djmcmath/dpv-nav/hardware/README.md

Expect this to be:

Schematics: electrical drawings of the board and components, which pins connect to which things

Housing: BOM details, drawings of how the housing and components fit together, STLs for 3D printed parts, etc.
