djmcmath/dpv-nav/tools/README.md

# DPV-Nav Tools

This directory contains offline processing tools for calibration and data analysis.

## mag_calibration.py

Python script for computing magnetometer calibration from raw sensor samples. Supports
the two-stage baseline + mounted workflow.

### Installation

```bash
pip install numpy scipy
```

### Usage

**Baseline mode** (off-scooter, full sphere):
```bash
python mag_calibration.py --mode baseline mag_baseline_samples.csv
python mag_calibration.py --mode baseline mag_baseline_samples.csv --flat mag_flat.csv
```
Output: `mag_base.json`

**Mounted mode** (on-scooter correction, requires baseline result):
```bash
python mag_calibration.py --mode mounted --base mag_base.json mag_mounted_samples.csv
```
Output: `mag_mount.json`

Mounted mode does not fit here. It calls `dive-map/calibration-processor`'s
`callib.fit.fit_mounted()` — the one copy of the fit math — so this script and the
server cannot answer differently for the same CSV, which is the whole point of that
module's "one copy" rule. It therefore needs **dive-map/ checked out alongside
dpv-nav/**, the same sibling-checkout assumption `orient_equivalence.py` makes. If it
isn't there the script says so and stops rather than quietly fitting a different way.

That fit uses only the samples that are within 15° of level **and still** (under 8°/s,
accel within 0.03 g of 1 g), tilt-compensated. The collection procedure deliberately
gathers nose-up and nose-down rings (the device's mounted coverage grid requires them),
and fitting those as if they were level pours vertical field into the XY plane — worth
~0.9 µT per degree of tilt, which is what produced the lopsided scales seen on real
units. Samples taken in motion do the same thing on a smaller scale: a push reads as
tilt.

There is no fallback. A collection without at least 30 still, level samples covering the
circle (no gap over 90°), or a CSV with no accel/gyro columns (pre-9-axis firmware), is
refused with the reason — the same message the server gives. Until 2026-10-11 such a
collection was fitted the old all-samples way instead, which is the known-bad fit.

### Quality Indicators

**Baseline:**
- RMS error < 2%: GOOD
- RMS error 2–5%: ACCEPTABLE
- RMS error > 5%: POOR — recollect with better spherical coverage

**Heading accuracy** (reported when `--flat` data is provided):
- Total error < 2°: EXCELLENT
- Total error 2–5°: GOOD
- Total error > 5°: POOR — recollect flat rotation data

### Complete Workflow

See [../docs/calibration-guide.md](../docs/calibration-guide.md) for the full step-by-step
procedure including what to expect at each stage and how to verify the result.

## Track assembly and correction — moved to Divemap

`correct_track.py`, `assemble_track.py` and their tests now live in the Divemap
repo, at **`dive-map/track-processor/`**.

They moved because they stopped being bench scripts and became the engine of a
Divemap service: the `track-processor` container runs exactly this code to
assemble uploaded logs into dives and correct them. A second copy here would
guarantee the two drift — and a divergence between what the website computes and
what you compute at the bench is a very hard bug to see.

Same tools, same flags. To run them against logs in this directory:

```bash
cd ../dive-map/track-processor

# Group a pile of uploaded logs into dives (handles power cycles, junk files,
# and logs that start after the unit has already left its last GPS fix)
python3 assemble_track.py ../../dpv-nav/tools/*.csv -o /tmp/dives

# Correct one. The default --mode auto works out which correction the anchor
# geometry can actually support, and tells you what it cannot know.
python3 correct_track.py /tmp/dives/dive_20260705_090952.csv

# Tests
python3 tests/test_correct.py && python3 tests/test_assemble.py
```

### Getting a dive that can actually be calibrated

An anchor in the **middle** of a dive is worth far more than fixes at both ends
of a round trip. On an out-and-back your net displacement is near zero no matter
how far you swam, so the endpoints cannot tell speed error apart from a current —
both explain the drift equally well, and the solver will happily report a
physically absurd speed factor.

Snapping a waypoint at the wreck (a `W` row) splits that useless loop into two
informative legs, which is enough to solve for speed factor, heading offset
**and** the current, exactly. `--mode auto` will say so when it happens.

## circle_audit.py — bench heading check against a reference compass

Scores a level "circle test" log (log level HIGH; stop every 10° by a reference
compass -- or any multiple of `--step`, inferred per stop, so uneven spacing and
an accidental extra stop are both fine -- through one or more circles each way,
e.g. CW, CW, CCW, CCW, optionally after a static lead-in at the first heading). Reports displayed error per bin
(samples / stops / mean / max), worst case and RMS, per-circle error and
horizontal field centre, circle-vs-circle differences (separates time effects from
direction effects), the constant / 1 / 2 / 3-cycle decomposition (displayed and
pre-Fourier), the loaded Fourier vs a refit on this data (a stale heading cal shows
up here), the |B| and level-|Bh| gates with a horizontal circle fit, held-out
scoring, field drift over a static lead-in, and -- with `--mount` -- what a
level-only mounted fit would give vs the installed mount stage. Drift is
correlated against `mag_temp_c` (the LIS3MDL's own die temperature) when the log
has it, falling back to `water_temp_c`, which lags the sensor by ~23 s; the
header line says which column it used. A static-only log
gets just the drift report. `--fourier` must be the heading cal that was installed
while the log was recorded.

```bash
python circle_audit.py "logs/high log circles.csv" \
    --fourier "../baseline cal jsons/20260911 cal files/hdg_fourier (1).json" \
    --mount   "../baseline cal jsons/20260911 cal files/mag_mount (1).json"
```

Check the stop-matching line first: it assumes the first stop is `--first-actual`
(default 000) and auto-picks where the return sweep started; override with
`--second-start` if it guessed wrong. With one circle each way, a change over
time and a direction-dependent effect look identical -- run two circles each way
to separate them.

## mag_temp_fit.py — magnetometer thermal-drift coefficients

Fits µT/°C per axis against `mag_temp_c` from stationary heat/cool logs (heat the
nav board, let it cool untouched; one log per cardinal is the consistency check,
since a body-fixed drift must give the same answer at every heading) and writes
the `/mag_temp.json` the firmware loads. Cooling leg only by default; skips any
log whose die temperature moved under 3 °C; prints per-log slopes and the range
the result is valid over.

MID logs are in the calibrated frame, so `--base`/`--mount` must be the cal that
was installed while logging -- the answer depends on it. HIGH logs carry
`mag_*_raw` and need neither, so prefer HIGH for thermal tests. `--applied` adds
back the coefficients that were active if the log was recorded with compensation
on. Needs numpy.

```bash
python mag_temp_fit.py "../baseline cal jsons/thermal testing/"{north,east,south,west1,west2}.csv \
    --base  "../baseline cal jsons/20260911 cal files/mag_base (2).json" \
    --mount "../baseline cal jsons/20260911 level-fit mount v2/mag_mount.json" \
    --out mag_temp.json
```

See [../docs/mag-temperature-compensation.md](../docs/mag-temperature-compensation.md).

## Future Tools

- **log_analyzer.py**: Parse and visualize LittleFS data logs
- **heading_plotter.py**: Real-time heading visualization from serial output
- **imu_diagnostic.py**: Sensor health check and noise analysis

## Calibration gap-fill host tests

None of these need hardware or PlatformIO -- they host-compile the
dependency-free parts of the firmware and drive them against the server's own
Python. Run them after touching `src/util/mag_cal_orient.cpp`,
`lib/dpvlink/dpvlink.cpp`, or `divemap/calibration-processor/callib/coverage.py`.
The first and third need an interpreter with the calibration-processor's
requirements installed (they import `callib.coverage`, which uses numpy).

| Script | Proves |
|---|---|
| `orient_equivalence.py` | the firmware orientation port and `coverage.py` agree sample for sample, including every degenerate branch and the poles. Also prints the axis-convention sentinel (passing `magNED` costs up to 180 deg of heading). |
| `dpvlink_test/run.sh` | `CalProgressPacket`'s 2-bits-per-cell target map round-trips index-for-index, rejects corrupt input wholesale, and fits the 512-byte link buffer. Also that `NavPacket`'s log-sync progress fields ride the wire only while `FLAG2_UPLOADING` is set, and decode to zero rather than stale values when absent. |
| `mounted_dwell_test/run.sh` | Mounted dwell capture (`src/util/mounted_dwell.h`): a cell fills only from a still unit inside its row's attitude window, with exactly 18 samples; sweeping through, moving mid-dwell, leaving the window or a repeated mag reading record nothing; both bank directions read as level; tilted rows complete at six spread cells and not at six bunched ones. |
| `logidle_test/run.sh` | the idle gate that thins LOW/MID logs: each condition alone prevents idle, any one ends it on the same sample, GPS scatter does not, and the first minute after surfacing is still logged at full rate. |
| `logrecord_test/run.sh` | packs binary MID/HIGH records with the real `log_record.h`, then checks `decode_binlog.py` reads back exactly what went in -- run it after touching either. |
| `lognames_test/run.sh` | dive-log filenames parse as `YYYYMMDD-NNN.csv` or `.bin` (one shared sequence, so a second `.bin` cannot take the first one's name), name order equals age order (including the `"001.csv" > "00000000-001.csv"` case a plain string compare gets backwards), and no wipe or mid-day delete lets a new log inherit a deleted log's name -- the property `net/log_sync.cpp` keys uploads on. |
| `gapfill_chain_check.py` | a cell the *server* flags is the cell the *device* targets -- driven end to end through bin assignment, wire packing, and decode. |
| `baseline_boot_test/run.sh` | The baseline live grid's bootstrap (`src/util/baseline_boot.h`), replayed over five real baseline uploads in `fixtures/`: lock point, re-bins, stored count, binning bias (to 0.1 uT) and every per-sample cell match dive-map's Python model (`calibration-processor/tools/baseline_bootstrap_replay.py --emit`); the cells shown agree with the server's own binning (85-90% exact, <=0.6% further than adjacent on good runs); a single-axis spin about a vertical or a horizontal axis never locks; a tumble does. Regenerate `fixtures/*.expected.csv` with `--emit` after changing the gate, the ceiling or the binning on either side. |

What they do **not** prove: that the firmware compiles, or that the axis
conventions match the physical hardware. **They structurally cannot** -- they
are synthetic, and they build their samples from the same convention the code
under test assumes, so any error both sides share is invisible to them. That is
not hypothetical: on 2026-08-26 `orient_equivalence.py` passed on all 12,247
samples while the mag vector was being consumed in a Y-mirrored frame alongside
right-handed accel, an error worth up to 180 deg of heading at any attitude off
level. Use `frame_fixture_check.py` for that half.

## Frame fixture — the only test with external ground truth

`frame_fixture_check.py` replays a capture taken from **real hardware at known
physical attitudes** and checks that the orientation math returns the attitude
that was actually held. Its ground truth is an operator and a compass, not the
code, which is the entire point.

```bash
python3 frame_fixture_check.py                 # uses fixtures/frame_fixture.csv
python3 frame_fixture_check.py other.csv other_cal.json
```

To capture (or re-capture) a fixture, run the **`axis_test`** serial command on
the nav device. It walks you through 13 attitudes, verifies each gravity-snapped
one against `classifyAccelOrientation()` rather than trusting you held it, and
prints two blocks at the end — save them as `fixtures/frame_fixture.csv` and
`fixtures/frame_fixture_cal.json`. Re-capture only when the sensors physically
move on the board or the axis maps change; a re-capture invalidates the old
fixture as ground truth for the new geometry.

Its headline number is **dip consistency**: the angle between the magnetic field
and gravity-down is a property of your location, so it must read the same at
every attitude regardless of heading, declination, or hemisphere. If mag and
accel are in frames of opposite handedness it instead swings — by 138 deg in the
2026-08-26 case — with no ground-truth heading needed to see it.

Run it after any change to `src/util/mag_cal_orient.cpp`, `callib/coverage.py`,
the `AxisMap`s in `nav_main.cpp`, or the `magNED` negation. The synthetic tests
above cannot catch what it catches, and it cannot catch what they catch.
