djmcmath/dpv-nav/hardware/schematic/gps_board/qt-py-dimensions.txt

21.8mm x 17.9mm x 5.7mm / 0.9" x 0.7" x 0.2"
