djmcmath/dpv-nav/SAFETY.md

# Safety Notice

The materials in this repository describe equipment intended for use in underwater environments. Improper construction, calibration, or use of such equipment may result in serious injury or death.

**You are solely responsible for the safety and suitability of any equipment you build or operate based on these materials.** Nothing in this repository constitutes safety certification, engineering approval, or any representation that the design is appropriate for your specific application, depth rating, or conditions.

Do not assume that designs in this repository have been tested or validated for your conditions, depth, water temperature, or build. DPV-Nav is a navigation aid. It does not replace training, dive planning, or conventional navigation skills.

These materials are provided as-is, without warranty. See the warranty and liability terms of the applicable license in [LICENSE.md](LICENSE.md).

If you find a safety-relevant issue, please report it as described in [CONTRIBUTING.md](CONTRIBUTING.md#safety).
