djmcmath/dpv-nav/hardware/schematic/gps_board/correct_serial_gpsprint.png

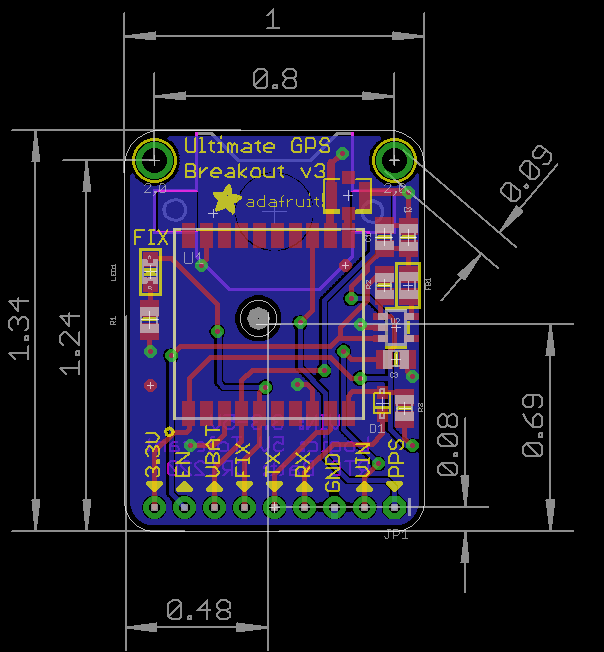
hardware/schematic/gps_board/correct_serial_gpsprint.png
