djmcmath/dpv-nav/hardware/schematic/gps_board/preview/placement.png

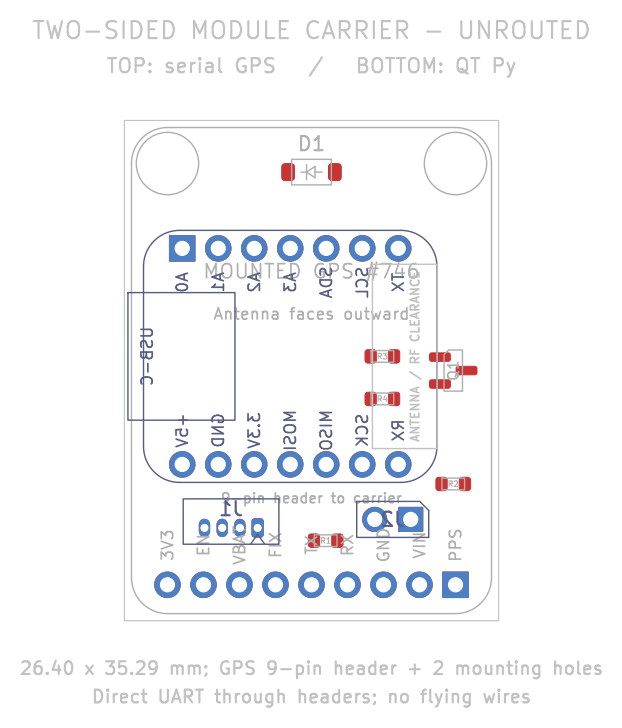
hardware/schematic/gps_board/preview/placement.png
