djmcmath/dpv-nav/hardware/schematic/gps_board/preview/schematic.png

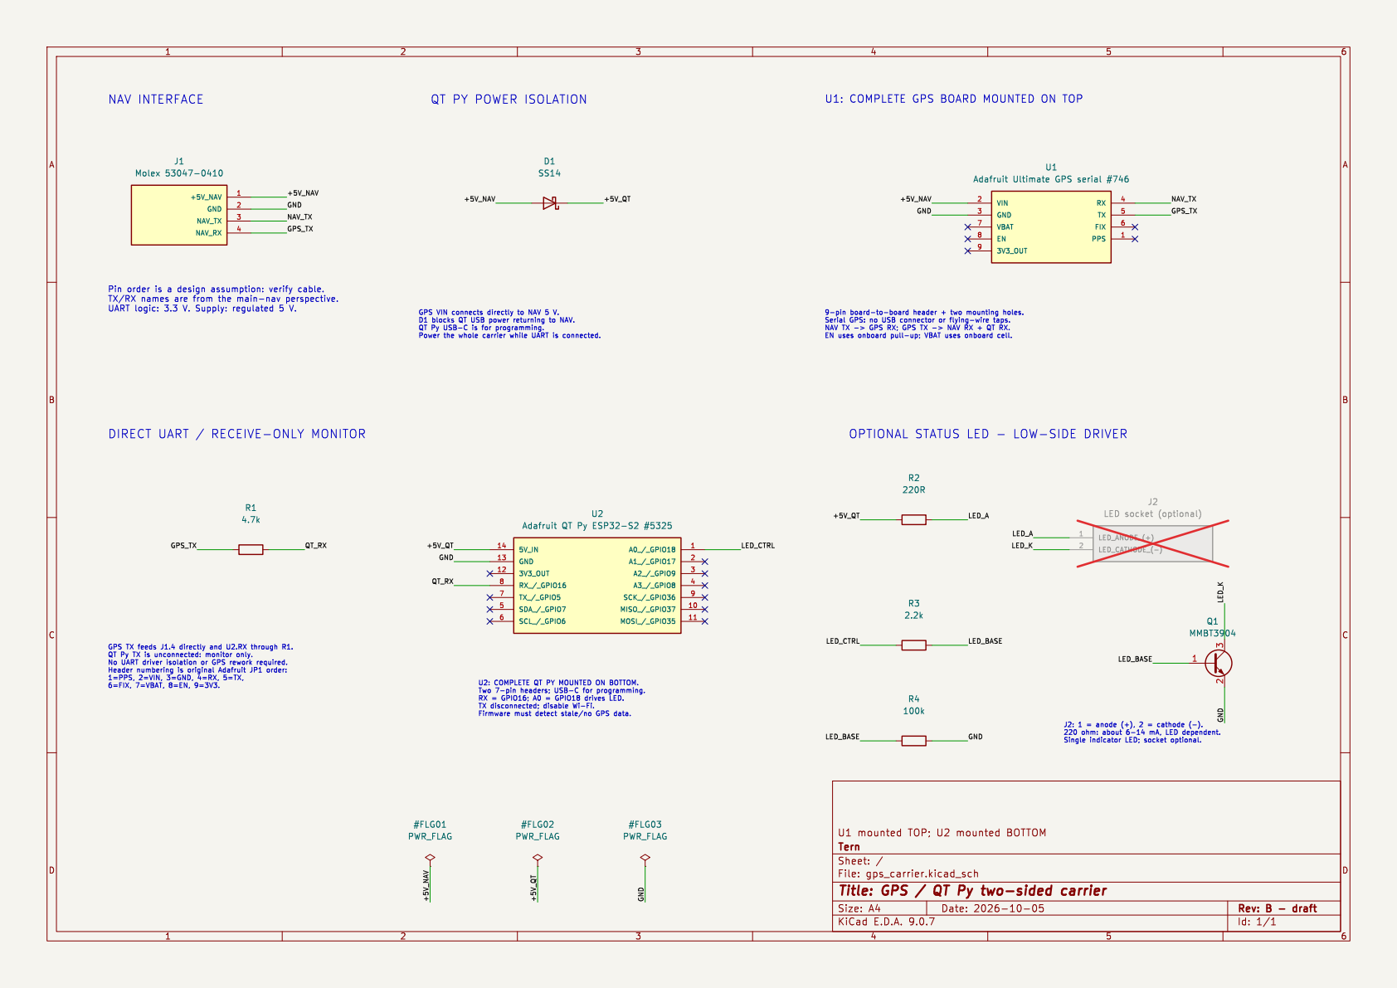
hardware/schematic/gps_board/preview/schematic.png
