djmcmath/dpv-nav/tools/cal_screen_mock/png/after-quit.png

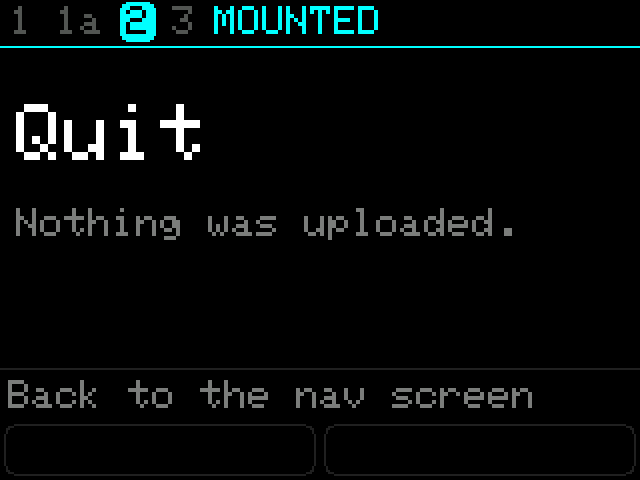
tools/cal_screen_mock/png/after-quit.png
