djmcmath/dpv-nav/tools/cal_screen_mock/png/after-reject.png

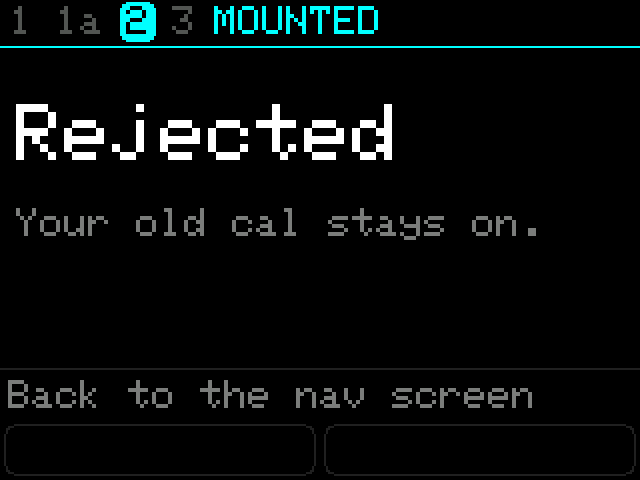
tools/cal_screen_mock/png/after-reject.png
