djmcmath/dpv-nav/tools/cal_screen_mock/png/bars.png

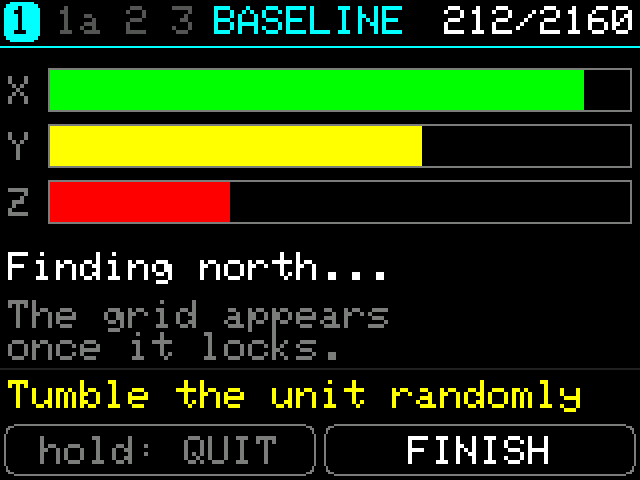
tools/cal_screen_mock/png/bars.png
