djmcmath/dpv-nav/tools/cal_screen_mock/png/baseGrid.png

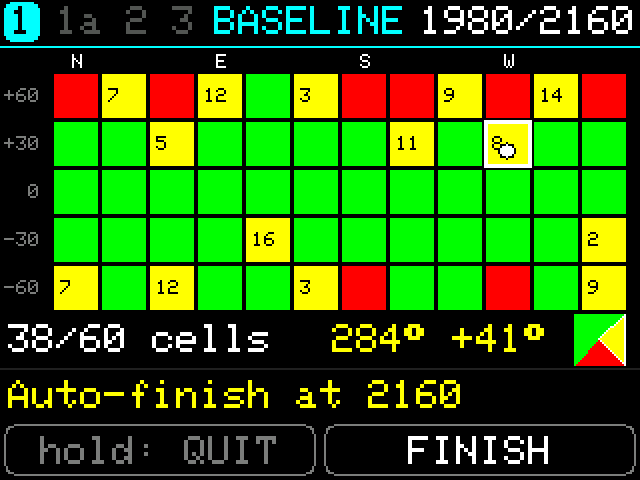
tools/cal_screen_mock/png/baseGrid.png
