djmcmath/dpv-nav/tools/cal_screen_mock/png/cantStart.png

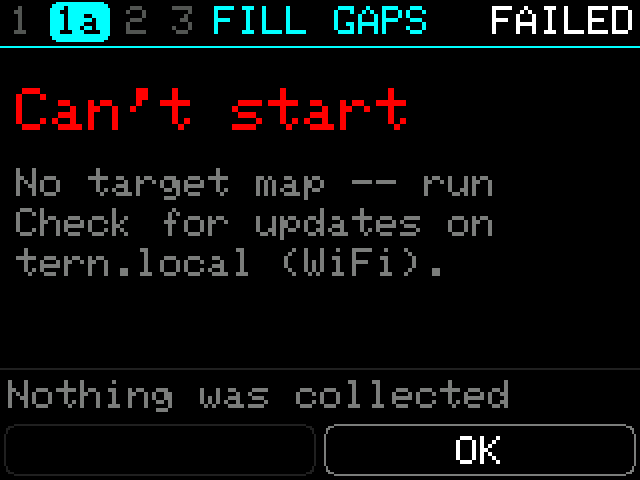
tools/cal_screen_mock/png/cantStart.png
