djmcmath/dpv-nav/tools/cal_screen_mock/png/failed.png

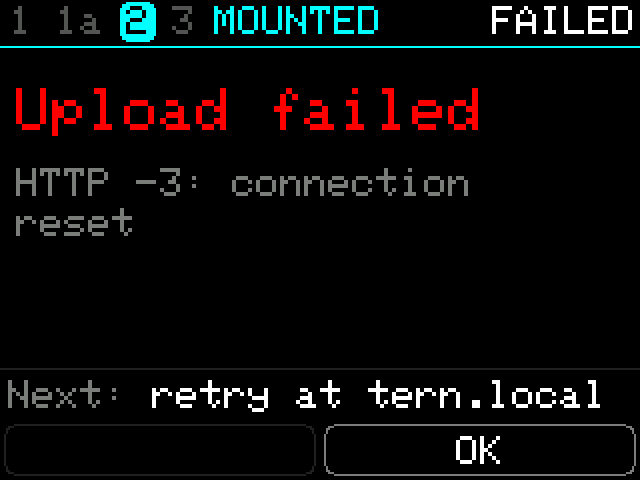
tools/cal_screen_mock/png/failed.png
