djmcmath/dpv-nav/tools/cal_screen_mock/png/gapGrid.png

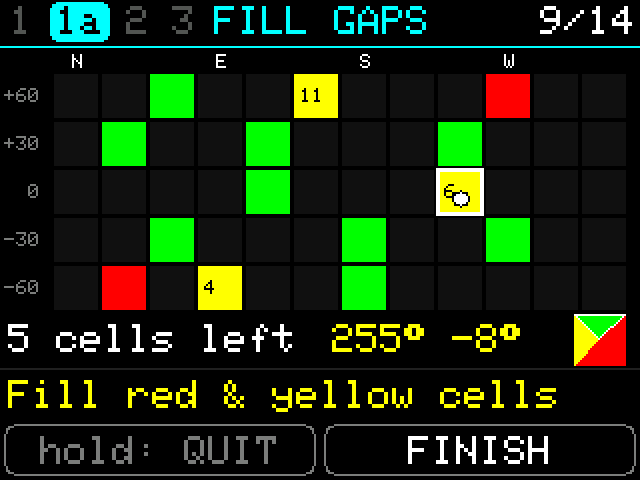
tools/cal_screen_mock/png/gapGrid.png
