djmcmath/dpv-nav/tools/cal_screen_mock/png/gapSent.png

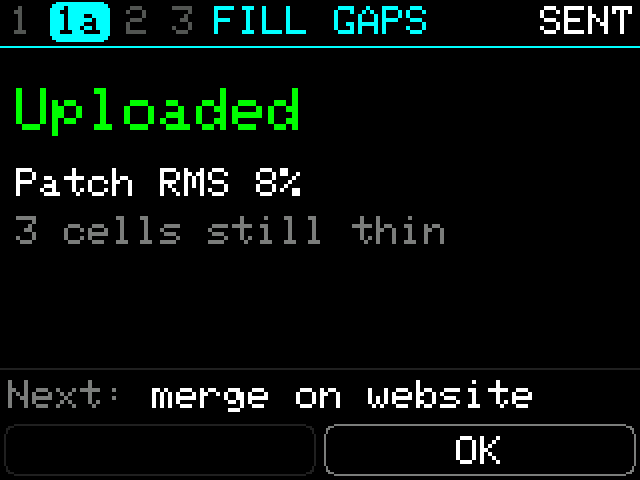
tools/cal_screen_mock/png/gapSent.png
