djmcmath/dpv-nav/tools/cal_screen_mock/png/hdgNotLevel.png

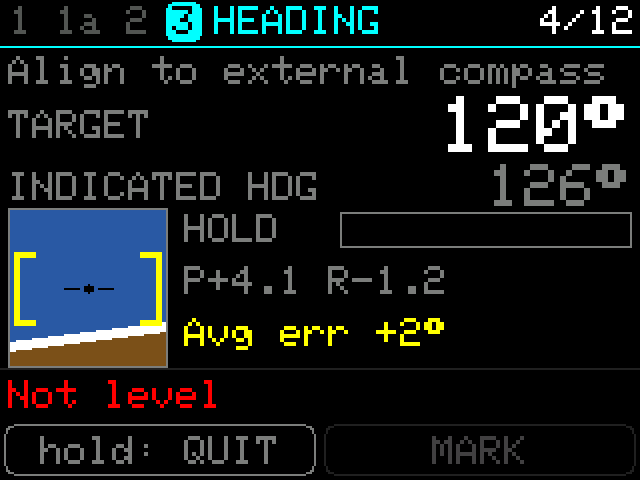
tools/cal_screen_mock/png/hdgNotLevel.png
