djmcmath/dpv-nav/tools/cal_screen_mock/png/hdgReady.png

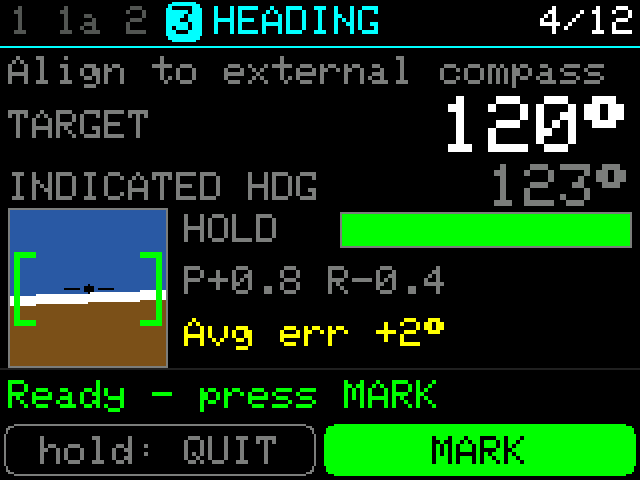
tools/cal_screen_mock/png/hdgReady.png
