djmcmath/dpv-nav/tools/cal_screen_mock/png/marked.png

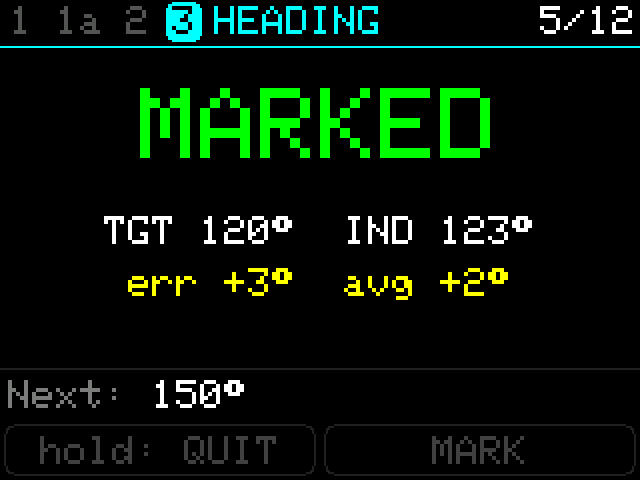
tools/cal_screen_mock/png/marked.png
