djmcmath/dpv-nav/tools/cal_screen_mock/png/mounted.png

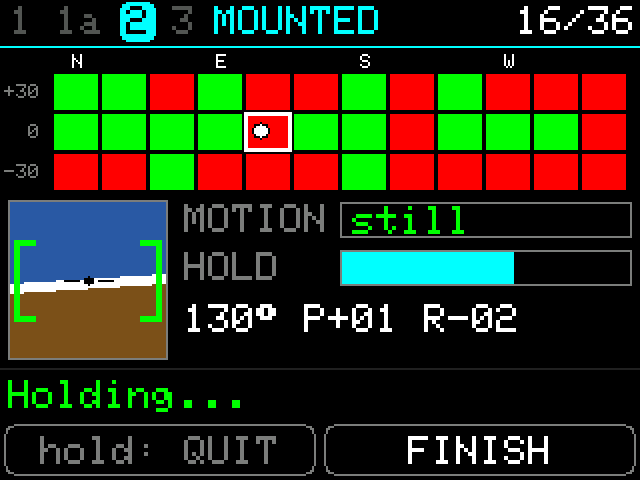
tools/cal_screen_mock/png/mounted.png
