djmcmath/dpv-nav/tools/cal_screen_mock/png/mountedOut.png

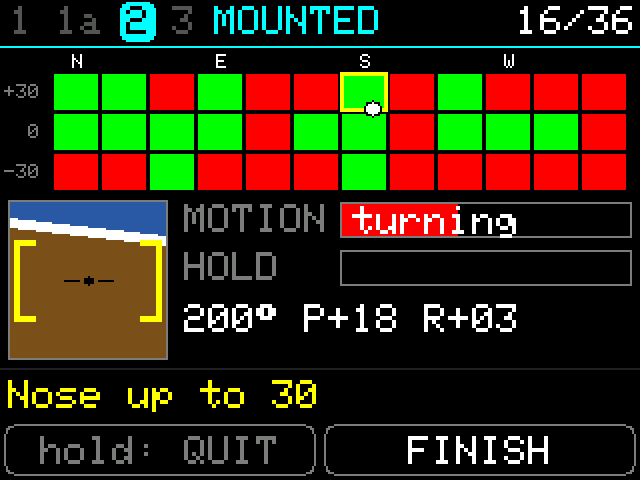
tools/cal_screen_mock/png/mountedOut.png
