djmcmath/dpv-nav/tools/cal_screen_mock/png/offline.png

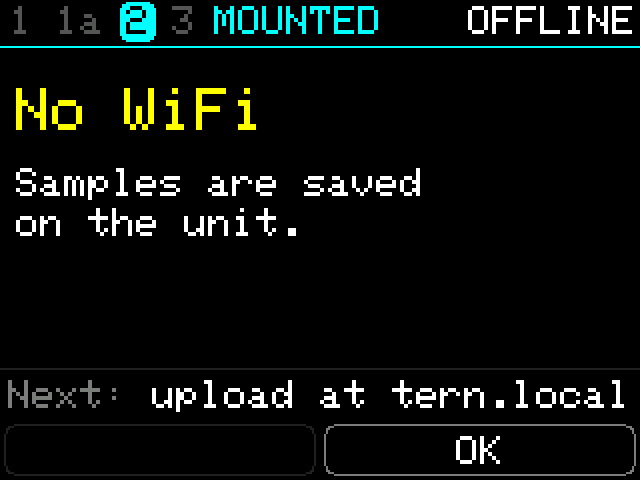
tools/cal_screen_mock/png/offline.png
