djmcmath/dpv-nav/tools/cal_screen_mock/png/resBase.png

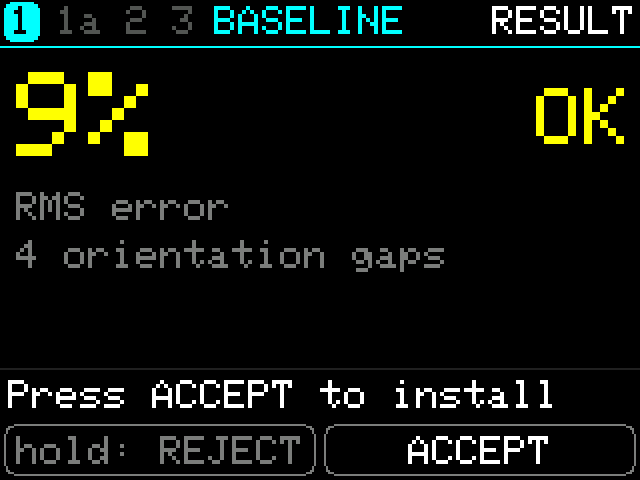
tools/cal_screen_mock/png/resBase.png
