djmcmath/dpv-nav/tools/cal_screen_mock/png/resHdg.png

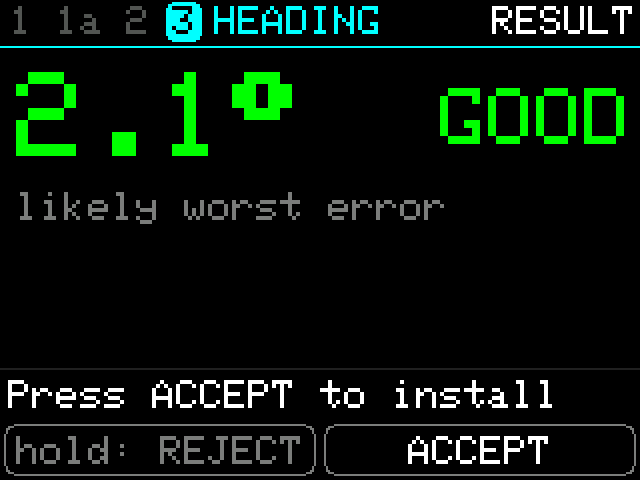
tools/cal_screen_mock/png/resHdg.png
