djmcmath/dpv-nav/tools/cal_screen_mock/png/resMount.png

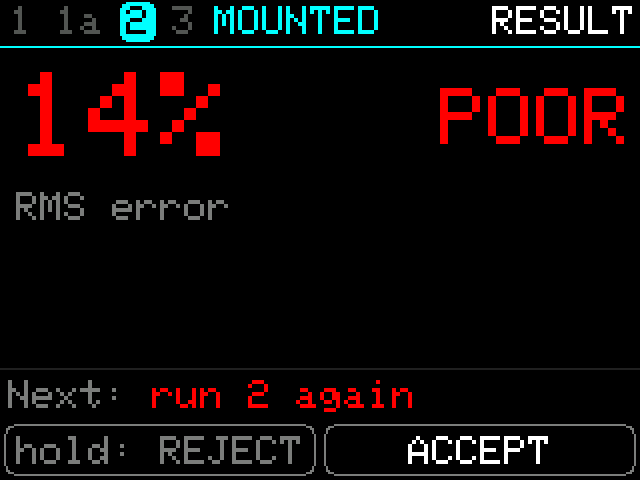
tools/cal_screen_mock/png/resMount.png
