djmcmath/dpv-nav/tools/cal_screen_mock/png/saving.png

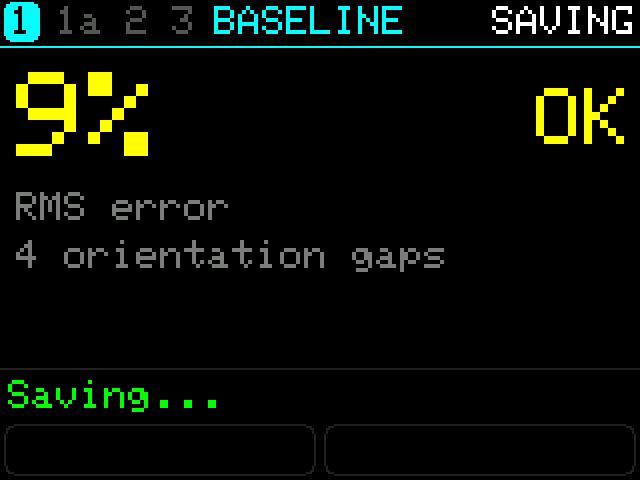
tools/cal_screen_mock/png/saving.png
