djmcmath/dpv-nav/tools/cal_screen_mock/png/upload.png

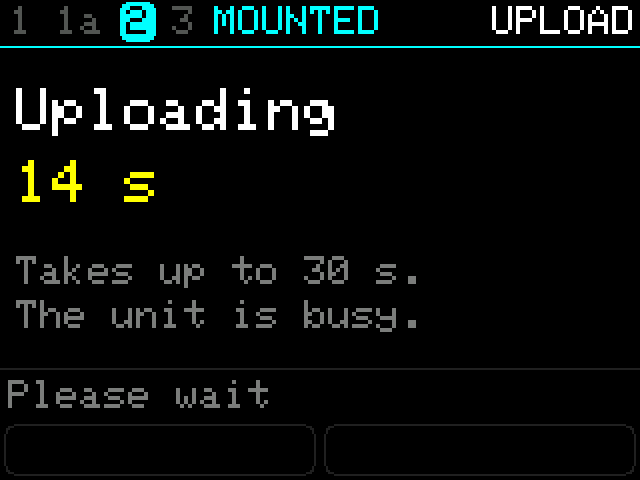
tools/cal_screen_mock/png/upload.png
