djmcmath/dpv-nav/tools/hdg_fourier_fit.png

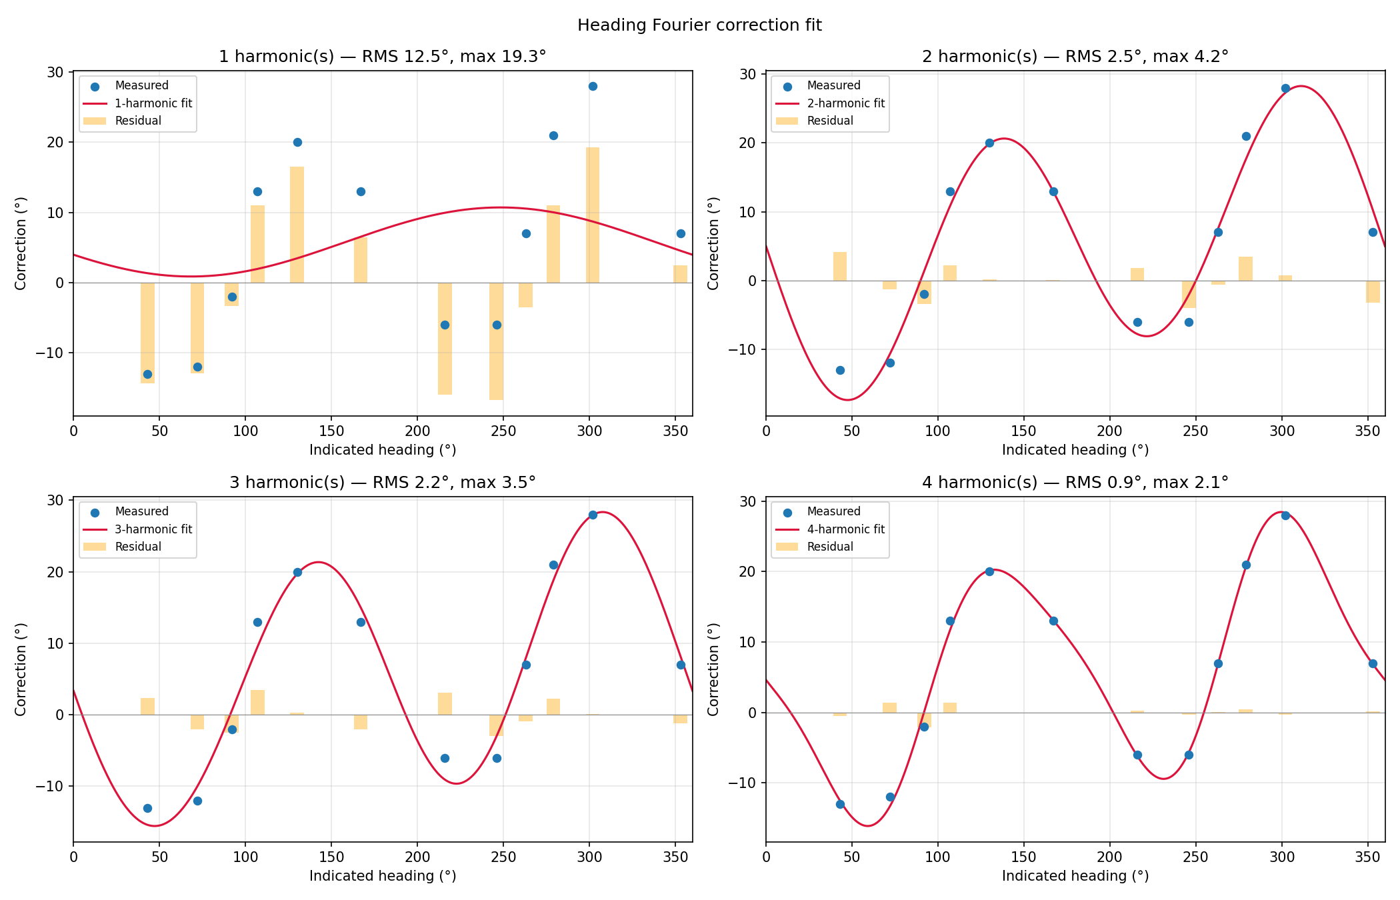
tools/hdg_fourier_fit.png
