djmcmath/dpv-nav/hardware/Tern DPV-Nav BOM.ods

Parts I think I’ll need to order for the next build
 | Module | Parts | Link | Quantity | Cost | Total Cost
 | Navigation
x |  | ESP32 | https://www.adafruit.com/product/5900 | 1 | 20.95 | 20.95 | Current version of board calls for Huzzah32 v1 (https://www.adafruit.com/product/3591). Next version re-arranges for v2 (more memory, some re-arrangement of pins, USB-C port)
x |  | Polulu AltIMU 10 v6 | https://www.pololu.com/product/2863 | 1 | 36.95 | 36.95
 |  | 3-pin picoblade header (flow) | https://www.digikey.com/en/products/detail/molex/0530470310/242854 | 1 | 0.26 | 0.26
 |  | 4-pin picoblade header (display) | https://www.digikey.com/en/products/detail/molex/0530470410/242855 | 1 | 0.26 | 0.26
 |  | 4-pin JST GH 1.25 header (depth) | https://www.digikey.com/en/products/detail/jst-sales-america-inc/BM04B-GHS-TBT/807802 | 1 | 0.38 | 0.38 | Manf Part No: BM04B-GHS-TBT
 |  | 4-pin picoblade header (GPS) | https://www.digikey.com/en/products/detail/molex/0530470410/242855 | 1 | 0.26 | 0.26
 |  | 2in BlueRobotics housing (acrylic, 2x end caps, etc) | https://bluerobotics.com/store/watertight-enclosures/wte-vp/ | 1 | 161 | 161 | 2in acrylic housing (6in length), acrylic end caps. (The 4in tube is $4 cheaper, and would probably fit.)
 |  | 3D printed mounts (internal board support, tube mounts)
 |  | Hose clamps (mounts to tube: 9in diam, nav tube to mounts: 3in diam)
 |  | 3.7V Battery with JST-PH 2.0 connector | https://www.amazon.com/dp/B0DYHDVGS4 | 1 | 12.29 | 12.29 | Nav board now takes an XT30 battery input: replace the JST-PH plug with the XT30 male pigtail below. Battery polarity is probably reversed from the JST convention; verify with a meter before soldering.
 |  | XT30 male / female pair | https://www.mouser.com/en/ProductDetail/DFRobot/FIT0586?qs=w%2Fv1CP2dgqouWR8IxqIK1w%3D%3D | 1 | 1.9 | 1.9 | Mouser # 426-FIT0586
 |  | Power switch (TBD) |  | 1 |  | 0 | Placeholder. Wires to the 3-pin J7 header on the nav board; mounts through the aft end cap.
x |  | BlueRobotics pressure relief valve | https://bluerobotics.com/store/watertight-enclosures/wte-vp/ | 0 | 32 | 0 | Included on the same order page with the housing
 |  | PCB
x |  | Depth sensor | https://bluerobotics.com/store/sensors-cameras/sensors/bar-depth-pressure-sensor/ | 1 | 90 | 90 | Technically optional; adds depth data to track, enables auto "dive mode."
 | Display
 |  | Display | https://www.adafruit.com/product/4311 | 1 | 19.95 | 19.95
 |  | EyeSPI cable | https://www.adafruit.com/product/5239 | 1 | 0.75 | 0.75 | 50mm is sufficient length
 |  | PCB
x |  | ESP32 | https://www.adafruit.com/product/5900 | 1 | 20.95 | 20.95 | Current version of board calls for Huzzah32 v1 (https://www.adafruit.com/product/3591)
 |  | 2x resistors (10 kOhm) | https://www.amazon.com/dp/B0B4JFPHTW | 2 | 4.95 | 9.9 | (The Amazon pack will be 20 resistors for $5.)
 |  | 2x 2-pin picoblade connectors | https://www.digikey.com/en/products/detail/molex/0530470210/242853 | 2 | 0.18 | 0.36
 |  | 2x 2-pin picoblade wires | https://www.adafruit.com/product/3922 | 2 | 0.95 | 1.9
 |  | 2x buttons | https://www.digikey.com/en/products/detail/adafruit-industries-llc/367/10669771 | 2 | 2.5 | 5 | (20 pack; similar to what you'd get on Amazon)
 |  | 3D printed housing frame
 |  | GoPro mounting sticky plate
 |  | EyeSPI display breakout board | https://www.adafruit.com/product/5613 | 1 | 1.95 | 1.95
 |  | 4-pin picoblade header with wires | https://www.adafruit.com/product/4722 | 1 | 0.95 | 0.95
 |  | 4-pin picoblade PCB connector (female) | https://www.digikey.com/en/products/detail/molex/0530470410/242855 | 1 | 0.26 | 0.26
x |  | 2x BlueRobotics Gland M6 - 4.5 | https://bluerobotics.com/store/cables-connectors/penetrators/wlp-vp/?attribute_package-quantity=1-Pack | 2 | 13 | 26
 |  | GoPro housing | https://www.bluewaterphotostore.com/gopro-dive-housing-for-hero9-hero10-hero11-hero12-hero13-black/ | 1 | 54.99 | 54.99 | The off-brand $20 version is **probably** close enough.
 |  | 9in BlueRobotics Cable | https://bluerobotics.com/store/cables-connectors/pur-subsea-cable/ | 1 | 6 | 6 | Only really need ~1m of 4-conductor cable
 | GPS |  |  |  |  |  | Note: Current GPS build is "good enough" with only 4 wires. 6 wires allows "disable" when submerged for power savings, which enables a smaller battery.
 |  | GoPro housing | https://www.bluewaterphotostore.com/gopro-dive-housing-for-hero9-hero10-hero11-hero12-hero13-black/ | 1 | 54.99 | 54.99 | The off-brand $20 version is **probably** close enough.
x |  | GPS module | https://www.adafruit.com/product/5440 | 1 | 29.95 | 29.95
x |  | 2x BlueRobotics glands M10 - 7.5 | https://bluerobotics.com/store/cables-connectors/penetrators/wlp-vp/?attribute_package-quantity=1-Pack | 2 | 13 | 26
 |  | BlueRobotics cable (6 wire) | https://bluerobotics.com/store/cables-connectors/pur-subsea-cable/ | 2 | 13 | 26 | You'll need enough to reach from the navigation module to the nose of the DPV; 1m may be enough for you.
 |  | Battery (CR1220 for RTC) | https://www.adafruit.com/product/380 | 1 | 0.95 | 0.95 | (Or from Amazon: ...)
 |  | 6-pin picoblade (male, wire) | https://www.adafruit.com/product/4986 | 1 | 0.95 | 0.95
 | Flow
x |  | Flow meter 3/4in threaded, hall effect, 60L/min | https://www.amazon.com/dp/B07MY6LFPH | 1 | 11.3 | 11.3
 |  | 3D printed potting box
 |  | PVC pipe segments | Home Depot |  |  | 20 | 2x threaded to insert adapters, 12in of 3/4in PVC
 |  | BlueRobotics wire (3 conductors) | https://bluerobotics.com/store/cables-connectors/pur-subsea-cable/ | 1 | 6 | 6 | Simplest to order 1m total of 4-conductor, use for both flow and display
x |  | 2x BlueRobotics Gland M6 - 4.5 | https://bluerobotics.com/store/cables-connectors/penetrators/wlp-vp/?attribute_package-quantity=1-Pack | 2 | 13 | 26
 |  | 3-pin Picoblade | https://www.adafruit.com/product/4721 | 1 | 0.95 | 0.95
 |  | 3D printed mounts
 | Standards:
 | -- Board has female connector; cable has male connector
 | -- Wire lengths such that end cap can be removed and cable disconnected to allow full removal of end cap
 |  | Shipping: | Adafruit |  |  | 15
 |  |  | BlueRobotics |  |  | 20
 |  |  | Digikey |  |  | 15
 |  |  | Pololu |  |  | 15
 |  |  |  | Total Pre-Tax Cost |  | 741.3
 |  |  |  | Tax (9.5%, WA / Kitsap) |  | 70.4235
 |  |  |  | Total |  | 811.7235
 |  | Depth sensor options | https://www.dfrobot.com/product-1675.html | $16 | 3 wire analog, would need to read 0-5VDC signal
 |  |  | https://www.mouser.com/en/ProductDetail/TE-Connectivity-Measurement-Specialties/MS583730BA01-50 | $16 | solder to board, pot the whole thing, mount it outside, or in side of housing.
 |  |  | https://www.amazon.com/Teyleten-Robot-GY-MS5837-02BA-Precision-Waterproof/dp/B0FMY6JN8C/ref=sr_1_1 | $13 | with breakout board -- just need to pot it into a housing
