djmcmath/dpv-nav/hardware/3D Printed Parts/Flow Meter/Other Flow Meter Potting Housing.STL

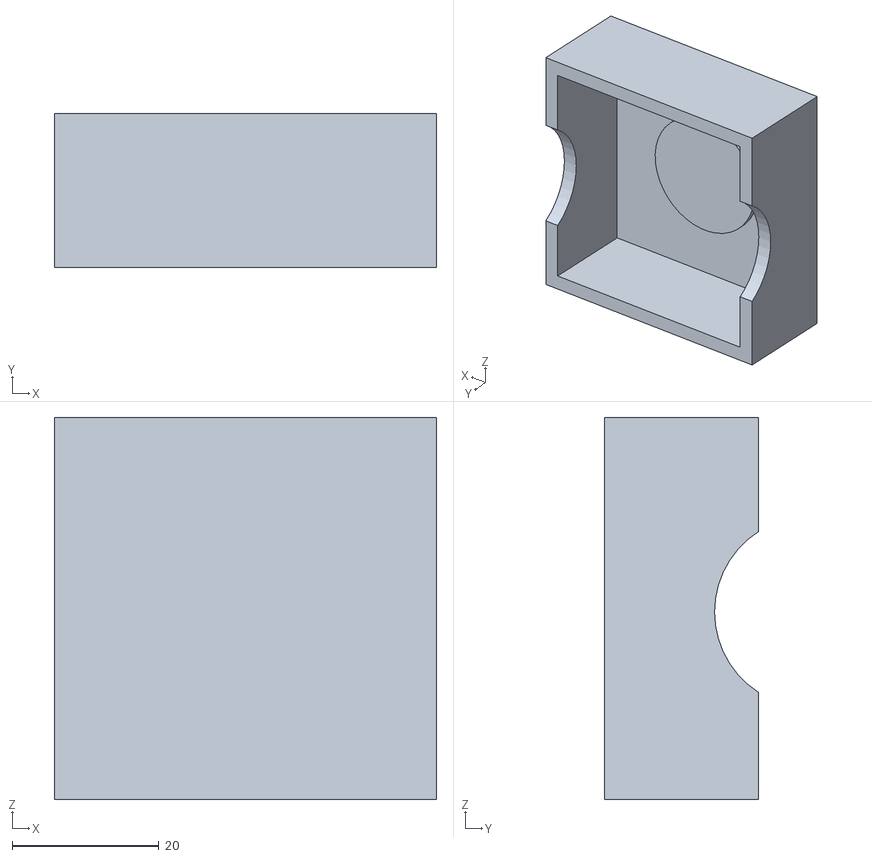
[picture p25: CAD file, 2026-09-09]
hardware/3D Printed Parts/Flow Meter/Other Flow Meter Potting Housing.STL
52.0 x 21.0 x 52.0
