djmcmath/dpv-nav/hardware/3D Printed Parts/GoPro Display Housing/GoPro Insert Display Mount.STL

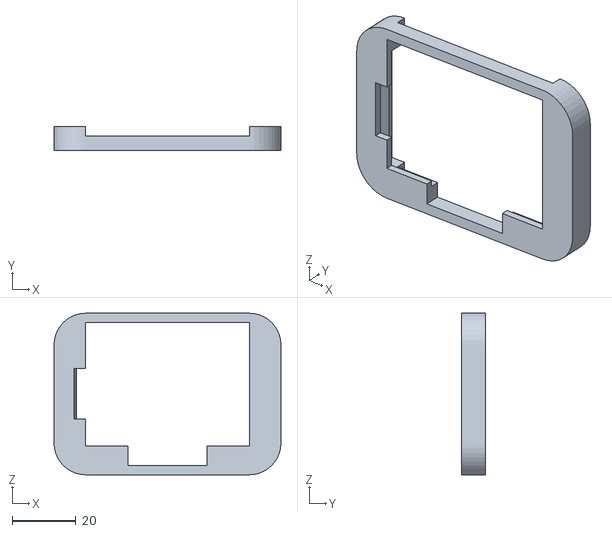
[picture p26: CAD file, 2026-09-09]
hardware/3D Printed Parts/GoPro Display Housing/GoPro Insert Display Mount.STL
71.5 x 7.50 x 50.9
