djmcmath/dpv-nav/hardware/3D Printed Parts/Milled Display Housing/Display Housing.STL

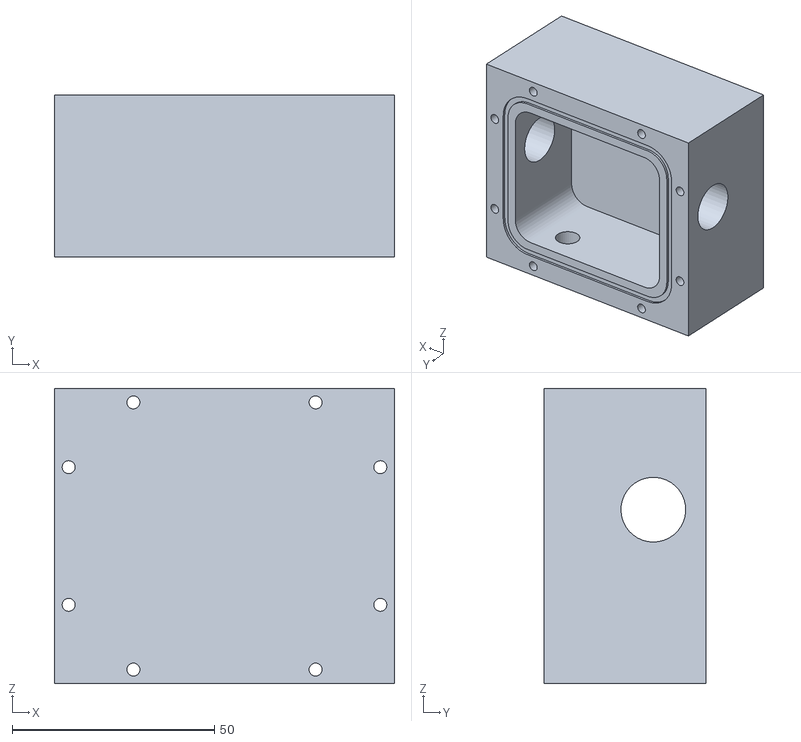
[picture p27: CAD file, 2026-09-09]
hardware/3D Printed Parts/Milled Display Housing/Display Housing.STL
84.0 x 40.0 x 73.0
