djmcmath/dpv-nav/hardware/3D Printed Parts/Nav Module/Tube Mount Aligning Frame Part A.STL

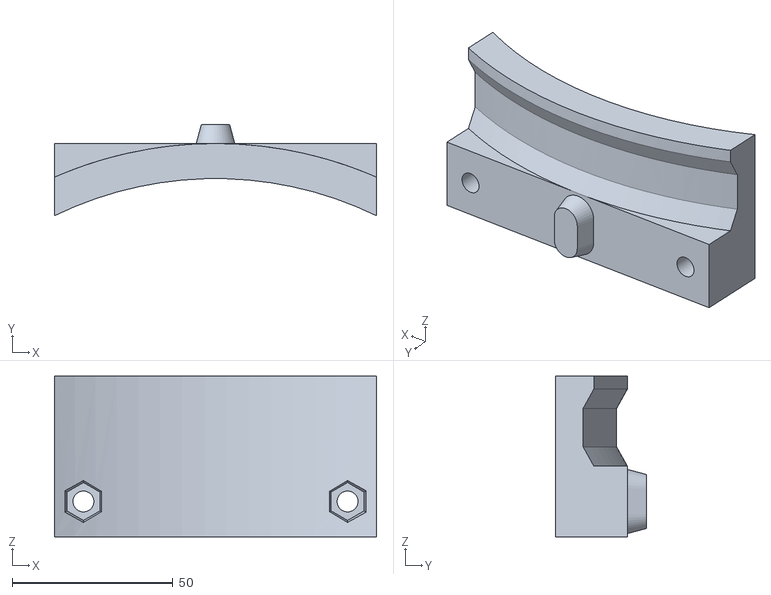
[picture p28: CAD file, 2026-09-09]
hardware/3D Printed Parts/Nav Module/Tube Mount Aligning Frame Part A.STL
100.2 x 28.5 x 50.0
