djmcmath/dpv-nav/hardware/3D Printed Parts/Flow Meter/Flow Meter Tube Mount.STL

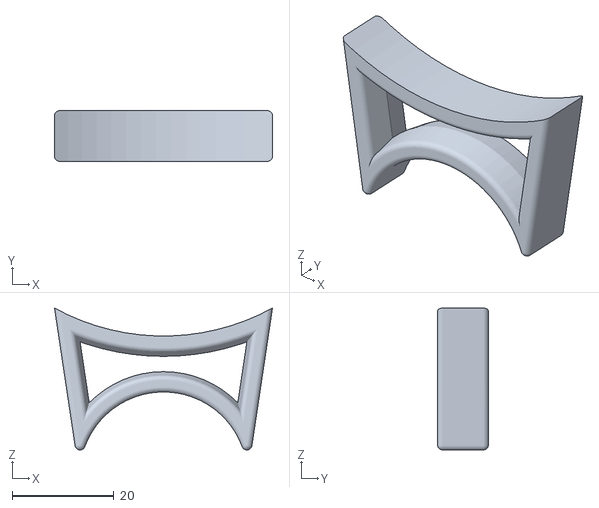
[picture p29: CAD file, 2026-09-09]
hardware/3D Printed Parts/Flow Meter/Flow Meter Tube Mount.STL
42.9 x 10.00 x 27.9
