djmcmath/dpv-nav/hardware/3D Printed Parts/GoPro Display Housing/GoPro Insert.STL

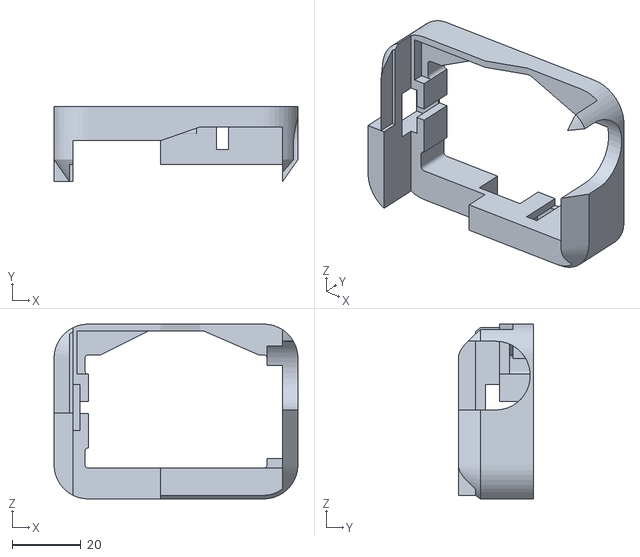
[picture p30: CAD file, 2026-09-09]
hardware/3D Printed Parts/GoPro Display Housing/GoPro Insert.STL
71.0 x 21.9 x 50.9
