djmcmath/dpv-nav/hardware/3D Printed Parts/Nav Module/2in tube board holder Rev A.STL

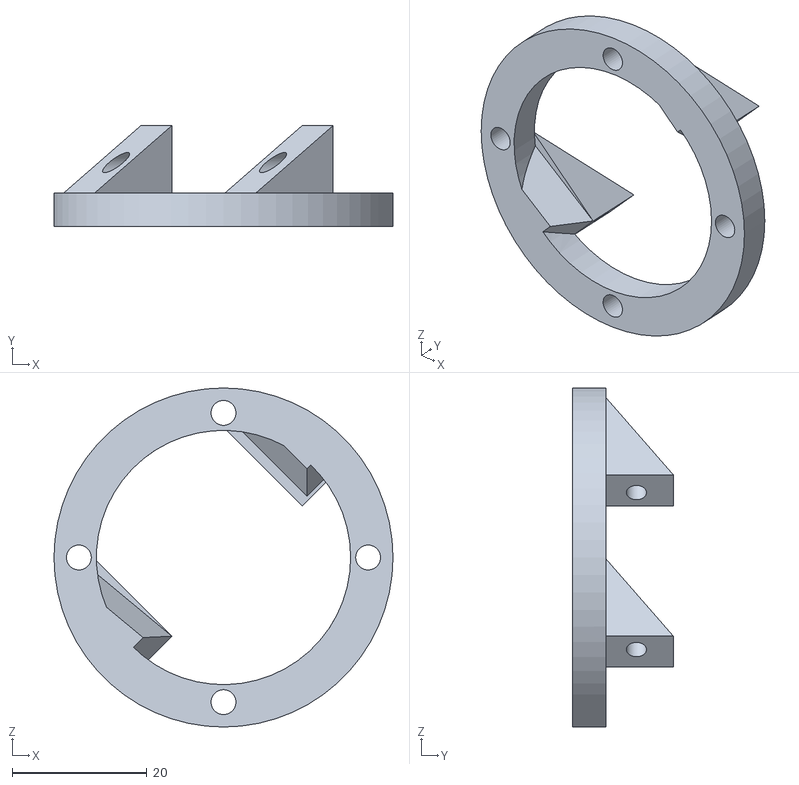
[picture p31: CAD file, 2026-09-09]
hardware/3D Printed Parts/Nav Module/2in tube board holder Rev A.STL
50.4 x 15.0 x 50.4
