djmcmath/dpv-nav/hardware/3D Printed Parts/GoPro Display Housing/ButtonCap.STL

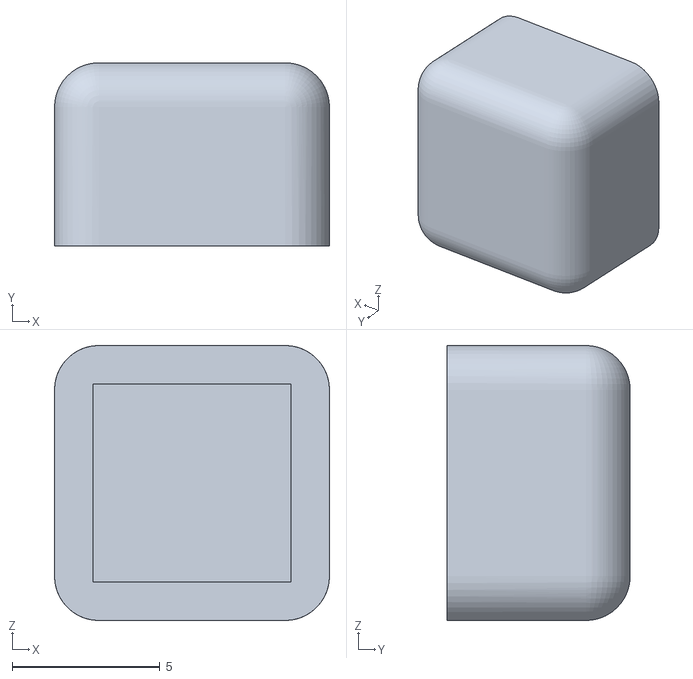
[picture p32: CAD file, 2026-09-09]
hardware/3D Printed Parts/GoPro Display Housing/ButtonCap.STL
9.30 x 6.20 x 9.30
