djmcmath/dpv-nav/hardware/3D Printed Parts/Nav Module/Tube Mount Aligning Frame Part B - 2in Nav Tube.STL

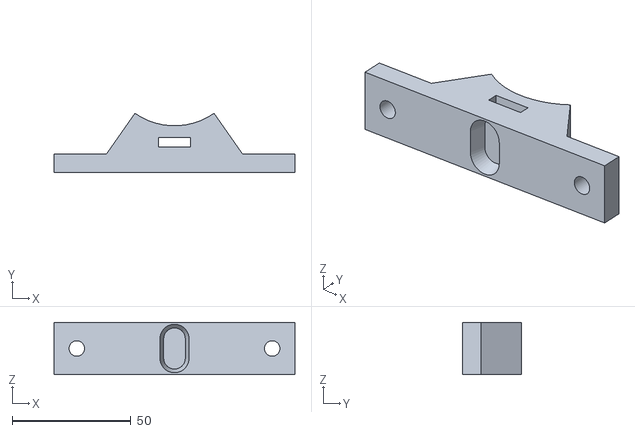
[picture p33: CAD file, 2026-09-09]
hardware/3D Printed Parts/Nav Module/Tube Mount Aligning Frame Part B - 2in Nav Tube.STL
101.4 x 25.0 x 22.0
