djmcmath/dpv-nav/hardware/3D Printed Parts/GoPro Display Housing/GoPro Lens Pocket Filler.STL

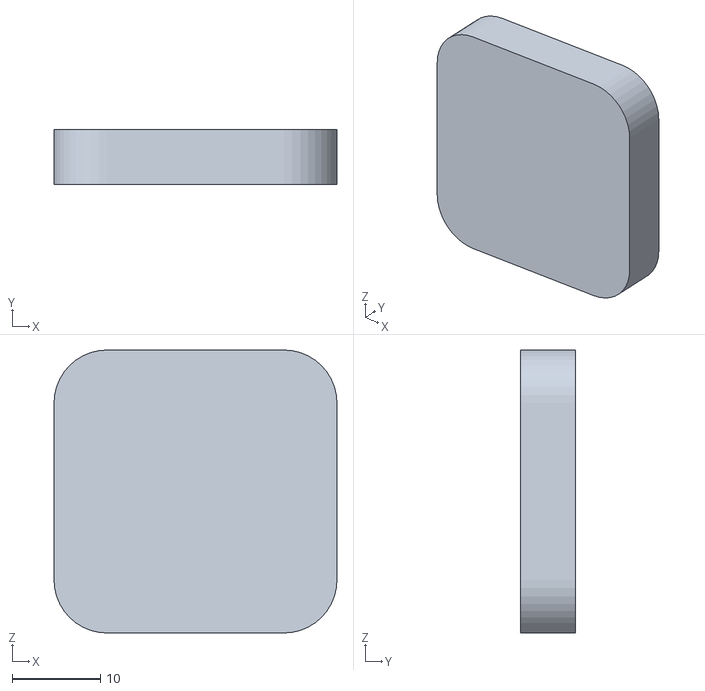
[picture p34: CAD file, 2026-09-09]
hardware/3D Printed Parts/GoPro Display Housing/GoPro Lens Pocket Filler.STL
32.0 x 6.20 x 32.0
