djmcmath/dpv-nav/hardware/3D Printed Parts/GoPro Display Housing/GoPro Button Sleeve.STL

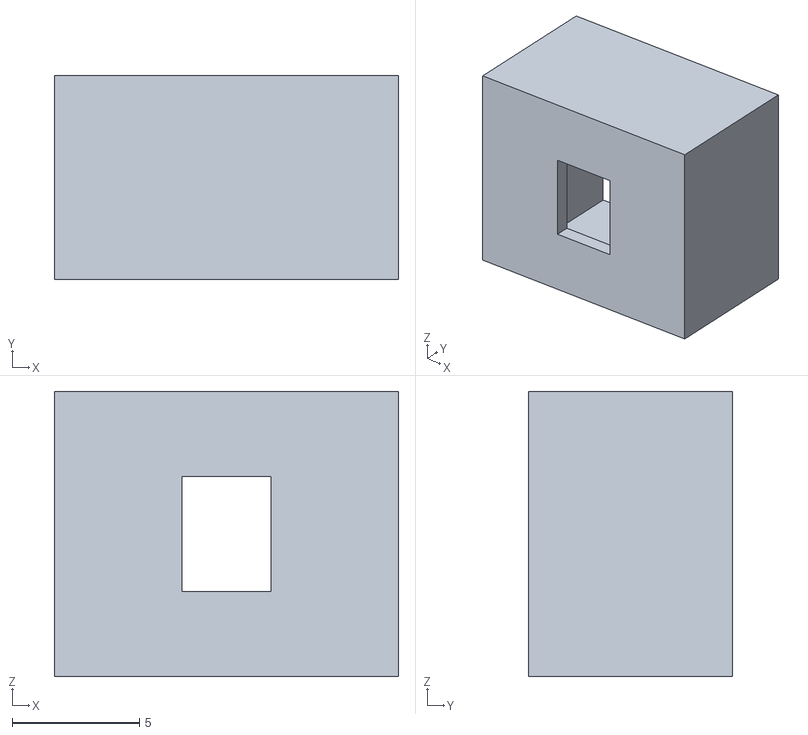
[picture p35: CAD file, 2026-09-09]
hardware/3D Printed Parts/GoPro Display Housing/GoPro Button Sleeve.STL
13.5 x 8.00 x 11.2
