djmcmath/dpv-nav/hardware/schematic/gps_board/adafruit_products_QTESP_pinouts_guide.jpg

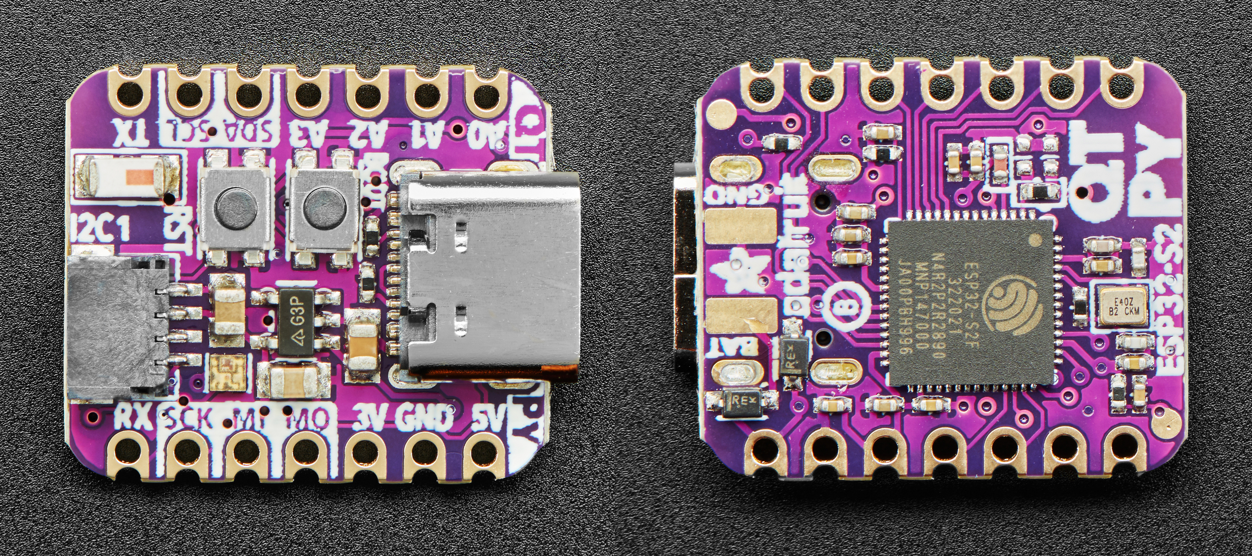
hardware/schematic/gps_board/adafruit_products_QTESP_pinouts_guide.jpg
