djmcmath/dpv-nav/hardware/schematic/gps_board/adafruit_products_UltimateGPS_USBC_fab_print.png

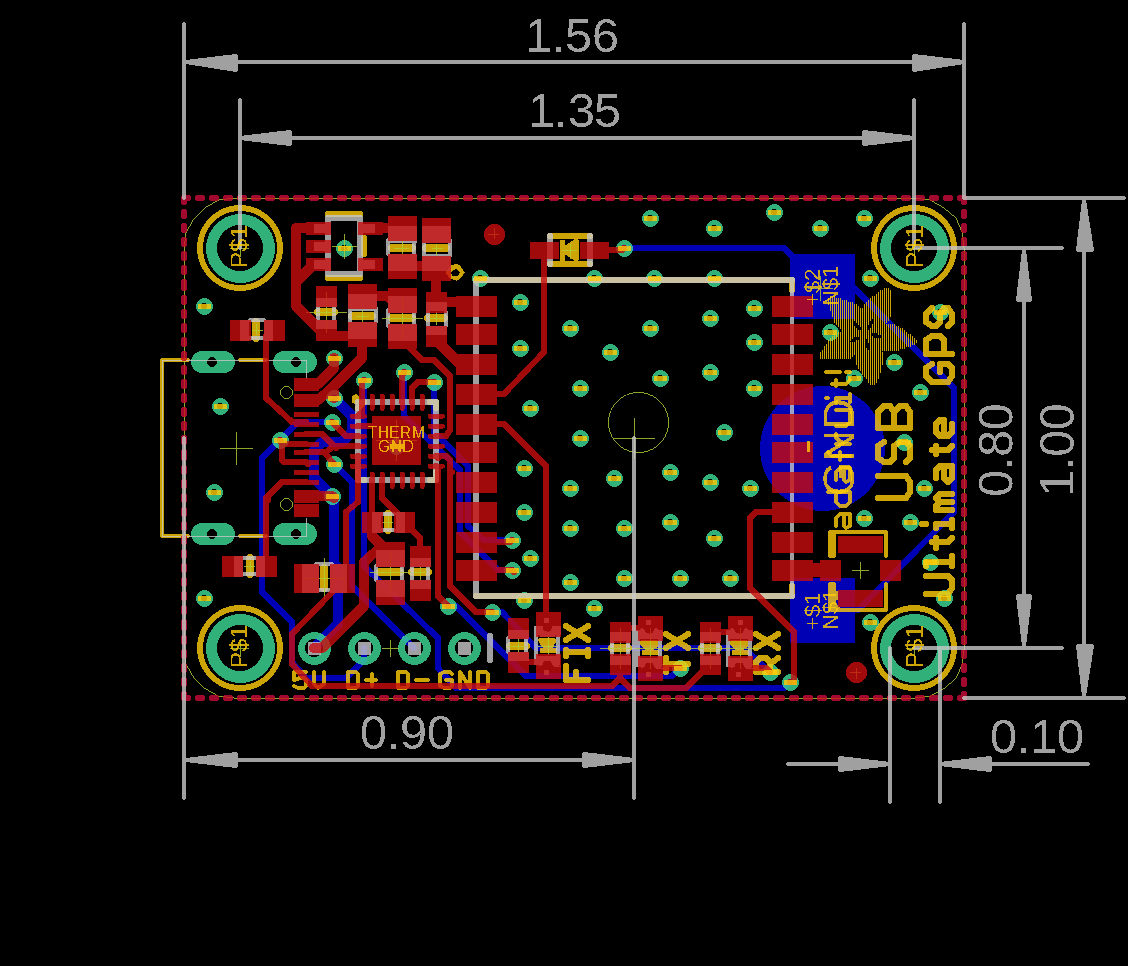
hardware/schematic/gps_board/adafruit_products_UltimateGPS_USBC_fab_print.png
