djmcmath/dpv-nav/hardware/schematic/gps_board/preview/assembly.png

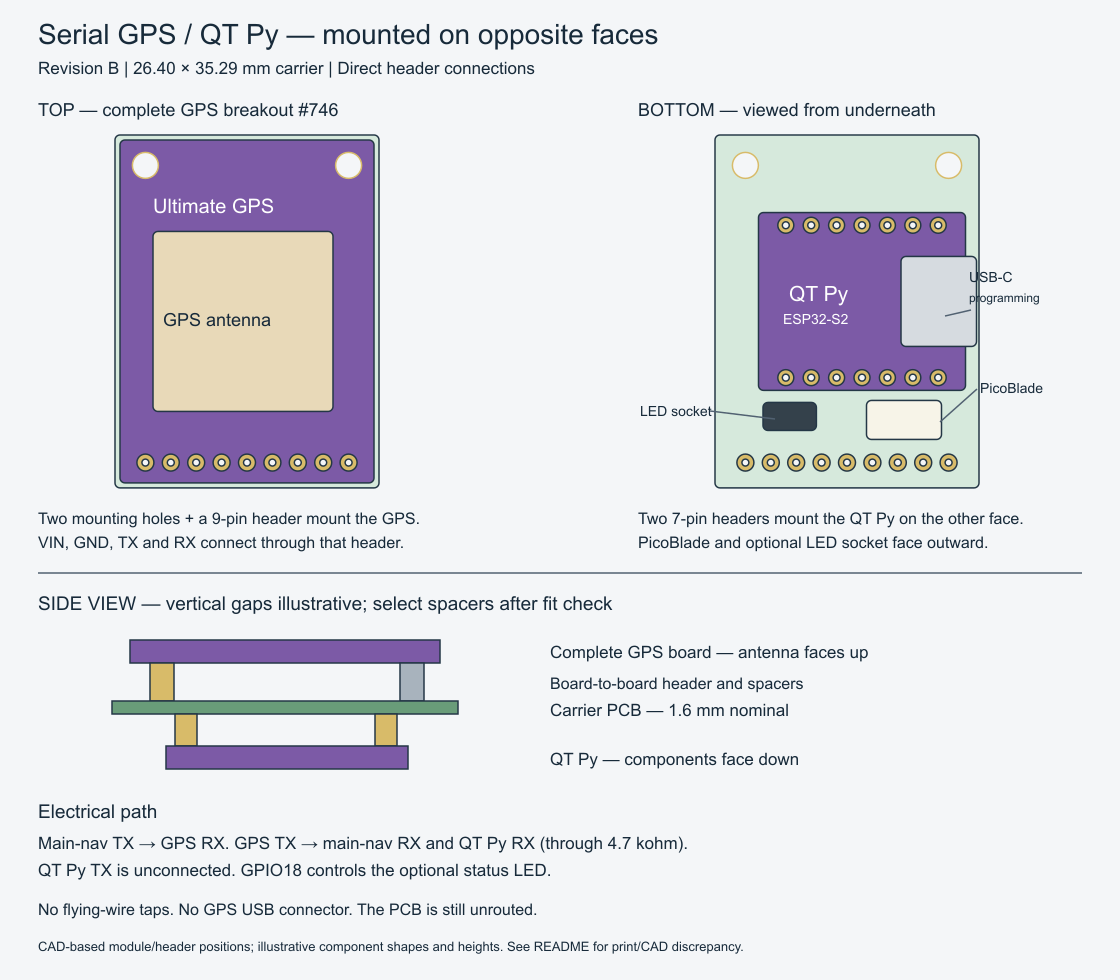
hardware/schematic/gps_board/preview/assembly.png
