djmcmath/dpv-nav/tools/cal_screen_mock/png/installedBase.png

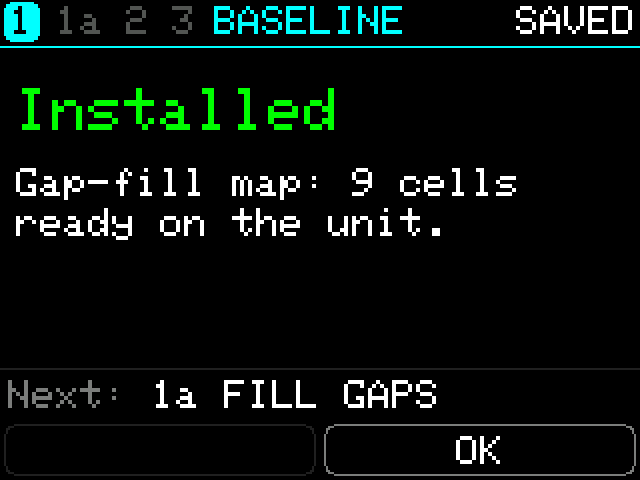
tools/cal_screen_mock/png/installedBase.png
