djmcmath/dpv-nav/tools/cal_screen_mock/png/installedHdg.png

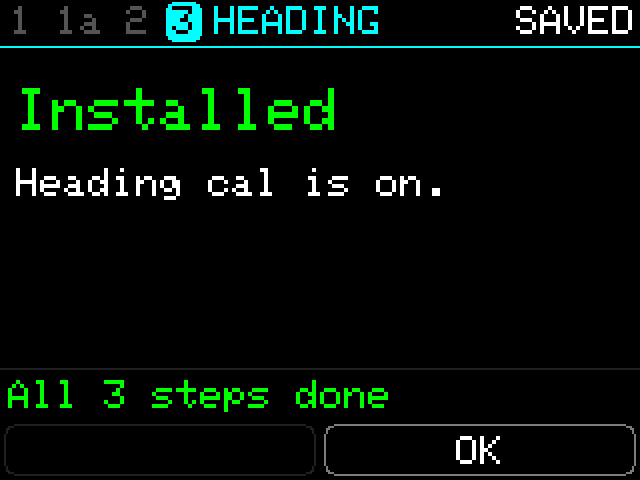
tools/cal_screen_mock/png/installedHdg.png
