djmcmath/dpv-nav/tools/cal_screen_mock/png/installedMount.png

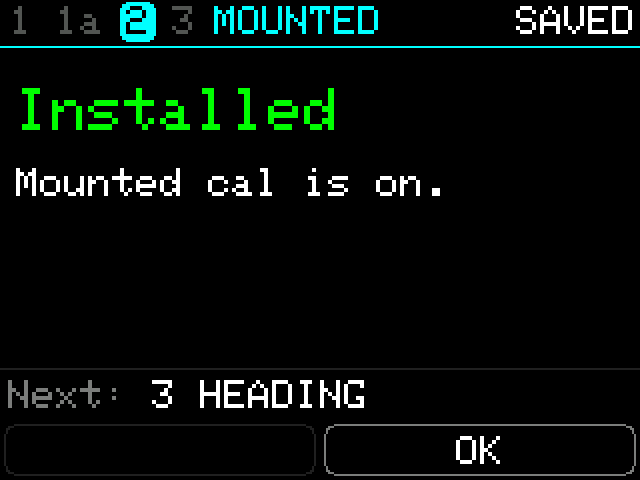
tools/cal_screen_mock/png/installedMount.png
