djmcmath/dpv-nav/tools/cal_screen_mock/png/installedNoMap.png

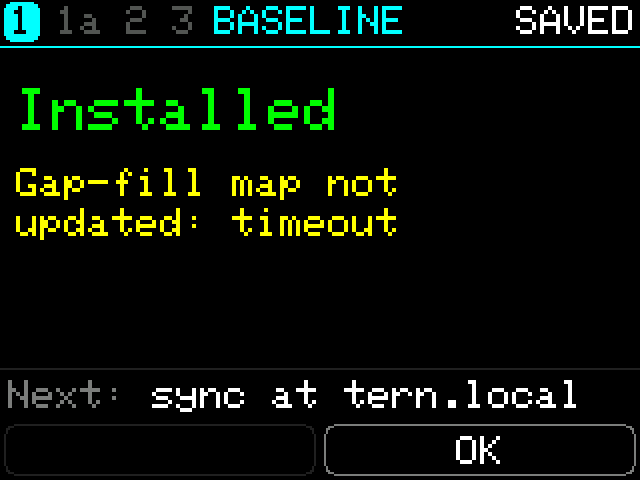
tools/cal_screen_mock/png/installedNoMap.png
