djmcmath/dpv-nav/docs/dev-calibration-guide.md

# Sensor Calibration — Engineering Reference

> **Audience.** This is the engineering half of the calibration docs: file
> formats, fitting tools, gate constants, the frame conventions, the serial
> diagnostics, and the decision records behind why several things behave the way
> they do. The diver-facing walkthrough — what to press, in what order, why each
> step exists, and what a good result looks like — lives in
> [user-calibration-guide.md](user-calibration-guide.md). Where a procedure is
> the same for both audiences it is written out once, there, and pointed at from
> here. Anything here that a diver also needs to know is in that guide too, in
> their language.

> **Shipped:** Baseline, Mounted, and Heading (12-pt) calibration all fit in the cloud
> now. Collect on the unit with WiFi connected, and the nav device uploads the raw
> samples, gets a fitted result + quality verdict back within seconds, and shows the
> result right there on the display (ACCEPT on BTN2, hold BTN1 for 2 s to REJECT) —
> no laptop step required. Every cal screen shares one layout: the step strip
> `1 1a 2 3` and a counter across the top, one status line, and two softkeys
> (BTN1 left, BTN2 right); see the user guide's Calibration section. See
> [cloud-calibration-plan.md](./cloud-calibration-plan.md) and divemap's
> [heading-cal-cloud-plan.md](../../dive-map/docs/architecture/heading-cal-cloud-plan.md)
> for the implementation history. The manual laptop workflow (export CSV, run the
> Python fitting tool locally, upload the result under the exact expected filename)
> described in places below is now the **offline fallback** — it still works, and is
> what happens if the unit has no WiFi at the moment calibration finishes, since the
> raw CSV is always saved to LittleFS either way.

## Overview

DPV-Nav calibrates four sensors/subsystems: magnetometer, gyroscope, accelerometer, and heading. Calibration data is persisted to LittleFS as JSON files on the nav device. On boot, saved calibration loads in under a second. If gyro/accel files are missing, blocking calibration runs automatically. Mag is the exception: on a brand-new device (no mag_base.json/mag_mount.json/mag_cal.json at all) there's no sane automatic mag cal to run, so mag stays uncalibrated (identity — no correction) until the diver runs CAL > Baseline (+ Mounted) from the menu. Heading cal is always optional and silently skipped if absent.

## Calibration Files

```
/mag_base.json      — Baseline magnetometer (hard-iron + soft-iron 3×3), off-scooter cal
/mag_mount.json     — Mounted magnetometer correction (hard-iron + soft-iron 3×3), on-scooter
/mag_cal.json       — Legacy single-stage mag cal (loaded as fallback if base/mount absent)
/gyro_cal.json      — Gyroscope bias
/accel_cal.json     — Accelerometer bias + scale
/hdg_samples.csv    — Raw (target, indicated) pairs from heading cal collection run
/hdg_fourier.json   — Fourier heading correction (n harmonics + coefficient array, optional)
/motor_cal.json     — Motor-on heading offset (single float, optional)
/mag_temp.json      — Magnetometer thermal-drift coefficients (µT/°C + reference temp, optional)
/speed_cal.json     — Flow sensor k-factor history (rolling 6-run average)
```

### JSON Formats

**MagCalib** (base and mount files):
```json
{
  "bias": { "x": 45.2, "y": -28.7, "z": 15.4 },
  "softIron": [
    [1.02, 0.01, -0.003],
    [0.01, 0.98, 0.002],
    [-0.003, 0.002, 1.01]
  ]
}
```

**Calib3** (gyro/accel):
```json
{
  "bias": { "x": 0.1, "y": -0.05, "z": 0.03 },
  "scale": { "x": 1.0, "y": 1.0, "z": 1.0 }
}
```

**HdgFourier** (Fourier heading correction):
```json
{ "n": 4, "c": [5.85, -0.39, -5.10, 0.16, -16.54, -0.76, 1.88, -0.27, 2.92] }
```
`n` is the number of harmonics (1–4). `c` is the Fourier coefficient array: `[DC, cos1, sin1, cos2, sin2, ...]` (length `2n+1`). Generated offline by `tools/fourier_fit.py`.

## Boot Sequence

```
For mag: try two-stage chain (mag_base.json + mag_mount.json)
          → fall back to legacy mag_cal.json
          → fall back to identity (no correction); diver runs CAL > Baseline (1) (+ Mounted (2)) later
For gyro: load gyro_cal.json or run 10s stationary bias cal
For accel: load accel_cal.json or run 6-point orientation cal
For hdg: load hdg_fourier.json — silently skip if absent (optional)
For mag temp: load mag_temp.json — compensation off if absent or invalid (optional)
```

## Magnetometer Calibration

### Two-stage calibration chain

The preferred calibration workflow uses two stages, each producing a JSON file that is the result of ellipsoid fitting — done automatically in the cloud when the unit has WiFi, or offline with the same fitting tool as a fallback:

| Stage | Menu item | File | When to do |
|---|---|---|---|
| Baseline | CAL > Baseline (1) | `/mag_base.json` | First time, or after hardware change. Device off the DPV. Covers full sphere. |
| Mounted | CAL > Mounted (2) | `/mag_mount.json` | After baseline, with device installed on DPV. Corrects for DPV magnetic signature. |

Mounted (and Baseline's `Fill gaps` patch pass) collect raw samples using a
**bin-aware** approach: the screen shows a heading × elevation grid, and cells turn
green as they are filled, completing automatically once all required
cells are green, or when the diver presses FINISH (BTN2). Baseline shows the same
kind of grid once it has worked out roughly where north is, a few seconds in, but
completes only on FINISH or a full sample buffer (2160), never on a full grid — see
**Running Baseline Calibration** below. Holding BTN1 for 2 s on any collecting
screen quits with nothing saved or uploaded. Either way, the sample CSV is
saved to LittleFS once collection ends.

### Running Baseline Calibration

> **Baseline has a live grid again (0.7.25).** Six earlier attempts at a live grid
> during a first-ever baseline pass all fought the same chicken-and-egg problem:
> heading needs a calibration that doesn't exist yet. See
> [baseline-cal-two-pass.md](./baseline-cal-two-pass.md). From 2026-07-25 to 0.7.25
> baseline showed bars only. Now the unit fits a hard-iron sphere to the samples as
> they arrive. Once that fit passes a lock gate, usually 50–75 samples in, it bins
> every sample the way gap-fill does: per sample, from mag + accel, no filter. On
> five real baselines that put 85–90% of samples in the exact cell the server's
> real fit does, and nearly all the rest in the next cell over. The server still
> grades the upload; the grid is for steering. See
> [baseline-live-grid-plan.md](./baseline-live-grid-plan.md).

**The diver-facing procedure is in
[user-calibration-guide.md](user-calibration-guide.md#step-1--baseline-cal--baseline-1)** —
collection technique, the sample-count target, and what the result screen means.
What matters on this side:

- **Lock gate.** The bars→grid switch is `baseline_boot.h`'s sphere refit passing
  N ≥ 50, radius within 10% of `MAG_CAL_EXPECTED_FIELD_UT` (50.1 µT), direction
  spread ≥ 0.004, bias stable to 2 µT. A site whose field strength is outside
  that ±10% window never locks; the session still collects, bins and uploads
  exactly as before, on the bars-only screen.
- **End conditions.** FINISH (BTN2, `FINISH_BASELINE_COLLECTION`) or the sample
  buffer filling at `MAG_CAL_BIN_MAX_SAMPLES` (2160). A full grid never ends it.
- **Output.** `/mag_baseline_samples.csv` on LittleFS, written whether or not the
  upload path runs.
- **Cloud path.** Result is staged, not written over the active file. ACCEPT
  copies staged → active, hot-reloads, and calls
  `cal_sync::refreshGapFillTargets()`; a failed download deletes
  `/cal_targets.json` rather than leaving it pointing at the previous baseline.
- **Offline fallback.** Pull the CSV (web interface or LittleFS tools) and run
  `python tools/mag_calibration.py mag_baseline_samples.csv`, then upload the
  generated `mag_base.json` to LittleFS root.

### Running Mounted Calibration

Mounted records **one dwell per cell**: a cell fills only after the scooter has sat still, inside that row's attitude, for about half a second. Swinging through a cell records nothing. The server's fit takes "down" from the accelerometer, so a sample taken while the scooter is being moved carries a false tilt and the fit has to throw it away — which is what happened to most of every collection before this (firmware up to 0.7.19 took the first 18 samples to land in a cell). Background: dive-map's [mounted-cal-dwell-plan.md](../../dive-map/docs/architecture/mounted-cal-dwell-plan.md).

**The diver-facing procedure — the screen, the attitude/MOTION/HOLD widgets, the
status-line table and the per-cell rhythm — is in
[user-calibration-guide.md](user-calibration-guide.md#step-2--mounted-cal--mounted-2).**
What matters on this side:

- **Dwell limits** are `MAG_CAL_DWELL_*` in [config.h](../src/config.h), evaluated
  by [mounted_dwell.h](../src/util/mounted_dwell.h) (host-tested in
  `tools/mounted_dwell_test/`). They are deliberately tighter than the server's in
  `callib/fit.py`; nothing forces the two to agree.
- **Grid is 3 × 12 = 36 cells** (`MAG_CAL_SECTORS_MID` = 12 since 2026-11; it was
  24, with 6 spread cells per tilted row). Whether the tilted rows earn their time
  is an open backlog analysis; until it is answered, they are all targets.
- **End conditions.** All 36 cells, or FINISH (BTN2) any time after the first
  cell. Whether what was collected is enough to fit is the server's call.
- **Output.** `/mag_mounted_samples.csv`.
- **Offline fallback.** `python tools/mag_calibration.py --mode mounted --base
  mag_base.json mag_mounted_samples.csv`, then upload the result to LittleFS
  **under exactly the name `/mag_mount.json`**. Do not pass `--output` with a
  different name unless you rename it on upload: the firmware reads only
  `/mag_mount.json` and silently ignores anything else, leaving the previous
  mounted cal in effect. This applies to the manual path only — the cloud path
  always writes the correct filename. See [troubleshooting
  note 2](#troubleshooting-heading-still-off-after-a-full-calibration) for why
  this bites.

### What each stage corrects

A diver-facing version of this table, including the heading stage, is in the
[user guide](user-calibration-guide.md#the-chain-at-a-glance).

| Distortion | Baseline | Mounted |
|---|---|---|
| Hard-iron bias (sensor, PCB) | ✓ | Refined |
| Soft-iron coupling (PCB, enclosure) | ✓ | Refined |
| DPV motor/battery magnetic signature | — | ✓ |
| Offset drift with sensor temperature | — | — (see below) |

### Temperature: calibrate near 21 °C

Neither stage can correct temperature drift. The LIS3MDL's offset moves ~0.68 µT/°C with
its die temperature, which is up to ~2°/°C of heading. That is handled separately by
`/mag_temp.json`: every raw reading is normalized to the file's `ref_temp_c` (21 °C) before
calibration is applied, and sample collection reads through the same correction, so a cal
collected warm and a dive done cold still line up. Without that file, a calibration is only
accurate near the temperature it was collected at. See
[mag-temperature-compensation.md](./mag-temperature-compensation.md) for the measurement,
the file format, and the per-heading error guideline.

### Forcing re-calibration

Delete the corresponding JSON file(s) from LittleFS and reboot, or run the menu cal workflow to generate new sample CSVs.

## Filling Coverage Gaps

Redoing an entire baseline tumble or 12-point heading collection to patch one thin
region is wasteful. Both mag baseline and heading (hdg) calibration support adding a
short supplemental collection that the server merges into the existing fit, rather
than starting over. The two work differently — mag's gap-fill is on-device, hdg's is
a web form — because their gaps are detected differently (a 2-D orientation grid vs.
a 1-D ring of headings).

### Baseline: CAL > Fill gaps (1a)

A *second* baseline pass that patches only the orientation cells the Dive Map website
flagged as thin or empty on your installed baseline calibration — not a full redo.

**The diver-facing procedure, the grid legend and the merge workflow are in
[user-calibration-guide.md](user-calibration-guide.md#step-1a--gap-fill-cal--fill-gaps-1a).**
What matters on this side:

- **Two hard preconditions**, both refused on-screen with **Can't start** rather
  than run degraded: a baseline calibration installed, and a target map for *that
  baseline* cached on the device as `/cal_targets.json`. A refusal arrives as a
  FAILED `CalCloudResultPacket`; the display tells it apart from an upload failure
  by `gGapFillStarting`.
- **Where the map comes from.** Accepting a baseline on the unit downloads it
  immediately; a failed download deletes the stale map rather than leaving it
  pointing at the previous baseline's cells. Otherwise it arrives via
  `tern.local` → **Calibration Cloud Sync** → **Check for updates**
  (`cal_sync.cpp`'s `refreshTargets()`, unconditional on both branches of
  `checkForUpdates()`), so **every** click re-syncs it, not just the first. This
  is a web-page button, not a device menu item — the on-device refusal text used
  to wrongly say `CAL > Check for updates`.
- **Sync failures are surfaced on the page.** The reason now appears in the
  "Check for updates" result text (a common one: the accepted baseline predates
  coverage grading). It used to go only to a Serial log, which is useless on a
  sealed unit, and was the actual cause of "Fill gaps refuses with no
  explanation".
- **Binning.** Against the **baseline-only** cal, orientation computed
  algebraically per sample by
  [mag_cal_orient.h](../src/util/mag_cal_orient.h)'s `orientSample`, no Mahony
  filter in the path. Never the base∘mount chain: gap-fill is an off-DPV pass and
  the server's target grid lives in the baseline frame.
- **Target selection is server-side and never recomputed on the device**, so
  retuning the thin/empty thresholds costs a sync rather than a reflash.
  Per-cell acceptance caps are `MAG_CAL_GAPFILL_TARGET_CAP` / `_UNTARGETED_CAP` /
  `_TARGET_CAP_OTHER_ROLL` in [config.h](../src/config.h).
- **The patch uploads as a baseline-mode collection** and is fit from just the
  patched cells. It is never directly installable — the **Uploaded** screen is
  informational, OK only — and becomes useful only once merged with the existing
  baseline from the website's merge picker.

**Why you sometimes have to hold the unit upside-down or on its side:**

The 60-cell grid tracks *where* the sensor's tracked axis points — elevation and
heading — but not how the unit is *rolled* about that axis while pointing there.
That's on purpose: it's what makes tilt-compensated heading work at all. But it
means a cell can show fully green ("enough samples at this elevation/heading")
while every one of those samples came from roughly the same roll — a real gap in
what the fit actually saw, invisible on the grid alone.

To close it, each cell also grades **roll diversity** across four orientations —
**upright**, **on its right side**, **upside-down**, **on its left side** — the
same plain-language poses the accelerometer calibration section above uses.
Upright needs about 3× the samples of the other three (most natural handling is
upright-biased anyway, and closing this gap only needs enough angular diversity
to break the "one roll" degeneracy, not dense sampling at every angle). A cell
you're standing in can look done on the main grid and still want a quick
roll — inverting the unit, or laying it on a side — before it clears.

The screen shows a small square, split into four triangles (top/right/bottom/left
= upright/right-side/upside-down/left-side), next to the orientation readout. It
always reflects **whichever cell you're currently pointing at** — no separate
screen to flip to — colored the same red/yellow/green as the main grid, with a
white outline on whichever triangle matches your current roll. If a cell's
triangles are still red or yellow once the main grid says you're on it, roll the
unit through the outlined shape's neighbors until they clear.

*(Readings can lag or jump while the unit is actively moving — the accelerometer
briefly sees your hand's motion as "down," not just gravity. Pause near the
target orientation rather than reading the grid or the roll widget mid-motion.)*

**Top and bottom rows: aim for the edge of the band, not straight up.**

The outer rows cover everything past ±60° of elevation, so the natural instinct
is to point the unit straight up (or straight down) and spin it to pick up the
roll poses. Don't — the row starts at 60°, and holding nearer 65° than 90° makes
the same cell dramatically easier to work:

| holding | roll signal | roll reading noise | heading smear from a 3° hand wobble |
|---|---|---|---|
| 65° | 0.42 g | ±1.4° | 6° (a fifth of a column) |
| 80° | 0.17 g | ±3.3° | 17° (half a column) |
| 85° | 0.09 g | ±6.5° | 34° (a full column) |
| 88° | 0.04 g | ±16° | 86° (three columns) |

Two separate things degrade toward vertical. **Roll** is read off the part of
gravity across the tracked axis, which shrinks as `cos(elevation)` — at 88° only
0.035 g is left to work with, so which roll pose you are in becomes mostly
sensor noise. **Heading** gains `tan(elevation)`, so at 88° a 3° tremor sweeps
you across three heading columns. Together that is why spinning while pointed
near-vertical scatters samples over the whole top row instead of completing one
cell: the roll credit is noisy and the heading column will not hold still.

At 65° you are still in the top row, with ~12× steadier heading and ~12× cleaner
roll than at 88°. Point up, but not all the way.

**This noise is accepted behaviour, not a defect — please don't re-open it.**
Near vertical there is genuinely almost no gravity left across the tracked axis
to measure roll with, and heading genuinely does gain `tan(elevation)`; both are
properties of the geometry, not of the filter, the calibration, or the wire
format. The device therefore still credits a roll sector near vertical even
though that reading is mostly noise. Gating it (refusing roll credit above ~84°)
was considered and **deliberately not done**: it would throw away samples the
diver worked to collect in the row that is already hardest to fill, to fix a
coverage overclaim that the band-edge technique above avoids anyway. If the top
row is being difficult, the answer is to hold nearer 65° — not to go looking for
a bug in the roll math.

### Heading (12-pt): the website manual-entry form

The 12 fixed points (every 30°) can leave one span under-sampled — e.g. only 4 of the
12 points falling in a 90° swing near North — which the whole-CSV fit can mask with a
deceptively good in-sample error while the correction is actually bad in the gap. The
server checks for this automatically on every heading fit (`sector_adequacy`): it
looks for gaps wider than 45° between the collected **indicated** headings and, if it
finds one, suggests bearings to steer that would land readings inside it.

The two frames matter here. The gap is found in the *indicated* domain, because that
is what the Fourier series is a function of and therefore where it is unconstrained —
a gap is wide precisely because the indicated heading swung fast across it. But a
diver can only steer an *actual* bearing, so each suggestion is projected back by
interpolating between the two collected points that bracket the gap, then rounded to
the nearest 5° (the finest anyone can hold against a small compass). Suggestions
landing within 10° of a bearing you already collected are dropped, since they would
add no constraint the fit doesn't already have.

Unlike Baseline's gap-fill, there is **no on-device collection flow for this** — no
firmware round trip, no menu item. It's a small manual-entry form on the website:

The form posts to `POST /calibrations/{id}/hdg-manual-samples`, which combines
the typed rows with the original 12-point upload and re-fits, producing a new
pending row to Accept/Reject on the website like any other fit.
**The diver-facing procedure is in
[user-calibration-guide.md](user-calibration-guide.md#if-one-section-of-the-circle-comes-out-thin).**
The one thing that is easy to get wrong on either side: the typed `indicated`
values must be in the **same frame as the existing rows** — `heading_raw_deg`,
pre-Fourier and pre-motor magnetic — which is what **DISPLAY > Heading → RAW**
shows. Readings taken in TRUE or MAG make the calibration worse, not better.

**Getting an accepted web result onto the physical unit:** accepting a calibration
*on the website* only updates the database — there is no background mechanism that
pushes it to the device. The device only picks up an accepted web-side result when
you explicitly ask it to: on `tern.local`, under **Calibration Cloud Sync**, press
**Check for updates**. This applies to both the Baseline gap-fill merge and the hdg
manual-entry gap-fill described above — a calibration you accepted on the web is not
"live" on the unit until you also do this step. (A calibration accepted *on the
device itself*, via the result screen right after collection, needs no such step —
it's already local, and a baseline brings its gap-fill map with it.)

## Gyroscope Calibration

**Method:** Stationary bias sampling (runs at boot if no file found)

**Procedure:**
1. Place device on a stable, level surface
2. Keep completely still — no movement or vibration
3. System samples for 10 seconds at ~100 Hz
4. Average of all samples = bias offset; scale remains 1.0

**Typical values:**
- Good: ±10–50 raw counts (±0.001 rad/s)
- Bad (device moved): > 200 raw counts — repeat on a more stable surface

To force recalibration: delete `/gyro_cal.json` from LittleFS and reboot.

---

## Accelerometer Calibration

**Method:** 6-point orientation sequence (runs at boot if no file found)

**Not sure which physical side is "forward," "right," etc.?** Before calibrating,
run the `accel_orient` serial command (see [Serial Diagnostic Commands](#serial-diagnostic-commands)
below). It prints which of the 6 orientation labels currently matches, updating
a line at a time as you rotate the device in your hand, so you can learn the
mapping without guessing.

**Procedure:**
1. System prompts for 6 orientations in turn, each phrased as attitude-first
   plain language plus which edge/side ends up on top:
   - Nose pointing straight up — Front edge UP
   - Nose pointing straight down — Front edge DOWN
   - Resting on its left side — RIGHT side UP
   - Resting on its right side — LEFT side UP
   - Upside down, level — BOTTOM side UP
   - Straight and level, normal — TOP side UP
2. For each one, point the device that way and press Enter to sample.
3. Hold the device steady while it samples (2.5 s by default).
4. System computes: `bias = (max + min) / 2`, `scale = 9.81 / (max - bias)` per axis

**Typical values:**
- Bias: ±50 raw counts (±0.004 m/s²)
- Scale: 0.98 – 1.02 per axis

## Serial Diagnostic Commands

A few serial commands help confirm sensor orientation before or instead of
running a full calibration (connect via `pio device monitor`, type the
command, press Enter):

| Command | Purpose |
|---|---|
| `accel_orient` | Prints a new line each time the detected accelerometer calibration orientation changes as you rotate the device. Use this to learn the physical mapping before running accelerometer calibration. |
| `sensor_orientation` | One-shot: dumps raw native-frame accel/gyro/mag counts for a device held level, with axis-mapping guidance. |
| `axis_test` | Prompts you to point the device North/East/South/West and compares magnetometer readings, to sanity-check heading axis mapping. |
| `debug_axes` | One-shot snapshot tracing a sample through axis mapping, unit conversion, calibration, and the AHRS filter — useful when diagnosing heading errors. |

## Fourier Heading Calibration

**Purpose:** After magnetometer calibration, complex systematic heading errors typically remain (5–20°) due to the DPV's magnetic geometry (motor, batteries, structural asymmetries). The 4-harmonic Fourier correction captures these non-sinusoidal errors and reduces residual error to ~2° max.

**When to do it:** After completing baseline + mounted mag cal. Run in a magnetically clean environment (living room on a wooden floor — not in a garage with rebar in concrete). The device must already have a working magnetometer calibration.

**Trigger:** Menu → **CAL > Heading (3)**

### Procedure

**Part 1 — On-device data collection:**

**The diver-facing procedure — the screen, the 12 targets, aligning to an
external compass, and reading the result — is in
[user-calibration-guide.md](user-calibration-guide.md#step-3--heading-cal--heading-3).**
What matters on this side:

- **Level gate** ([level_gate.h](../src/util/level_gate.h), nav board, sharing
  [stillness.h](../src/util/stillness.h) with mounted dwell capture so "still"
  means one thing). BTN2 marks only within `HDG_CAL_LEVEL_TOL_DEG` (3°, pitch and
  roll, accel-only) and still for `HDG_CAL_LEVEL_SETTLE_MS` (1.5 s, which also
  lets heading settle after the turn). State, hold %, and the gate's own
  pitch/roll ride in NavPacket (`lg`/`lh`/`lgp`/`lgr`, only while
  `gHdgCalActive`). A nav build that sends no gate data (INACTIVE) is never
  gated. Host-tested in `tools/level_gate_test/`.
- *Why the gate exists:* the correction is a function of heading only, so it
  cannot tell an attitude change from a heading error — a point marked tilted is
  fitted as heading error at that heading. Every point records the attitude it
  was marked at (see the CSV format below).
- **`HDG_CAL_LEVEL_GATE = false`** (config.h) is the off-level test build: MARK
  always marks and the status line reads **GATE OFF - test build**.
- **Output** `/hdg_samples.csv`, then `FINALIZE_HDG_CAL` hands off to the same
  cloud round trip Baseline and Mounted use.
- **The result number is `max_err_deg`, not `rms_pct`** — the leave-one-out worst
  case (each point against a curve fitted without it), bands 5°/8°, since
  2026-10-16. The nav board forwarding `rms_pct` instead is how the screen once
  showed two different "max errors". A backend too old to send it shows `--`.
- The server auto-selects 1–4 harmonics and checks `sector_adequacy` (see
  [Filling Coverage Gaps](#filling-coverage-gaps)). Accept stages
  `/hdg_fourier_pending.json` → `/hdg_fourier.json` and hot-reloads.

**Part 2 — Offline fit and upload (fallback only, when the unit has no WiFi at cal time):**

1. Download `/hdg_samples.csv` from the nav device (via web interface or LittleFS tools).
2. Run: `python tools/fourier_fit.py hdg_samples.csv [--plot]`
   - Prints per-point residuals and selects the best number of harmonics (1–4).
   - Saves `hdg_fourier.json` in the current directory.
   - Optionally saves `hdg_fourier_fit.png` (requires `--plot`).
3. Upload `hdg_fourier.json` to the nav device LittleFS root.
4. Reboot — the correction loads automatically.

This offline tool has no sector-gap check of its own — it fits whatever CSV you give
it. If you took this fallback path and want gap detection too, you can still upload
the CSV later once you have WiFi (via the same on-device heading cal flow, or by getting
the raw CSV into a fresh cloud upload), or just watch for an obviously bad sector in
the residual printout and hand-add points there before fitting.

### CSV format

`/hdg_samples.csv` (the server reads `actual` and `indicated` by name and ignores the rest):

```csv
actual,indicated,mag_temp_c,tcomp,pitch,roll,motion,level_state
0.0,4.7,21.40,1,0.41,-1.20,12,4
30.0,24.3,21.42,1,-0.33,0.85,9,4
...
```

`actual` is the target heading the user aligned to; `indicated` is what the AHRS
reported (pre-Fourier, pre-motor magnetic heading). `mag_temp_c`/`tcomp`: die
temperature and whether thermal compensation was on. `pitch`/`roll`: the level
gate's accel-only attitude at the mark, degrees. `motion`: the stillness figure,
50 = on the limit. `level_state`: 4 = READY; anything else means the point was
marked with the gate off.

### How it works at runtime

The nav device loads `hdg_fourier.json` on boot and evaluates the Fourier series at each heading computation:

```
correction(θ) = c[0] + c[1]·cos(θ) + c[2]·sin(θ) + c[3]·cos(2θ) + c[4]·sin(2θ) + ...
headingDeg = headingRawDeg + correction(headingRawDeg)
```

`heading_raw_deg` is always sent in NavPacket alongside the corrected `heading_deg`, so the display can show pre-correction readings during recalibration.

### Recalibrating

Run **CAL > Heading (3)** again — the fresh 12-point collection uploads and fits in the
cloud automatically (WiFi permitting) and replaces `hdg_fourier.json` on accept, same
as the first time.

### Troubleshooting: heading still off after a full calibration

Real failure modes actually hit in the field, hardest-to-spot first. If the heading is wrong *after* baseline + mounted + Fourier, it is almost always one of these, not the mag math:

1. **Checking in TRUE mode against a magnetic reference (or vice-versa)** — a
   near-constant ≈14.7° offset in *every* sector. The nav device always computes
   TRUE; **DISPLAY > Heading** converts on the display side. Still the #1 cause of
   "everything is ~15° off". Written out for divers in
   [user-calibration-guide.md](user-calibration-guide.md#checking-a-finished-calibration).

2. **Mounted correction uploaded under the wrong filename.** The firmware only ever loads `/mag_mount.json` ([storage.h:28](../src/util/storage.h#L28)). This is specifically a risk of the **manual offline fallback path** (cloud uploads always write the correct filename automatically): if you run the tool with `--output mag_mounted.json` (or any other name) and upload *that*, it is silently ignored — the **previous** mounted cal stays in effect and your fresh numbers never take. *Symptom:* the soft-iron ellipticity you meant to remove is still present (large residual 2nd harmonic). `mag_calibration.py` now prints a loud warning when the output name won't be read; heed it. Confirm on boot: `[STORAGE] mag_mount.json loaded`, with a `b_eff` that matches the new values.

3. **Motor offset shifts the check but not the cal.** `/motor_cal.json`'s `heading_offset_deg` is added to the *displayed* heading **after** the Fourier correction ([nav_main.cpp:333](../src/nav_main.cpp#L333)), but the hdg-cal samples record `heading_raw_deg`, which is *before* it. So the motor offset is invisible to the fit and shows up as a constant bias in your check. Expect it, or zero it while collecting.

4. **Fourier over-fit / coverage gaps.** With 12 points, the fit caps at 2 harmonics on purpose — a tiny RMS at higher orders is over-fit, not accuracy. Because the deviation compresses the *indicated* scale, evenly-spaced targets can leave a large hole in the indicated domain (a ~50° gap near North is common); the fit is unconstrained there and worst in that sector. The cloud fit flags this automatically (`sector_adequacy`, gaps > 45°) and the Dive Map website shows a "thin sector(s)" badge with suggested headings to fill it — use the manual-entry form described in [Filling Coverage Gaps](#filling-coverage-gaps) above, it's the supported way to close a gap without redoing all 12 points. `fourier_fit.py`, the offline-fallback tool, warns about the same gap but has no form to act on it — see the hand-collecting note below if you're on that path.

**Reading indicated headings for gap-fill (both paths):** the new rows must be in the same frame as the existing ones — `heading_raw_deg`, i.e. **pre-Fourier, pre-motor magnetic**. Set **DISPLAY > Heading** to **RAW** and read the value straight off the nav screen; the digits turn yellow and the suffix reads `R` so a RAW reading can't be mistaken for a navigable heading. RAW shows `heading_raw_deg` from the NavPacket verbatim — the same value `CAPTURE_HDG_POINT` records — so `hdg_fourier.json` and `motor_cal.json` can stay installed. Set the mode back when you're done; RAW is not sticky and reverts to MAG on the next boot anyway.

> Before 2026-08-27 this required deleting `hdg_fourier.json`, zeroing `motor_cal.json`, reloading cal, and then restoring both by hand — with no backup path for `motor_cal.json`, so a copy had to be saved first. That is no longer necessary and should not be done.

On the **offline-fallback path**, append the `actual,indicated` rows to `hdg_samples.csv` and refit with `fourier_fit.py`. On WiFi, use the web form described in [Filling Coverage Gaps](#filling-coverage-gaps) above.

**What the suggested headings mean:** they are **bearings to steer**, rounded to the nearest 5° (the finest a diver can hold against a small compass). The gap itself is detected in the *indicated* domain — that is where the Fourier series is unconstrained — but each suggestion is projected back into the actual domain by interpolating between the two collected points bracketing the gap, so aiming at one lands the reading inside the hole. The website states both frames: "Between your 337° and 066° points the compass swung 90° — steer 015°, 050°."

## Storage API

```cpp
#include "util/storage.h"

// Magnetometer
storage::saveMagCalibration("/mag_base.json", magCal);
storage::loadMagCalibration("/mag_base.json", magCal);

// Gyro / Accel
storage::saveCalib3("/gyro_cal.json", gyroCal);
storage::loadCalib3("/gyro_cal.json", gyroCal);

// Heading cal (read-only on device — file is written by ACCEPT_CLOUD_CAL after a
// cloud fit, or uploaded manually after the offline fallback)
#include "util/hdg_cal.h"
hdg_cal::load(gHdgCal);                    // returns bool; reads /hdg_fourier.json
hdg_cal::apply(headingDeg, gHdgCal);       // returns corrected heading
```

Files are stored on LittleFS (ESP32 internal flash). Total calibration data is <5 KB.

## Troubleshooting

Symptom-driven troubleshooting a diver can act on — wrong heading mode, tilt
dependence, thin sectors, "Can't start", a web-accepted cal the unit isn't
using — is in
[user-calibration-guide.md](user-calibration-guide.md#when-it-goes-wrong).
What's left here is the bench/bring-up side:

| Problem | Cause | Fix |
|---|---|-----|
| Fourier residuals > 5° after fit | Calibration in bad environment | Move away from concrete floors with rebar; redo collection |
| Fourier residuals > 5° in clean env | Complex DPV magnetic geometry | Check DPV for loose magnetic components; inspect the per-point residuals from `fourier_fit.py` |
| Gyro bias very large (>500) | Device moved during cal | Repeat on stable surface, no vibration |
| Accel scale way off (>1.1) | Wrong orientation or sensor issue | Verify axis labeling with `accel_orient` / `sensor_orientation`, check sensor |
| Mag heading stable but mirrored, or wrong by ~180° at tilt | Mag Y mirror not un-done before an accel-derived rotation | See CLAUDE.md's "Magnetometer Coordinate Frame" rule 6; validate against `tools/fixtures/` |
| "LittleFS mount failed" | Flash partition not configured | Check `board_build.filesystem = littlefs` in platformio.ini |

## Motor-On Heading Correction

**Purpose:** The Fourier heading calibration is collected with the motor off (bench procedure). When the DPV motor runs, its magnetic field adds a roughly constant heading bias — typically a fixed offset that doesn't depend on heading angle or motor speed. `/motor_cal.json` stores this single correction value.

**When to do it:** After completing Fourier heading cal. Run a reciprocal-leg test on a known bearing with the motor running; compare indicated headings against expected and note the offset. Alternatively, use `tools/correct_track.py` with a calibration run CSV (reciprocal legs between two known GPS points) to derive the offset automatically.

**File format** (`/motor_cal.json`):
```json
{ "heading_offset_deg": -3.0 }
```

- Positive value: compass reads low (offset is added to get true heading)
- Negative value: compass reads high (offset is subtracted from indicated heading)

**Loading:** The nav device loads `/motor_cal.json` at boot (and on "Reload Cal Files" from the web page). If the file is absent or invalid, no motor correction is applied.

**Creating the file manually:**
1. Align the running DPV to a known magnetic bearing.
2. Note the difference: `offset = actual − indicated`.
3. Create `motor_cal.json` with that value and upload it to LittleFS root.
4. Reboot or use "Reload Cal Files" on the web page.

## Speed Calibration (Flow Sensor)

Speed cal measures the flow sensor's k-factor (pulses per litre) by timing a swim over a
known distance. Up to 6 runs are averaged and saved to `/speed_cal.json` on LittleFS.

The flow sensor converts pulse frequency to speed:
```
speed_ms = (freq_hz / k_factor) / 60 / 1000 / cross_section_m2
```
Speed cal solves for `k_factor` given true distance and total pulses. Elapsed time cancels —
only pulse count and distance matter.

**Before speed cal:** Set `FLOW_CROSS_SECTION_M2` in `config.h` to the physical inner
cross-section of the DPV inlet. For a 50 mm diameter tube: π × (0.025)² ≈ 0.00196 m².

### Running a speed cal

**The diver-facing procedure, including the run-detection thresholds as they are
experienced in the water and when to use each of the three accept options, is in
[user-calibration-guide.md](user-calibration-guide.md#step-4--speed-cal--speed-cal).**
On this side: the nav device owns the clock and the sampling
(`cal_mode` 2 = WAITING → 3 = RUNNING → 4 = RESULT), the display advances its own
phase forward-only by watching `cal_mode` in incoming NavPackets, and the result
is written through `speed_cal::addMeasurement()` (ACCEPT) or
`speed_cal::reset()` then `addMeasurement()` (RESET+ACCEPT) into
`/speed_cal.json`'s rolling 6-run history.

### Deriving k from a corrected dive

A dive corrected in Dive Map against GPS fixes and waypoint snaps reports a speed
factor (called `k` there too, unrelated to this one) defined as

```
true_speed = s x logged_speed
```

Reported speed is proportional to `1/k_factor`, so scaling speed by `s` means:

```
k_new = k_old / s
```

Sign check, worth doing every time: `s < 1` means the unit read fast, so `k` goes **up**.

Two things to get right:

- **`k_old` must be what the unit was actually running on that dive** — its NVS history
  via `speed_cal::averageK()`, not `baseline cal jsons/speed_cal.json`, which is only the
  seed file. If those differ, the composition is wrong.
- **Use one joint least-squares solve over the legs you trust.** Do not average per-leg
  `s` values (each has absorbed its own leg's heading error), and do not average several
  whole-dive solves that share data — both double-count, and both drag the answer back
  toward whichever legs you were trying to exclude.

Feeding the result back in: this is a derived measurement, not a timed run, so it does not
belong in the rolling average alongside them. Set `/speed_cal.json` to `{"n":1,"k":[k_new]}`
— the equivalent of **RESET+ACCEPT** — and note what it came from.

#### Worked example — 2026-08-29, Dawn

Five legs, anchored by two GPS fixes and three waypoint positions. Legs 1–3 (surface swim
out, then both deep DPV legs) were judged trustworthy; legs 4–5 were shallow with
intermittent scooting and swimming, so one speed factor cannot hold across them.

```
joint solve, legs 1-3   s = 0.9029    k_new = 0.1686 / 0.9029 = 0.1867
joint solve, legs 2-3   s = 0.8728    k_new = 0.1686 / 0.8728 = 0.1932
joint solve, all 5      s = 0.8657    k_new = 0.1686 / 0.8657 = 0.1947
```

**Do not chase the last digit.** Re-solving with the three waypoint positions perturbed by
±10 m (1σ) — realistic, since one is sidescan-derived — gives `s = 0.906 ± 0.034`, so
`k_new` lands anywhere in 0.179–0.193. Which legs you include moves the answer less than
the anchor uncertainty does. Take it to three decimals, record what it was derived from,
and expect to refine it.

The heading offset from the same solve (+11.6°) barely moves under that perturbation. That
one is worth acting on with confidence; this one is a better guess than what it replaces.

### Setting FLOW_CROSS_SECTION_M2

`FLOW_CROSS_SECTION_M2` in `config.h` must be set to the physical intake cross-section of the DPV inlet before speed cal can give sensible k-factor values. Measure the inner diameter of the flow sensor mounting tube:
```
area = π × (diameter/2)²
```
A 50 mm diameter tube → 0.00196 m² ≈ 0.002 m². This constant is not calibrated automatically.
