djmcmath/dpv-nav/hardware/schematic/gps_board/preview/gps_carrier.pdf

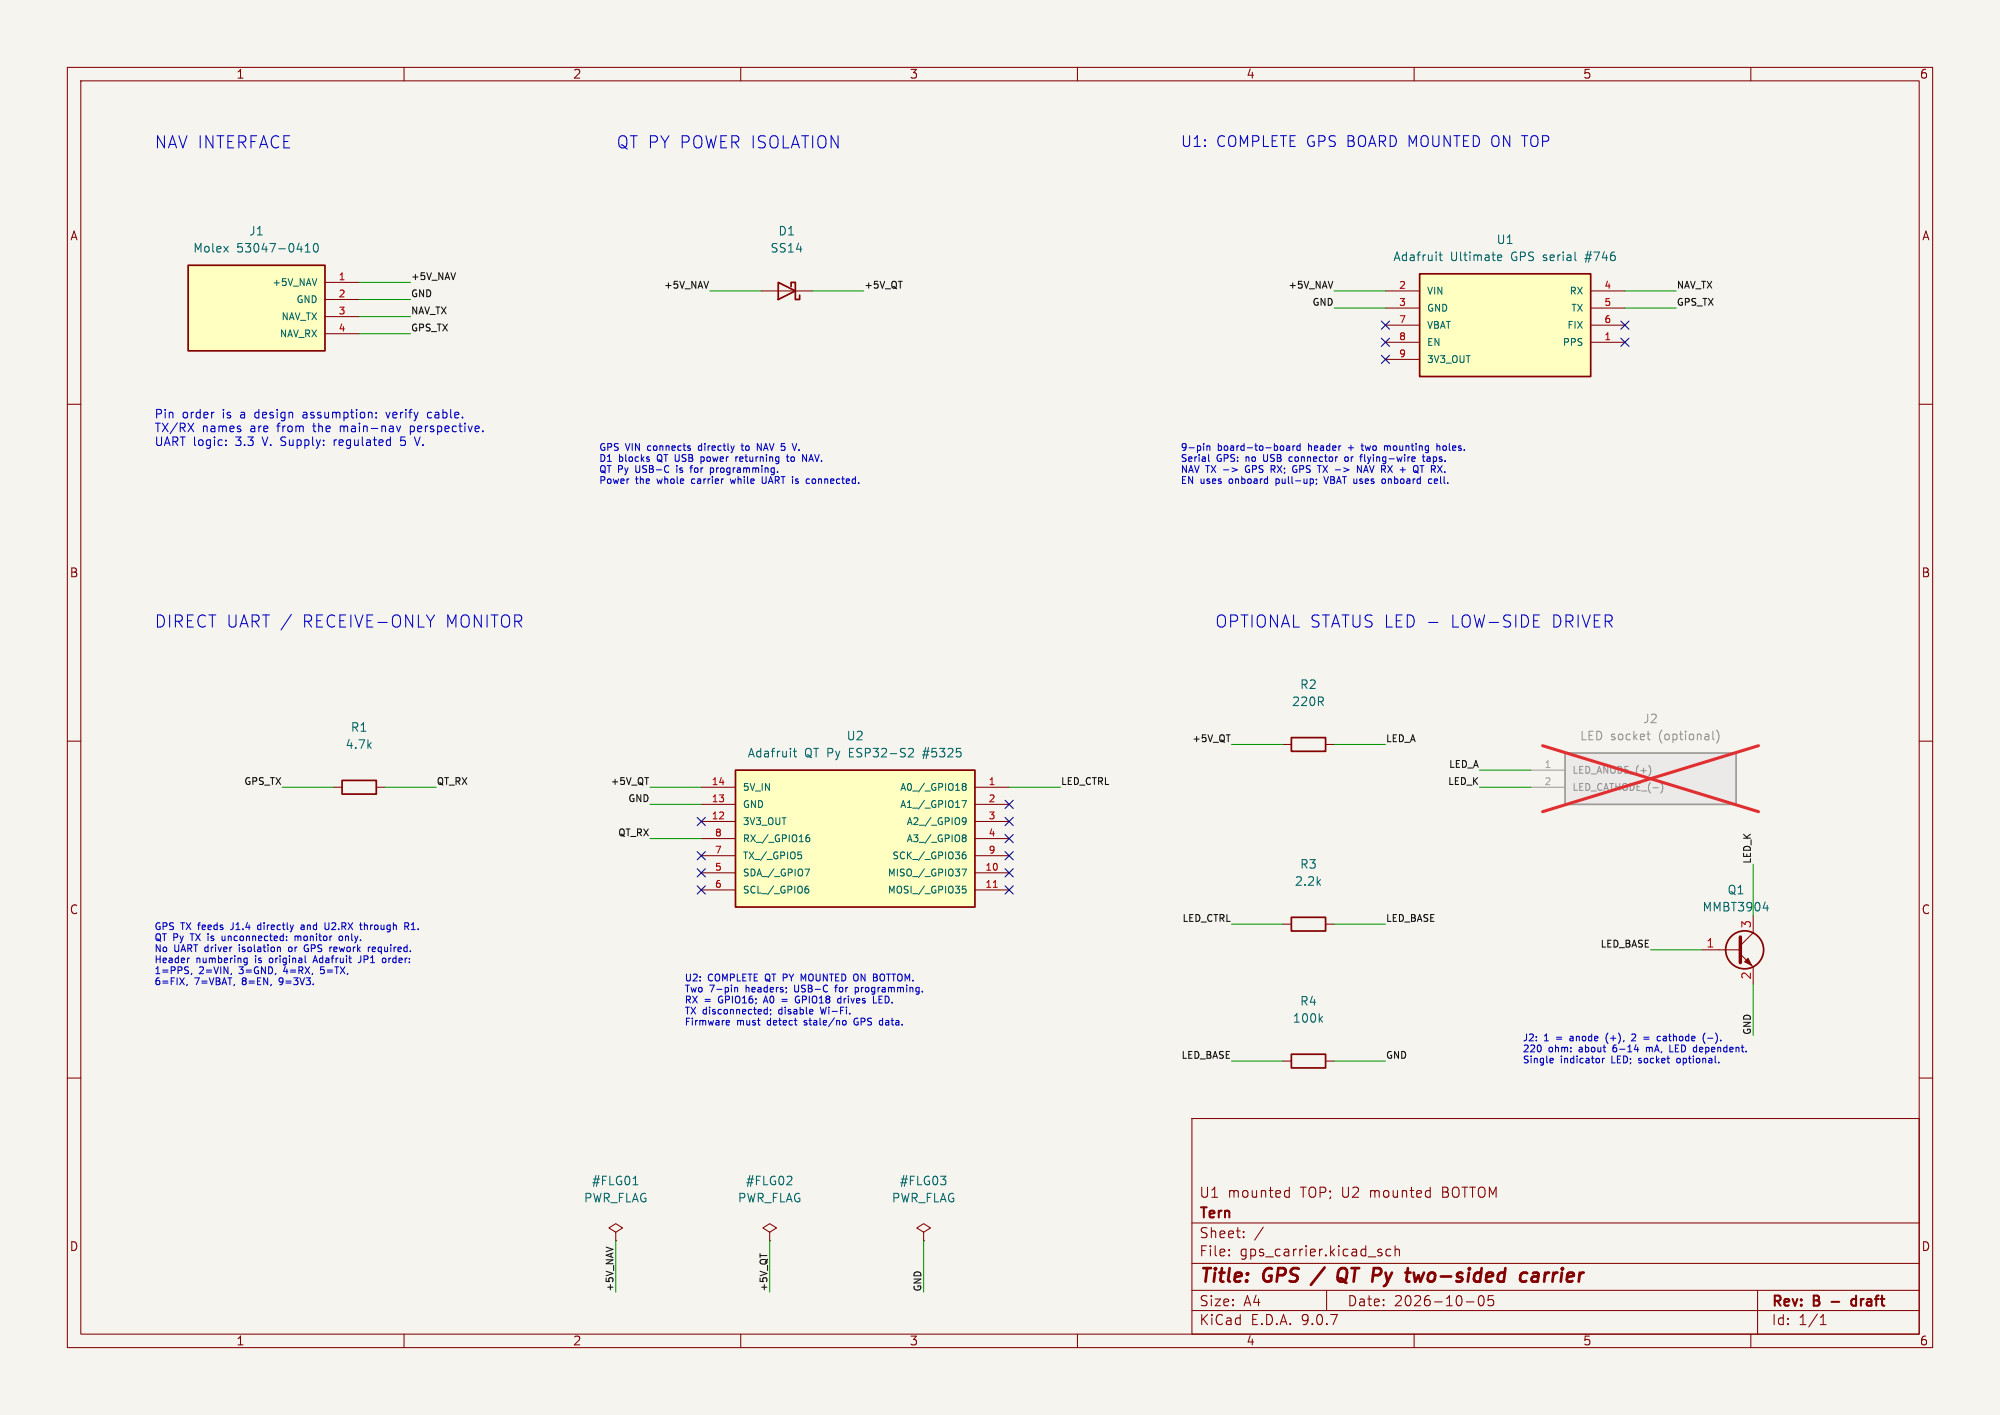
[picture p43: page 1]

U1: COMPLETE GPS BOARD MOUNTED ON TOP
