djmcmath/dpv-nav/hardware/schematic/gps_board/preview/placement.pdf

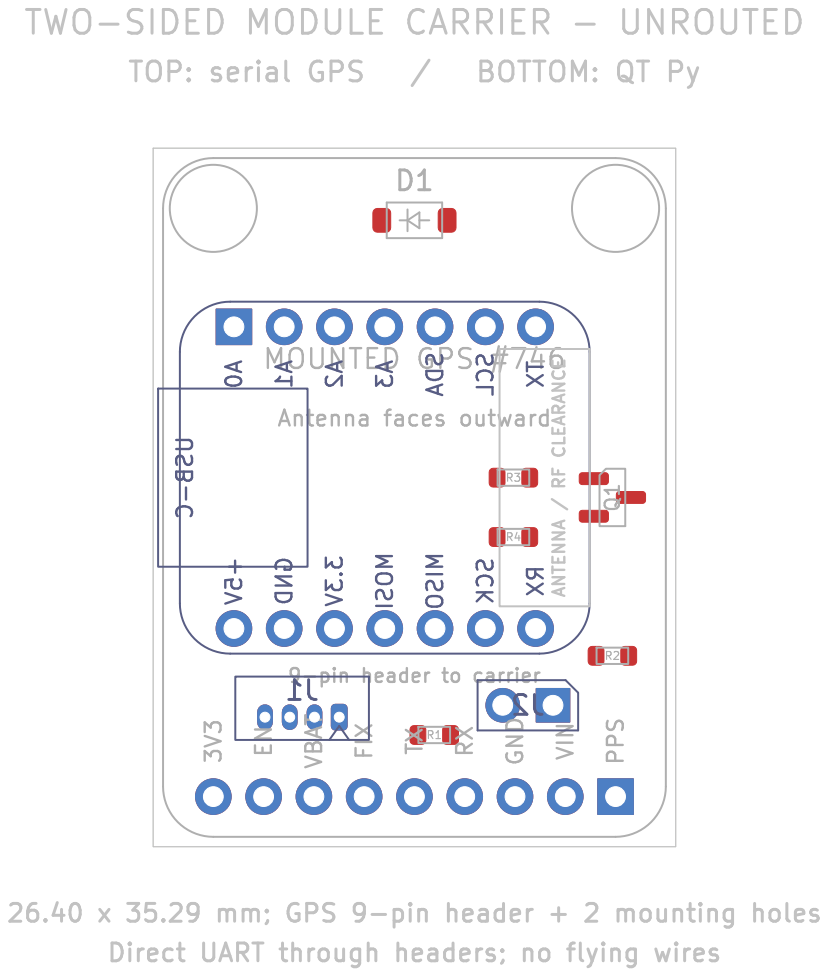
[picture p44: page 1]
