djmcmath/dpv-nav/hardware/schematic/nav_board/nav_board/nav_board.kicad_pcb

## KiCad design hardware/schematic/nav_board/nav_board/nav_board.kicad_pcb (2026-11-09)

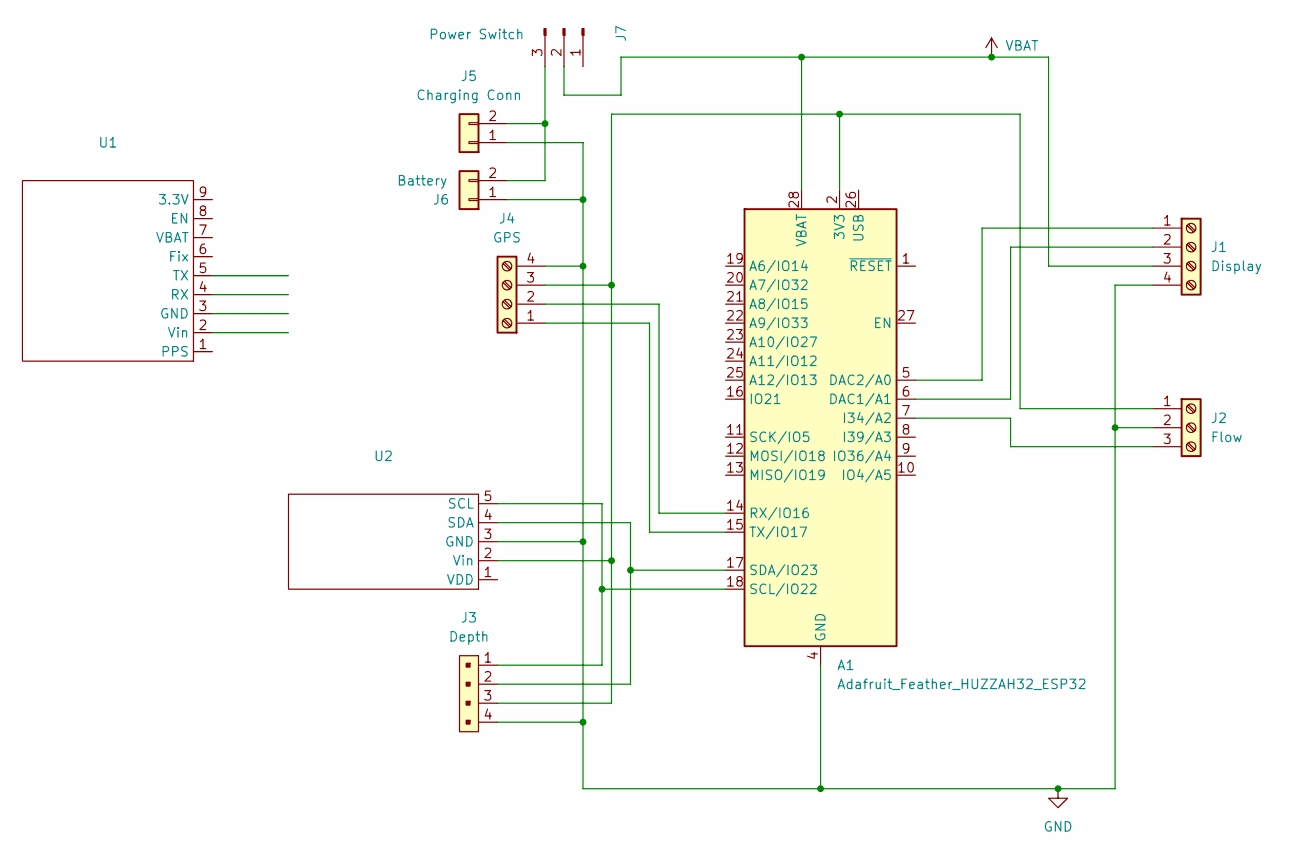
[picture p45: schematic nav_board.kicad_sch]

Parts:
A1: Adafruit_Feather_HUZZAH32_ESP32; Adafruit_Feather
J1: Display; Molex_PicoBlade_53047-0410_1x04_P1.25mm_Vertical
J2: Flow; Molex_PicoBlade_53047-0310_1x03_P1.25mm_Vertical
J3: Depth; Molex_PicoBlade_53047-0410_1x04_P1.25mm_Vertical; MPN B4B-XH-A(LF)(SN); Digi-Key_PN 455-2249-ND
J4: GPS; Molex_PicoBlade_53047-0410_1x04_P1.25mm_Vertical
J5: Charging Conn; PinHeader_1x02_P2.54mm_Vertical
J6: Battery; AMASS_XT30U-F_1x02_P5.0mm_Vertical
J7: Power Switch; PinHeader_1x03_P2.54mm_Vertical
U1: Adafruit Ultimate GPS
U2: Pololu Altimu-10 v5

Connections:
GND: A1.4 (GND), J1.4, J2.2, J3.4, J4.4, J5.1, J6.1, U2.3 (GND)
unnamed: A1.2 (3V3), J2.1, J3.3, J4.3, U2.2 (Vin)
unnamed: A1.6 (DAC1/A1), J1.2
unnamed: A1.5 (DAC2/A0), J1.1
unnamed: A1.7 (I34/A2), J2.3
unnamed: A1.14 (RX/IO16), J4.2
unnamed: A1.18 (SCL/IO22), J3.1, U2.5 (SCL)
unnamed: A1.17 (SDA/IO23), J3.2, U2.4 (SDA)
unnamed: A1.15 (TX/IO17), J4.1
unnamed: J5.2, J6.2, J7.3
VBAT: A1.28 (VBAT), J1.3, J7.2

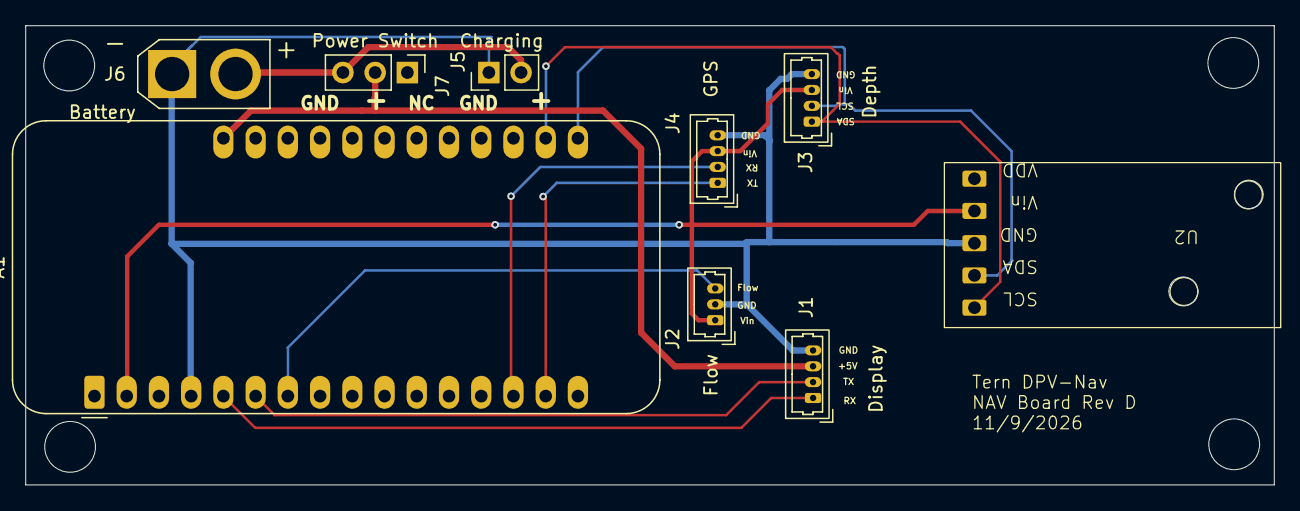
[picture p46: board nav_board.kicad_pcb from above]

Board: 2 copper layers, 98.4 x 36.2 mm, 9 parts (0 on the bottom side), 11 nets.
