djmcmath/dpv-nav/hardware/schematic/gps_board/gps_carrier.kicad_pcb

## KiCad design hardware/schematic/gps_board/gps_carrier.kicad_pcb (2026-10-09)

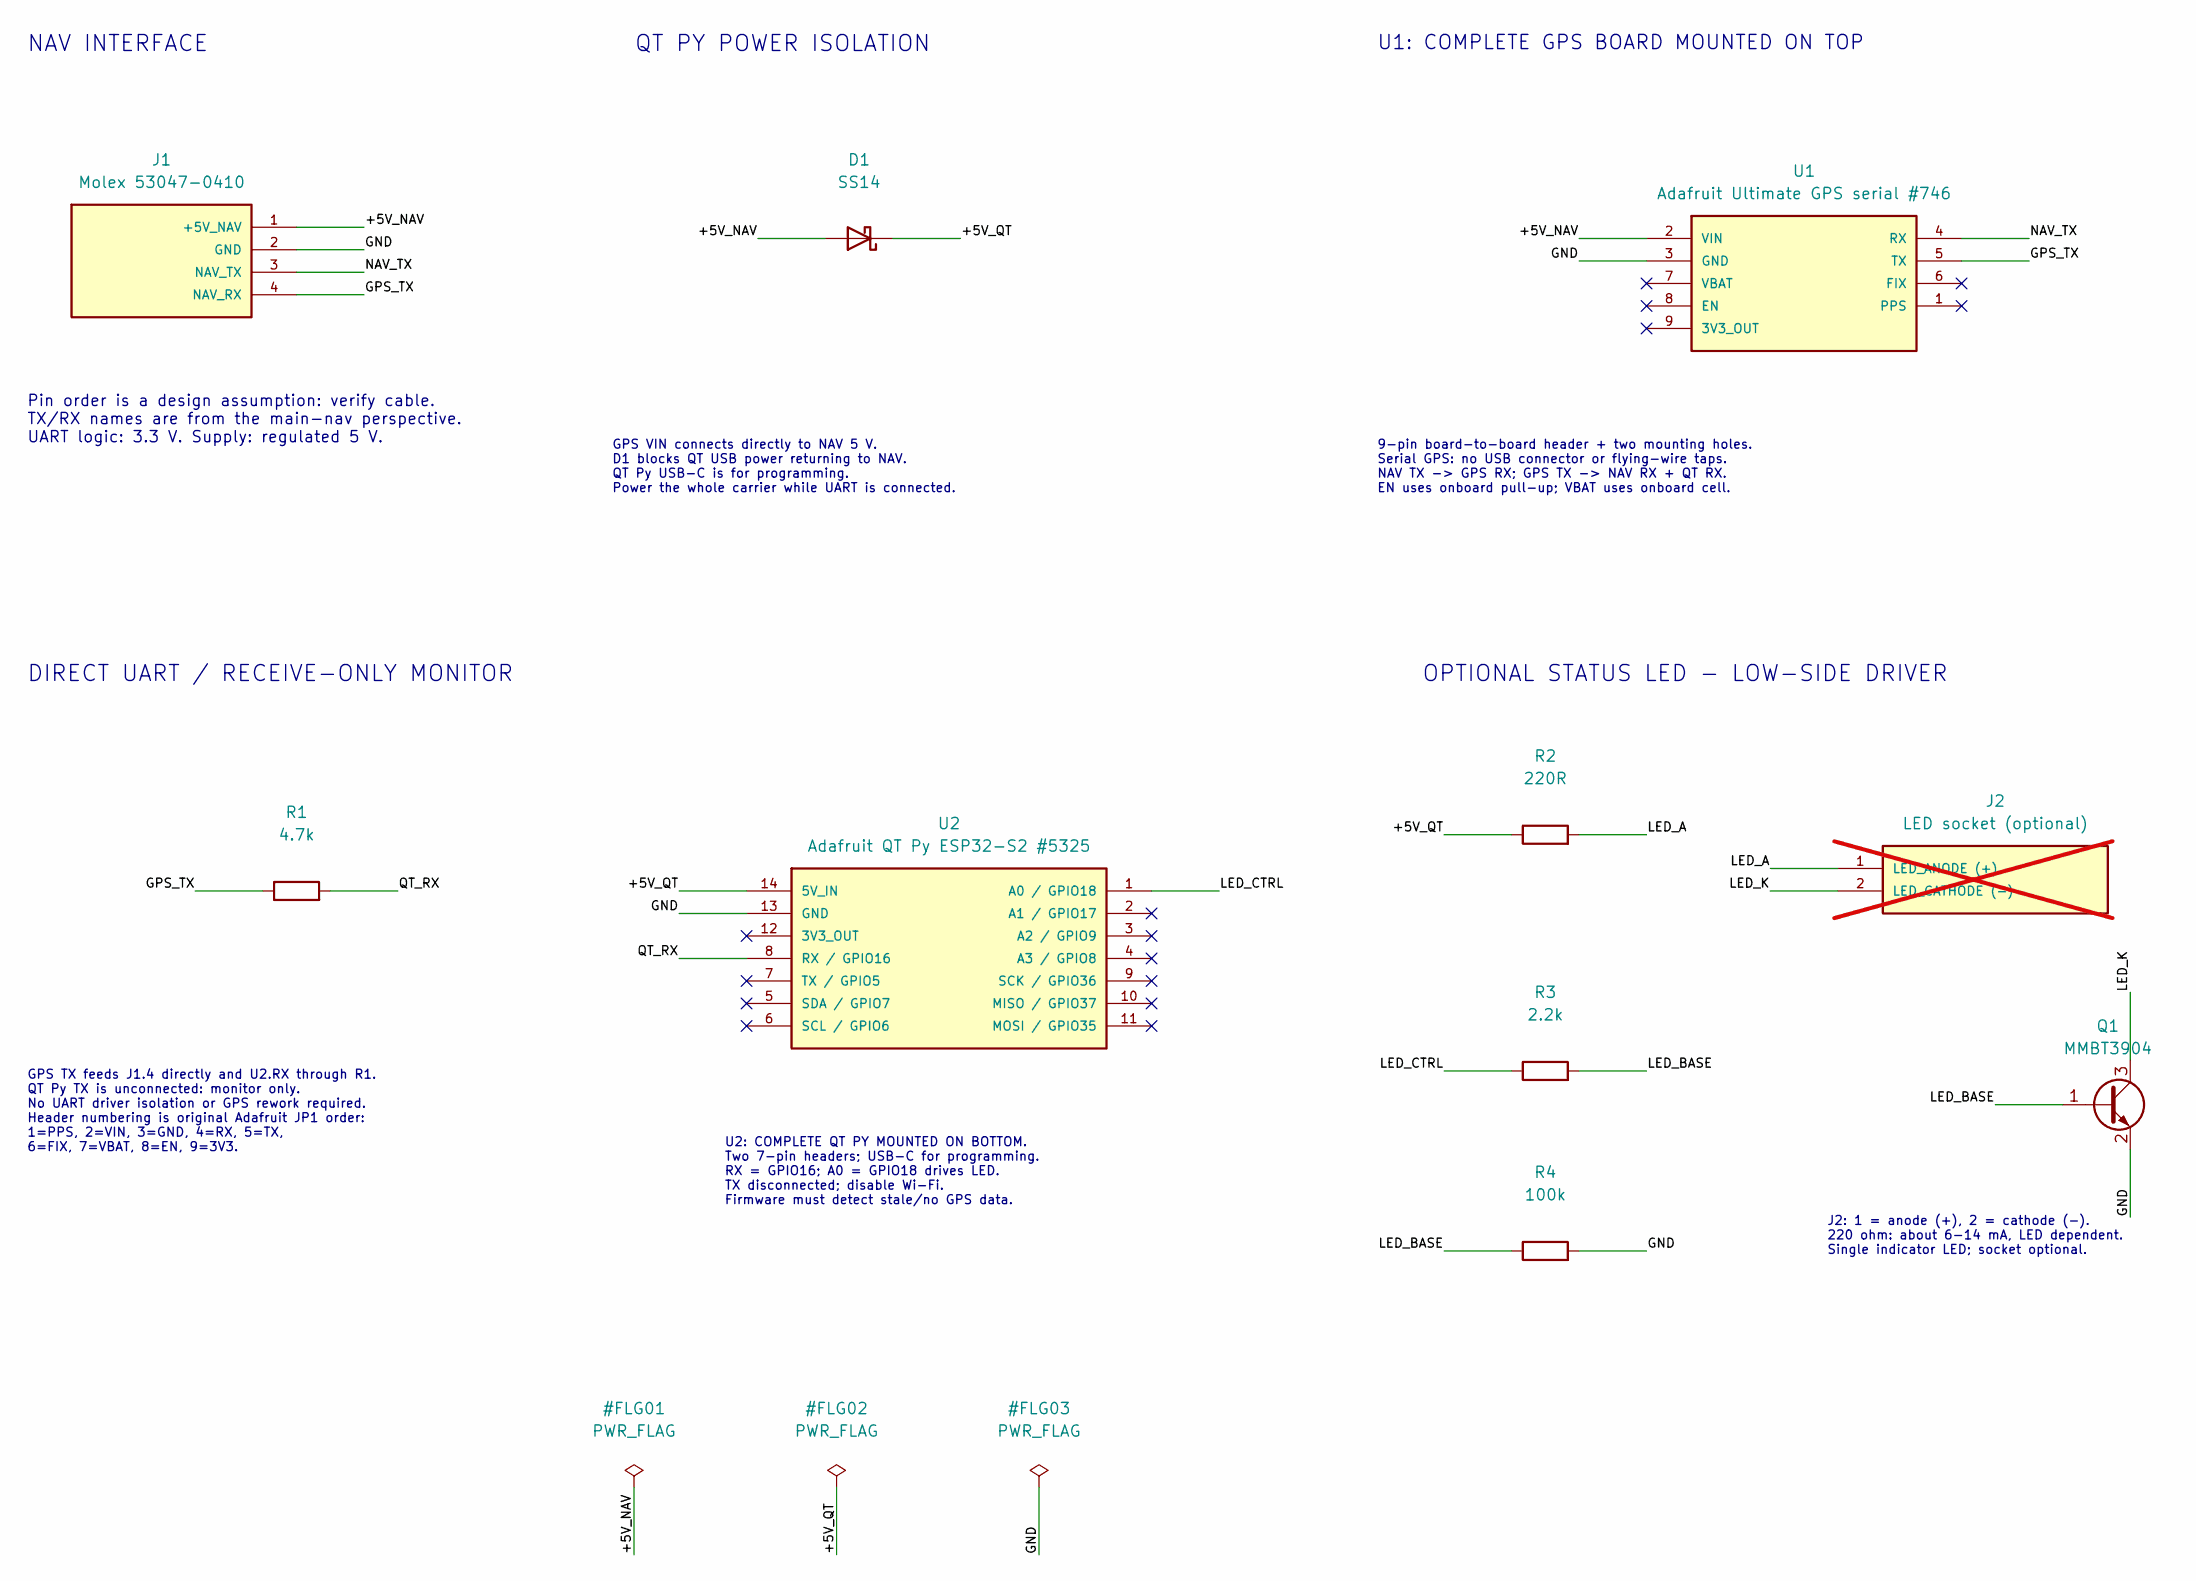
[picture p47: schematic gps_carrier.kicad_sch, GPS / QT Py two-sided carrier]

Parts:
D1: SS14; D_SOD-123
J1: Molex 53047-0410; Molex_PicoBlade_53047-0410_1x04_P1.25mm_Vertical
J2: LED socket (optional); PinSocket_1x02_P2.54mm_Vertical; not fitted
Q1: MMBT3904; SOT-23
R1: 4.7k; R_0603_1608Metric
R2: 220R; R_0603_1608Metric
R3: 2.2k; R_0603_1608Metric
R4: 100k; R_0603_1608Metric
U1: Adafruit Ultimate GPS serial #746; Adafruit_Ultimate_GPS_Serial_746_THT_Raised
U2: Adafruit QT Py ESP32-S2 #5325; Adafruit_QT_Py_ESP32_S2_THT

Connections:
/+5V_NAV: D1.2 (A), J1.1 (+5V_NAV), U1.2 (VIN)
/+5V_QT: D1.1 (K), R2.1, U2.14 (5V_IN)
/GND: J1.2 (GND), Q1.2 (E), R4.2, U1.3 (GND), U2.13 (GND)
/GPS_TX: J1.4 (NAV_RX), R1.1, U1.5 (TX)
/LED_A: J2.1 (LED_ANODE (+)), R2.2
/LED_BASE: Q1.1 (B), R3.2, R4.1
/LED_CTRL: R3.1, U2.1 (A0 / GPIO18)
/LED_K: J2.2 (LED_CATHODE (-)), Q1.3 (C)
/NAV_TX: J1.3 (NAV_TX), U1.4 (RX)
/QT_RX: R1.2, U2.8 (RX / GPIO16)

Notes on the sheet:
NAV INTERFACE
Pin order is a design assumption: verify cable. TX/RX names are from the main-nav perspective. UART logic: 3.3 V. Supply: regulated 5 V.
QT PY POWER ISOLATION
GPS VIN connects directly to NAV 5 V. D1 blocks QT USB power returning to NAV. QT Py USB-C is for programming. Power the whole carrier while UART is connected.
U1: COMPLETE GPS BOARD MOUNTED ON TOP
9-pin board-to-board header + two mounting holes. Serial GPS: no USB connector or flying-wire taps. NAV TX -> GPS RX; GPS TX -> NAV RX + QT RX. EN uses onboard pull-up; VBAT uses onboard cell.
DIRECT UART / RECEIVE-ONLY MONITOR
GPS TX feeds J1.4 directly and U2.RX through R1. QT Py TX is unconnected: monitor only. No UART driver isolation or GPS rework required. Header numbering is original Adafruit JP1 order: 1=PPS, 2=VIN, 3=GND, 4=RX, 5=TX, 6=FIX, 7=VBAT, 8=EN, 9=3V3.
U2: COMPLETE QT PY MOUNTED ON BOTTOM. Two 7-pin headers; USB-C for programming. RX = GPIO16; A0 = GPIO18 drives LED. TX disconnected; disable Wi-Fi. Firmware must detect stale/no GPS data.
OPTIONAL STATUS LED - LOW-SIDE DRIVER
J2: 1 = anode (+), 2 = cathode (-). 220 ohm: about 6-14 mA, LED dependent. Single indicator LED; socket optional.

Board: 2 copper layers, 10 parts (3 on the bottom side), 10 nets, no tracks yet.
