djmcmath/dpv-nav/hardware/schematic/display_board/display_board_gopro_housing.kicad_pcb

## KiCad design hardware/schematic/display_board/display_board_gopro_housing.kicad_pcb (2026-09-09)

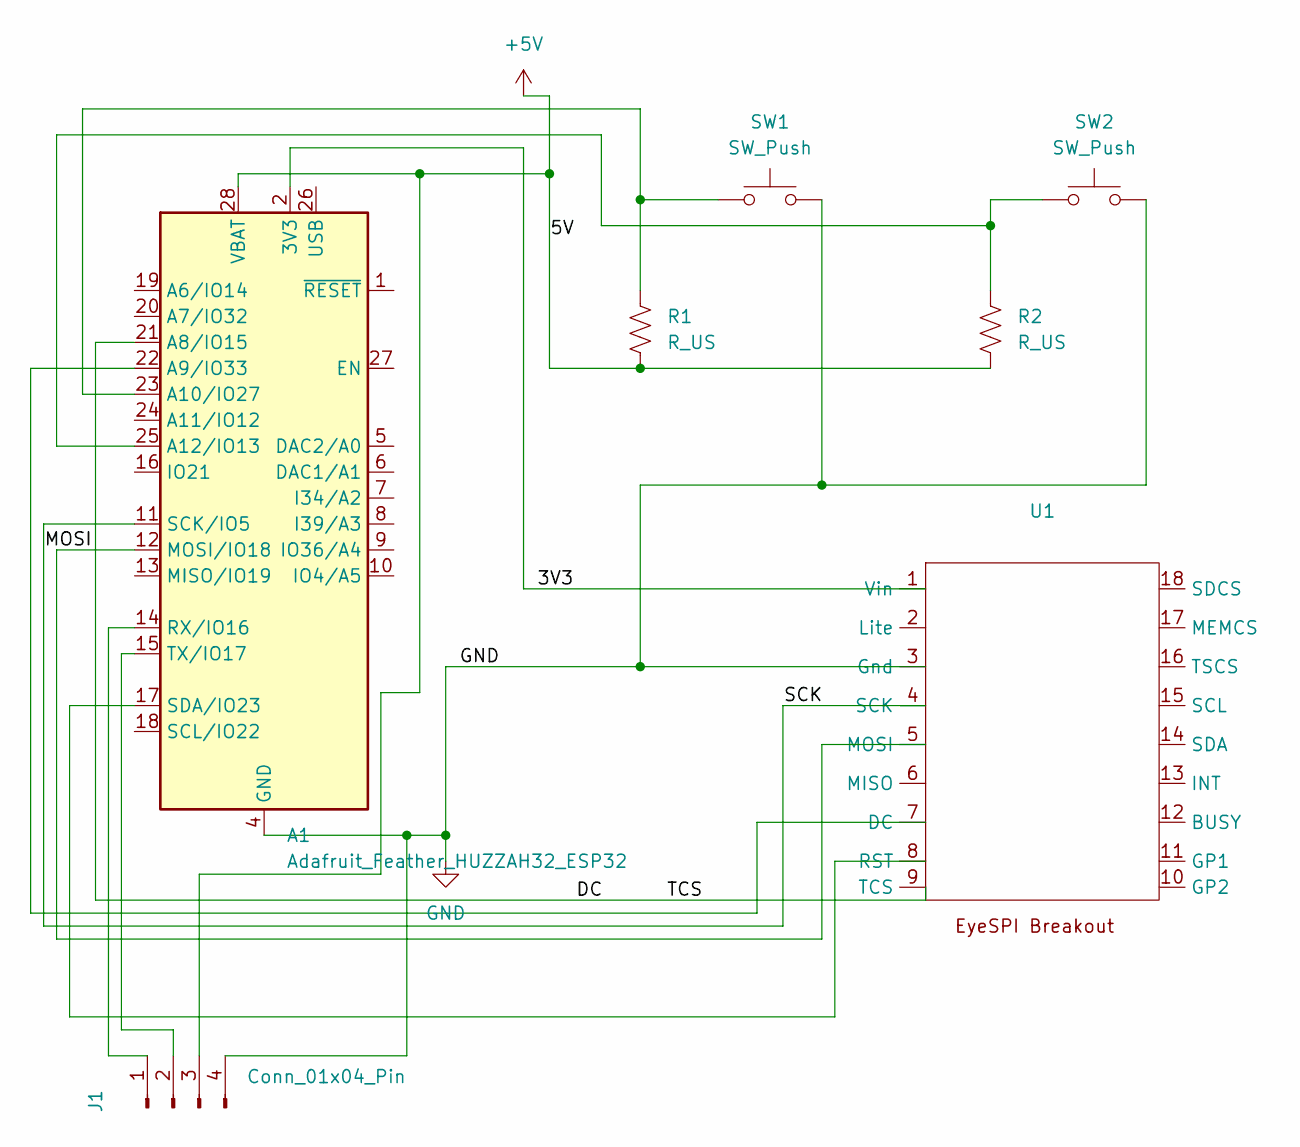
[picture p48: schematic display_board_gopro_housing.kicad_sch]

Parts:
A1: Adafruit_Feather_HUZZAH32_ESP32; Adafruit_Feather
J1: Conn_01x04_Pin; Molex_PicoBlade_53047-0410_1x04_P1.25mm_Vertical
R1, R2: R_US; R_Axial_DIN0207_L6.3mm_D2.5mm_P7.62mm_Horizontal
SW1, SW2: SW_Push; Molex_PicoBlade_53047-0210_1x02_P1.25mm_Vertical
U1: EyeSPI_Breakout

Connections:
+5V: A1.28 (VBAT), J1.3, R1.2, R2.2
/3V3: A1.2 (3V3), U1.1 (Vin)
/DC: A1.21 (A8/IO15), U1.9 (TCS)
/MOSI: A1.11 (SCK/IO5), U1.4 (SCK)
GND: A1.4 (GND), J1.4, SW1.2, SW2.2, U1.3 (Gnd)
unnamed: A1.22 (A9/IO33), U1.7 (DC)
unnamed: A1.23 (A10/IO27), R1.1, SW1.1
unnamed: A1.25 (A12/IO13), R2.1, SW2.1
unnamed: A1.12 (MOSI/IO18), U1.5 (MOSI)
unnamed: A1.14 (RX/IO16), J1.1
unnamed: A1.17 (SDA/IO23), U1.8 (RST)
unnamed: A1.15 (TX/IO17), J1.2

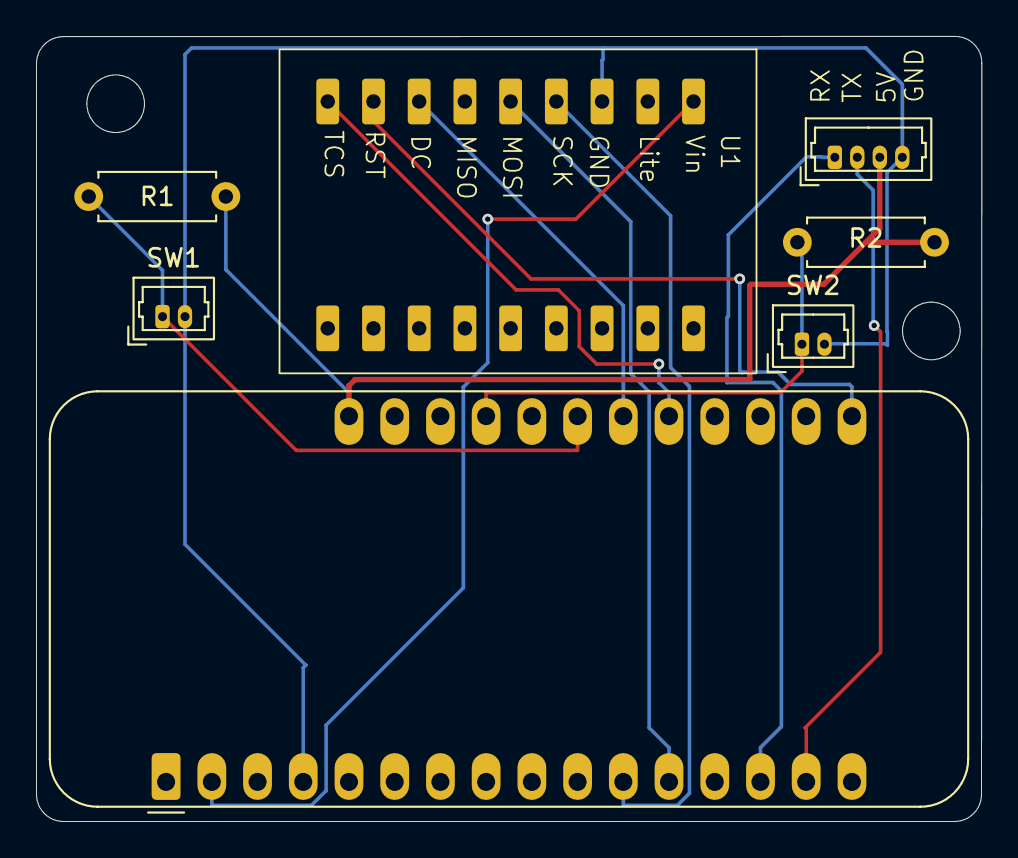
[picture p49: board display_board_gopro_housing.kicad_pcb from above]

Board: 2 copper layers, 52.5 x 43.6 mm, 7 parts (0 on the bottom side), 12 nets.
