djmcmath/dpv-nav/src/nav_main.cpp

// nav_main.cpp — Nav device entry point
// Sensors, AHRS, GPS, flow sensor, dead reckoning.
// Sends NavPacket to display device over Serial1 at ~10 Hz.

#include <Arduino.h>
#include <Wire.h>
#include <LittleFS.h>
#include <time.h>
#include <esp_sleep.h>

#include "board_pins.h"
#include "config.h"
#include "types/types.h"
#include "sensors/imu.h"
#include "sensors/calib.h"
#include "sensors/depth.h"
#include "math/mahony.h"
#include "math/orientation.h"
#include "drivers/flow_sensor.h"
#include "drivers/gps.h"
#include "drivers/i2c_bus.h"
#include "util/storage.h"
#include "util/logging.h"
#include "nav/state.h"
#include "nav/nav_model.h"
#include "net/wifi_manager.h"
#include "net/web_server.h"
#include "net/cloud_client.h"
#include "net/cal_sync.h"
#include "net/ota.h"
#include "net/log_sync.h"
#include "nav_main.h"
#include "util/serial_commands.h"
#include "util/mag_cal_collect.h"
#include "util/nvs_state.h"
#include "util/boot_log.h"
#include "util/speed_cal.h"
#include "util/hdg_cal.h"
#include "util/level_gate.h"
#include "util/waypoints.h"
#include "util/motor_cal.h"
#include "util/mag_temp.h"
#include "util/ota_confirm.h"
#include "util/status_led.h"
#include "version.h"
#include <dpvlink.h>

// Default loopTask stack (~8 KB) isn't enough once cloud::updateAuthorizePoll()
// is in the call chain: WiFiClientSecure's TLS handshake is stack-hungry, and
// unlike beginAuthorize() (called from a shallow command-handler stack frame),
// updateAuthorizePoll() runs from deep inside loop() itself, on top of all its
// other locals -- that combination tripped the stack canary and rebooted the
// board mid-poll (see docs/architecture/device-uploads-plan.md).
SET_LOOP_TASK_STACK_SIZE(16 * 1024);

// ---- AHRS state -----------------------------------------------------------
static MahonyState ahrs;
//kp: 0.5 to 2.0 is a reasonable range.  Higher: mag/accel corrections dominate faster, with less gyro drift.  Lower: gyro dominates longer, with more drift but smoother response.  
//ki: 0.0 to 0.1 -- builds up long term gyro bias estimate, correcting for drift.  Too high -- windup and oscillation.  
static MahonyParams mahonyParams{ .kp = 1.0f, .ki = 0.002f, .useMag = true };

// ---- Calibration data -----------------------------------------------------
static MagCalib         magCal;
static Calib3           gyroCal;
static Calib3           accelCal;

// Print the calibration currently driving the AHRS. Values are printed with
// %f rather than a fixed precision precisely so inf and nan show up as "inf"
// and "nan" -- those two spellings are what a poisoned cal file contains, and
// what saveCalib3()/atof() round-trip through flash.
static void dumpActiveCalibration(const char* tag) {
    Serial.printf("[%s] accel bias=(%f, %f, %f) scale=(%f, %f, %f)\n", tag,
                  (double)accelCal.bias.x,  (double)accelCal.bias.y,  (double)accelCal.bias.z,
                  (double)accelCal.scale.x, (double)accelCal.scale.y, (double)accelCal.scale.z);
    Serial.printf("[%s] gyro  bias=(%f, %f, %f) scale=(%f, %f, %f)\n", tag,
                  (double)gyroCal.bias.x,  (double)gyroCal.bias.y,  (double)gyroCal.bias.z,
                  (double)gyroCal.scale.x, (double)gyroCal.scale.y, (double)gyroCal.scale.z);
    Serial.printf("[%s] mag   bias=(%f, %f, %f)\n", tag,
                  (double)magCal.bias.x, (double)magCal.bias.y, (double)magCal.bias.z);
    for (int i = 0; i < 3; i++) {
        Serial.printf("[%s] mag   softIron[%d] = [%f, %f, %f]\n", tag, i,
                      (double)magCal.softIron[i][0],
                      (double)magCal.softIron[i][1],
                      (double)magCal.softIron[i][2]);
    }
    Serial.printf("[%s] mag   temp comp=%s\n", tag,
                  imu::magTempCompensationActive() ? "on" : "off");
}
static hdg_cal::HdgCal  gHdgCal;
static bool             gHdgCalValid = false;
static motor_cal::MotorCal gMotorCal;

// Load /mag_temp.json and hand it to the IMU, or turn compensation off. Shared
// by boot and reload so an invalid or deleted file can never leave the previous
// coefficients running.
static void loadMagTempCompensation(const char* tag) {
    mag_temp::MagTempCal mt;
    switch (mag_temp::load(mt)) {
        case mag_temp::LoadResult::Ok:
            imu::setMagTempCompensation(mt.coeff_uT_per_c, mt.ref_temp_c);
            Serial.printf("[%s] Mag temp comp loaded: (%.3f, %.3f, %.3f) uT/C, ref %.1f C\n", tag,
                          (double)mt.coeff_uT_per_c.x, (double)mt.coeff_uT_per_c.y,
                          (double)mt.coeff_uT_per_c.z, (double)mt.ref_temp_c);
            break;
        case mag_temp::LoadResult::Absent:
            imu::clearMagTempCompensation();
            Serial.printf("[%s] No mag temp comp file -- uncompensated\n", tag);
            break;
        case mag_temp::LoadResult::Invalid:
            imu::clearMagTempCompensation();
            Serial.printf("[%s] %s INVALID (missing field, non-finite, or out of range) -- "
                          "uncompensated\n", tag, mag_temp::FILE_PATH);
            break;
    }
}

// Fourier heading cal sample collection (filled during CAPTURE_HDG_POINT commands)
static constexpr int HDG_SAMPLE_MAX = 24;
static float gHdgSamplesTarget[HDG_SAMPLE_MAX];
static float gHdgSamplesIndicated[HDG_SAMPLE_MAX];
// Mag die temperature at each capture (NAN if never read) and whether thermal
// compensation was on, so a heading cal's thermal state is on record too.
static float gHdgSamplesMagTempC[HDG_SAMPLE_MAX];
static bool  gHdgSamplesTcomp[HDG_SAMPLE_MAX];
// Attitude at each capture, from the level gate: accel-only pitch/roll, the
// stillness motion figure (CAL_MOTION_AT_LIMIT = on the limit) and the gate
// state. Recorded whether or not HDG_CAL_LEVEL_GATE enforced it, so a run can
// show whether attitude moved the heading error.
static float   gHdgSamplesPitch[HDG_SAMPLE_MAX];
static float   gHdgSamplesRoll[HDG_SAMPLE_MAX];
static uint8_t gHdgSamplesMotion[HDG_SAMPLE_MAX];
static uint8_t gHdgSamplesLevel[HDG_SAMPLE_MAX];
static int   gHdgSampleCount = 0;
// True from START_HDG_FOURIER_CAL to FINALIZE_HDG_CAL: the level gate runs and
// its state goes out in every NavPacket.
static bool  gHdgCalActive = false;
static level_gate::Gate gLevelGate;
static float gCurrentHeadingRawDeg = 0.0f;  // updated each loop; read by CAPTURE handler

// ---- Nav state -------------------------------------------------------------
static SystemState sysState = SystemState::BOOT;
static uint32_t lastLoopUs    = 0;
static uint32_t lastSendMs    = 0;
static uint32_t lastDiagMs    = 0;
static uint32_t lastPosSaveMs = 0;
static uint32_t lastFlowLogMs = 0;
static uint32_t lastWpSendMs  = 0;
static uint32_t lastWpSaveMs  = 0;
static uint16_t gBattMv       = 0;  // EMA-smoothed battery voltage (mV), 0 = not yet read
static constexpr uint32_t SEND_INTERVAL_MS     = 100;   // 10 Hz link rate
static constexpr uint32_t LOOP_INTERVAL_US     = 10000; // 100 Hz loop rate gate
static constexpr uint32_t DIAG_INTERVAL_MS     = 1000;  // 1 Hz sensor diagnostics
static constexpr uint32_t FLOW_LOG_INTERVAL_MS = 250;   // 4 Hz flow debug logging
static constexpr bool FULL_DIAG_ENABLE    = false;  // set to false to disable periodic diagnostic prints
static constexpr bool GPS_DIAG_ENABLE     = false;   // GPS position/speed/COG coherence diagnostics
static constexpr bool GPS_RAW_NMEA_ENABLE = false;  // print every raw NMEA sentence (noisy — use to confirm PGTOP)
static constexpr bool FLOW_LOG_ENABLE     = false;  // set to false to disable flow debug logging

// ---- Calibration mode tracking -----------------------------------------------
// cal_mode in NavPacket:
//   0 = (legacy) quick mag cal hard-iron
//   1 = (legacy) full mag cal soft-iron collection
//   2 = speed cal — waiting for flow
//   3 = speed cal — run in progress
//   4 = speed cal — result ready, awaiting display accept/reject
//   5 = baseline mag cal (bin-aware)
//   6 = mounted mag cal (bin-aware)
//   7 = gap-fill mag cal (bin-aware)
//   8/9 = current hold
static bool    gInCal    = false;
static uint8_t gCalMode  = 0;

// Bin-aware cal: interval tracking for CalProgressPacket (2 Hz)
static constexpr uint32_t CAL_PROGRESS_INTERVAL_MS = 500;
static uint32_t gLastCalProgressMs = 0;

// ...and for CalOrientPacket, the attitude-only subset, at 10 Hz. The grid
// packet cannot go faster: it carries 60 counts plus the packed target map
// (~350 bytes) and the link is 115200 baud. But 2 Hz is far too slow for a
// diver steering toward a highlighted cell by hand -- each frame is one
// unfiltered instantaneous sample, so while the unit is moving the highlight
// lands somewhere effectively random inside the motion envelope, which is
// what makes the grid feel like it jumps. 78 bytes at 10 Hz costs ~0.8 kB/s
// of the ~11.5 kB/s link, on top of NavPacket's ~2.5 kB/s.
static constexpr uint32_t CAL_ORIENT_INTERVAL_MS = 100;
static uint32_t gLastCalOrientMs = 0;

// CSV output file path for active bin cal (set when cal starts)
static const char* gBinCalCsvPath = nullptr;

// Cloud calibration (docs/cloud-calibration-plan.md): the most recent
// upload's result, pending the diver's accept/reject via the display device.
// Cleared once a response is sent. gCloudCalId empty means "nothing pending".
static char gCloudCalId[40]          = "";
static char gCloudCalPendingPath[40] = "";
static char gCloudCalActivePath[24]  = "";
static CalType gCloudCalType         = CalType::BASELINE;

// Result of runCalUploadAndNotify() -- a caller-facing summary of what a
// cloud upload+fit round trip did, independent of the CalCloudResultPacket
// wire format that round trip also emits to the display device.
struct CloudCalOutcome {
    bool    ok = false;           // fit succeeded (CalCloudStage::DONE)
    bool    offline = false;      // true if skipped for lack of WiFi (ok stays false)
    String  qualityBand;
    float   rmsPct = 0.0f;
    String  recommendation;
    String  calibrationId;
    int16_t coverageGaps = -1;
    String  error;                // set when !ok && !offline
};

// Runs a calibration-CSV upload+fit round trip and reports the outcome both
// to the display device (CalCloudResultPacket over Serial1, so its normal
// accept/reject screen can show it -- unless !installable, e.g. gap-fill,
// which is never installed on-device) and back to the caller. Shared by the
// live CAL-menu completion sites below and by retryCalibrationUpload()
// (tern.local's calibration-recovery action), so both trigger the exact same
// staging/notify behavior.
// Copy a message into a display-bound buffer. One that will not fit is cut at
// the end of its last whole sentence, or failing that its last whole word,
// instead of mid-word: the server writes a fit rejection so that its first
// sentence is the instruction and fits (callib/fit.py, DEVICE_ERROR_CHARS).
static void copyForDisplay(char* dst, size_t dstLen, const char* src) {
    if (dstLen == 0) return;
    const size_t room = dstLen - 1;
    size_t n = strlen(src);
    if (n > room) {
        size_t sentenceEnd = 0, wordEnd = 0;
        for (size_t i = 0; i < room; i++) {
            const bool atBreak = (src[i + 1] == ' ');
            if (atBreak) wordEnd = i + 1;
            if (atBreak && (src[i] == '.' || src[i] == '!' || src[i] == '?')) sentenceEnd = i + 1;
        }
        n = sentenceEnd ? sentenceEnd : wordEnd ? wordEnd : room;
    }
    memcpy(dst, src, n);
    dst[n] = '\0';
}

static CloudCalOutcome runCalUploadAndNotify(CalType calType, const char* mode,
                                              const char* csvPath, const char* pendingPath,
                                              const char* activePath, bool installable) {
    CloudCalOutcome outcome;
    CalCloudResultPacket rpkt{};
    rpkt.cal_type    = (uint8_t)calType;
    rpkt.installable = installable;

    if (!wifi::isStaConnected()) {
        rpkt.stage    = (uint8_t)CalCloudStage::OFFLINE;
        outcome.offline = true;
        outcome.error   = "No WiFi connection";
    } else {
        cloud::CalibrationResult cr = cloud::runCalibrationUpload(mode, csvPath, pendingPath);
        if (cr.ok) {
            rpkt.stage         = (uint8_t)CalCloudStage::DONE;
            rpkt.quality       = (cr.qualityBand == "good") ? (uint8_t)CalCloudQuality::GOOD
                               : (cr.qualityBand == "warn") ? (uint8_t)CalCloudQuality::WARN
                                                             : (uint8_t)CalCloudQuality::BAD;
            // One headline number per cal. For hdg that is the leave-one-out
            // worst case the band is graded on; rms_pct holds the RMS for hdg
            // (callib/hdg.py summary()), which this used to forward and the
            // display labelled "max err" -- beside a recommendation text
            // quoting the real max. -1 (older backend) renders as "--".
            const float headline = (calType == CalType::HDG) ? cr.maxErrDeg : cr.rmsPct;
            rpkt.rms_pct       = headline;
            rpkt.coverage_gaps = (int16_t)cr.coverageGaps;
            strncpy(rpkt.recommendation, cr.recommendation.c_str(), sizeof(rpkt.recommendation) - 1);
            strncpy(rpkt.calibration_id, cr.calibrationId.c_str(), sizeof(rpkt.calibration_id) - 1);

            strncpy(gCloudCalId, cr.calibrationId.c_str(), sizeof(gCloudCalId) - 1);
            gCloudCalId[sizeof(gCloudCalId) - 1] = '\0';
            gCloudCalType = calType;
            // Defense in depth, in case a mismatched display build (old
            // firmware, unaware of `installable`) ever sends
            // ACCEPT_CLOUD_CAL for a non-installable result anyway: leaving
            // these two paths empty makes ACCEPT_CLOUD_CAL's own guard
            // (`strlen(gCloudCalPendingPath) > 0`) reject it as a no-op,
            // logged, rather than act on it.
            if (installable) {
                strncpy(gCloudCalPendingPath, pendingPath, sizeof(gCloudCalPendingPath) - 1);
                gCloudCalPendingPath[sizeof(gCloudCalPendingPath) - 1] = '\0';
                strncpy(gCloudCalActivePath, activePath, sizeof(gCloudCalActivePath) - 1);
                gCloudCalActivePath[sizeof(gCloudCalActivePath) - 1] = '\0';
            } else {
                gCloudCalPendingPath[0] = '\0';
                gCloudCalActivePath[0]  = '\0';
            }

            outcome.ok             = true;
            outcome.qualityBand    = cr.qualityBand;
            outcome.rmsPct         = headline;
            outcome.recommendation = cr.recommendation;
            outcome.calibrationId  = cr.calibrationId;
            outcome.coverageGaps   = cr.coverageGaps;
        } else {
            rpkt.stage    = (uint8_t)CalCloudStage::FAILED;
            rpkt.rejected = cr.fitRejected;
            copyForDisplay(rpkt.error, sizeof(rpkt.error), cr.errorMessage.c_str());
            outcome.error = cr.errorMessage;
        }
    }

    char cloudBuf[512];
    size_t cbn = calCloudResultPacketToBytes(rpkt, cloudBuf, sizeof(cloudBuf));
    if (cbn > 0) Serial1.write(cloudBuf, cbn);

    return outcome;
}

// Calibration retry-upload (tern.local's file manager "Upload to cloud"
// action for a raw sample CSV already sitting on LittleFS -- typically one
// whose automatic upload failed at collection time). Runs the identical
// upload+fit+notify flow a live CAL-menu run performs, just triggered later
// and from a different call site. Exposed via nav_main.h so
// net/web_server.cpp's handler can call it without reaching into the
// private cal-tracking globals above.
CalRetryResult retryCalibrationUpload(const char* filename) {
    CalRetryResult result;
    String name = filename ? String(filename) : String();

    // Must not run concurrently with a live CAL-menu collection -- both
    // paths write the same gCloudCal*/gInCal-adjacent state.
    if (gInCal || sysState == SystemState::CALIBRATION) {
        result.error = "A calibration is already in progress on this unit";
        return result;
    }
    if (!wifi::isStaConnected()) {
        result.error = "No WiFi connection";
        return result;
    }

    struct Entry {
        const char* file;
        CalType     calType;
        const char* mode;
        const char* pendingPath;
        const char* activePath;
        bool        installable;
    };
    // Gap-fill CSVs upload/fit as mode "baseline" (same as a real baseline
    // collection -- see the comment at the baseline/mounted call site below)
    // but are never installable: their fit only ever becomes a merge
    // candidate on the Dive Map website.
    const Entry kEntries[] = {
        { "/mag_baseline_samples.csv", CalType::BASELINE, "baseline",
          "/mag_base_pending.json", storage::MAG_BASE_FILE, true },
        { "/mag_mounted_samples.csv", CalType::MOUNTED, "mounted",
          "/mag_mount_pending.json", storage::MAG_MOUNT_FILE, true },
        { "/mag_gapfill_samples.csv", CalType::BASELINE, "baseline",
          "/mag_base_pending.json", storage::MAG_BASE_FILE, false },
        { hdg_cal::SAMPLES_FILE_PATH, CalType::HDG, "hdg",
          "/hdg_fourier_pending.json", hdg_cal::FILE_PATH, true },
    };

    const Entry* match = nullptr;
    for (const auto& e : kEntries) {
        if (name == e.file) { match = &e; break; }
    }
    if (!match) {
        result.error = "Not a recoverable calibration file";
        return result;
    }
    if (!LittleFS.exists(match->file)) {
        result.error = "File not found";
        return result;
    }

    CloudCalOutcome outcome = runCalUploadAndNotify(match->calType, match->mode, match->file,
                                                     match->pendingPath, match->activePath,
                                                     match->installable);
    result.ok              = outcome.ok;
    result.installable      = match->installable;
    result.qualityBand      = outcome.qualityBand;
    result.rmsPct           = outcome.rmsPct;
    result.recommendation   = outcome.recommendation;
    result.calibrationId    = outcome.calibrationId;
    result.error            = outcome.error;
    return result;
}

// ---- Speed calibration state ------------------------------------------------
static uint16_t gSpeedCalDist_ft     = 300;    // target distance selected by user
static uint32_t gSpeedCalStartMs     = 0;      // millis() when run started

// ---- Current hold state ---------------------------------------------------
// The diver holds station pointing upstream; the flow sensor then reads the
// water going past rather than the scooter going through it. Averaged over the
// hold, that IS the current -- the only measurement of it available at depth,
// where there is no GPS to difference and no bottom fix to drift between.
//
// Samples go into one-second bins rather than a single running sum, so the
// finish can trim the ends: the first seconds while the diver is still settling,
// and the last ones where a cancel press knocks them off station. A cancelled
// hold is finished, not discarded -- whatever was held is still a measurement.
static constexpr uint32_t CURRENT_HOLD_DURATION_MS = 60000;
static constexpr uint8_t  CURRENT_HOLD_BINS        = CURRENT_HOLD_DURATION_MS / 1000;
// An edge second is trimmed when its mean flow sits further than this from the
// hold's median, or 3 robust sigmas (1.4826 * MAD) if that is wider. The floor
// stops a very steady hold from trimming seconds over sensor noise.
static constexpr float    CURRENT_TRIM_MIN_DEV_MS  = 0.05f;   // 3 m/min
static constexpr const char* CURRENT_FILE_PATH     = "/currents.csv";
static constexpr const char* CURRENT_FILE_OLD_PATH = "/currents.old.csv";
static constexpr size_t   CURRENT_FILE_MAX_BYTES   = 64 * 1024;  // then rotated to .old
struct CurrentHoldBin {
    double   flowSum;
    double   sinSum;    // circular mean of heading
    double   cosSum;
    uint16_t n;
};
static bool           gCurrentHoldActive   = false;  // also suppresses DR — see the gate below
static uint32_t       gCurrentHoldStartMs  = 0;
static CurrentHoldBin gCurrentHoldBins[CURRENT_HOLD_BINS];
static float          gCurrentHoldResultMs = 0.0f;
static float          gCurrentHoldToward   = 0.0f;
static uint8_t        gCurrentHoldKeptS    = 0;      // seconds averaged after trimming; 0 = no data
static uint32_t gSpeedCalPulseTotal  = 0;      // pulses accumulated during run
static float    gSpeedCalHdgSinEMA   = 0.0f;
static float    gSpeedCalHdgCosEMA   = 0.0f;
static bool     gSpeedCalHdgPrimed   = false;
// Result values — populated when run ends, sent until display acknowledges
static float    gSpeedCalKExisting   = 0.0f;
static float    gSpeedCalKProposed   = 0.0f;
static uint16_t gSpeedCalElapsedS    = 0;

// ---- Boot status flags (set during setup, sent in every NavPacket) ---------
static uint8_t gBootFlags = 0;

// Set true the instant a DisplayCmd::LINK_HELLO arrives, proving the
// display->nav direction of Serial1 is alive (see boot self-test in setup()).
static bool gDisplayLinkAckReceived = false;

// FW_VERSION the display reported in its LINK_HELLO. Empty = no reply yet, or
// a pre-OTA display build that doesn't send one (USB flash required).
static char gDisplayFwVersion[16] = "";

// ---- Toggle states (shared between command handler and sendNavPacket) ------
static bool gGpsEnabled  = DEFAULT_USE_GPS_POSITION;  // GPS usage (position + speed)
static bool gWifiEnabled = true;   // WiFi radio enabled (surface mode default)
static bool gDiveMode      = false;  // Dive mode active (persisted to NVS)
// When the GPS last (re)started from nav's point of view: boot, surfacing, or
// CONFIG > GPS back on. The status LED only goes solid green for a fix logged
// after this, so after a dive it reports the surfacing fix, not the pre-dive one.
static uint32_t gGpsSessionStartMs = 0;
static bool gSaltWater     = DEFAULT_SALT_WATER;  // water density for depth calc (persisted to NVS)

// ---- Depth sensor state -----------------------------------------------------
static bool     gDepthZeroed        = false;  // one-shot: surface pressure captured yet?
static uint32_t gDepthSurfaceSinceMs = 0;      // 0 = not currently shallow; else millis() we became shallow

// ---- Serial link buffer ----------------------------------------------------
// NavPacket is JSON and variable-length: every optional field and every float's
// digit count changes its size. A realistic packet with the depth sensor fitted
// is ~250 bytes at rest and ~320 during speed cal or a current hold. The old
// 256-byte buffer made navPacketToBytes() return 0 there, so NOTHING was sent
// and the display went NO LINK (found 2026-09-16 on the first current hold).
// The display's rxBuf is 4096, so this side is the limit that matters.
static char linkBuf[512];
static uint32_t gLinkOverflowLogMs = 0;  // rate-limits the too-big warning
static char wpBuf[3200];  // waypoint list packet — up to 50 waypoints in JSON

// ---- OTA gating (see nav_main.h / net/ota.cpp) -----------------------------
const char* otaBlockedReason() {
    if (gDiveMode) return "Dive mode is on";
    if (depth::isPresent() && depth::getDepth_m() > DEPTH_OTA_UNDERWATER_M) {
        return "The unit is underwater";
    }
    if (logging::isLogging()) return "Logging is on -- stop logging first";
    if (gInCal || sysState == SystemState::CALIBRATION) return "A calibration is running";
    if (gCurrentHoldActive) return "A current measurement is running";
    if (log_sync::isUploading()) return "Dive logs are uploading -- try again when they finish";
    return nullptr;
}

const char* displayFwVersion() {
    return gDisplayFwVersion;
}

void forgetDisplayFwVersion() {
    gDisplayFwVersion[0] = '\0';
}

// ---- NVS helpers -----------------------------------------------------------
// Build full nav NVS state from current globals (avoids stale-read-then-write).
static nvs_nav::State currentNavNvsState() {
    nav::Position pos = nav::getPosition();
    nvs_nav::State s;
    s.gps        = gGpsEnabled;
    s.wifi       = gWifiEnabled;
    s.dive_mode  = gDiveMode;
    s.log_level  = static_cast<uint8_t>(logging::getLevel());
    s.pos_x      = pos.x_m;
    s.pos_y      = pos.y_m;
    s.salt_water = gSaltWater;
    return s;
}

// ---- Forward declarations --------------------------------------------------
static void loadCalibration();
static void endBinCal();
static void finishCurrentHold(bool early);
static void cancelCurrentHold();
static void sendNavPacket(float heading, float headingRaw, float pitch, float roll,
                          float speed, bool gpsSpeed,
                          float distHome, float bearHome,
                          float posX, float posY,
                          const GpsFix& fix);
static void sendWaypointListPacket();
static void logMarkRow(const nav::Position& pos);
#if ENABLE_DEBUG_PACKET
// Bench build only (see DISPLAY_MODE / ENABLE_DEBUG_PACKET in config.h): the
// definition sits below its call site, so without this the debug build does not
// compile at all.
static void sendDebugPacket(const imu::Vec3f& accel, const imu::Vec3f& gyro,
                            const imu::Vec3f& mag,
                            float headingDeg, float pitchDeg, float rollDeg);
#endif
static void handleDisplayCmd();
static void setDiveMode(bool dive);

// ===========================================================================
void setup() {
    Serial.begin(115200);
    Serial.println("\n=== DPV-NAV (nav device) fw " FW_VERSION " ===");
    // Says out loud which build this is. CORE_DEBUG_LEVEL decides whether the
    // Arduino libraries' own log_d/log_i lines exist at all -- at the default 0
    // they are compiled out, so a bench session can otherwise look like "the
    // library had nothing to say" when it was never able to speak. Build the
    // nav_debug env to get level 4.
#ifndef CORE_DEBUG_LEVEL
#define CORE_DEBUG_LEVEL 0
#endif
    Serial.printf("=== CORE_DEBUG_LEVEL=%d %s ===\n", CORE_DEBUG_LEVEL,
                  CORE_DEBUG_LEVEL >= 4 ? "(library logs ON)" : "(library logs OFF)");

    // Must run before anything else touches NVS or LittleFS: this is what
    // tells us *why* we're booting (brownout vs. panic vs. a deliberate
    // reset) and latches the previous session's active log path before
    // logging::init()'s cleanup pass runs against it.
    boot_log::recordBoot();

    // Before the self-test, so a halted boot can still show itself.
    status_led::init();

    // Serial link to display device
    Serial1.begin(LINK_BAUD, SERIAL_8N1, LINK_RX_PIN, LINK_TX_PIN);

    // I2C bus (recovers a stuck bus left by a reset mid-transaction, then begin()s)
    i2c_bus::begin(SDA_PIN, SCL_PIN);

    // LittleFS for calibration persistence
    if (!LittleFS.begin(true)) {
        Serial.println("ERROR: LittleFS mount failed");
    }

    // IMU configuration
    imu::ImuConfig imuConfig{
        .accel_g_fullscale  = 16.0f,
        .gyro_dps_fullscale = 2000.0f,
        .mag_uT_fullscale   = 4.0f,
        .sample_hz          = 100
    };
    // AXIS MAPPING — TWO COORDINATE FRAMES
    // The LSM6DS33 (accel/gyro) and LIS3MDL (mag) have different physical Y-axis
    // directions on this board. The accelGyroMap defines the NED reference frame.
    // The magMap's -2 corrects the LIS3MDL's physical Y to match the LSM6DS33 Y.
    //
    // HOWEVER: after this mapping + calibration, the mag output uses atan2(my, mx)
    // for heading (not the NED formula atan2(-my, mx)). This means the mag Y as
    // delivered by imu::readMag*() is actually -NED_Y (left-handed for Y axis).
    // The Mahony filter requires all sensors in the SAME NED frame, so nav_main
    // negates mag.y before passing to mahonyUpdate(). See the magNED variable below.
    // DO NOT REMOVE the mag.y negation without also changing this axis map and
    // recomputing all magnetometer calibration data.
    imu::AxisMap accelGyroMap{ .x_axis = +1, .y_axis = +2, .z_axis = +3 };
    imu::AxisMap magMap{ .x_axis = +1, .y_axis = -2, .z_axis = +3 };

    sysState = SystemState::SELF_TEST;

    // --- Boot self-test -----------------------------------------------------
    // Every peripheral is probed unconditionally, regardless of whether an
    // earlier one failed, so one boot surfaces every hardware fault at once.
    // Previously GPS/depth checks lived inside the IMU-success branch, so a
    // board with both a bad IMU wire and a bad GPS wire would report only the
    // IMU failure -- you'd fix that, reboot, and *then* discover GPS was
    // broken too.
    //
    // Only the IMU and the display link are required. GPS is NOT: this is a
    // dive computer, and dive mode deliberately powers GPS down the moment the
    // scooter goes under. A subsystem the product switches off on purpose
    // underwater cannot be a boot blocker -- and making it one meant a weak
    // GPS signal took the AHRS down with it, so the unit lost heading (the one
    // thing it must never lose) because it could not find satellites. GPS
    // failure is now reported and flagged, and the unit boots degraded:
    // heading works, dead reckoning runs off the flow sensor, absolute
    // position is unavailable until GPS returns.
    // AHRS is seeded before the self-test, not inside its success branch.
    // A failed self-test used to leave `ahrs` default-constructed with
    // q = {0,0,0,0}, which is finite but not normalizable -- the first
    // normalize would turn it into NaN. The loop currently early-returns in
    // ERROR state so nothing consumed it, but that is a fragile reason for a
    // zero quaternion to exist at all.
    mahonyInit(ahrs);

    struct BootCheck { const char* name; bool ok; bool required; };
    BootCheck checks[3];
    int checkCount = 0;

    bool imuOk = imu::init(imuConfig, accelGyroMap, magMap);
    checks[checkCount++] = { "IMU", imuOk, /*required=*/true };
    if (imuOk) {
        gBootFlags |= BOOT_IMU_OK;
        // Load or run calibration (sets BOOT_*_CAL_OK flags)
        loadCalibration();
    }

    bool gpsOk = gps::init();
    checks[checkCount++] = { "GPS", gpsOk, /*required=*/false };
    if (gpsOk) gBootFlags |= BOOT_GPS_OK;
    gps::setRawNmeaDebug(GPS_RAW_NMEA_ENABLE);

    // Depth sensor (BlueRobotics Bar30 / MS5837-30BA) — optional, J3 connector.
    // Not in `checks`: absence isn't a failure, units without one run fine
    // without depth-triggered auto dive-mode.
    bool depthOk = depth::init();
    if (depthOk) {
        Serial.println("Depth sensor init OK");
        gBootFlags |= BOOT_DEPTH_OK;
    } else {
        Serial.println("Depth sensor not detected (J3 unpopulated?) — skipping");
    }

    // Display-link round-trip check: ping repeatedly for a few seconds and
    // wait for DisplayCmd::LINK_HELLO to come back (set by handleDisplayCmd()
    // below). This proves BOTH directions of Serial1 in one shot -- it's
    // exactly the display->nav direction that went silently dead on a real
    // unit once already (bad solder joint), with nav->display looking
    // completely normal the whole time.
    {
        constexpr uint32_t DISPLAY_LINK_TIMEOUT_MS  = 3000;
        constexpr uint32_t DISPLAY_PING_INTERVAL_MS = 200;
        uint32_t start = millis();
        uint32_t lastPingMs = 0;
        while (millis() - start < DISPLAY_LINK_TIMEOUT_MS && !gDisplayLinkAckReceived) {
            uint32_t now = millis();
            if (now - lastPingMs >= DISPLAY_PING_INTERVAL_MS) {
                lastPingMs = now;
                char pingBuf[32];
                size_t n = bootPingToBytes(FW_VERSION, pingBuf, sizeof(pingBuf));
                if (n > 0) Serial1.write(pingBuf, n);
            }
            handleDisplayCmd();
        }
    }
    checks[checkCount++] = { "Display link", gDisplayLinkAckReceived, /*required=*/true };
    if (gDisplayLinkAckReceived) gBootFlags |= BOOT_DISPLAY_LINK_OK;

    // --- Boot summary: every result, not just the first failure -------------
    Serial.println("=== Boot self-test ===");
    bool anyRequiredFailed = false;
    for (int i = 0; i < checkCount; i++) {
        const char* verdict = checks[i].ok      ? "OK"
                            : checks[i].required ? "FAIL"
                                                 : "FAIL (degraded -- not required)";
        Serial.printf("  %-14s %s\n", checks[i].name, verdict);
        if (!checks[i].ok && checks[i].required) anyRequiredFailed = true;
    }
    Serial.printf("  %-14s %s\n", "Depth", depthOk ? "OK" : "absent (optional)");
    Serial.println("=======================");

    // Broadcast the result immediately, before any halt decision, so the
    // display shows the full ok/FAIL summary even when we're about to halt --
    // previously a halt meant total silence to the display, indistinguishable
    // from the link itself being dead.
    sendNavPacket(0, 0, 0, 0, 0, false, 0, 0, 0, 0, GpsFix{});

    if (anyRequiredFailed) {
        Serial.println("ERROR: a required system (IMU or display link) failed self-test -- halting");
        sysState = SystemState::ERROR;
    } else {
        if (!gpsOk) {
            Serial.println("WARNING: GPS not responding -- booting DEGRADED. "
                           "Heading and flow-based dead reckoning work; "
                           "absolute position and GPS speed do not.");
        }

        // Flow sensor
        {
            speed_cal::History hist = speed_cal::load();
            float k = speed_cal::averageK(hist, FLOW_K_FACTOR);
            flow::FlowConfig flowCfg{
                .k_factor         = k,
                .cross_section_m2 = FLOW_CROSS_SECTION_M2,
                .avg_period_s     = FLOW_AVG_PERIOD_S
            };
            flow::init(flowCfg);
            if (hist.count > 0) {
                Serial.printf("Flow sensor init OK (speed_cal: k=%.4f, %u runs)\n", k, hist.count);
            } else {
                Serial.printf("Flow sensor init OK (speed_cal: no history, using default k=%.4f)\n", k);
            }
        }

        // Position model
        nav::init(DEFAULT_BASELINE_LAT, DEFAULT_BASELINE_LON);
        nav::setUseGps(DEFAULT_USE_GPS_POSITION);

        // Waypoints (must be after LittleFS.begin())
        waypoints::load();

        // Data logging (starts in OFF state)
        logging::init();

        sysState = SystemState::READY;

        // Both required checks (IMU + display link round-trip) passed, so a
        // freshly OTA'd image has proved itself. An image that lands in ERROR
        // stays unconfirmed and reverts on its next reset -- see ota_confirm.h.
        ota_confirm::markValid();
    }
    Serial.printf("Display fw: %s\n",
                  gDisplayFwVersion[0] ? gDisplayFwVersion : "(not reported -- pre-OTA build)");

    // Set local timezone (Seattle / Pacific Time).
    // Must be done before wifi::init() so the NTP callback picks it up,
    // and before any GPS-based clock sync in the loop.
    setenv("TZ", "PST8PDT,M3.2.0,M11.1.0", 1);
    tzset();

    // WiFi + web server — always start, even if IMU failed.
    // Placed after calibration so blocking cal doesn't starve the connection.
    wifi::init();
    web::init();
    cal_sync::init();
    log_sync::init();

    // Restore state from NVS (previous session)
    {
        nvs_nav::State nvsState = nvs_nav::load();
        gGpsEnabled = nvsState.gps;
        gDiveMode   = nvsState.dive_mode;
        gSaltWater  = nvsState.salt_water;
        nav::setUseGps(gGpsEnabled);
        nav::setPosition(nvsState.pos_x, nvsState.pos_y);
        depth::setSaltWater(gSaltWater);
        if (nvsState.log_level > 0) {
            logging::setLevel(static_cast<logging::LogLevel>(nvsState.log_level));
        }
        // dive_mode in NVS reflects whichever mode the unit was in when it
        // was last powered off, not whether it's safe/correct to have
        // GPS+WiFi live right now -- so it's never trusted at boot. Always
        // start surfaced (the mode with every option available). A depth
        // sensor, if present, re-enters dive mode within one sample if
        // actually still submerged -- the depth-triggered check in loop()
        // is immediate, no dwell. A board with no depth sensor has no way
        // to re-verify and simply stays surfaced until Op Mode is toggled
        // manually from the menu.
        gDiveMode    = false;
        gWifiEnabled = nvsState.wifi;
        if (!gWifiEnabled) wifi::stop();
        Serial.printf("[NVS] Restored: gps=%d wifi=%d dive=%d log=%d pos=(%.1f,%.1f) salt=%d\n",
                      gGpsEnabled, gWifiEnabled, gDiveMode,
                      nvsState.log_level, nvsState.pos_x, nvsState.pos_y, gSaltWater);
    }

    gGpsSessionStartMs = millis();
    lastLoopUs = micros();
    Serial.println("Nav device ready");
    serial_cmd::printHelp();
}

// ===========================================================================
void loop() {
    // Keep web server alive even in error state
    web::update();

    // Sending firmware to the display: the transfer owns Serial1 until it ends.
    // No NavPackets or command parsing in the meantime (they would land in the
    // middle of it), and heading isn't computed -- the display is showing its
    // update screen, and the install refuses to start in dive mode anyway.
    if (ota::ownsDisplayLink()) {
        status_led::show(status_led::OFF);  // don't freeze mid-blink for the transfer
        ota::update();
        return;
    }

    if (sysState == SystemState::ERROR) {
        // Keep reporting the boot self-test summary instead of going fully
        // silent -- a halted nav device used to be indistinguishable from a
        // dead link or a crashed board. This keeps the display's ok/FAIL
        // screen alive and refreshing so it's obvious nav is up and simply
        // refusing to proceed, not that something else has also died.
        static uint32_t lastErrorSendMs = 0;
        uint32_t nowMs = millis();
        if (nowMs - lastErrorSendMs >= 1000) {
            lastErrorSendMs = nowMs;
            sendNavPacket(0, 0, 0, 0, 0, false, 0, 0, 0, 0, GpsFix{});
        }
        handleDisplayCmd();
        status_led::Inputs led{};
        led.nowMs  = millis();
        led.halted = true;
        status_led::update(led);
        // An ERROR-state unit may be exactly the one that needs new firmware.
        ota::update();
        delay(1);
        return;
    }

    // --- Rate gate to 100 Hz ------------------------------------------------
    uint32_t nowUs = micros();
    if (nowUs - lastLoopUs < LOOP_INTERVAL_US) return;
    float dt = (nowUs - lastLoopUs) * 1e-6f;
    lastLoopUs = nowUs;
    if (dt > 0.5f) dt = 0.01f;  // clamp on overflow

    // --- Read sensors -------------------------------------------------------
    imu::Vec3f accel, gyro, mag, magRaw, accelRaw, gyroRaw;
    imu::readAccel_g_raw_cal(accelRaw, accel);
    imu::readGyro_rad_s_raw_cal(gyroRaw, gyro);
    imu::readMag_raw_cal(magRaw, mag);  // magRaw = uncalibrated µT, mag = calibrated µT
    if (gHdgCalActive) {
        const float gyroDps = sqrtf(gyro.x * gyro.x + gyro.y * gyro.y + gyro.z * gyro.z) * 57.2957795f;
        gLevelGate.tick(millis(), accel.x, accel.y, accel.z, gyroDps);
    }
    // Logical-frame raw counts (axis map applied) for bin cal CSV export.
    // The calibration JSON must be in the same frame that readMag() reads in,
    // which is post-axis-map (logical frame).  readMagRaw_SensorFrame() is WRONG
    // here — it would store sensor-frame counts and cause the Python-derived bias
    // to have the wrong sign for axes that the map negates (Y in this board's map).
    imu::Vec3i16 magRaw_logical{};
    imu::readMagRaw(magRaw_logical);

    // --- AHRS update --------------------------------------------------------
    // The mag axis map {+1,-2,+3} puts mag Y in left-handed frame (positive=Left)
    // while accel is in right-handed NED (positive Y=Right). Mahony needs both
    // in the same NED frame, so negate mag Y before passing to the filter.
    imu::Vec3f magNED = { mag.x, -mag.y, mag.z };

    // --- AHRS poison detector ----------------------------------------------
    // Fires once, on the first non-finite value to reach or leave the filter,
    // and names the culprit. Runs before mahonyUpdate() so it can report the
    // inputs as they were, and again after so it also catches a quaternion
    // that went bad without any single input looking wrong.
    //
    // The failure this exists for: a calibration scale factor of inf (from a
    // 6-point accel cal that divided by a zero span) makes accel inf, Mahony
    // normalizes inf to NaN, and the quaternion is NaN for good. It reproduces
    // on the very first loop iteration after boot, which is why this prints
    // unconditionally rather than being gated behind FULL_DIAG_ENABLE.
    static bool poisonReported = false;
    if (!poisonReported) {
        auto bad3 = [](const imu::Vec3f& v) {
            return !isfinite(v.x) || !isfinite(v.y) || !isfinite(v.z);
        };
        bool badIn = !isfinite(dt) || bad3(accel) || bad3(gyro) || bad3(magNED);
        if (badIn || !quatIsFinite(ahrs.q)) {
            poisonReported = true;
            Serial.println("[POISON] ===== first non-finite AHRS value =====");
            Serial.printf("[POISON] when=%s  uptime=%lu ms  dt=%f\n",
                          badIn ? "INPUT" : "QUATERNION",
                          (unsigned long)millis(), (double)dt);
            Serial.printf("[POISON] accel raw=(%f, %f, %f)  cal=(%f, %f, %f)\n",
                          (double)accelRaw.x, (double)accelRaw.y, (double)accelRaw.z,
                          (double)accel.x,    (double)accel.y,    (double)accel.z);
            Serial.printf("[POISON] gyro  raw=(%f, %f, %f)  cal=(%f, %f, %f)\n",
                          (double)gyroRaw.x, (double)gyroRaw.y, (double)gyroRaw.z,
                          (double)gyro.x,    (double)gyro.y,    (double)gyro.z);
            Serial.printf("[POISON] mag   raw=(%f, %f, %f)  cal=(%f, %f, %f)\n",
                          (double)magRaw.x, (double)magRaw.y, (double)magRaw.z,
                          (double)mag.x,    (double)mag.y,    (double)mag.z);
            Serial.printf("[POISON] quat=(%f, %f, %f, %f)\n",
                          (double)ahrs.q.w, (double)ahrs.q.x,
                          (double)ahrs.q.y, (double)ahrs.q.z);
            dumpActiveCalibration("POISON");
            Serial.println("[POISON] ========================================");
        }
    }

    mahonyUpdate(ahrs, mahonyParams, gyro, accel, magNED, dt);

    if (!poisonReported && !quatIsFinite(ahrs.q)) {
        poisonReported = true;
        Serial.printf("[POISON] quaternion went non-finite inside mahonyUpdate: "
                      "(%f, %f, %f, %f)  dt=%f\n",
                      (double)ahrs.q.w, (double)ahrs.q.x,
                      (double)ahrs.q.y, (double)ahrs.q.z, (double)dt);
        dumpActiveCalibration("POISON");
    }

    // --- Extract Euler angles -----------------------------------------------
    Euler euler = quatToEulerRad(ahrs.q);
    float headingRawDeg = headingDegFromYawRad(euler.yaw, DEFAULT_DECLINATION_DEG);
    // Fourier cal is collected using a physical magnetic compass as reference,
    // so apply/store the correction in the magnetic domain, then restore declination.
    float headingMagDeg = headingRawDeg - DEFAULT_DECLINATION_DEG;
    if (headingMagDeg <    0.0f) headingMagDeg += 360.0f;
    if (headingMagDeg >= 360.0f) headingMagDeg -= 360.0f;
    gCurrentHeadingRawDeg = headingMagDeg;  // expose magnetic heading for CAPTURE_HDG_POINT
    float headingDeg;
    if (gHdgCalValid) {
        float headingMagCorr = hdg_cal::apply(headingMagDeg, gHdgCal);
        headingDeg = headingMagCorr + DEFAULT_DECLINATION_DEG;
        if (headingDeg >= 360.0f) headingDeg -= 360.0f;
        if (headingDeg <    0.0f) headingDeg += 360.0f;
    } else {
        headingDeg = headingRawDeg;
    }
    // Motor-on correction: motor magnetic field not captured by bench Fourier cal.
    // Applied after Fourier correction; heading_raw_deg in NavPacket is pre-correction.
    headingDeg = fmodf(headingDeg + gMotorCal.heading_offset_deg + 360.0f, 360.0f);
    float pitchDeg   = euler.pitch * (180.0f / M_PI);
    float rollDeg    = euler.roll  * (180.0f / M_PI);

    // --- Peripheral sensors -------------------------------------------------
    gps::update();
    flow::update();
    depth::update();

    // --- Depth: one-shot boot zero, then auto dive/surface trigger ----------
    if (depth::isPresent()) {
        if (depth::hasNewSample() && !gDepthZeroed) {
            depth::zero();
            gDepthZeroed = true;
            Serial.println("[DEPTH] Surface zero captured");
        }

        // Asymmetric trigger: entering dive mode is immediate (kill GPS/WiFi
        // fast once underwater); reverting to surface requires staying
        // shallow for DEPTH_SURFACE_REVERT_DWELL_S (avoids GPS/WiFi flapping
        // from wave action at the surface).
        if (gDepthZeroed) {
            float d = depth::getDepth_m();
            if (!gDiveMode && d >= DEPTH_DIVE_TRIGGER_M) {
                Serial.printf("[DEPTH] %.2fm >= trigger -> auto DIVE\n", (double)d);
                setDiveMode(true);
                gDepthSurfaceSinceMs = 0;
            } else if (gDiveMode && d < DEPTH_SURFACE_REVERT_M) {
                if (gDepthSurfaceSinceMs == 0) {
                    gDepthSurfaceSinceMs = millis();
                } else if (millis() - gDepthSurfaceSinceMs >= (uint32_t)(DEPTH_SURFACE_REVERT_DWELL_S * 1000.0f)) {
                    Serial.printf("[DEPTH] shallow for %.0fs -> auto SURFACE\n", DEPTH_SURFACE_REVERT_DWELL_S);
                    setDiveMode(false);
                    gDepthSurfaceSinceMs = 0;
                }
            } else {
                gDepthSurfaceSinceMs = 0;
            }
        }
    }

    // --- GPS COG coherence filter -------------------------------------------
    // Track consistency of Course Over Ground to distinguish real motion from
    // position jitter.  EMA of sin/cos avoids 0°/360° wrapping issues.
    // Coherence (resultant length) near 1.0 = consistent heading = real motion;
    // near 0.0 = random headings = stationary GPS wander.
    static float cogSinEma = 0.0f, cogCosEma = 0.0f;
    static bool  cogPrimed = false;

    static uint32_t gLastGpsPosMs   = 0;  // millis() of last accepted GPS position update
    static uint8_t  gLastGpsPosBars = 0;  // bar count of that fix (sets initial confidence)

    GpsFix fix = gps::getFix();
    bool gpsFresh = fix.has_fix && (millis() - fix.fix_age_ms) < GPS_FIX_STALE_MS;

    // --- GPS clock sync (one-shot) -------------------------------------------
    // Sync system clock from GPS UTC when we first get a valid position fix
    // with a parsed date/time. Only runs if NTP hasn't already set the clock
    // (i.e., time(nullptr) < Nov 2023, which an unsynced ESP32 never exceeds).
    {
        static bool gGpsTimeSynced = false;
        if (!gGpsTimeSynced && fix.has_fix && fix.has_time) {
            if (time(nullptr) < 1700000000L) {
                // mktime() interprets struct tm as local time; temporarily
                // switch to UTC to compute the correct UTC epoch, then restore.
                struct tm t{};
                t.tm_year  = (2000 + fix.utc_year) - 1900;
                t.tm_mon   = fix.utc_month - 1;
                t.tm_mday  = fix.utc_day;
                t.tm_hour  = fix.utc_hour;
                t.tm_min   = fix.utc_minute;
                t.tm_sec   = fix.utc_second;
                t.tm_isdst = 0;
                setenv("TZ", "UTC0", 1); tzset();
                time_t utcEpoch = mktime(&t);
                setenv("TZ", "PST8PDT,M3.2.0,M11.1.0", 1); tzset();
                struct timeval tv{ .tv_sec = utcEpoch, .tv_usec = 0 };
                settimeofday(&tv, nullptr);
                Serial.printf("[GPS] Clock set: %04d-%02d-%02d %02d:%02d:%02d UTC\n",
                              2000 + fix.utc_year, fix.utc_month, fix.utc_day,
                              fix.utc_hour, fix.utc_minute, fix.utc_second);
            }
            gGpsTimeSynced = true;  // attempt only once regardless of outcome
        }
    }

    uint8_t gpsBars = gps::computeSignalBars(fix);

    // GPS position confidence gate.
    // Confidence = (bars of last accepted fix / 4) × decay since that fix.
    // Required bars = ceil(confidence × 4), floored at GPS_POS_MIN_ACCEPT_BARS.
    // Effect: fresh 4-bar fix demands 4 bars for the next 30 s, relaxing to 3/2/2
    // as time passes. A 2-bar accepted fix starts at 0.5 confidence, immediately
    // requiring only 2 bars. Floor prevents accepting poor first fixes on resurfacing.
    float gpsElapsed = (gLastGpsPosMs == 0)
        ? GPS_CONFIDENCE_DECAY_S
        : (millis() - gLastGpsPosMs) / 1000.0f;
    float gpsConfidence = (gLastGpsPosBars / 4.0f) *
        constrain(1.0f - gpsElapsed / GPS_CONFIDENCE_DECAY_S, 0.0f, 1.0f);
    uint8_t gpsRequiredBars = (uint8_t)ceilf(gpsConfidence * 4.0f);
    if (gpsRequiredBars < GPS_POS_MIN_ACCEPT_BARS) gpsRequiredBars = GPS_POS_MIN_ACCEPT_BARS;

    // Auto-update HOME waypoint when GPS quality is good (>= 3/4 bars ≈ 75%).
    // Only in memory — flushed to flash every 60 s by lastWpSaveMs timer below.
    if (gpsFresh && gpsBars >= 3) {
        waypoints::updateHome(fix.lat, fix.lon);
    }

    if (gpsFresh) {
        float cogRad = fix.course_deg * (M_PI / 180.0f);
        float s = sinf(cogRad);
        float c = cosf(cogRad);
        if (!cogPrimed) {
            cogSinEma = s;
            cogCosEma = c;
            cogPrimed = true;
        } else {
            cogSinEma += GPS_COG_EMA_ALPHA * (s - cogSinEma);
            cogCosEma += GPS_COG_EMA_ALPHA * (c - cogCosEma);
        }
    }

    float cogCoherence = sqrtf(cogSinEma * cogSinEma + cogCosEma * cogCosEma);

    // Select speed source: GPS speed must pass both SOG deadband and COG coherence.
    //  - SOG < NOISE_FLOOR: always noise (position jitter at rest)
    //  - SOG > TRUST_FLOOR: always trust (clearly moving, COG drifts slowly at low speed)
    //  - In between: require COG coherence to confirm real motion
    // When GPS speed is rejected, fall back to flow sensor. If flow sensor also
    // reads 0 (no sensor connected), use GPS speed anyway — noisy GPS speed is
    // always better than zero for DR integration.
    float speed;
    bool useGpsSpeed = false;
    if (gpsFresh) {
        if (gpsBars >= gpsRequiredBars) {
            nav::updateGPS(fix.lat, fix.lon);
            gLastGpsPosMs   = millis();
            gLastGpsPosBars = gpsBars;
        }
        bool sogTrusted = false;
        if (fix.speed_knots >= GPS_SOG_TRUST_FLOOR_KN) {
            sogTrusted = true;
        } else if (fix.speed_knots >= GPS_SOG_NOISE_FLOOR_KN
                   && cogCoherence >= GPS_COG_COHERENCE_THRESH) {
            sogTrusted = true;
        }
        if (sogTrusted) {
            speed = fix.speed_knots * KNOTS_TO_MS;
            useGpsSpeed = true;
        } else {
            float flowSpeed = flow::getSpeed_ms();
            if (flowSpeed > 0.0f) {
                speed = flowSpeed;
            } else {
                // No flow sensor: use GPS speed if above noise floor,
                // otherwise treat as stationary
                if (fix.speed_knots >= GPS_SOG_NOISE_FLOOR_KN) {
                    speed = fix.speed_knots * KNOTS_TO_MS;
                    useGpsSpeed = true;
                } else {
                    speed = 0.0f;
                }
            }
        }
    } else {
        speed = flow::getSpeed_ms();
    }

    // Is nav's position currently GPS? True for GPS_FIX_STALE_MS after the gate
    // above accepted a fix (rows between 1 Hz fixes are that fix plus DR, as
    // they always were). The log's 'G' tag and the status LED's green both use
    // exactly this, so neither can call a fix good that the other wouldn't.
    const bool gpsPosAccepted = nav::isUsingGps() && gLastGpsPosMs != 0 &&
                                (millis() - gLastGpsPosMs) < GPS_FIX_STALE_MS;

    // --- Dead-reckoning position update ------------------------------------
    // Suppress DR integration when flow speed is below threshold (treats sensor
    // noise and near-stationary drift as zero rather than accumulating error).
    //
    // ...and for the whole of a current hold, whatever the flow reads. The diver
    // is deliberately holding station against the water, so that flow is a
    // measurement of the CURRENT, not of travel over the ground. A current over
    // 0.10 m/s would otherwise clear the threshold and integrate a minute of
    // movement that never happened -- corrupting the very leg the measurement
    // exists to clean up.
    //
    // Both conditions share this one assignment on purpose: `speed` feeds DR,
    // NavPacket.speed_ms (the displayed speed and ETA) and the log's speed_ms
    // column all at once, so a second zeroing site would inevitably drift from
    // this one. The measurement itself reads flow::getSpeed_ms() directly,
    // upstream of here, because this line would zero that too.
    if (gCurrentHoldActive || (!useGpsSpeed && speed < DR_MIN_FLOW_SPEED_MS)) speed = 0.0f;
    nav::updateDR(headingDeg, speed, dt);

    // --- Commit any settled log-level change --------------------------------
    // CONFIG > Log only records the selection; the file open/close happens here
    // once it has held still for LOG_COMMIT_DELAY_MS.
    logging::tick();

    // --- Send NavPacket at link rate ----------------------------------------
    uint32_t nowMs = millis();
    if (nowMs - lastSendMs >= SEND_INTERVAL_MS) {
        lastSendMs = nowMs;
        nav::Position pos = nav::getPosition();
        sendNavPacket(headingDeg, headingMagDeg, pitchDeg, rollDeg, speed, useGpsSpeed,
                     nav::distanceToHome_m(), nav::bearingToHome_deg(),
                     pos.x_m, pos.y_m, fix);

        // Offered to the logger at 10 Hz (same rate as NavPacket); it keeps
        // its own per-level rate limit and idle gate, see logging::log().
        if (logging::isLogging()) {
            logging::LogData ld{};
            ld.timestamp_ms = nowMs;
            ld.heading_deg  = headingDeg;
            ld.speed_ms     = speed;
            ld.gpsSpeed     = useGpsSpeed;
            ld.pos_x_m      = pos.x_m;
            ld.pos_y_m      = pos.y_m;
            ld.lat           = pos.lat;
            ld.lon           = pos.lon;
            // 'G' only for a position the confidence gate accepted. It used to
            // be any fresh fix, so a rejected one -- the poor first fix on
            // surfacing the gate exists to refuse -- logged nav's DR estimate
            // tagged as GPS, and the track processor anchors on every 'G' row.
            ld.pos_src       = gpsPosAccepted ? 'G' : 'E';
            ld.gps_satellites = fix.has_fix ? fix.satellites : 0;
            ld.gps_hdop       = fix.has_fix ? fix.hdop       : 0.0f;
            ld.depth_m        = depth::isPresent() ? depth::getDepth_m() : 0.0f;
            ld.water_temp_c   = depth::isPresent() ? depth::getTemp_c()  : 0.0f;
            ld.mag_raw       = magRaw;
            ld.accel_raw     = accelRaw;
            ld.gyro_raw      = gyroRaw;
            ld.mag_cal       = mag;
            ld.accel_cal     = accel;
            ld.gyro_cal      = gyro;
            ld.pitch_deg     = pitchDeg;
            ld.roll_deg      = rollDeg;
            // Every level. Free: it is the value captured with this loop's
            // field read. NaN if no plausible reading yet — see logging.h.
            ld.mag_temp_c    = NAN;
            imu::readMagTemp_c(ld.mag_temp_c);
            logging::log(ld);
        }
    }

    // --- Status LED -----------------------------------------------------------
    {
        status_led::Inputs led{};
        led.nowMs             = nowMs;
        led.diveMode          = gDiveMode;
        led.gpsUsageOn        = gGpsEnabled;
        led.healthy           = isfinite(headingDeg);
        led.gpsInitOk         = (gBootFlags & BOOT_GPS_OK) != 0;
        led.gpsEnabledSinceMs = gps::getEnabledSinceMs();
        led.gpsLastSentenceMs = gps::getLastSentenceMs();
        led.gpsFresh          = gpsFresh;
        led.bars              = gpsBars;
        led.minBars           = GPS_POS_MIN_ACCEPT_BARS;
        led.requiredBars      = gpsRequiredBars;
        led.accepted          = gpsPosAccepted;
        led.logged            = logging::gpsRowWrittenSince(gGpsSessionStartMs);
        status_led::update(led);
    }

    // --- Periodic NVS position save ------------------------------------------
    if (nowMs - lastPosSaveMs >= NVS_POS_SAVE_INTERVAL_MS) {
        lastPosSaveMs = nowMs;
        nav::Position pos = nav::getPosition();
        nvs_nav::savePosition(pos.x_m, pos.y_m);
    }

    // --- Waypoint list broadcast at 1 Hz ------------------------------------
    if (nowMs - lastWpSendMs >= 1000) {
        lastWpSendMs = nowMs;
        sendWaypointListPacket();
    }

    // --- Periodic waypoint save (HOME updates from GPS) ---------------------
    if (nowMs - lastWpSaveMs >= 60000) {
        lastWpSaveMs = nowMs;
        waypoints::save();
    }

    // --- Accumulate mag stats for diagnostics --------------------------------
    static float mStatMinX, mStatMaxX, mStatMinY, mStatMaxY, mStatMinZ, mStatMaxZ;
    static float mStatMinMag, mStatMaxMag;
    static uint32_t mStatN = 0;

    float magMag = sqrtf(mag.x*mag.x + mag.y*mag.y + mag.z*mag.z);
    if (mStatN == 0) {
        mStatMinX = mStatMaxX = mag.x;
        mStatMinY = mStatMaxY = mag.y;
        mStatMinZ = mStatMaxZ = mag.z;
        mStatMinMag = mStatMaxMag = magMag;
    } else {
        if (mag.x < mStatMinX) mStatMinX = mag.x; if (mag.x > mStatMaxX) mStatMaxX = mag.x;
        if (mag.y < mStatMinY) mStatMinY = mag.y; if (mag.y > mStatMaxY) mStatMaxY = mag.y;
        if (mag.z < mStatMinZ) mStatMinZ = mag.z; if (mag.z > mStatMaxZ) mStatMaxZ = mag.z;
        if (magMag < mStatMinMag) mStatMinMag = magMag;
        if (magMag > mStatMaxMag) mStatMaxMag = magMag;
    }
    mStatN++;

    // --- Sensor diagnostics at 1 Hz ----------------------------------------
    if (nowMs - lastDiagMs >= DIAG_INTERVAL_MS) {
        lastDiagMs = nowMs;
        Serial.printf("[DIAG] dt=%.4f  hdg=%.1f  pitch=%.1f  roll=%.1f\t\n",
                      dt, headingDeg, pitchDeg, rollDeg);
        if (ahrs.rejectedInputs || ahrs.rollbacks) {
            Serial.printf("[DIAG] AHRS poison: %lu rejected input(s), %lu rollback(s)\n",
                          (unsigned long)ahrs.rejectedInputs,
                          (unsigned long)ahrs.rollbacks);
        }
        //Serial.printf("[DIAG] accel(g)  X=%+.3f Y=%+.3f Z=%+.3f\t",
        //              accel.x, accel.y, accel.z);
        //Serial.printf("[DIAG] gyro(r/s) X=%+.4f Y=%+.4f Z=%+.4f\t",
        //              gyro.x, gyro.y, gyro.z);

        if (FULL_DIAG_ENABLE) {
            // Mag: current calibrated reading in µT
            Serial.printf("[MAG ] cal(uT)   X=%+.2f Y=%+.2f Z=%+.2f  |B|=%.2f\t",
                        mag.x, mag.y, mag.z, magMag);
            Serial.printf("[MAG ] raw(uT)   X=%+.2f Y=%+.2f Z=%+.2f\t",
                        magRaw.x, magRaw.y, magRaw.z);

            // Horizontal component: project out gravity direction
            float mDotA = mag.x*accel.x + mag.y*accel.y + mag.z*accel.z;
            float aMag2 = accel.x*accel.x + accel.y*accel.y + accel.z*accel.z;
            float hMag = 0.0f;
            if (aMag2 > 0.01f) {
                float s = mDotA / aMag2;
                float mhX = mag.x - s*accel.x;
                float mhY = mag.y - s*accel.y;
                float mhZ = mag.z - s*accel.z;
                hMag = sqrtf(mhX*mhX + mhY*mhY + mhZ*mhZ);
            }
            Serial.printf("[MAG ] horiz=%.2f uT  samples=%u\t", hMag, mStatN);

            // 1-second stability: per-axis and magnitude spread
            Serial.printf("[MAG ] spread: X=[%+.2f,%+.2f] Y=[%+.2f,%+.2f] Z=[%+.2f,%+.2f]\t",
                        mStatMinX, mStatMaxX, mStatMinY, mStatMaxY, mStatMinZ, mStatMaxZ);
            Serial.printf("[MAG ] |B| range: [%.2f, %.2f] uT\n", mStatMinMag, mStatMaxMag);

            // Warnings
            if (magMag < 20.0f || magMag > 80.0f)
                Serial.println("[MAG ] WARNING: |B| outside Earth range (25-65 uT)");
            if (hMag < 5.0f)
                Serial.println("[MAG ] WARNING: Horizontal component < 5 uT — heading unreliable");
            //if (mStatMaxMag - mStatMinMag > 10.0f)
            //    Serial.println("[MAG ] WARNING: |B| unstable (>10 uT swing) — interference or bad cal");
            //float spreadX = mStatMaxX - mStatMinX;
            //float spreadY = mStatMaxY - mStatMinY;
            //float spreadZ = mStatMaxZ - mStatMinZ;
            //if (spreadX > 3.0f || spreadY > 3.0f || spreadZ > 3.0f)
            //    Serial.printf("[MAG ] WARNING: Noisy at rest (spread X=%.1f Y=%.1f Z=%.1f uT)\n",
            //                  spreadX, spreadY, spreadZ);
        }

        if (GPS_DIAG_ENABLE) {
            Serial.printf("[GPS ] fix=%d  3d=%d  sat=%d  hdop=%.1f  bars=%d/4\n",
                          fix.has_fix, fix.fix_type_3d, fix.satellites,
                          (double)fix.hdop, gpsBars);
            Serial.printf("[GPS ] conf=%.2f  required=%d/4  pos_update=%s\n",
                          (double)gpsConfidence, gpsRequiredBars,
                          (gpsFresh && gpsBars >= gpsRequiredBars) ? "YES" : "NO");
            Serial.printf("[GPS ] pos=(%.6f, %.6f)  alt=%.1f m\n",
                          (double)fix.lat, (double)fix.lon, (double)fix.altitude_m);
            Serial.printf("[GPS ] SOG=%.2f kn  COG=%.1f deg  coherence=%.3f [%s]  speed=%.2f m/s (%s)\n",
                          (double)fix.speed_knots, (double)fix.course_deg,
                          (double)cogCoherence,
                          cogCoherence >= GPS_COG_COHERENCE_THRESH ? "PASS" : "FAIL",
                          (double)speed, useGpsSpeed ? "GPS" : "FLOW");
            int gsvN = gps::getGsvLineCount();
            if (gsvN == 0) {
                Serial.println("[GSV ] (none yet)");
            } else {
                for (int i = 0; i < gsvN; i++)
                    Serial.printf("[GSV ] %s\n", gps::getGsvLine(i));
            }
        }

        mStatN = 0;  // reset for next window
    }

    // --- Flow sensor debug at 4 Hz -----------------------------------------
    if (FLOW_LOG_ENABLE && (nowMs - lastFlowLogMs >= FLOW_LOG_INTERVAL_MS)) {
        lastFlowLogMs = nowMs;
        Serial.printf("[FLOW] pulses=%u  freq=%.2f Hz  raw=%.4f lpm  speed=%.4f m/s\n",
                      flow::getLastPulseCount(),
                      flow::getFrequency_hz(),
                      flow::getFlowRate_lpm(),
                      flow::getSpeed_ms());
    }

#if ENABLE_DEBUG_PACKET
    // --- Send DebugPacket at debug rate ------------------------------------
    static uint32_t lastDebugSendMs = 0;
    if (nowMs - lastDebugSendMs >= DEBUG_SEND_INTERVAL_MS) {
        lastDebugSendMs = nowMs;
        sendDebugPacket(accel, gyro, mag, headingDeg, pitchDeg, rollDeg);
    }
#endif

    // --- WiFi / web server housekeeping --------------------------------------
    wifi::update();
    web::update();
    if (web::isReloadCalRequested()) {
        web::clearReloadCalRequest();
        loadCalibration();
    }

    // --- Calibration install-sync pending-confirm retry (non-blocking; only
    // does anything once every few minutes, see cal_sync.cpp) ---------------
    cal_sync::update();

    // --- Firmware update: boot-time manifest check, then (once the diver
    // starts one from tern.local) at most one download chunk per iteration --
    ota::update();

    // --- Automatic dive-log upload (net/log_sync.h) -------------------------
    // Held off during calibration: a cal's own upload is blocking and owns the
    // display, and log_sync's uploads block too, so the two must not interleave.
    // Held off during a firmware install for the same reason: the install keeps
    // an HTTPS stream open across iterations, and a blocking upload in between
    // would stall it and open a second TLS session on a tight heap.
    if (!gInCal && sysState != SystemState::CALIBRATION && !ota::installing()) {
        log_sync::update();
    }

    // --- Cloud account-link poll (non-blocking, see LINK_ACCOUNT above) ------
    cloud::updateAuthorizePoll();
    {
        cloud::AuthPollStatus linkSt = cloud::getAuthorizePollStatus();
        if (linkSt != cloud::AuthPollStatus::IDLE && linkSt != cloud::AuthPollStatus::POLLING) {
            CloudLinkResultPacket lpkt{};
            if (linkSt == cloud::AuthPollStatus::APPROVED) {
                Serial.println("[CLOUD_LINK] Approved -- token saved");
                lpkt.stage = (uint8_t)CloudLinkStage::DONE;
            } else {
                String err = (linkSt == cloud::AuthPollStatus::DENIED)    ? "access_denied"
                             : (linkSt == cloud::AuthPollStatus::EXPIRED) ? "expired_token"
                                                                           : cloud::lastAuthorizeError();
                Serial.printf("[CLOUD_LINK] failed: %s\n", err.c_str());
                lpkt.stage = (uint8_t)CloudLinkStage::FAILED;
                strncpy(lpkt.error, err.c_str(), sizeof(lpkt.error) - 1);
            }
            char cloudLinkBuf[256];
            size_t clbn = cloudLinkResultPacketToBytes(lpkt, cloudLinkBuf, sizeof(cloudLinkBuf));
            if (clbn > 0) Serial1.write(cloudLinkBuf, clbn);
            cloud::cancelAuthorizePoll();  // consume the terminal result -> back to IDLE
        }
    }

    // --- Calibration tick and completion detection ---------------------------
    if (gInCal) {
        if (gCalMode == 5 || gCalMode == 6 || gCalMode == 7) {
            // Bin-aware mag cal (baseline=5, mounted=6, gap-fill=7)
            // Feed current raw mag sample into the bin collector
            imu::magBinCalTick(pitchDeg, headingDeg, magRaw_logical, accel, gyro);

            // Emit CalProgressPacket at 2 Hz
            if (nowMs - gLastCalProgressMs >= CAL_PROGRESS_INTERVAL_MS) {
                gLastCalProgressMs = nowMs;
                CalProgressPacket cpkt{};
                imu::magBinCalGetProgress(cpkt);
                char calBuf[512];
                size_t cn = calProgressPacketToBytes(cpkt, calBuf, sizeof(calBuf));
                if (cn > 0) Serial1.write(calBuf, cn);
            }

            // ...and the attitude-only subset at 10 Hz, so the highlighted
            // cell tracks the diver's hand instead of strobing (see
            // CAL_ORIENT_INTERVAL_MS). Grid modes only: baseline (5) joins
            // once its bootstrap locks -- before that it is ROUGH_SCAN with no
            // grid to steer, so it would be pure link traffic. The display
            // ignores these until a CalProgressPacket has given it a grid to
            // merge them into, so ordering doesn't matter.
            if ((gCalMode == 6 || gCalMode == 7 ||
                 (gCalMode == 5 && imu::magBinCalBaselineGridLive())) &&
                nowMs - gLastCalOrientMs >= CAL_ORIENT_INTERVAL_MS) {
                gLastCalOrientMs = nowMs;
                CalOrientPacket opkt{};
                imu::magBinCalGetOrient(opkt);
                char orientBuf[224];
                size_t on = calOrientPacketToBytes(opkt, orientBuf, sizeof(orientBuf));
                if (on > 0) Serial1.write(orientBuf, on);
            }

            // Check completion
            if (imu::magBinCalIsComplete()) {
                // Send final CalProgressPacket with complete=true immediately —
                // don't wait for the 2 Hz timer, or the display may never see it.
                {
                    CalProgressPacket cpkt{};
                    imu::magBinCalGetProgress(cpkt);  // complete=true (mounted: all bins green; baseline: diver-declared)
                    char calBuf[512];
                    size_t cn = calProgressPacketToBytes(cpkt, calBuf, sizeof(calBuf));
                    if (cn > 0) Serial1.write(calBuf, cn);
                    Serial.println("[BIN_CAL] Sent completion packet");
                }

                Serial.println("[BIN_CAL] Complete — dumping CSV");
                if (gBinCalCsvPath) {
                    File f = LittleFS.open(gBinCalCsvPath, FILE_WRITE);
                    if (f) {
                        imu::magBinCalDumpCSV(&f);
                        f.close();
                        Serial.printf("[BIN_CAL] CSV saved to %s\n", gBinCalCsvPath);

                        // Hand back the sample buffer (69,120 bytes when this was
                        // written; 47,520 since the samples went to int16) BEFORE the upload.
                        // The samples are on LittleFS now and nothing below reads them
                        // again; magBinCalEnd() at the bottom of this block used to be
                        // the only free, which meant every cloud upload ran with that
                        // buffer still resident. That is not just a TLS-allocation
                        // problem (mbedtls wants ~33 KB contiguous and the largest free
                        // block measured 42996 with the buffer held, against 110580
                        // without it) -- the ESP32 WiFi
                        // driver allocates its RX buffers from this same heap, and when
                        // it cannot get one the inbound frame is dropped silently. That
                        // matches the failure exactly: the device streams ~4 segments,
                        // fills its send queue, and then never sees the ACKs the server
                        // is demonstrably sending, so it retransmits on RTO backoff
                        // until HTTPClient gives up (-3). Downloads and OTA over the same
                        // link are fine because no cal buffer is resident for those, and
                        // small uploads are fine because they fit in the initial window
                        // and never need a mid-transfer ACK.
                        // Measured on the bench, same AP, same 28 KB class of file:
                        // 113,318 ms before this call existed, 2,186 ms after.
                        imu::magBinCalFreeSamples();

                        // Cloud calibration (docs/cloud-calibration-plan.md): upload the
                        // CSV and run the fit if we have a network. This is a *blocking*
                        // call (see net/cloud_client.h) that can stall this loop for up to
                        // several seconds per HTTP round trip -- accepted for now because
                        // the diver just finished a deliberate cal action and isn't mid-dive,
                        // the same tradeoff wifi::init()'s blocking connectByScan() already
                        // makes. If this proves disruptive, it needs the non-blocking
                        // treatment flagged in the plan doc.
                        //
                        // The fitted result is staged to a "_pending" file, never written
                        // over the active mag_base.json / mag_mount.json, until the diver
                        // accepts it on the display (ACCEPT_CLOUD_CAL / REJECT_CLOUD_CAL,
                        // handled below). runCalUploadAndNotify() tells the display what
                        // happened either way via a CalCloudResultPacket -- it can't infer
                        // this from NavPacket alone.
                        //
                        // Gap-fill (mode 7) is a baseline collection as far as the cloud is
                        // concerned: same 9-axis CSV, fit as "baseline", then combined with
                        // the existing baseline from the website's merge picker. It is
                        // deliberately NOT a distinct cal_type -- a patch that can't be
                        // merged with what it patches would be useless. Its fit is computed
                        // from ONLY the patched cells -- a handful out of 60 -- and its only
                        // useful destiny is as a merge candidate on the website
                        // (calibrate_upload already made it one; nothing more is needed for
                        // that). It must never become installable standalone: the RESULT
                        // screen defaults its ACCEPT/REJECT toggle to ACCEPT, and a diver who
                        // presses BTN2 without reading it closely would silently overwrite a
                        // good full-sphere baseline with a partial one. See
                        // baseline-cal-coverage-feedback-plan.md, "gap-fill never overwrites
                        // the active baseline on its own."
                        const bool baselineLike    = (gCalMode == 5 || gCalMode == 7);
                        const bool isGapFillUpload = (gCalMode == 7);
                        const char* calMode      = baselineLike ? "baseline" : "mounted";
                        const char* pendingPath  = baselineLike
                            ? "/mag_base_pending.json" : "/mag_mount_pending.json";
                        const char* activePath   = baselineLike
                            ? storage::MAG_BASE_FILE : storage::MAG_MOUNT_FILE;
                        const CalType calType    = baselineLike ? CalType::BASELINE : CalType::MOUNTED;

                        Serial.println("[CLOUD_CAL] Uploading calibration...");
                        CloudCalOutcome outcome = runCalUploadAndNotify(
                            calType, calMode, gBinCalCsvPath, pendingPath, activePath,
                            /*installable=*/!isGapFillUpload);
                        if (outcome.ok) {
                            Serial.printf("[CLOUD_CAL] %s (band=%s rms_pct=%.1f) staged to %s\n",
                                          outcome.recommendation.c_str(), outcome.qualityBand.c_str(),
                                          (double)outcome.rmsPct, pendingPath);
                        } else if (outcome.offline) {
                            Serial.println("[CLOUD_CAL] No WiFi connection -- skipping upload. "
                                            "Connect to WiFi to finish calibration in the cloud.");
                        } else {
                            Serial.printf("[CLOUD_CAL] failed: %s\n", outcome.error.c_str());
                        }
                    } else {
                        Serial.printf("[BIN_CAL] ERROR: could not open %s\n", gBinCalCsvPath);
                    }
                }
                endBinCal();
                Serial.println("[BIN_CAL] Cal complete, returning to READY");
            }
        } else if (gCalMode == 0) {
            // Quick cal (non-blocking hard-iron sweep, legacy)
            if (imu::magCalNBTick()) {
                imu::magCalNBGetResult(magCal);
                storage::saveMagCalibration(storage::MAG_LEGACY_FILE, magCal);
                gInCal   = false;
                sysState = SystemState::READY;
                Serial.println("[CAL] Quick cal saved, returning to READY");
            }
        } else if (gCalMode == 1) {
            // Full cal (soft-iron data collection via mag_cal::, legacy)
            if (mag_cal::isCollecting()) {
                mag_cal::logSample();
            } else {
                gInCal   = false;
                sysState = SystemState::READY;
                Serial.println("[CAL] Full cal collection done, returning to READY");
            }
        } else if (gCalMode == 8) {
            // Current hold — RUNNING. Sample the raw flow reading (NOT the main
            // loop's `speed`, which the gate above has already zeroed) and the
            // heading, then average both over the hold.
            uint32_t heldMs = millis() - gCurrentHoldStartMs;
            if (heldMs >= CURRENT_HOLD_DURATION_MS) {
                finishCurrentHold(false);
            } else {
                CurrentHoldBin& b = gCurrentHoldBins[heldMs / 1000];
                b.flowSum += flow::getSpeed_ms();
                float hdgRad = headingDeg * (float)(M_PI / 180.0);
                b.sinSum += sinf(hdgRad);
                b.cosSum += cosf(hdgRad);
                if (b.n < 0xFFFF) b.n++;
            }
        } else if (gCalMode == 2) {
            // Speed cal — WAITING: watch for flow to exceed start threshold
            float flowFreq = flow::getFrequency_hz();
            if (flowFreq >= SPEED_CAL_START_THRESHOLD_HZ) {
                // Flow detected — start the run
                gCalMode             = 3;
                gSpeedCalStartMs     = millis();
                gSpeedCalPulseTotal  = 0;
                gSpeedCalHdgPrimed   = false;
                Serial.printf("[SPEED_CAL] Run started, target %uft\n",
                              (unsigned)gSpeedCalDist_ft);
            }
        } else if (gCalMode == 3) {
            // Speed cal — RUNNING: accumulate pulses, watch stop conditions
            gSpeedCalPulseTotal += flow::getLastPulseCount();
            uint32_t elapsedMs  = millis() - gSpeedCalStartMs;
            float    elapsedS   = elapsedMs / 1000.0f;

            // Update heading EMA (circular, handles 0°/360° wrap)
            float hdgRad = headingDeg * (float)(M_PI / 180.0);
            if (!gSpeedCalHdgPrimed) {
                gSpeedCalHdgSinEMA = sinf(hdgRad);
                gSpeedCalHdgCosEMA = cosf(hdgRad);
                gSpeedCalHdgPrimed = true;
            } else {
                gSpeedCalHdgSinEMA += SPEED_CAL_HDG_EMA_ALPHA *
                                      (sinf(hdgRad) - gSpeedCalHdgSinEMA);
                gSpeedCalHdgCosEMA += SPEED_CAL_HDG_EMA_ALPHA *
                                      (cosf(hdgRad) - gSpeedCalHdgCosEMA);
            }

            // --- Stop conditions ---
            bool runDone = false;

            // 1) Flow drops: DPV has stopped
            if (flow::getSpeed_ms() < SPEED_CAL_STOP_THRESHOLD_MS) {
                runDone = true;
                Serial.println("[SPEED_CAL] Stop: flow dropped");
            }

            // 2) After minimum run time, large heading deviation signals end
            if (!runDone && elapsedS >= SPEED_CAL_MIN_RUN_S) {
                float emaHdgRad = atan2f(gSpeedCalHdgSinEMA, gSpeedCalHdgCosEMA);
                float diffRad   = hdgRad - emaHdgRad;
                // Normalise to [-π, π]
                while (diffRad >  (float)M_PI) diffRad -= 2.0f * (float)M_PI;
                while (diffRad < -(float)M_PI) diffRad += 2.0f * (float)M_PI;
                if (fabsf(diffRad) * (180.0f / (float)M_PI) >= SPEED_CAL_HEADING_STOP_DEG) {
                    runDone = true;
                    Serial.printf("[SPEED_CAL] Stop: heading change %.1f° after %.1fs\n",
                                  fabsf(diffRad) * (180.0f / (float)M_PI), elapsedS);
                }
            }

            if (runDone && elapsedS >= 5.0f) {
                // Compute proposed k-factor
                // Formula: k_new = total_pulses / (dist_m * 60 * 1000 * cross_section_m2)
                // This is derived from:
                //   speed_ms = (freq_hz / k) / 60 / 1000 / cross_section_m2
                //   where freq_hz = total_pulses / elapsed_s, speed_ms = dist_m / elapsed_s
                //   elapsed_s cancels → k = total_pulses / (dist_m * 60 * 1000 * cross_section)
                float distM  = gSpeedCalDist_ft * 0.3048f;
                float k_new  = (float)gSpeedCalPulseTotal /
                               (distM * 60.0f * 1000.0f * FLOW_CROSS_SECTION_M2);

                // Load current history for the existing average
                speed_cal::History hist = speed_cal::load();
                float k_existing = speed_cal::averageK(hist, FLOW_K_FACTOR);

                gSpeedCalKExisting = k_existing;
                gSpeedCalKProposed = k_new;
                gSpeedCalElapsedS  = (elapsedS > 65535.0f) ? 65535 :
                                     (uint16_t)elapsedS;

                gCalMode = 4;  // transition to RESULT state
                Serial.printf("[SPEED_CAL] Result: %upulses dist=%.1fm t=%.1fs "
                              "k_exist=%.4f k_new=%.4f\n",
                              (unsigned)gSpeedCalPulseTotal, distM, elapsedS,
                              k_existing, k_new);
            }
            // If run ended too quickly (< 5 s), abort back to WAITING
            else if (runDone) {
                gCalMode = 2;
                Serial.println("[SPEED_CAL] Run too short, returning to WAITING");
            }
        }
        // cal_mode == 4 (RESULT): no tick needed; nav device just keeps broadcasting
        // result fields in NavPacket until display sends accept/reject command.
    }

    // --- Serial commands and mag cal collection (legacy serial-triggered) ----
    serial_cmd::processInput(ahrs);
    serial_cmd::updateStabilityTest(mag, accel);
    // Note: mag_cal::logSample() is now called in the gInCal block above for menu-triggered cals.
    // The serial_cmd path (e.g., 'collect_mag') still calls mag_cal::startCollection() directly;
    // handle that here to avoid missing samples if triggered via serial.
    if (!gInCal && mag_cal::isCollecting()) mag_cal::logSample();

    // --- Check for commands from display ------------------------------------
    handleDisplayCmd();
}

// ===========================================================================
// Helpers
// ===========================================================================

// End a bin cal (baseline, mounted or gap-fill) and go back to navigating on
// the cal installed on flash. Shared by completion, after the CSV dump and
// upload, and by QUIT_CAL, which skips both. loadCalibration() is what keeps
// a quit baseline from leaving heading on the identity cal it collects under.
static void endBinCal() {
    imu::magBinCalEnd();
    loadCalibration();  // restore whatever's actually on flash
    gInCal   = false;
    sysState = SystemState::READY;
}

static void loadCalibration() {
    // Magnetometer — try two-stage chain (mag_base.json + mag_mount.json),
    // falling back to legacy mag_cal.json. A brand-new device has none of these
    // files, and there's no sane automatic mag cal to run at that point: the
    // diver hasn't necessarily unboxed the device somewhere magnetically clean,
    // and a blind 90 s sweep with no feedback produces a low-quality fit anyway.
    // So we just leave mag uncalibrated (identity — no bias/soft-iron
    // correction) and leave BOOT_MAG_CAL_OK unset; the boot-status screen flags
    // it, and the diver runs CAL > Baseline (+ Mounted) from the menu when
    // they're ready.
    bool hasBase = false, hasMount = false;
    if (storage::loadMagCalibrationChain(magCal, hasBase, hasMount)) {
        imu::setMagCalibration(magCal);
        gBootFlags |= BOOT_MAG_CAL_OK;
        Serial.printf("Mag cal loaded: base=%d mount=%d\n", hasBase, hasMount);
    } else {
        magCal.bias = {0, 0, 0};
        magCal.softIron[0][0] = 1; magCal.softIron[0][1] = 0; magCal.softIron[0][2] = 0;
        magCal.softIron[1][0] = 0; magCal.softIron[1][1] = 1; magCal.softIron[1][2] = 0;
        magCal.softIron[2][0] = 0; magCal.softIron[2][1] = 0; magCal.softIron[2][2] = 1;
        imu::setMagCalibration(magCal);
        Serial.println("No mag calibration found — heading will be inaccurate until "
                        "CAL > Baseline (+ Mounted) is run from the menu");
    }
    // Independent of whether a mag cal exists: cal sample collection reads
    // through the same compensation, so a first-ever cal is fitted on
    // temperature-normalized data too.
    loadMagTempCompensation("CAL");

    // Gyroscope
    if (storage::loadCalib3("/gyro_cal.json", gyroCal)) {
        imu::setGyroCalibration(gyroCal);
        gBootFlags |= BOOT_GYRO_CAL_OK;
        Serial.println("Gyro calibration loaded from LittleFS");
    } else {
        delay(2500);  //give the user a second to realize what's happened
        Serial.println("No gyro calibration found — sampling at rest (10 s)");
        delay(2500);  //give the user a second to realize what's happened
        imu::calibrateGyroscope(gyroCal, 10000);
        storage::saveCalib3("/gyro_cal.json", gyroCal);
        // Best-effort cloud archival (calibration-install-sync-plan.md) --
        // in practice this boot-time site always no-ops, since it runs
        // before wifi::init()/web::init() further down in setup(); left in
        // for consistency and in case that ordering ever changes.
        cal_sync::backupIfConnected("gyro_cal_backup", "/gyro_cal.json");
    }

    // Accelerometer
    if (storage::loadCalib3("/accel_cal.json", accelCal)) {
        imu::setAccelCalibration(accelCal);
        gBootFlags |= BOOT_ACCEL_CAL_OK;
        Serial.println("Accel calibration loaded from LittleFS");
    } else {
        delay(2500);  //give the user a second to realize what's happened
        Serial.println("No accel calibration found — 6-point cal");
        delay(2500);  //give the user a second to realize what's happened
        imu::calibrateAccelerometer(accelCal, 2500);
        storage::saveCalib3("/accel_cal.json", accelCal);
        // See the gyro branch above -- same boot-ordering caveat applies.
        cal_sync::backupIfConnected("accel_cal_backup", "/accel_cal.json");
    }

    // Fourier heading calibration (optional — silently skip if absent)
    if (hdg_cal::load(gHdgCal)) {
        gHdgCalValid = true;
        gBootFlags |= BOOT_HDG_CAL_OK;
        Serial.printf("Fourier heading cal loaded (%d harmonic(s))\n", gHdgCal.n);
    }

    // Motor-on heading correction (optional — silently skip if absent, offset defaults to 0)
    if (motor_cal::load(gMotorCal)) {
        Serial.printf("Motor cal loaded (heading offset: %.1f deg)\n", gMotorCal.heading_offset_deg);
    }
    // This one only poisons heading (fmodf of NaN is NaN), not the quaternion,
    // so it presents as a NaN heading with valid pitch/roll -- worth telling
    // apart from an AHRS poisoning at a glance.
    if (!isfinite(gMotorCal.heading_offset_deg)) {
        Serial.printf("[CAL] POISON: motor heading offset = %f -- forcing 0\n",
                      (double)gMotorCal.heading_offset_deg);
        gMotorCal.heading_offset_deg = 0.0f;
    }

    dumpActiveCalibration("CAL");
}

// Reload calibration JSON files without blocking fallbacks.
// Safe to call at runtime (e.g., after uploading a new cal file via web UI).
// Not static -- net/cal_sync.cpp calls this too, via nav_main.h.
void reloadCalibrationFiles() {
    gBootFlags &= ~(BOOT_MAG_CAL_OK | BOOT_GYRO_CAL_OK | BOOT_ACCEL_CAL_OK | BOOT_HDG_CAL_OK);
    gHdgCalValid = false;

    bool hasBase = false, hasMount = false;
    if (storage::loadMagCalibrationChain(magCal, hasBase, hasMount)) {
        imu::setMagCalibration(magCal);
        gBootFlags |= BOOT_MAG_CAL_OK;
        Serial.printf("[Reload] Mag cal: base=%d mount=%d\n", hasBase, hasMount);
    } else {
        Serial.println("[Reload] No mag calibration found");
    }
    loadMagTempCompensation("Reload");

    if (storage::loadCalib3("/gyro_cal.json", gyroCal)) {
        imu::setGyroCalibration(gyroCal);
        gBootFlags |= BOOT_GYRO_CAL_OK;
        Serial.println("[Reload] Gyro cal loaded");
    } else {
        Serial.println("[Reload] No gyro calibration found");
    }

    if (storage::loadCalib3("/accel_cal.json", accelCal)) {
        imu::setAccelCalibration(accelCal);
        gBootFlags |= BOOT_ACCEL_CAL_OK;
        Serial.println("[Reload] Accel cal loaded");
    } else {
        Serial.println("[Reload] No accel calibration found");
    }

    if (hdg_cal::load(gHdgCal)) {
        gHdgCalValid = true;
        gBootFlags |= BOOT_HDG_CAL_OK;
        Serial.printf("[Reload] Fourier heading cal loaded (%d harmonic(s))\n", gHdgCal.n);
    } else {
        Serial.println("[Reload] No Fourier heading cal found");
    }

    gMotorCal = motor_cal::MotorCal{};  // reset to defaults before reload
    if (motor_cal::load(gMotorCal)) {
        Serial.printf("[Reload] Motor cal loaded (heading offset: %.1f deg)\n", gMotorCal.heading_offset_deg);
    } else {
        Serial.println("[Reload] No motor cal found, heading offset = 0");
    }
}

// Average BATT_ADC_AVG_N ADC samples and fold in via EMA.
// GPIO35 reads VBAT through a 2:1 divider, so adc_mV * 2 = battery_mV.
// Call once per sendNavPacket (10 Hz); EMA alpha gives a ~5 s smoothing window.
static void updateBattMv() {
    uint32_t sum = 0;
    for (int i = 0; i < BATT_ADC_AVG_N; i++) sum += analogRead(BATT_ADC_PIN);
    uint32_t raw_adc = sum / BATT_ADC_AVG_N;
    uint16_t sample_mv = (uint16_t)((raw_adc * 3300UL * 2) / 4095);
    if (gBattMv == 0) {
        gBattMv = sample_mv;  // seed EMA on first read
    } else {
        // EMA alpha ≈ 0.02 → ~50-sample (~5 s) smoothing window
        gBattMv = (uint16_t)(gBattMv + (int32_t)(sample_mv - gBattMv) * 2 / 100);
    }
}

// ---------------------------------------------------------------------------
// Current hold
// ---------------------------------------------------------------------------
// End a hold: trim the edges, average what is left, and save it.
//
// heading_deg carries the direction the water flows TOWARD, not the heading the
// diver held. The diver points UPSTREAM, so the compass reads where the current
// comes FROM; turning it round here means every downstream consumer -- the log,
// track-processor, the website -- reads one convention, and none of them has to
// know the upstream one ever existed.
//
// early = the diver ended it (FINISH_CURRENT_HOLD) before the 60 s were up.

static float medianOf(float* v, int n) {
    // n <= 60: insertion sort is fine.
    for (int i = 1; i < n; i++) {
        float x = v[i]; int j = i - 1;
        while (j >= 0 && v[j] > x) { v[j + 1] = v[j]; j--; }
        v[j + 1] = x;
    }
    return (n % 2) ? v[n / 2] : 0.5f * (v[n / 2 - 1] + v[n / 2]);
}

// Written whether or not the dive log is running: a measurement taken with
// logging off must still land somewhere. Download it from tern.local.
static void saveCurrentToFile(uint8_t heldS, bool early, float upstreamDeg) {
    File probe = LittleFS.open(CURRENT_FILE_PATH, "r");
    size_t size = probe ? probe.size() : 0;
    if (probe) probe.close();
    if (size >= CURRENT_FILE_MAX_BYTES) {
        LittleFS.remove(CURRENT_FILE_OLD_PATH);
        LittleFS.rename(CURRENT_FILE_PATH, CURRENT_FILE_OLD_PATH);
        size = 0;
    }

    File f = LittleFS.open(CURRENT_FILE_PATH, "a");
    if (!f) {
        Serial.println("[CURRENT] ERROR: could not open " + String(CURRENT_FILE_PATH));
        return;
    }
    if (size == 0) {
        f.println("timestamp_ms,utc,current_ms,current_m_min,toward_deg,held_deg,"
                  "held_s,kept_s,ended_early,lat,lon,pos_x_m,pos_y_m,depth_m,"
                  "water_temp_c,log_file");
    }

    // The clock is set from GPS or NTP; an unsynced ESP32 sits near epoch 0.
    char utcBuf[24] = "";
    time_t now_t = time(nullptr);
    if (now_t >= 1700000000L) {
        struct tm tm_info{};
        gmtime_r(&now_t, &tm_info);
        strftime(utcBuf, sizeof(utcBuf), "%Y-%m-%dT%H:%M:%SZ", &tm_info);
    }

    nav::Position pos = nav::getPosition();
    bool hasDepth = depth::isPresent();
    f.printf("%lu,%s,%.3f,%.1f,%.1f,%.1f,%u,%u,%d,%.8f,%.8f,%.2f,%.2f,%.2f,%.2f,%s\n",
             (unsigned long)millis(), utcBuf,
             (double)gCurrentHoldResultMs, (double)(gCurrentHoldResultMs * 60.0f),
             (double)gCurrentHoldToward, (double)upstreamDeg,
             (unsigned)heldS, (unsigned)gCurrentHoldKeptS, early ? 1 : 0,
             (double)pos.lat, (double)pos.lon, (double)pos.x_m, (double)pos.y_m,
             hasDepth ? (double)depth::getDepth_m() : 0.0,
             hasDepth ? (double)depth::getTemp_c()  : 0.0,
             logging::getLogPath());
    f.close();
}

static void finishCurrentHold(bool early) {
    gCurrentHoldActive = false;

    uint32_t heldMs = millis() - gCurrentHoldStartMs;
    uint8_t  heldS  = (uint8_t)std::min<uint32_t>(heldMs / 1000, CURRENT_HOLD_BINS);

    // Per-second means, over the seconds that got any samples. An early finish
    // drops the second it happened in: that is the button press itself.
    int lastBin = early ? (int)(heldMs / 1000) - 1 : CURRENT_HOLD_BINS - 1;
    if (lastBin >= CURRENT_HOLD_BINS) lastBin = CURRENT_HOLD_BINS - 1;
    int   idx[CURRENT_HOLD_BINS];
    float mean[CURRENT_HOLD_BINS];
    float scratch[CURRENT_HOLD_BINS];
    int   n = 0;
    for (int i = 0; i <= lastBin; i++) {
        if (gCurrentHoldBins[i].n == 0) continue;
        idx[n]  = i;
        mean[n] = (float)(gCurrentHoldBins[i].flowSum / gCurrentHoldBins[i].n);
        n++;
    }

    gCurrentHoldResultMs = 0.0f;
    gCurrentHoldToward   = 0.0f;
    gCurrentHoldKeptS    = 0;

    if (n == 0) {
        Serial.printf("[CURRENT] no full second held (%lu ms) — nothing to save\n",
                      (unsigned long)heldMs);
    } else {
        // Robust spread: median and MAD of the per-second means.
        memcpy(scratch, mean, n * sizeof(float));
        float med = medianOf(scratch, n);
        for (int i = 0; i < n; i++) scratch[i] = fabsf(mean[i] - med);
        float mad = medianOf(scratch, n);
        float limit = std::max(CURRENT_TRIM_MIN_DEV_MS, 3.0f * 1.4826f * mad);

        // Walk in from each end while the edge second is an outlier. Only the
        // ends: a wobble mid-hold is part of what was held, and the average
        // should carry it.
        int lo = 0, hi = n - 1;
        while (lo < hi && fabsf(mean[lo] - med) > limit) lo++;
        while (hi > lo && fabsf(mean[hi] - med) > limit) hi--;

        double flowSum = 0.0, sinSum = 0.0, cosSum = 0.0;
        uint32_t samples = 0;
        for (int k = lo; k <= hi; k++) {
            const CurrentHoldBin& b = gCurrentHoldBins[idx[k]];
            flowSum += b.flowSum; sinSum += b.sinSum; cosSum += b.cosSum;
            samples += b.n;
        }
        float upstream = atan2f((float)sinSum, (float)cosSum) * (float)(180.0 / M_PI);
        upstream = fmodf(upstream + 360.0f, 360.0f);
        gCurrentHoldResultMs = (float)(flowSum / samples);
        gCurrentHoldToward   = fmodf(upstream + 180.0f, 360.0f);
        gCurrentHoldKeptS    = (uint8_t)(hi - lo + 1);

        Serial.printf("[CURRENT] %.3f m/s (%.1f m/min) toward %.1f (held %03d); "
                      "%u s averaged of %u s held (trimmed %d front, %d back)%s\n",
                      (double)gCurrentHoldResultMs, (double)(gCurrentHoldResultMs * 60.0f),
                      (double)gCurrentHoldToward, (int)upstream,
                      (unsigned)gCurrentHoldKeptS, (unsigned)heldS, lo, n - 1 - hi,
                      early ? ", ended early" : "");

        saveCurrentToFile(heldS, early, upstream);

        if (logging::isLogging()) {
            nav::Position pos = nav::getPosition();
            GpsFix fix = gps::getFix();
            logging::LogData ld{};
            ld.timestamp_ms   = millis();
            ld.heading_deg    = gCurrentHoldToward;
            ld.speed_ms       = gCurrentHoldResultMs;
            ld.gpsSpeed       = false;
            ld.pos_x_m        = pos.x_m;
            ld.pos_y_m        = pos.y_m;
            ld.lat            = pos.lat;
            ld.lon            = pos.lon;
            ld.pos_src        = 'C';
            ld.gps_satellites = fix.has_fix ? fix.satellites : 0;
            ld.gps_hdop       = fix.has_fix ? fix.hdop       : 0.0f;
            ld.depth_m        = depth::isPresent() ? depth::getDepth_m() : 0.0f;
            ld.water_temp_c   = depth::isPresent() ? depth::getTemp_c()  : 0.0f;
            // Same convention as a MARK row: the sensor fields are not sampled here,
            // and a zero die temperature would read as a real -25 degC offset.
            ld.mag_temp_c     = NAN;
            logging::logImmediate(ld);
        } else {
            Serial.println("[CURRENT] not logging — saved to " + String(CURRENT_FILE_PATH) + " only");
        }
    }

    // gInCal deliberately stays set: the NavPacket cal fields are gated on it,
    // so clearing it here would stop the packet that carries the result. The
    // display clears both by sending END_CURRENT_HOLD when the diver dismisses,
    // exactly as speed cal's accept/reject ends cal_mode 4. A no-data finish
    // still goes to 9, so the display can say so rather than silently vanish.
    gCalMode = 9;
}

// Ends the hold UI on the nav side: aborting a run in progress, or releasing the
// result once the diver has seen it. Both are the same state change.
static void cancelCurrentHold() {
    gCurrentHoldActive = false;
    gInCal   = false;
    gCalMode = 0;
    sysState = SystemState::READY;
    Serial.println("[CURRENT] hold ended");
}

static void sendNavPacket(float heading, float headingRaw, float pitch, float roll,
                          float speed, bool gpsSpeed,
                          float distHome, float bearHome,
                          float posX, float posY,
                          const GpsFix& fix) {
    NavPacket pkt{};
    pkt.heading_deg      = heading;
    pkt.heading_raw_deg  = headingRaw;
    if (gHdgCalActive) {
        pkt.level_state     = (uint8_t)gLevelGate.state();
        pkt.level_hold_pct  = gLevelGate.holdPct();
        pkt.level_pitch_deg = gLevelGate.pitchDeg();
        pkt.level_roll_deg  = gLevelGate.rollDeg();
    }
    pkt.pitch_deg        = pitch;
    pkt.roll_deg         = roll;
    pkt.speed_ms         = speed;
    pkt.distance_home_m  = distHome;
    pkt.bearing_home_deg = bearHome;
    pkt.pos_x_m          = posX;
    pkt.pos_y_m          = posY;
    pkt.system_state     = static_cast<uint8_t>(sysState);
    pkt.gps_fix_quality  = fix.fix_quality;
    pkt.gps_satellites   = fix.satellites;
    pkt.gps_signal_bars  = gps::computeSignalBars(fix);
    pkt.uptime_ms        = millis();

    uint8_t flags = 0;
    if (gpsSpeed) flags |= FLAG_GPS_SPEED;
    if (nav::hasHome()) flags |= FLAG_HAS_HOME;
    flags |= FLAG_TRUE_HEADING;  // declination applied in heading calculation
    if (gGpsEnabled)    flags |= FLAG_GPS_ENABLED;
    if (gWifiEnabled)   flags |= FLAG_WIFI_ENABLED;
    flags |= (static_cast<uint8_t>(logging::getLevel()) << FLAG_LOG_LEVEL_SHIFT) & FLAG_LOG_LEVEL_MASK;
    pkt.flags      = flags;
    pkt.boot_flags = gBootFlags;

    // GPS detail fields
    pkt.gps_antenna  = fix.antenna_status;
    float hdop = fix.hdop;
    pkt.gps_hdop_x10 = (hdop <= 0.0f || !fix.has_fix) ? 0
                     : (hdop >= 25.5f) ? 255
                     : (uint8_t)(hdop * 10.0f + 0.5f);

    // WiFi mode: client (connected to stored AP) vs. own AP
    uint8_t flags2 = 0;
    if (gWifiEnabled && wifi::isStaConnected()) flags2 |= FLAG2_WIFI_CLIENT;
    if (depth::isPresent()) {
        flags2 |= FLAG2_DEPTH_PRESENT;
        pkt.depth_m      = depth::getDepth_m();
        pkt.water_temp_c = depth::getTemp_c();
    }
    if (gSaltWater) flags2 |= FLAG2_SALT_WATER;
    if (gDiveMode)  flags2 |= FLAG2_DIVE_MODE;
    if (log_sync::isUploading()) {
        flags2 |= FLAG2_UPLOADING;
        pkt.log_sync_done  = log_sync::doneCount();
        pkt.log_sync_total = log_sync::totalCount();
    }
    pkt.flags2 = flags2;

    updateBattMv();
    pkt.batt_mv = gBattMv;

    // Pack calibration progress when in CALIBRATION state
    if (sysState == SystemState::CALIBRATION && gInCal) {
        pkt.cal_mode = gCalMode;
        if (gCalMode == 0) {
            // Quick cal: progress from non-blocking mag cal state machine
            uint32_t elapsed_ms, remaining_ms;
            int covX, covY, covZ;
            imu::magCalNBGetProgress(elapsed_ms, remaining_ms, covX, covY, covZ);
            pkt.cal_remaining_s  = (uint8_t)(remaining_ms / 1000);
            pkt.cal_coverage_pct = (uint8_t)((covX + covY + covZ) / 3);
        } else if (gCalMode == 1) {
            // Full cal: progress from mag_cal collection
            uint32_t remaining_ms = mag_cal::getRemainingMs();
            pkt.cal_remaining_s   = (uint8_t)(remaining_ms / 1000);
            pkt.cal_coverage_pct  = mag_cal::getSpatialCoverage();
        } else if (gCalMode == 8 || gCalMode == 9) {
            // Current hold: seconds left on the 60 s clock, and the measurement
            // once there is one.
            if (gCalMode == 8) {
                uint32_t heldMs = millis() - gCurrentHoldStartMs;
                uint32_t leftMs = (heldMs >= CURRENT_HOLD_DURATION_MS)
                                  ? 0 : (CURRENT_HOLD_DURATION_MS - heldMs);
                pkt.cal_remaining_s = (uint8_t)((leftMs + 999) / 1000);
                // Live flow, so the diver can watch themselves hold station.
                pkt.current_ms      = flow::getSpeed_ms();
            } else {
                // cal_remaining_s is reused in the result: seconds actually
                // averaged. 0 means nothing was held long enough to measure.
                pkt.cal_remaining_s = gCurrentHoldKeptS;
                pkt.current_ms      = gCurrentHoldResultMs;
            }
            pkt.current_toward_deg = gCurrentHoldToward;
        } else {
            // Speed cal (cal_mode 2/3/4): pack run data
            pkt.speed_cal_dist_ft    = gSpeedCalDist_ft;
            pkt.speed_cal_k_existing = gSpeedCalKExisting;
            pkt.speed_cal_k_proposed = gSpeedCalKProposed;
            if (gCalMode == 3) {
                // Running: send live elapsed time
                uint32_t elapsedMs = millis() - gSpeedCalStartMs;
                pkt.speed_cal_elapsed_s = (elapsedMs / 1000 > 65535) ?
                                          65535 : (uint16_t)(elapsedMs / 1000);
            } else {
                // Waiting (2) or result (4): send recorded elapsed
                pkt.speed_cal_elapsed_s = gSpeedCalElapsedS;
            }
        }
    }

    size_t n = navPacketToBytes(pkt, linkBuf, sizeof(linkBuf));
    if (n > 0) {
        Serial1.write(linkBuf, n);
    } else if (millis() - gLinkOverflowLogMs > 5000) {
        // Never drop the link silently: a packet that doesn't fit looks
        // exactly like a dead cable from the display's side.
        gLinkOverflowLogMs = millis();
        Serial.printf("[LINK] ERROR: NavPacket did not fit in %u bytes (cal_mode %u) — not sent\n",
                      (unsigned)sizeof(linkBuf), (unsigned)pkt.cal_mode);
    }
}

#if ENABLE_DEBUG_PACKET
static void sendDebugPacket(const imu::Vec3f& accel, const imu::Vec3f& gyro,
                            const imu::Vec3f& mag,
                            float headingDeg, float pitchDeg, float rollDeg) {
    DebugPacket dpkt{};
    dpkt.mag_x   = mag.x;
    dpkt.mag_y   = mag.y;
    dpkt.mag_z   = mag.z;
    dpkt.accel_x = accel.x;
    dpkt.accel_y = accel.y;
    dpkt.accel_z = accel.z;
    dpkt.gyro_x  = gyro.x;
    dpkt.gyro_y  = gyro.y;
    dpkt.gyro_z  = gyro.z;
    dpkt.fused_heading_deg = headingDeg;
    // Raw mag heading: atan2(Y, X), no tilt compensation
    float rawRad = atan2f(mag.y, mag.x);
    float rawDeg = rawRad * (180.0f / M_PI);
    if (rawDeg < 0.0f) rawDeg += 360.0f;
    dpkt.raw_mag_heading_deg = rawDeg;
    dpkt.pitch_deg = pitchDeg;
    dpkt.roll_deg  = rollDeg;

    size_t n = debugPacketToBytes(dpkt, linkBuf, sizeof(linkBuf));
    if (n > 0) {
        Serial1.write(linkBuf, n);
    }
}
#endif

// An out-of-cadence 'M' row at pos: the diver's Mark.
static void logMarkRow(const nav::Position& pos) {
    if (!logging::isLogging()) return;
    GpsFix fix = gps::getFix();
    logging::LogData ld{};
    ld.timestamp_ms   = millis();
    ld.heading_deg    = 0.0f;
    ld.speed_ms       = 0.0f;
    ld.gpsSpeed       = false;
    ld.pos_x_m        = pos.x_m;
    ld.pos_y_m        = pos.y_m;
    ld.lat            = pos.lat;
    ld.lon            = pos.lon;
    ld.pos_src        = 'M';
    ld.gps_satellites = fix.has_fix ? fix.satellites : 0;
    ld.gps_hdop       = fix.has_fix ? fix.hdop       : 0.0f;
    ld.depth_m        = depth::isPresent() ? depth::getDepth_m() : 0.0f;
    ld.water_temp_c   = depth::isPresent() ? depth::getTemp_c()  : 0.0f;
    // The sensor fields of a MARK row are not sampled here (they stay zero —
    // a known wart), but a zero die temperature would read as a real -25 degC
    // offset, so say "missing" outright.
    ld.mag_temp_c     = NAN;
    logging::logImmediate(ld);
}

static void sendWaypointListPacket() {
    WaypointListPacket pkt{};
    int n = waypoints::count();
    int toSend = (n > WP_PACKET_MAX) ? WP_PACKET_MAX : n;
    pkt.count       = (uint8_t)toSend;
    pkt.total_count = (uint8_t)(n > 255 ? 255 : n);
    for (int i = 0; i < toSend; i++) {
        const waypoints::Waypoint* wp = waypoints::get(i);
        if (!wp) break;
        pkt.waypoints[i].idx = (uint8_t)i;
        strncpy(pkt.waypoints[i].name, wp->name, 12);
        pkt.waypoints[i].name[12] = '\0';
        pkt.waypoints[i].lat = wp->lat;
        pkt.waypoints[i].lon = wp->lon;
    }
    size_t nb = waypointListPacketToBytes(pkt, wpBuf, sizeof(wpBuf));
    if (nb > 0) Serial1.write(wpBuf, nb);
}

// Enters/exits dive mode (disables/re-enables GPS + WiFi). Shared by the
// manual TOGGLE_OP_MODE command and the automatic depth-based trigger in
// loop() — see config.h DEPTH_DIVE_TRIGGER_M / DEPTH_SURFACE_REVERT_M.
static void setDiveMode(bool dive) {
    if (dive == gDiveMode) return;
    gDiveMode = dive;
    if (gDiveMode) {
        gps::setEnabled(false);
        wifi::stop();
        gWifiEnabled = false;
        Serial.println("[NAV] OP_MODE -> DIVE (GPS+WiFi off)");
    } else {
        gps::setEnabled(true);
        gGpsSessionStartMs = millis();
        wifi::init();
        web::init();
        gWifiEnabled = true;
        Serial.println("[NAV] OP_MODE -> SURFACE (GPS+WiFi on)");
    }
    nvs_nav::save(currentNavNvsState());
}

// Tell the display why a gap-fill session was refused, reusing the cloud-cal
// FAILED screen the diver already knows rather than inventing a packet type
// and a UI state for a message. Nothing has started at this point -- the
// device stays in whatever state it was in, so this is purely informational.
static void sendGapFillRefusal(const char* why) {
    CalCloudResultPacket rpkt{};
    rpkt.cal_type    = (uint8_t)CalType::BASELINE;
    rpkt.stage       = (uint8_t)CalCloudStage::FAILED;
    rpkt.installable = false;   // a gap-fill: the display names step 1a
    strncpy(rpkt.error, why, sizeof(rpkt.error) - 1);
    rpkt.error[sizeof(rpkt.error) - 1] = '\0';

    char buf[512];
    size_t n = calCloudResultPacketToBytes(rpkt, buf, sizeof(buf));
    if (n > 0) Serial1.write(buf, n);
}
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
