djmcmath/dpv-nav/src/config.h

#pragma once

#include <cstdint>

//Compile-time and runtime config defaults

// WiFi configuration
constexpr const char* WIFI_AP_SSID        = "Tern";
constexpr const char* WIFI_AP_PASS        = "password";
constexpr uint32_t    WIFI_STA_TIMEOUT_MS = 10000;

// Flow sensor configuration (hall-effect pulse output)
constexpr float FLOW_K_FACTOR         = 0.224f; // freq_hz = K * flow_lpm (pulses per L/min)
constexpr float FLOW_CROSS_SECTION_M2 = 0.002f;  // Intake cross-section area (m²) — calibrate to match DPV

// Flow speed averaging
constexpr float FLOW_AVG_PERIOD_S = 3.0f;    // EMA time constant (seconds) — smooths out momentary spikes

// Minimum flow speed for dead-reckoning integration.
// Flow readings below this are treated as stationary; position is not updated.
// Only applies when GPS speed is not available — GPS truth updates are unaffected.
// This is mostly for when you're drifting around a wreck, or stationary doing deco somewhere -> result is that if you're below this speed, it won't register.
// -- Side effect, if you're finning from one place to another, you'll probably be below the speed threshold, so position won't update.
constexpr float DR_MIN_FLOW_SPEED_MS = 0.10f;  // ~0.2 kt

// Speed source selection
constexpr uint32_t GPS_FIX_STALE_MS = 3000;      // Fall back to flowmeter if GPS fix older than this

// Position sentences (RMC/GGA) that must parse WITH a fix after the GPS is
// re-enabled before its position is trusted. Guards against the module
// replaying a hot-start cached position on power-up. Both RMC and GGA arrive
// each second, so 3 discards roughly the first 1.5 s after surfacing.
constexpr uint16_t GPS_REACQUIRE_MIN_FIXES = 3;
constexpr float    KNOTS_TO_MS      = 0.514444f;  // knots → m/s conversion factor

// GPS COG (Course Over Ground) coherence filter
// GPS speed is only trusted when recent COG readings are consistent.
// Coherence is the resultant length of unit-vector EMA of COG (0=random, 1=identical).
constexpr float GPS_COG_EMA_ALPHA       = 0.3f;   // EMA smoothing factor (at 1 Hz: ~3-4 sample window)
constexpr float GPS_COG_COHERENCE_THRESH = 0.85f;  // Below this, GPS speed is treated as noise
constexpr float GPS_SOG_NOISE_FLOOR_KN  = 0.1f;   // SOG below this is certainly noise (knots)
constexpr float GPS_SOG_TRUST_FLOOR_KN  = 2.0f;   // SOG above this is trusted regardless of COG (knots)

// Position estimation
constexpr float DEFAULT_BASELINE_LAT     = 47.5889f;   // degrees N (assumed until GPS fix)
constexpr float DEFAULT_BASELINE_LON     = -122.284f;  // degrees W (assumed until GPS fix)
constexpr bool  DEFAULT_USE_GPS_POSITION = true;     // use GPS lat/lon as position truth when available

// Magnetic declination (degrees, positive = East, negative = West)
// Look up your local value at https://www.ngdc.noaa.gov/geomag/declination.shtml
constexpr float DEFAULT_DECLINATION_DEG  = 14.7f;   // ~14.7°E for Seattle area / Lake Washington, as of August 2026.

// Total magnetic field strength, uT. Site-specific, same story as declination:
// the baseline live grid's lock gate checks its fitted radius against it
// (MAG_CAL_BOOT_RADIUS_TOL). 50.1 is measured, not looked up: every 2026-09..10
// accepted baseline fit at the home site, on both units, came out to
// 3420-3444 counts at 68.42 LSB/uT. Elsewhere, the NOAA calculator's total
// intensity (same page as declination) is close enough. Wrong by more than
// the tolerance, the grid simply never appears and baseline shows its bars.
constexpr float MAG_CAL_EXPECTED_FIELD_UT = 50.1f;

// Display mode (compile-time): 0 = Navigation, 1 = Debug
#ifndef DISPLAY_MODE
#define DISPLAY_MODE 0
#endif

// Display buttons: how long a hold must last to count as a long press. The
// two-button display reinit and speed cal's manual start use it, and every cal
// screen's hold-BTN1-to-discard (QUIT, REJECT; util/cal_keys.h) does too.
constexpr uint32_t LONG_PRESS_MS = 2000;

// How often the LIS3MDL die temperature is re-read (a separate I2C read; the
// field is read every loop pass). Temperature moves over seconds.
constexpr uint32_t MAG_TEMP_READ_INTERVAL_MS = 250;

// Enable debug packet transmission from nav device (0 = off, 1 = on)
#ifndef ENABLE_DEBUG_PACKET
#define ENABLE_DEBUG_PACKET 0
#endif

// Debug packet send interval (ms) — can be slower than nav packet
constexpr uint32_t DEBUG_SEND_INTERVAL_MS = 200;  // 5 Hz

// NVS position save interval (ms) — how often estimated position is persisted to NVS
constexpr uint32_t NVS_POS_SAVE_INTERVAL_MS = 30000;  // 30 seconds

// Data logging intervals (ms) — minimum time between log entries per level
constexpr uint32_t LOG_LOW_INTERVAL_MS  = 1000;   // 1 entry per second (LOW level)
constexpr uint32_t LOG_MID_INTERVAL_MS  = 1000;   // 1 entry per second (MID level)
constexpr uint32_t LOG_HIGH_INTERVAL_MS = 1000;   // 1 entry per second (HIGH level)
// MID and HIGH write the same 77-byte binary record (util/log_record.h):
// ~270 KiB/hour, so a two-hour dive is ~540 KiB of the 768 KiB LittleFS
// partition (partitions_nav.csv). As CSV those rows were ~240 bytes and ran the
// partition dry in under an hour. Nothing prunes while a log is open --
// cleanupOldLogs() runs at boot only -- so that space has to be free at the start.

// Idle gate for LOW and MID (util/log_idle.h): once the unit has been on the
// surface, with a GPS position, not moving, for LOG_IDLE_ENTER_MS, rows drop
// from the per-level rate to one per LOG_IDLE_HEARTBEAT_MS. Any one condition
// failing restores full rate on that sample. HIGH is never gated.
constexpr float    LOG_IDLE_MAX_DEPTH_M  = 1.0f;    // shallower than this counts as surfaced
constexpr float    LOG_IDLE_MAX_SPEED_MS = 0.0f;    // speed is exactly 0 below DR_MIN_FLOW_SPEED_MS
// GPS scatter at a standstill is a few metres; carrying the scooter up the
// beach is not. Stays under the track processor's HOLD_MAX_DRIFT_M (30 m).
constexpr float    LOG_IDLE_MAX_DRIFT_M  = 15.0f;
// Also how many full-rate rows the surfacing GPS fix gets before idle begins --
// those rows are what the track correction anchors on.
constexpr uint32_t LOG_IDLE_ENTER_MS     = 60000;
constexpr uint32_t LOG_IDLE_HEARTBEAT_MS = 60000;   // 1 entry per minute while idle

// How long a LOW, MID or HIGH selection must be left alone before a log file is
// actually opened. CONFIG > Log cycles OFF -> LOW -> MID -> HIGH -> OFF, so reaching
// any given level means passing *through* the others; opening on the keypress
// left a stub file every time a diver went past a level on the way to the one
// they wanted. The level shown on screen still changes immediately, and OFF
// still stops logging on the spot — only opening a new file waits.
constexpr uint32_t LOG_COMMIT_DELAY_MS  = 5000;   // 5 s settle before a file opens


// ---------------------------------------------------------------------------
// Magnetometer calibration bin parameters
// ---------------------------------------------------------------------------

// Sample threshold per bin — green = fully covered, yellow = partial, red = sparse
constexpr uint8_t MAG_CAL_BIN_GREEN_THRESHOLD  = 18;  // samples for "green" (fully covered)
constexpr uint8_t MAG_CAL_BIN_YELLOW_THRESHOLD = 7;   // samples for "yellow" (partial)

// The bin-cal sample buffer (baseline, gap-fill and mounted share it). Baseline
// ends when it fills, so the display counts toward it in the cal header.
constexpr int MAG_CAL_BIN_MAX_SAMPLES = 60 * MAG_CAL_BIN_GREEN_THRESHOLD * 2;  // 2160

// Baseline cal: 12 heading sectors × 5 elevation bands = 60 bins
// Elevation bands (degrees pitch): <-60, -60..-30, -30..+30 (level), +30..+60, >+60
constexpr int MAG_CAL_BASELINE_HDG_SECTORS = 12;
constexpr int MAG_CAL_BASELINE_ELEV_BANDS  = 5;
constexpr int MAG_CAL_BASELINE_BINS        = MAG_CAL_BASELINE_HDG_SECTORS * MAG_CAL_BASELINE_ELEV_BANDS;  // 60

// Mounted cal: 12 heading sectors × 3 elevation rows = 36 cells. The rows are
// the attitude windows in the "Mounted dwell capture" block below, not bands
// that tile the pitch axis: between rows nothing is recorded.
constexpr int MAG_CAL_MOUNTED_HDG_SECTORS  = 12;
constexpr int MAG_CAL_MOUNTED_ELEV_BANDS   = 3;
constexpr int MAG_CAL_MOUNTED_BINS         = MAG_CAL_MOUNTED_HDG_SECTORS * MAG_CAL_MOUNTED_ELEV_BANDS;  // 36

// Elevation band boundaries (degrees, applied to AHRS pitch)
// Baseline: [-90, -60, -30, +30, +60, +90]  → 5 bands
// Mounted:  any pitch outside [-30, +30] range snaps to upper/lower band (no >60° band)
constexpr float MAG_CAL_ELEV_L2 = -60.0f;  // boundary between lowest and low band
constexpr float MAG_CAL_ELEV_L1 = -30.0f;  // boundary between low and level band
constexpr float MAG_CAL_ELEV_H1 = +30.0f;  // boundary between level and high band
constexpr float MAG_CAL_ELEV_H2 = +60.0f;  // boundary between high and highest band

// Weight for out-of-range samples in mounted cal fit (pitch beyond ±30°)
// 0.0 = exclude, 1.0 = full weight
constexpr float MAG_CAL_MOUNTED_OOR_WEIGHT = 0.25f;

// Weighted completion thresholds — number of green sectors required per elevation row.
// The level row must be fully covered; tilted rows allow partial coverage because
// DPV operation is primarily horizontal and extreme orientations are hard to achieve.
// Rationale: ±60° samples constrain the magnetometer Z-axis response, which matters
// less for near-horizontal DPV operation. Collecting any samples at extreme tilt
// still improves fit quality; requiring 100% is unnecessary.
//
//   Level (0°):     12/12 = 100%  — must be fully covered for reliable horizontal heading
//   ±30° rows:      12/12 = 100%  — mounted only; see below
//   ±60° rows:       3/12 =  25%  — baseline only
//
// The ±30° rows were 6/12 (no gap over MAG_CAL_DWELL_TILT_MAX_GAP_SECTORS) until
// 2026-11-09, when the unified cal screens made every empty mounted cell red and
// added FINISH, so the diver can stop at any time. Whether the tilted rows earn
// their time is an open analysis (backlog: "Mounted cal: do the tilted rows earn
// their time?"); until it is done, fill them. Dropping this back needs no other
// change: mounted_dwell.h and its tests are written in terms of it.
constexpr int MAG_CAL_SECTORS_LEVEL   = 12;  // 100% — level row
constexpr int MAG_CAL_SECTORS_MID     = 12;  // 100% — ±30° rows (mounted)
constexpr int MAG_CAL_SECTORS_EXTREME =  3;  //  25% — ±60° rows (baseline only)
// Note: extreme rows need only 3/12 sectors because DPV operation rarely exceeds ±45°
// pitch.  A handful of extreme-tilt samples is enough to constrain the Z-axis of the
// ellipsoid fit without requiring sustained upside-down maneuvers.

// ---------------------------------------------------------------------------
// Mounted dwell capture (2026-10-11) — see
// divemap/docs/architecture/mounted-cal-dwell-plan.md, Part A, and
// src/util/mounted_dwell.h, which implements it.
//
// The mounted fit takes "down" from the accelerometer, so a sample taken while
// the scooter is being moved carries a false tilt, and 1° of false tilt leaks
// about 5% of the horizontal field into the fit. The collector therefore
// records nothing until the unit has sat still inside a row's attitude window,
// and then takes one cell's MAG_CAL_BIN_GREEN_THRESHOLD samples in one go.
//
// Every limit here is deliberately tighter than the server's
// (callib/fit.py: 8°/s, 0.03 g, ±15° level window), so the server never drops
// a sample the unit accepted. Nothing forces the two to agree — the server
// reports any it had to drop on the calibration's web page.
// ---------------------------------------------------------------------------

// "Still": all three must hold.
constexpr float MAG_CAL_DWELL_GYRO_DPS       = 5.0f;   // gyro magnitude, deg/s
constexpr float MAG_CAL_DWELL_ACCEL_DEV_G    = 0.02f;  // | |a| - 1 g |
constexpr float MAG_CAL_DWELL_ACCEL_JITTER_G = 0.02f;  // peak-to-peak, worst axis, over the window

// Accel history the jitter test and the attitude both use: 25 ticks of the
// 100 Hz loop = 250 ms. The attitude is this window's mean, which is what
// smooths the on-screen horizon.
constexpr int MAG_CAL_DWELL_WINDOW_TICKS = 25;

// Still for this long before the first sample is taken.
constexpr uint32_t MAG_CAL_DWELL_SETTLE_MS = 400;

// Attitude windows, from accel-only pitch and roll (mag_orient::pitchRollDeg).
// Level is ±10° on both axes; the tilted rows are ±10° of pitch about ±30°,
// with a looser roll because they are propped by hand.
constexpr float MAG_CAL_DWELL_LEVEL_TOL_DEG    = 10.0f;
constexpr float MAG_CAL_DWELL_TILT_CENTER_DEG  = 30.0f;
constexpr float MAG_CAL_DWELL_TILT_PITCH_TOL_DEG = 10.0f;
constexpr float MAG_CAL_DWELL_TILT_ROLL_TOL_DEG  = 15.0f;

// A dwell will not START within this many degrees of a heading-sector edge.
// Heading noise at an edge would otherwise flip the cell mid-dwell and discard
// it, and two neighbouring cells could be filled from the same heading.
constexpr float MAG_CAL_DWELL_HDG_GUARD_DEG = 3.0f;

// A tilted row is complete at MAG_CAL_SECTORS_MID cells with no run of empty
// headings wider than this between filled ones: 3 sectors = 90°. With
// MAG_CAL_SECTORS_MID at 12 every cell is filled, so the gap rule cannot bite;
// it matters again only if the analysis brings the cell count back down.
constexpr int MAG_CAL_DWELL_TILT_MAX_GAP_SECTORS = 3;

// The on-screen motion bar holds its peak this long so it does not flicker.
constexpr uint32_t MAG_CAL_DWELL_MOTION_HOLD_MS = 300;

// ---------------------------------------------------------------------------
// 12-point heading cal: level gate (util/level_gate.h)
//
// The Fourier correction is a function of heading only, so it can't tell an
// attitude change from a heading error: a point marked tilted is fitted as
// heading error. BTN2 marks a point only once the unit is level within
// HDG_CAL_LEVEL_TOL_DEG on both axes (accel-only pitch/roll) and has been
// still (the MAG_CAL_DWELL_* terms above) for HDG_CAL_LEVEL_SETTLE_MS.
// ---------------------------------------------------------------------------

// Pitch and roll window, each axis. First guess (2026-10-20): by a rough
// estimate 5 deg of tilt costs ~1.5 deg of heading on an imperfect mount cal,
// so 3 keeps it near 1. Widen it if a scooter on an ordinary floor can't make
// it.
constexpr float HDG_CAL_LEVEL_TOL_DEG = 3.0f;

// Level and still for this long before BTN2 will mark. Longer than mounted's
// 400 ms on purpose: after a 30 deg turn the AHRS heading is still converging
// on the magnetometer for a second or two (Mahony kp = 1), and the mark
// records that heading.
constexpr uint32_t HDG_CAL_LEVEL_SETTLE_MS = 1500;

// false = the gate still shows NOT LEVEL / HOLD STILL, and the CSV still
// records pitch/roll per point, but BTN2 marks regardless. For a deliberate
// off-level test run: does attitude move the heading error?
constexpr bool HDG_CAL_LEVEL_GATE = true;

// ---------------------------------------------------------------------------
// Baseline cal (2026-07-25) — no live grid; see
// divemap/docs/architecture/baseline-cal-coverage-feedback-plan.md and the
// SPIKE comment block in imu.cpp for the three earlier on-device attempts
// (raw-vector Fibonacci lattice binning, fixed-body-axis elevation/azimuth
// binning, two-pass ROUGH_SCAN->COLLECT handoff) that led here.
// ---------------------------------------------------------------------------

// ROUGH_SCAN (baseline's only phase, ungraded raw collection) must gather at
// least this many samples before magBinCalFinishBaseline() will act on a
// "done" request — a floor against an accidental/premature finish, not a real
// quality bar (the real bar is calibration-processor's server-side grading).
// Mirrors calibration-processor's MIN_BASELINE_SAMPLES (fit.py) loosely.
constexpr int MAG_CAL_ROUGH_SCAN_MIN_SAMPLES = 40;

// Expected raw-count spread per axis for a full-sphere sweep, used only to
// turn ROUGH_SCAN's running min/max into a 0-100% coverage bar per axis.
// Same constant and same purpose as the legacy single-stage NB_EXPECTED_RANGE
// in imu.cpp — not re-deriving a new number, reusing the known-good one.
constexpr float MAG_CAL_ROUGH_SCAN_EXPECTED_RANGE = 6800.0f;

// ---------------------------------------------------------------------------
// Baseline live grid (2026-11-06) -- docs/baseline-live-grid-plan.md.
// ROUGH_SCAN refits a sphere to everything stored every REFIT_EVERY samples;
// once the fit passes the lock gate below, baseline switches to
// BASELINE_GRID and bins each sample the way gap-fill does, against that
// in-session bias. Logic: src/util/baseline_boot.h. Every value here is
// mirrored by dive-map's calibration-processor/tools/
// baseline_bootstrap_replay.py, which tools/baseline_boot_test checks the
// firmware against -- change both or the test fails.
// ---------------------------------------------------------------------------

// Refit cadence, in stored samples (~2.5 s at the 10 Hz mag rate).
constexpr int MAG_CAL_BOOT_REFIT_EVERY = 25;

// No lock before this many stored samples. The 2026-11-05 replay locked at
// 50-75 on every real baseline it was given.
constexpr int MAG_CAL_BOOT_MIN_SAMPLES = 50;

// The fitted radius must be within this fraction of MAG_CAL_EXPECTED_FIELD_UT.
// This is the gate that matters: a single-axis spin puts the samples on a
// ring, and the sphere through a ring has the horizontal field's radius
// (0.39x at this site's 67 deg dip), not the total field's.
constexpr float MAG_CAL_BOOT_RADIUS_TOL = 0.10f;

// ...and the samples' directions from the fitted centre must span all three
// dimensions: the smallest eigenvalue of their mean outer product (1/3 = the
// whole sphere, 0 = one plane) must reach this. The radius gate alone misses
// a spin about a horizontal axis -- e.g. rolling the tube while pointed north
// -- whose ring is 0.92x the field at this dip, passes, and locks ~20 uT off.
// Perfect rings score 0.000-0.002; the five real baselines scored 0.010-0.094
// where they locked; any wobble of 5 deg or more already fits correctly.
constexpr float MAG_CAL_BOOT_MIN_SPREAD = 0.004f;

// The bias must have moved less than this since the previous refit to lock.
constexpr float MAG_CAL_BOOT_STABLE_UT = 2.0f;

// After lock, a refit whose bias has moved this far from the one the grid was
// binned with replaces it and re-bins every stored sample. This is the
// backstop for a lock the radius gate let through: a ring close to a great
// circle can pass it while ~20 uT off. A normal tumble wanders ~1.5 uT.
constexpr float MAG_CAL_BOOT_REBIN_UT = 3.0f;

// After lock, a (cell, roll sector) stops accepting at this multiple of the
// "finished" threshold gap-fill uses (MAG_CAL_GAPFILL_TARGET_CAP upright,
// _OTHER_ROLL elsewhere), so easy orientations can't fill the buffer before
// the hard ones are reached. 2x was chosen on the five replay runs: it drops
// 3-11% of samples, leaves the server's RMS unchanged, and moves no aimable
// heading more than 1.6 deg (median <= 0.04). 1x dropped 20-30% and bent the
// fit up to 17 deg in sparse orientations. 0 = accept everything.
constexpr int MAG_CAL_BOOT_CEILING_MULT = 2;

// ---------------------------------------------------------------------------
// Guided gap-fill (2026-08-24) — a second baseline pass that patches only the
// cells the server flagged. See divemap/docs/architecture/
// baseline-cal-coverage-feedback-plan.md Phase 2 and src/util/mag_cal_orient.h.
// ---------------------------------------------------------------------------

// Per-cell acceptance caps. Gap-fill exists because unbalanced bins make fits
// worse, so it must not create the next over-weighted bin on its way to
// filling an empty one: a targeted cell stops accepting once it has enough to
// constrain the fit locally, and an untargeted cell takes only a token amount.
//
// The untargeted allowance is not zero on purpose — a diver sweeping toward a
// target passes through neighbouring cells, and a few samples of free context
// costs nothing while a hard zero would throw away good data for no reason.
//
// TARGET_CAP sits just under MAG_CAL_BIN_GREEN_THRESHOLD (18) rather than at
// it: the server's own adequacy floor is a *median-relative* threshold
// (callib/coverage.py's MIN_UNDERREP_RATIO/MIN_BIN_FLOOR), so there is no
// device-side number that can be exactly right. Under-shooting slightly and
// letting the server re-grade the merged result is the honest option;
// over-shooting would recreate the imbalance.
constexpr uint8_t MAG_CAL_GAPFILL_TARGET_CAP     = 15;
constexpr uint8_t MAG_CAL_GAPFILL_UNTARGETED_CAP = 4;

// A gap-fill session must gather at least this many samples before the diver's
// "done" is honoured — same floor-not-quality-bar role as
// MAG_CAL_ROUGH_SCAN_MIN_SAMPLES, but lower, because a gap-fill pass is
// legitimately small (it patches a handful of cells, not a whole sphere).
constexpr int MAG_CAL_GAPFILL_MIN_SAMPLES = 20;

// ---------------------------------------------------------------------------
// Roll coverage (2026-08-26) — gap-fill's grid tracks only 2 of the 3
// orientation degrees of freedom that matter for ellipsoid calibration:
// elevation and heading of the tracked axis. Roll (spin about that axis)
// never enters elevBand/hdgSector by design (that's what makes tilt
// compensation work), so a cell could show fully green while every sample
// came from the same roll — a real, previously invisible blind spot in what
// "green" proves about coverage. See dive-map's callib/coverage.py
// (ROLL_SECTORS, UPRIGHT_ROLL_WEIGHT) — this must match it exactly, same
// verbatim-port discipline as everything else keyed off mag_cal_orient.h.
// ---------------------------------------------------------------------------

// Upright / right-side / upside-down / left-side — reuses the plain-language
// vocabulary docs/dev-calibration-guide.md's accelerometer-calibration section
// (and the `accel_orient` serial diagnostic) already established.
constexpr int MAG_CAL_ROLL_SECTORS = 4;

// Upright needs this many times the samples of each other roll sector before
// a cell counts as adequately covered — closing the roll blind spot only
// needs enough angular diversity to break the single-roll degeneracy, not
// dense sampling at every roll, and most natural handling is upright-biased
// anyway. Unvalidated starting default, same caveat as
// MAG_CAL_GAPFILL_TARGET_CAP below — needs tuning against a real collection
// corpus. Must match dive-map's UPRIGHT_ROLL_WEIGHT.
constexpr int MAG_CAL_UPRIGHT_ROLL_WEIGHT = 3;

// Per-roll-sector acceptance cap during a live gap-fill session for the
// three non-upright sectors (device-local live-session bookkeeping; separate
// from the server's adequacy floor in cal_targets.json — see
// MAG_CAL_GAPFILL_TARGET_CAP's comment for why the two can't be the same
// number). MAG_CAL_GAPFILL_TARGET_CAP above is the upright sector's cap;
// each other roll sector gets a fraction of it, matching
// MAG_CAL_UPRIGHT_ROLL_WEIGHT.
constexpr uint8_t MAG_CAL_GAPFILL_TARGET_CAP_OTHER_ROLL =
    MAG_CAL_GAPFILL_TARGET_CAP / MAG_CAL_UPRIGHT_ROLL_WEIGHT;  // 5

// ---------------------------------------------------------------------------
// GPS signal quality scoring
// ---------------------------------------------------------------------------
// computeSignalBars() produces a 0–4 bar count from a GpsFix.
// Each component gets a score in [0.0, 1.0], then a weighted sum maps to bars.
//
// NOTE: SNR scoring is defined here but NOT applied — the Adafruit GPS library
// marks GSV sentences as "known but not parseable", so no SNR data is available.
// Weights below are renormalized over the three active components (HDOP / fix / sats).
// Re-enable GPS_WEIGHT_SNR (and renormalize) when SNR becomes available.

// Fix type (GpsFix.fix_type_3d: 1=no fix, 2=2D, 3=3D)
constexpr float GPS_SCORE_FIX_NONE = 0.00f;
constexpr float GPS_SCORE_FIX_2D   = 0.45f;
constexpr float GPS_SCORE_FIX_3D   = 1.00f;

// HDOP (lower = better; score drops in bands)
constexpr float GPS_HDOP_THRESH_1  = 0.8f;  constexpr float GPS_HDOP_SCORE_1  = 1.00f;
constexpr float GPS_HDOP_THRESH_2  = 1.2f;  constexpr float GPS_HDOP_SCORE_2  = 0.90f;
constexpr float GPS_HDOP_THRESH_3  = 1.8f;  constexpr float GPS_HDOP_SCORE_3  = 0.70f;
constexpr float GPS_HDOP_THRESH_4  = 2.5f;  constexpr float GPS_HDOP_SCORE_4  = 0.45f;
constexpr float GPS_HDOP_THRESH_5  = 4.0f;  constexpr float GPS_HDOP_SCORE_5  = 0.20f;
constexpr float GPS_HDOP_SCORE_BAD = 0.00f; // HDOP > 4.0

// Satellites used (from GGA)
constexpr float GPS_SAT_SCORE_LE3  = 0.00f; // <= 3
constexpr float GPS_SAT_SCORE_4    = 0.25f;
constexpr float GPS_SAT_SCORE_5    = 0.45f;
constexpr float GPS_SAT_SCORE_6    = 0.65f;
constexpr float GPS_SAT_SCORE_7    = 0.80f;
constexpr float GPS_SAT_SCORE_GE8  = 1.00f; // >= 8

// SNR scores (median dBHz — not currently enforced; see NOTE above)
constexpr float GPS_SNR_THRESH_20  = 20.0f;  constexpr float GPS_SNR_SCORE_LT20 = 0.00f;
constexpr float GPS_SNR_THRESH_25  = 25.0f;  constexpr float GPS_SNR_SCORE_20   = 0.25f;
constexpr float GPS_SNR_THRESH_30  = 30.0f;  constexpr float GPS_SNR_SCORE_25   = 0.50f;
constexpr float GPS_SNR_THRESH_35  = 35.0f;  constexpr float GPS_SNR_SCORE_30   = 0.75f;
constexpr float GPS_SNR_SCORE_GE35 = 1.00f;

// Component weights (must sum to 1.0 across active components)
// Original: HDOP=45%, fix=20%, sats=15%, SNR=20% → active total = 80%
// Renormalized: 45/80, 20/80, 15/80
constexpr float GPS_WEIGHT_HDOP = 0.5625f;  // 45 / 80
constexpr float GPS_WEIGHT_FIX  = 0.2500f;  // 20 / 80
constexpr float GPS_WEIGHT_SATS = 0.1875f;  // 15 / 80
// constexpr float GPS_WEIGHT_SNR = 0.2000f; // 20 / 100 — disabled

// Sanity caps (applied after weighted score → bar conversion)
constexpr float GPS_CAP_HDOP_THRESH  = 2.5f;  // HDOP above this → max 1 bar
constexpr int   GPS_CAP_HDOP_MAX_BARS = 1;
constexpr int   GPS_CAP_2D_MAX_BARS   = 2;    // 2D-only fix → max 2 bars
// SNR cap (GPS_SNR_THRESH_25 → max 2 bars) — not enforced while SNR is unavailable

// GPS position confidence gate
// Before accepting a GPS position update, we require a minimum bar count that
// scales with how recently we last had a good fix (confidence). A 4-bar fix sets
// confidence to 1.0; a 2-bar fix sets it to 0.5. Confidence then decays linearly
// to zero over GPS_CONFIDENCE_DECAY_S seconds. Required bars = ceil(confidence × 4),
// floored at GPS_POS_MIN_ACCEPT_BARS so we never accept a truly poor fix even after
// a long gap (e.g. when resurfacing after a dive and the first fix is mediocre).
constexpr float   GPS_CONFIDENCE_DECAY_S  = 120.0f;  // seconds from accepted fix to full decay
constexpr uint8_t GPS_POS_MIN_ACCEPT_BARS = 2;        // floor: never accept fewer than this

// ---------------------------------------------------------------------------
// Battery voltage indicator thresholds (millivolts, single-cell LiPo on Feather v1 BAT pin)
// GPIO35 reads VBAT/2 via the onboard 2:1 divider; adjust if battery type differs.
// ---------------------------------------------------------------------------
constexpr uint16_t BATT_MV_FULL   = 4200;  // fully charged (100%)
constexpr uint16_t BATT_MV_EMPTY  = 3200;  // protection cutoff (0%)
constexpr uint16_t BATT_MV_GREEN  = 3700;  // >= green (good)
constexpr uint16_t BATT_MV_YELLOW = 3400;  // >= yellow (moderate); below = red (low)
constexpr int      BATT_ADC_AVG_N = 8;     // samples averaged per battery reading

// ---------------------------------------------------------------------------
// Speed calibration thresholds
// ---------------------------------------------------------------------------

// Flow sensor pulse frequency (Hz) above which we consider the DPV to be moving and start the run.
// Below this on start: stay in WAITING state.
// Raw pulse count threshold works even if k-factor calibration is wrong.
constexpr float SPEED_CAL_START_THRESHOLD_HZ  = 2.0f;   // ~5 pulses/sec — very low, just needs tiny flow

// Flow speed (m/s) below which we consider the DPV stopped (end of run).
// Fraction of start threshold — catches a clean stop without false-triggering
// on momentary deceleration mid-run.
constexpr float SPEED_CAL_STOP_THRESHOLD_MS   = 0.08f;  // ~0.15 kt

// Heading deviation (degrees) from EMA baseline that triggers end of run.
// Only checked after SPEED_CAL_MIN_RUN_S seconds have elapsed.
constexpr float SPEED_CAL_HEADING_STOP_DEG    = 90.0f;

// Minimum run duration (seconds) before heading-change stop is checked.
// Prevents early termination due to heading wobble at run start.
constexpr float SPEED_CAL_MIN_RUN_S           = 30.0f;

// EMA alpha for heading tracking during the speed cal run.
// Low alpha = slow-moving reference that represents the "stable" course.
constexpr float SPEED_CAL_HDG_EMA_ALPHA       = 0.02f;

// ---------------------------------------------------------------------------
// Depth sensor (BlueRobotics Bar30 / MS5837-30BA)
// ---------------------------------------------------------------------------

// Water density used to convert pressure -> depth. Selectable at runtime
// via the CONFIG > Water menu toggle (see sensors/depth.h setSaltWater()).
constexpr float WATER_DENSITY_FRESH_KG_M3 = 997.0f;
constexpr float WATER_DENSITY_SALT_KG_M3  = 1025.0f;
constexpr bool  DEFAULT_SALT_WATER        = true;  // saltwater diving is the primary use case

// Depth-driven surface<->dive mode transition (disables GPS+WiFi in dive
// mode). Both thresholds sit well below the surface swim on purpose: with the
// mast up the depth sensor rides at 0.3-1.5 m in the wave-wash (2026-11-08
// log peaked at 1.48 m), and the old 1.3 m trigger kept dropping into dive
// mode there, then made the diver hold the unit under 0.6 m for 30 s to get
// GPS back. A real descent goes through 3 m in seconds, so a few extra metres
// with the radios on costs nothing.
//   - Enter at 3 m, immediately: no dwell, nothing at the surface reaches it.
//   - Exit below 2 m for 15 s: shallower than a 3-5 m safety stop, so a stop
//     stays in dive mode (BTN2 Mark, cal hidden), and the 1 m gap between the
//     two thresholds stops it flapping. At the surface the sensor never
//     reaches 2 m, so wave surges don't keep restarting the 15 s count.
// Not the OTA "unit is underwater" gate -- that is DEPTH_OTA_UNDERWATER_M.
constexpr float DEPTH_DIVE_TRIGGER_M         = 3.0f;   // ~10 ft — crossing this enters dive mode immediately
constexpr float DEPTH_SURFACE_REVERT_M       = 2.0f;   // ~6.5 ft — must stay shallower than this...
constexpr float DEPTH_SURFACE_REVERT_DWELL_S = 15.0f;  // ...for this long before reverting to surface mode
constexpr float DEPTH_OTA_UNDERWATER_M       = 0.6f;   // ~2 ft — OTA refused deeper than this

// ---------------------------------------------------------------------------
// Cloud calibration (docs/cloud-calibration-plan.md)
// ---------------------------------------------------------------------------

// divemap backend host. No scheme -- cloud_client builds the full HTTPS URL.
constexpr const char* CLOUD_API_HOST     = "map.terndiving.com";
constexpr uint16_t    CLOUD_API_PORT     = 443;
constexpr uint32_t    CLOUD_HTTP_TIMEOUT_MS = 15000;  // per-request timeout
// Streamed-upload retry policy (net/cloud_client.cpp postUploadStreamed).
// HTTPClient reports every body-send failure as -3, and a cal CSV that fails
// mid-body leaves no server-side row at all, so one clean re-POST is worth
// more than a perfect diagnosis. Safe to repeat: the backend dedupes on
// content hash and answers identical bytes with 409 + the existing upload_id.
// Retries cover transport failures only, never an HTTP status.
// softAP suspension during uploads: TESTED AND DISPROVEN 2026-09-18, left in
// place (off) so nobody re-derives it. A single gap-fill run produced the A/B
// directly: attempt 1 with the AP up stalled at 7300 bytes consumed, attempts
// 2 and 3 with the AP suspended stalled at 5840 -- same failure, same place.
// The radio sharing is not what wedges these uploads. Turning it on up front
// was actively harmful (-1, never reached the server at all), which is why the
// suspend now only ever arms on a retry.
constexpr bool        CLOUD_UPLOAD_SUSPEND_AP    = false;
constexpr uint32_t    WIFI_AP_SUSPEND_SETTLE_MS  = 50;
constexpr uint32_t    WIFI_AP_SUSPEND_VERIFY_MS  = 400;  // re-confirm the STA link this long
// Attempts and delay are a nav-loop budget, not just a retry policy: every one
// of these blocks the nav main loop, which stops NavPackets and eventually
// costs the diver their heading. While the cal UI is up, display_main's
// awaitingCloudCal term in linkAlive suppresses NO LINK with no time bound at
// all, so the budget is not really about that screen -- it is about the diver
// pressing out of it mid-upload, which drops the override and leaves NAV_TIMEOUT_MS
// (5 s) governing a loop that is still blocked. That is exactly what produced
// the NO LINK scare on 2026-09-17.
// Worst case with the timeouts below: 20 s + 1 s + 20 s + 0.25 s + 5 s ~= 46 s
// of blocked loop. Two attempts is the ceiling that keeps it there; a third
// would put it past a minute again, and with the connect timeout finally
// reaching socket_timeout (see CLOUD_UPLOAD_CONNECT_TIMEOUT_MS) a third attempt
// buys much less than it used to.
constexpr int         CLOUD_UPLOAD_ATTEMPTS      = 2;
constexpr uint32_t    CLOUD_UPLOAD_RETRY_DELAY_MS = 1000;

// The -3, finally traced end to end through the framework (2026-09-18, from a
// CORE_DEBUG_LEVEL=4 serial capture plus the arduino-esp32 sources):
//
//   HTTPClient::_connectTimeout        default HTTPCLIENT_DEFAULT_TCP_TIMEOUT = 5000
//     -> WiFiClientSecure::connect(host, port, timeout)   sets _timeout
//       -> start_ssl_client(..., timeout, ...)            sets socket_timeout
//         -> send_ssl_data() already loops patiently on WANT_READ/WANT_WRITE
//            with vTaskDelay(2) -- and gives up the moment
//            millis() - write_start > socket_timeout
//           -> WiFiClientSecure::write() sees < 0, calls stop(), returns 0
//             -> HTTPClient logs "short write, asked for 1460 but got 0
//                retry...", waits delay(1), and writes again into a socket it
//                has just closed -- which is why the retry fails 9 ms later
//                with no diagnosis and the caller sees a bare -3.
//
// So the body send was never impatient; it was patient for exactly 5000 ms.
// That is the 5.04 s the capture measured between " connected to
// map.terndiving.com:443" and the first short write, to within a rounding
// error. Note what does NOT reach it: https.setTimeout(CLOUD_HTTP_TIMEOUT_MS)
// only sets _tcpTimeout and, once connected, the socket's SO_SNDTIMEO --
// socket_timeout is fixed at connect time from _connectTimeout and nothing
// else, so setConnectTimeout() is the single handle on how long a stalled
// upload is allowed to wait. It is a misleading name here: on this stack it
// governs the whole session, not just the TCP connect.
//
// Sized from the server-side packet capture rather than a round number: the
// server ACKed everything within ~25 ms while the device retransmitted on RTO
// backoff (1.72 s, then 4.0 s) because those ACKs were not reaching it. The
// third backoff lands near 8 s and the fourth near 16 s -- both past the old
// 5 s cap, so the transfer was being abandoned one or two retransmits short of
// its next chance to recover.
//
// TRIED AT 20000 AND IT DID NOT HELP -- recorded here so it is not retried.
// 0.7.15 on the bench: connect at t=75865, first short write at t=95908, i.e.
// 20,043 ms against the 20,000 ms constant, which proves the trace above is
// right to the millisecond. But `consumed` was still 5840 -- the same 4 x 1460
// as at the 5 s cap. The device made *zero* progress for twenty seconds, not
// slow progress. So the send window never reopens at all, and patience past
// the first couple of RTO backoffs buys nothing but blocked nav loop. Held at
// 10 s: enough to cover the 1.72 + 4.0 + 8.0 backoff sequence, which is the
// only part with any evidence behind it.
constexpr uint32_t    CLOUD_UPLOAD_CONNECT_TIMEOUT_MS = 10000;

// Minimum largest contiguous free block before opening a TLS session at all.
// Bracketed by measurement on 0.7.15, not guessed -- a single bench run gave
// both ends of it:
//   largest 42996 -> start_ssl_client() succeeded
//   largest 32756 -> (-32512) SSL - Memory allocation failed, three for three
// and it is deterministic, because one completed TLS session permanently costs
// about 10 KB out of the largest block (42996 before the first attempt, 32756
// after it and for the rest of the boot). The likely shape, though only the
// bracket above is measured: mbedtls wants two ~16.4 KB record buffers
// (MBEDTLS_SSL_IN_CONTENT_LEN / OUT_CONTENT_LEN, 16384 each) carved out of one
// block, so 32756 misses holding both by a few hundred bytes.
//
// The point of the gate is honesty, not recovery: without it a retry burns
// ~400 ms and reports -1 "connection refused", which is what sent this
// investigation chasing DNS, the iPhone hotspot and softAP suspension for
// three days. It cannot connect, so say that instead of blaming the network.
constexpr uint32_t    CLOUD_TLS_MIN_LARGEST_BLOCK = 40000;

// Let the heap coalesce before standing up another TLS session. Every session
// costs mbedtls a large allocation, and back-to-back sessions on a failing
// upload are what produce the -1 described at CLOUD_DIAG_TIMEOUT_S below.
// Not a cure for fragmentation, just the cheapest thing that helps.
constexpr uint32_t    CLOUD_TLS_SETTLE_MS        = 250;

// Connect timeout for the diagnostics report, seconds. Deliberately short: the
// report is a nice-to-have on top of an upload that has already failed, and it
// must not add another long block to the nav loop. Note this is the same
// socket_timeout knob described at CLOUD_UPLOAD_CONNECT_TIMEOUT_MS above, so it
// bounds the send as well as the connect -- fine for a payload this small.
//
// This report is also the likeliest thing in the whole path to fail on memory
// rather than on the network. The 2026-09-18 capture caught it exactly: free
// heap 91116 bytes but the largest contiguous block only 32756, and
// start_ssl_client() returned (-32512) SSL - Memory allocation failed. That is
// what every unexplained -1 in this investigation actually was -- not DNS, not
// the hotspot, and not softAP suspension, all of which got blamed for it. It
// only shows up on the third TLS session of a run, which is why it looked like
// the retries were being rejected by the network.
constexpr int         CLOUD_DIAG_TIMEOUT_S       = 5;

// Device-auth polling (RFC 8628), per docs/architecture/device-uploads-plan.md.
constexpr uint32_t CLOUD_AUTH_POLL_INTERVAL_MS = 5000;
// Must stay <= the backend's DEVICE_CODE_TTL_MINUTES (backend/src/handlers/device.rs) --
// otherwise the device keeps polling a user_code the server already considers
// expired_token, well past the point where the diver was told linking succeeded.
constexpr uint32_t CLOUD_AUTH_POLL_TIMEOUT_MS  = 5 * 60 * 1000;  // 5 min, matches server-side code TTL
