djmcmath/dpv-nav/src/sensors/imu.cpp

#include <Wire.h>
#include <esp_heap_caps.h>
#include "../board_pins.h"
#include "../drivers/lis3mdl.h"
#include "../types/types.h"
#include <Arduino.h>
#include "imu.h"
#include "../util/mag_cal_orient.h"
#include "../util/baseline_boot.h"
#include "../util/mounted_dwell.h"
#include <math.h>
#include "../config.h"
#include <LittleFS.h>
#include <dpvlink.h>
//#include "i2c.h"

// No more extern globals — each sensor keeps its own internal calibration state,
// set via setXxxCalibration() for a consistent pattern across all three sensors.

namespace imu {


// ---------- I2C addresses (7-bit) ----------
static constexpr uint8_t LSM6DS3_ADDR_SA0_0 = 0x6A; // SA0 low (derived from D4h/D5h patterns) :contentReference[oaicite:3]{index=3}
static constexpr uint8_t LSM6DS3_ADDR_SA0_1 = 0x6B; // SA0 high (common alt; use if 0x6A fails)
//static constexpr uint8_t LIS3MDL_ADDR_DEFAULT = 0x1C; // :contentReference[oaicite:4]{index=4} //May be 19 or 1E instead.
static constexpr uint8_t LIS3MDL_ADDR_DEFAULT = 0x19; // :contentReference[oaicite:4]{index=4}

// ----------- Internal state -----------
static bool gyro_inited = false;
static bool accel_inited = false;
static bool mag_inited = false;
static ImuConfig g_cfg{};
static AxisMap g_accelGyroMap{};  // Axis mapping for LSM6DS3 (accel/gyro)
static AxisMap g_magMap{};        // Axis mapping for LIS3MDL (magnetometer)

static float g_accel_lsb_per_g = 0.0f;     // counts per g
static float g_gyro_lsb_per_dps = 0.0f;    // counts per deg/s
static float g_mag_lsb_per_uT = 0.0f;      // counts per µT (if known)

// ----------- Magnetometer thermal compensation -----------
// The LIS3MDL's zero-gauss offset moves with die temperature, and ST publish no
// coefficient for it (the datasheet and AN4602 only claim sensitivity drift is
// compensated on-chip). Measured on this unit, 2026-09-13/14: a body-fixed
// ~0.65 µT/°C in the horizontal plane -- see docs/mag-temperature-compensation.md.
//
// Coefficients arrive in µT/°C in the LOGICAL frame (the frame of mag_*_raw and
// the cal JSONs) and are applied in readMagRaw_SensorFrame(), below everything
// else, so every reader -- nav, logs, cal sample collection, gap-fill -- sees
// temperature-normalized counts. Converted to the sensor frame here, once.
static bool  g_magTempCompOn     = false;
static float g_magTempRef_c      = 21.0f;
static Vec3f g_magTempCoeffSensor{0.0f, 0.0f, 0.0f};  // µT/°C, SENSOR frame
// Most recent plausible die reading, captured in the same burst as the field.
// Compensation stays off until one has arrived, rather than assuming a value.
static bool  g_magTempSeen       = false;
static float g_magTemp_c         = NAN;

// The LSB-per-unit divisors below start at 0.0f and are only assigned at the
// very end of initAccelGyro()/initMag(), after every register write succeeds.
// A partial init therefore leaves a zero divisor, and dividing a raw count by
// it yields inf (or NaN when the count is exactly 0) -- which Mahony turns
// into a permanently NaN quaternion. Every reader that divides checks first
// and reports NotInitialized instead, so the nav loop takes its sensor-error
// path rather than silently feeding the filter garbage.
static inline bool scaleReady(float lsbPerUnit) {
  return isfinite(lsbPerUnit) && lsbPerUnit > 0.0f;
}


static TwoWire* gWire = nullptr;
static uint8_t  gLsmAddr = LSM6DS3_ADDR_SA0_0;

// Internal calibration data — set via setXxxCalibration(), used by read functions
static Calib3 g_gyroCalibration = {{0, 0, 0}, {1, 1, 1}};
static Calib3 g_accelCalibration = {{0, 0, 0}, {1, 1, 1}};
static MagCalib g_magCalibration = {
  {0, 0, 0},  // no offset by default
  {{1, 0, 0}, {0, 1, 0}, {0, 0, 1}}  // identity soft-iron matrix
};

// ---------- LSM6DS3 registers ----------
static constexpr uint8_t LSM6DS3_WHO_AM_I   = 0x0F; // returns 0x69 :contentReference[oaicite:5]{index=5}
static constexpr uint8_t LSM6DS3_CTRL1_XL   = 0x10;
static constexpr uint8_t LSM6DS3_CTRL2_G    = 0x11;
static constexpr uint8_t LSM6DS3_CTRL3_C    = 0x12;
static constexpr uint8_t LSM6DS3_OUTX_L_G   = 0x22;
static constexpr uint8_t LSM6DS3_OUTX_L_XL  = 0x28;

// CTRL3_C bits (per datasheet naming; common across ST IMUs)
static constexpr uint8_t CTRL3_SW_RESET = 0x01;
static constexpr uint8_t CTRL3_IF_INC   = 0x04; // auto-increment register address
static constexpr uint8_t CTRL3_BDU      = 0x40; // block data update (coherent reads)

// ---------- Low-level helpers ----------
static bool write8(uint8_t addr, uint8_t reg, uint8_t val) {
  gWire->beginTransmission(addr);
  gWire->write(reg);
  gWire->write(val);
  return (gWire->endTransmission() == 0);
}

static bool read8(uint8_t addr, uint8_t reg, uint8_t& val) {
  gWire->beginTransmission(addr);
  gWire->write(reg);
  if (gWire->endTransmission(false) != 0) return false; // repeated start
  if (gWire->requestFrom(addr, (uint8_t)1) != 1) return false;
  val = gWire->read();
  return true;
}

static bool readN(uint8_t addr, uint8_t startReg, uint8_t* buf, size_t n) {
  gWire->beginTransmission(addr);
  gWire->write(startReg);
  if (gWire->endTransmission(false) != 0) return false; // repeated start
  size_t got = gWire->requestFrom(addr, (uint8_t)n);
  if (got != n) return false;
  for (size_t i = 0; i < n; i++) buf[i] = gWire->read();
  return true;
}

// Try 0x6A then 0x6B; pick the one that answers WHO_AM_I correctly.
static bool detectLsm6ds3Address() {
  uint8_t who = 0;
  gLsmAddr = LSM6DS3_ADDR_SA0_0;
  if (read8(gLsmAddr, LSM6DS3_WHO_AM_I, who) && who == 0x69) {
    Serial.print("WHO_AM_I match at 0x6A: 0x");
    Serial.println(who, HEX);
    return true;
  }
  Serial.print("0x6A WHO_AM_I: 0x");
  Serial.println(who, HEX);

  gLsmAddr = LSM6DS3_ADDR_SA0_1;
  if (read8(gLsmAddr, LSM6DS3_WHO_AM_I, who) && who == 0x69) {
    Serial.print("WHO_AM_I match at 0x6B: 0x");
    Serial.println(who, HEX);
    return true;
  }
  Serial.print("0x6B WHO_AM_I: 0x");
  Serial.println(who, HEX);

  return false;
}

// ----------- Helpers -----------
static inline float dpsToRad(float dps) { return dps * 0.017453292519943295f; }

static Vec3i16 applyAxisMap(const Vec3i16& v, const AxisMap& map) {
  auto pick = [&](int8_t code) -> int16_t {
    int sign = (code < 0) ? -1 : 1;
    int idx  = (code < 0) ? -code : code;
    int16_t val = 0;
    switch (idx) {
      case 1: val = v.x; break;
      case 2: val = v.y; break;
      case 3: val = v.z; break;
      default: val = 0;  break;
    }
    return (int16_t)(sign * val);
  };

  return { pick(map.x_axis), pick(map.y_axis), pick(map.z_axis) };
}

static Vec3f toFloat(const Vec3i16& v) { return {(float)v.x, (float)v.y, (float)v.z}; }

// ----------- Magnetometer Calibration -----------
// Performs a min/max sweep calibration over a specified duration.
// User must rotate device through all orientations during this time.
// Computes bias as (min + max) / 2 for each axis.
// Sets softIron to identity (no soft iron correction).
void calibrateMagnetometer(MagCalib& out, uint32_t duration_ms) {
  if (!mag_inited) {
    Serial.println("[CAL] Error: Magnetometer not initialized");
    out.bias = {0, 0, 0};
    // Identity matrix
    out.softIron[0][0] = 1; out.softIron[0][1] = 0; out.softIron[0][2] = 0;
    out.softIron[1][0] = 0; out.softIron[1][1] = 1; out.softIron[1][2] = 0;
    out.softIron[2][0] = 0; out.softIron[2][1] = 0; out.softIron[2][2] = 1;
    return;
  }

  Serial.println("[CAL] ========================================");
  Serial.println("[CAL] MAGNETOMETER CALIBRATION");
  Serial.println("[CAL] ========================================");
  Serial.print("[CAL] Duration: ");
  Serial.print(duration_ms / 1000);
  Serial.println(" seconds");
  Serial.println("[CAL] ");
  Serial.println("[CAL] Rotate device SLOWLY through all orientations:");
  Serial.println("[CAL]   - Tumble (rotate around all axes)");
  Serial.println("[CAL]   - Figure-8 patterns");
  Serial.println("[CAL]   - Hold each orientation for 1-2 seconds");
  Serial.println("[CAL] ");
  Serial.println("[CAL] Goal: X, Y, Z coverage all reach 100%");
  Serial.println("[CAL] ----------------------------------------");

  // Initialize min/max with first reading
  Vec3i16 firstRead;
  readMagRaw_SensorFrame(firstRead);  // Use sensor frame for calibration

  int16_t minX = firstRead.x, maxX = firstRead.x;
  int16_t minY = firstRead.y, maxY = firstRead.y;
  int16_t minZ = firstRead.z, maxZ = firstRead.z;

  uint32_t startTime = millis();
  uint32_t sampleCount = 0;
  uint32_t lastProgressUpdate = 0;

  // Expected full-rotation range (approximate, for coverage estimation)
  // For a typical magnetometer in Earth's field (~50 µT), rotating 360° gives:
  // Range ≈ 2 * field_strength * LSB/µT ≈ 2 * 50 * 68.42 ≈ 6800 counts
  const float EXPECTED_RANGE = 6800.0f;

  // Sweep for specified duration
  while (millis() - startTime < duration_ms) {
    Vec3i16 reading;
    if (readMagRaw_SensorFrame(reading) == ImuStatus::Ok) {  // Use sensor frame
      minX = min(minX, reading.x);
      maxX = max(maxX, reading.x);
      minY = min(minY, reading.y);
      maxY = max(maxY, reading.y);
      minZ = min(minZ, reading.z);
      maxZ = max(maxZ, reading.z);
      sampleCount++;

      // Update progress every second
      uint32_t elapsed = millis() - startTime;
      if (elapsed - lastProgressUpdate >= 1000) {
        lastProgressUpdate = elapsed;
        uint32_t remaining = (duration_ms - elapsed) / 1000;

        // Calculate coverage percentages
        float rangeX = maxX - minX;
        float rangeY = maxY - minY;
        float rangeZ = maxZ - minZ;

        int coverageX = min(100, (int)((rangeX / EXPECTED_RANGE) * 100.0f));
        int coverageY = min(100, (int)((rangeY / EXPECTED_RANGE) * 100.0f));
        int coverageZ = min(100, (int)((rangeZ / EXPECTED_RANGE) * 100.0f));

        // Print progress bar style output
        Serial.print("[CAL] ");
        Serial.print(remaining);
        Serial.print("s | Samples: ");
        Serial.print(sampleCount);
        Serial.print(" | Coverage X:");
        Serial.print(coverageX);
        Serial.print("% Y:");
        Serial.print(coverageY);
        Serial.print("% Z:");
        Serial.print(coverageZ);
        Serial.print("%");

        // Add quality indicator
        int avgCoverage = (coverageX + coverageY + coverageZ) / 3;
        if (avgCoverage >= 80) {
          Serial.println(" [EXCELLENT]");
        } else if (avgCoverage >= 60) {
          Serial.println(" [GOOD]");
        } else if (avgCoverage >= 40) {
          Serial.println(" [OK - keep rotating]");
        } else {
          Serial.println(" [POOR - rotate more!]");
        }
      }
    }
    delay(10);  // ~100 Hz sampling
  }

  // Calculate bias as midpoint of min/max range (in sensor frame)
  float biasX = ((float)(minX + maxX)) / 2.0f;
  float biasY = ((float)(minY + maxY)) / 2.0f;
  float biasZ = ((float)(minZ + maxZ)) / 2.0f;

  // Apply axis mapping to convert bias from sensor frame to logical frame
  // This is critical because readMag() applies axis mapping BEFORE calibration,
  // so the bias must be in the same (logical) frame as the readings it corrects.
  Vec3i16 biasSensorInt = {(int16_t)biasX, (int16_t)biasY, (int16_t)biasZ};
  Vec3i16 biasLogical = applyAxisMap(biasSensorInt, g_magMap);

  out.bias = {(float)biasLogical.x, (float)biasLogical.y, (float)biasLogical.z};
  
  // Identity matrix for soft iron (no correction)
  out.softIron[0][0] = 1; out.softIron[0][1] = 0; out.softIron[0][2] = 0;
  out.softIron[1][0] = 0; out.softIron[1][1] = 1; out.softIron[1][2] = 0;
  out.softIron[2][0] = 0; out.softIron[2][1] = 0; out.softIron[2][2] = 1;

  g_magCalibration = out;  // Update internal calibration used by readMag()/readMag_raw_cal()

  // Calculate final coverage statistics
  float rangeX = maxX - minX;
  float rangeY = maxY - minY;
  float rangeZ = maxZ - minZ;
  
  int coverageX = min(100, (int)((rangeX / EXPECTED_RANGE) * 100.0f));
  int coverageY = min(100, (int)((rangeY / EXPECTED_RANGE) * 100.0f));
  int coverageZ = min(100, (int)((rangeZ / EXPECTED_RANGE) * 100.0f));
  int avgCoverage = (coverageX + coverageY + coverageZ) / 3;

  Serial.println("[CAL] ========================================");
  Serial.println("[CAL] CALIBRATION COMPLETE!");
  Serial.println("[CAL] ========================================");
  Serial.print("[CAL] Samples collected: ");
  Serial.println(sampleCount);
  Serial.print("[CAL] Bias (sensor frame): X=");
  Serial.print(biasX, 1);
  Serial.print(" Y=");
  Serial.print(biasY, 1);
  Serial.print(" Z=");
  Serial.println(biasZ, 1);
  Serial.print("[CAL] Bias (logical frame): X=");
  Serial.print(out.bias.x, 1);
  Serial.print(" Y=");
  Serial.print(out.bias.y, 1);
  Serial.print(" Z=");
  Serial.println(out.bias.z, 1);

  Serial.println("[CAL] ");
  Serial.print("[CAL] Final Coverage: X=");
  Serial.print(coverageX);
  Serial.print("% Y=");
  Serial.print(coverageY);
  Serial.print("% Z=");
  Serial.print(coverageZ);
  Serial.print("% (Avg: ");
  Serial.print(avgCoverage);
  Serial.println("%)");

  if (avgCoverage >= 80) {
    Serial.println("[CAL] ✓ EXCELLENT coverage - calibration should be accurate");
  } else if (avgCoverage >= 60) {
    Serial.println("[CAL] ✓ GOOD coverage - calibration acceptable");
  } else if (avgCoverage >= 40) {
    Serial.println("[CAL] ⚠ MODERATE coverage - may need recalibration");
  } else {
    Serial.println("[CAL] ✗ POOR coverage - recalibration recommended!");
  }
  Serial.println("[CAL] ========================================");
  Serial.print("[CAL] Field range (sensor frame) - X:[");
  Serial.print(minX); Serial.print(", ");
  Serial.print(maxX); Serial.print("] Y:[");
  Serial.print(minY); Serial.print(", ");
  Serial.print(maxY); Serial.print("] Z:[");
  Serial.print(minZ); Serial.print(", ");
  Serial.print(maxZ); Serial.println("]");
  Serial.println("[CAL] (Bias converted to logical frame for use with axis mapping)");
}

// ----------- Non-blocking Magnetometer Calibration -----------
// Same min/max sweep as calibrateMagnetometer(), but runs across multiple loop() calls.
// Call magCalNBBegin() once, then magCalNBTick() each loop iteration.
static bool     g_nbCalActive   = false;
static uint32_t g_nbCalStart    = 0;
static uint32_t g_nbCalDuration = 0;
static int16_t  g_nbMinX, g_nbMaxX, g_nbMinY, g_nbMaxY, g_nbMinZ, g_nbMaxZ;
static uint32_t g_nbSamples     = 0;
static MagCalib g_nbResult;

static constexpr float NB_EXPECTED_RANGE = 6800.0f;

bool magCalNBBegin(uint32_t duration_ms) {
  if (!mag_inited) {
    Serial.println("[CAL-NB] Error: mag not initialized");
    return false;
  }
  if (g_nbCalActive) {
    Serial.println("[CAL-NB] Already running — stopping previous");
    g_nbCalActive = false;
  }
  // Seed min/max with first reading
  Vec3i16 first;
  if (readMagRaw_SensorFrame(first) != ImuStatus::Ok) {
    Serial.println("[CAL-NB] Error: initial read failed");
    return false;
  }
  g_nbMinX = g_nbMaxX = first.x;
  g_nbMinY = g_nbMaxY = first.y;
  g_nbMinZ = g_nbMaxZ = first.z;
  g_nbSamples    = 0;
  g_nbCalStart   = millis();
  g_nbCalDuration = duration_ms;
  g_nbCalActive  = true;

  Serial.print("[CAL-NB] Hard-iron sweep started, duration=");
  Serial.print(duration_ms / 1000);
  Serial.println("s — rotate device through all orientations");
  return true;
}

bool magCalNBTick() {
  if (!g_nbCalActive) return false;

  uint32_t elapsed = millis() - g_nbCalStart;
  if (elapsed >= g_nbCalDuration) {
    // Time's up — compute result
    float biasX = ((float)(g_nbMinX + g_nbMaxX)) / 2.0f;
    float biasY = ((float)(g_nbMinY + g_nbMaxY)) / 2.0f;
    float biasZ = ((float)(g_nbMinZ + g_nbMaxZ)) / 2.0f;

    Vec3i16 biasSensorInt = {(int16_t)biasX, (int16_t)biasY, (int16_t)biasZ};
    Vec3i16 biasLogical   = applyAxisMap(biasSensorInt, g_magMap);
    g_nbResult.bias = {(float)biasLogical.x, (float)biasLogical.y, (float)biasLogical.z};
    g_nbResult.softIron[0][0] = 1; g_nbResult.softIron[0][1] = 0; g_nbResult.softIron[0][2] = 0;
    g_nbResult.softIron[1][0] = 0; g_nbResult.softIron[1][1] = 1; g_nbResult.softIron[1][2] = 0;
    g_nbResult.softIron[2][0] = 0; g_nbResult.softIron[2][1] = 0; g_nbResult.softIron[2][2] = 1;
    g_magCalibration = g_nbResult;
    g_nbCalActive = false;

    Serial.printf("[CAL-NB] Done. Samples=%lu bias=(%+.1f,%+.1f,%+.1f) logical\n",
                  (unsigned long)g_nbSamples, g_nbResult.bias.x, g_nbResult.bias.y, g_nbResult.bias.z);
    return true;
  }

  // Read and expand min/max
  Vec3i16 r;
  if (readMagRaw_SensorFrame(r) == ImuStatus::Ok) {
    if (r.x < g_nbMinX) g_nbMinX = r.x; if (r.x > g_nbMaxX) g_nbMaxX = r.x;
    if (r.y < g_nbMinY) g_nbMinY = r.y; if (r.y > g_nbMaxY) g_nbMaxY = r.y;
    if (r.z < g_nbMinZ) g_nbMinZ = r.z; if (r.z > g_nbMaxZ) g_nbMaxZ = r.z;
    g_nbSamples++;
  }
  return false;
}

bool magCalNBIsActive() { return g_nbCalActive; }

void magCalNBGetResult(MagCalib& out) { out = g_nbResult; }

void magCalNBGetProgress(uint32_t& elapsed_ms, uint32_t& remaining_ms,
                         int& covX, int& covY, int& covZ) {
  if (!g_nbCalActive) {
    elapsed_ms = remaining_ms = 0;
    covX = covY = covZ = 0;
    return;
  }
  elapsed_ms   = millis() - g_nbCalStart;
  remaining_ms = (elapsed_ms < g_nbCalDuration) ? (g_nbCalDuration - elapsed_ms) : 0;
  covX = min(100, (int)(((float)(g_nbMaxX - g_nbMinX) / NB_EXPECTED_RANGE) * 100.0f));
  covY = min(100, (int)(((float)(g_nbMaxY - g_nbMinY) / NB_EXPECTED_RANGE) * 100.0f));
  covZ = min(100, (int)(((float)(g_nbMaxZ - g_nbMinZ) / NB_EXPECTED_RANGE) * 100.0f));
}

// ---------------------------------------------------------------------------
// Incremental 2-D ellipse fitter (live solution quality during bin cal)
// ---------------------------------------------------------------------------
// Model: A*xn^2 + C*yn^2 + D*xn + E*yn = 1  (axis-aligned ellipse, XY plane)
// where (xn, yn) = calibration-applied counts / FIT_NORM.
//
// Maintains the 4×4 normal equations incrementally so we can solve at any
// time without re-iterating over stored samples.  Calling magFit2DSolve()
// (once per CalProgressPacket, ~2 Hz) costs only a 4×4 Gauss-Jordan solve —
// microseconds on ESP32.
//
// For baseline cal with identity calibration loaded: fitter sees raw counts
// in µT-normalised space — estimates how elliptical the raw data is.
// For mounted cal with baseline cal loaded: fitter sees base-corrected counts
// — estimates the mounting residual ellipticity and expected heading error.
// ---------------------------------------------------------------------------

static constexpr float FIT_NORM = 4096.0f;   // normalise counts to ~unit range

struct MagFit2D {
    // Running sums for symmetric 4×4 XtX matrix.
    // Feature order: [xn², yn², xn, yn]
    float S_x4,  S_x2y2, S_y4;       // XtX [0,0] [0,1] [1,1]
    float S_x3,  S_x2y;              // XtX [0,2] [0,3]
    float S_xy2, S_y3;               // XtX [1,2] [1,3]
    float S_x2,  S_xy,   S_y2;      // XtX [2,2] [2,3] [3,3] — also Xtb[0..1]
    float S_x,   S_y;               // also Xtb[2..3]
    uint32_t n;

    // Current solution
    float A, C, D, E;               // ellipse coefficients
    float cx_norm, cy_norm;          // ellipse centre (normalised space)
    float rx_norm, ry_norm;          // semi-axes (normalised space)
    float hdg_err_deg;               // estimated heading error from ellipticity
    float alg_rms;                   // algebraic RMS residual (dimensionless)
    bool  valid;                     // true once a valid solution exists

    // Stability: centre shift since previous solve (normalised space)
    float prev_cx, prev_cy;
    float delta;                     // converges toward 0 as data stabilises
};

static MagFit2D g_magFit{};

static void magFit2DReset() {
    memset(&g_magFit, 0, sizeof(g_magFit));
}

// Add one sample.  Apply current g_magCalibration (bias + soft-iron, X and Y
// rows only) before accumulating so the fitter operates in calibrated space.
// With identity cal loaded: fitter sees raw counts. With base cal loaded: sees
// base-corrected residual.  In both cases FIT_NORM normalises to ~unit range.
static void magFit2DAdd(const Vec3i16& raw) {
    // Apply calibration (same transform as readMag(), skipping Z output)
    float xc = raw.x - g_magCalibration.bias.x;
    float yc = raw.y - g_magCalibration.bias.y;
    float zc = raw.z - g_magCalibration.bias.z;
    float xs = g_magCalibration.softIron[0][0]*xc
             + g_magCalibration.softIron[0][1]*yc
             + g_magCalibration.softIron[0][2]*zc;
    float ys = g_magCalibration.softIron[1][0]*xc
             + g_magCalibration.softIron[1][1]*yc
             + g_magCalibration.softIron[1][2]*zc;

    float xn = xs / FIT_NORM;
    float yn = ys / FIT_NORM;
    float x2 = xn*xn, y2 = yn*yn;

    MagFit2D& s = g_magFit;
    s.S_x4   += x2*x2;
    s.S_x2y2 += x2*y2;
    s.S_y4   += y2*y2;
    s.S_x3   += x2*xn;
    s.S_x2y  += x2*yn;
    s.S_xy2  += xn*y2;
    s.S_y3   += y2*yn;
    s.S_x2   += x2;
    s.S_xy   += xn*yn;
    s.S_y2   += y2;
    s.S_x    += xn;
    s.S_y    += yn;
    s.n++;
}

// Solve the 4×4 normal equations by Gauss-Jordan elimination.
// Populates g_magFit solution fields.  Returns true if valid ellipse found.
static bool magFit2DSolve() {
    MagFit2D& s = g_magFit;
    if (s.n < 8) { s.valid = false; return false; }

    // Augmented matrix [XtX | Xtb], row order: A, C, D, E
    // RHS Xtb_i = sum(phi_i * 1) = [S_x2, S_y2, S_x, S_y]
    float M[4][5] = {
        { s.S_x4,   s.S_x2y2, s.S_x3,  s.S_x2y, s.S_x2 },
        { s.S_x2y2, s.S_y4,   s.S_xy2, s.S_y3,  s.S_y2 },
        { s.S_x3,   s.S_xy2,  s.S_x2,  s.S_xy,  s.S_x  },
        { s.S_x2y,  s.S_y3,   s.S_xy,  s.S_y2,  s.S_y  },
    };

    // Gauss-Jordan with partial pivoting
    for (int col = 0; col < 4; col++) {
        int pivot = col;
        for (int row = col+1; row < 4; row++)
            if (fabsf(M[row][col]) > fabsf(M[pivot][col])) pivot = row;
        if (fabsf(M[pivot][col]) < 1e-8f) { s.valid = false; return false; }

        if (pivot != col)
            for (int j = 0; j <= 4; j++) { float t = M[col][j]; M[col][j] = M[pivot][j]; M[pivot][j] = t; }

        float inv = 1.0f / M[col][col];
        for (int j = col; j <= 4; j++) M[col][j] *= inv;

        for (int row = 0; row < 4; row++) {
            if (row == col) continue;
            float f = M[row][col];
            for (int j = col; j <= 4; j++) M[row][j] -= f * M[col][j];
        }
    }

    float A = M[0][4], C = M[1][4], D = M[2][4], E = M[3][4];
    if (A <= 0 || C <= 0) { s.valid = false; return false; }

    float denom = 1.0f + D*D/(4.0f*A) + E*E/(4.0f*C);
    if (denom <= 0) { s.valid = false; return false; }

    // Save previous centre for stability tracking
    s.prev_cx = s.cx_norm;
    s.prev_cy = s.cy_norm;

    s.A = A;  s.C = C;  s.D = D;  s.E = E;
    s.cx_norm = -D / (2.0f*A);
    s.cy_norm = -E / (2.0f*C);
    s.rx_norm = sqrtf(denom / A);
    s.ry_norm = sqrtf(denom / C);

    // Heading error estimate from XY ellipticity (degrees)
    float avg_r = (s.rx_norm + s.ry_norm) * 0.5f;
    float diff  = fabsf(s.rx_norm - s.ry_norm);
    s.hdg_err_deg = atan2f(diff, avg_r) * 57.2957795f;

    // Algebraic RMS residual from accumulated sums
    float SS =
        A*A*s.S_x4 + C*C*s.S_y4 + D*D*s.S_x2 + E*E*s.S_y2
      + 2.0f*A*C*s.S_x2y2 + 2.0f*A*D*s.S_x3 + 2.0f*A*E*s.S_x2y
      + 2.0f*C*D*s.S_xy2  + 2.0f*C*E*s.S_y3  + 2.0f*D*E*s.S_xy
      - 2.0f*A*s.S_x2 - 2.0f*C*s.S_y2 - 2.0f*D*s.S_x - 2.0f*E*s.S_y
      + (float)s.n;
    s.alg_rms = (SS > 0) ? sqrtf(SS / (float)s.n) : 0.0f;

    // Centre shift from previous solve
    float dcx = s.cx_norm - s.prev_cx, dcy = s.cy_norm - s.prev_cy;
    s.delta = sqrtf(dcx*dcx + dcy*dcy);

    s.valid = true;
    return true;
}

// ---------------------------------------------------------------------------
// Bin-Aware Magnetometer Calibration Collection
// ---------------------------------------------------------------------------
// Collects raw mag samples bucketed into orientation bins (heading × elevation).
// Once a bin reaches the green threshold, further samples are rejected for that bin.
// This prevents oversampling of easy orientations and produces a more balanced fit.

// Accel and gyro are stored as scaled int16, not float: 24 bytes a sample
// against 34, which is 21 KB less of the heap this buffer has starved before
// (see magBinCalFreeSamples). The steps are 0.12 mg and 0.057 deg/s, both
// well under the sensors' own noise, and the CSV is written back out in g and
// rad/s exactly as before.
static constexpr float BIN_CAL_ACCEL_LSB_PER_G     = 8192.0f;  // +-4 g
static constexpr float BIN_CAL_GYRO_LSB_PER_RAD_S  = 1000.0f;  // +-32.7 rad/s
static constexpr int16_t BIN_CAL_NO_TEMP           = INT16_MIN;

struct BinCalSample {
    int16_t x, y, z;        // mag: raw logical-frame counts (post-axis-map, from readMagRaw())
    int16_t ax, ay, az;     // accel: calibrated, logical frame, g * BIN_CAL_ACCEL_LSB_PER_G
    int16_t gx, gy, gz;     // gyro: calibrated, logical frame, rad/s * BIN_CAL_GYRO_LSB_PER_RAD_S
    int16_t temp_centi_c;   // mag die temperature, 0.01 degC; BIN_CAL_NO_TEMP if never read
    uint8_t tcomp;          // 1 if thermal compensation was applied to x/y/z
    uint8_t dwell;          // mounted: 1-based dwell this sample belongs to; 0 otherwise
    // The cell and roll sector the device showed for this sample when it
    // accepted it, -1 if it had none (mounted, or baseline before the
    // bootstrap locked). Never rewritten by a re-bin: it records what the
    // diver saw, so an uploaded session can be scored against the server's
    // binning without any Serial access (docs/baseline-live-grid-plan.md).
    int8_t  dev_bin;
    int8_t  dev_roll;
};

static inline int16_t binCalScale(float v, float lsbPerUnit) {
    const float c = v * lsbPerUnit;
    if (!(c > -32767.0f)) return -32767;  // also catches NaN
    if (c > 32767.0f) return 32767;
    return (int16_t)lroundf(c);
}

// The mag reading passed to magBinCalTick() has already been through
// readMagRaw_SensorFrame()'s thermal compensation, when that is on. Record
// the die temperature and whether it was, or a calibration's thermal state is
// unknowable after the fact.
static BinCalSample makeBinCalSample(const Vec3i16& rawMag, const Vec3f& accelCal,
                                     const Vec3f& gyroCal, uint8_t dwell) {
    BinCalSample s;
    s.x = rawMag.x;  s.y = rawMag.y;  s.z = rawMag.z;
    s.ax = binCalScale(accelCal.x, BIN_CAL_ACCEL_LSB_PER_G);
    s.ay = binCalScale(accelCal.y, BIN_CAL_ACCEL_LSB_PER_G);
    s.az = binCalScale(accelCal.z, BIN_CAL_ACCEL_LSB_PER_G);
    s.gx = binCalScale(gyroCal.x, BIN_CAL_GYRO_LSB_PER_RAD_S);
    s.gy = binCalScale(gyroCal.y, BIN_CAL_GYRO_LSB_PER_RAD_S);
    s.gz = binCalScale(gyroCal.z, BIN_CAL_GYRO_LSB_PER_RAD_S);
    s.temp_centi_c = (g_magTempSeen && isfinite(g_magTemp_c))
                     ? binCalScale(g_magTemp_c, 100.0f) : BIN_CAL_NO_TEMP;
    s.tcomp = (g_magTempCompOn && g_magTempSeen && scaleReady(g_mag_lsb_per_uT)) ? 1 : 0;
    s.dwell = dwell;
    s.dev_bin  = -1;
    s.dev_roll = -1;
    return s;
}

static inline void binCalSampleAccel(const BinCalSample& s, float out[3]) {
    out[0] = s.ax / BIN_CAL_ACCEL_LSB_PER_G;
    out[1] = s.ay / BIN_CAL_ACCEL_LSB_PER_G;
    out[2] = s.az / BIN_CAL_ACCEL_LSB_PER_G;
}

static bool          g_binCalActive    = false;
static BinCalMode    g_binCalMode      = BinCalMode::BASELINE;
static int           g_binCalBinCount  = 0;         // 60 or 36

// Convenience: mounted is the only mode with a 36-cell grid, and the only one
// that records by dwell. Baseline and gap-fill are both 60-bin baseline
// collections that produce the same CSV -- they differ in what feedback they
// can honestly give while collecting, not in what they produce.
static inline bool binCalIsMounted() { return g_binCalMode == BinCalMode::MOUNTED; }

// MOUNTED only: decides when a cell may be recorded (util/mounted_dwell.h).
static mounted_dwell::Tracker g_mountedDwell;
// Last mag reading the mounted path saw, to spot a tick with no new reading.
static Vec3i16 g_mountedLastMag{};
static bool    g_mountedHasLastMag = false;

// GAP_FILL only: the server's per-cell status map (0=ok, 1=thin, 2=empty,
// 3=over) and the derived "is this a cell the diver was sent to" test.
// Deliberately not recomputed on-device -- see util/mag_cal_orient.h.
static uint8_t       g_binTargets[60]  = {};
static bool          g_binHasTargets   = false;

static inline bool binIsTargeted(int bin) {
    if (!g_binHasTargets || bin < 0 || bin >= 60) return false;
    return g_binTargets[bin] == 1 || g_binTargets[bin] == 2;  // thin or empty
}

// GAP_FILL only: the server's per-(cell, roll-sector) status from a *prior*
// accepted upload (cal_sync::loadRollTargets(), itself from
// GET /calibrations/targets' roll_grid -- see config.h's "Roll coverage"
// block). Same "server decides, device never recomputes" split as
// g_binTargets, one axis finer. Optional: g_binHasRollTargets is false
// whenever the server didn't send roll data (older build, or a calibration
// predating roll coverage), in which case every sector starts this session
// assuming zero prior coverage -- the same behaviour gap-fill had before this
// existed.
static uint8_t       g_binRollTargets[60][MAG_CAL_ROLL_SECTORS] = {};
static bool          g_binHasRollTargets = false;

static inline bool rollSectorServerSatisfied(int bin, int k) {
    if (!g_binHasRollTargets || bin < 0 || bin >= 60) return false;
    const uint8_t st = g_binRollTargets[bin][k];
    return st == 0 || st == 3;  // ok or over -- not this session's job
}
static uint8_t       g_binCounts[60]   = {};         // samples per bin (all roll sectors summed)
static BinCalSample* g_binSamples      = nullptr;   // heap-allocated
static int           g_binSampleCount  = 0;
static int           g_lastComputedBin = -1;         // current device orientation (bin index), updated every tick
static float         g_lastPitchDeg    = 0.0f;       // actual pitch at last tick (for display readout)
static float         g_lastHdgDeg      = 0.0f;       // actual heading at last tick (for display readout)

// GAP_FILL only: per-(cell, roll-sector) sample counts for THIS session, the
// local half of roll coverage (config.h's "Roll coverage" block). Not synced
// anywhere -- the server's adequacy judgement for a *finished* upload still
// comes from callib/coverage.py against the full merged dataset, same as
// g_binCounts always has. This just drives the live per-sector acceptance
// caps and the persistent widget's breakdown for whichever cell is currently
// highlighted, exactly the same role g_binCounts already plays for the flat
// per-cell cap/display, just one axis finer.
static uint8_t        g_binRollCounts[60][MAG_CAL_ROLL_SECTORS] = {};
static float          g_lastRollDeg    = 0.0f;       // actual roll at last tick (for display readout)
static int            g_lastRollSector = -1;         // current device roll sector, updated every tick (mirrors g_lastComputedBin)

// A single roll sector is satisfied if the *server* already considers it
// ok/over from a prior accepted upload (rollSectorServerSatisfied), or this
// session's own local count has cleared its cap -- upright's cap is
// MAG_CAL_GAPFILL_TARGET_CAP, each other sector's is
// MAG_CAL_GAPFILL_TARGET_CAP_OTHER_ROLL (see config.h). The local-cap half
// mirrors callib/coverage.py's classify_bins() asymmetric-floor logic
// against this session's own counts rather than the server's
// population-relative thresholds -- same "device computes accept/reject,
// server computes thin/empty/ok" split MAG_CAL_GAPFILL_TARGET_CAP already
// draws for whole cells.
static inline bool rollSectorSatisfied(int bin, int k) {
    if (rollSectorServerSatisfied(bin, k)) return true;
    const uint8_t cap = (k == 0) ? MAG_CAL_GAPFILL_TARGET_CAP
                                  : MAG_CAL_GAPFILL_TARGET_CAP_OTHER_ROLL;
    return g_binRollCounts[bin][k] >= cap;
}

// A cell counts as roll-satisfied only once every roll sector individually
// is (see rollSectorSatisfied).
static inline bool binRollSatisfied(int bin) {
    for (int k = 0; k < MAG_CAL_ROLL_SECTORS; k++) {
        if (!rollSectorSatisfied(bin, k)) return false;
    }
    return true;
}

// Per-bin last-accepted sample for runtime duplicate rejection.
// Prevents the same sensor reading from being counted multiple times when
// the magnetometer hasn't updated between AHRS loop iterations.
static BinCalSample g_binLastSample[60] = {};
static bool         g_binHasSample[60]  = {};

// ---------------------------------------------------------------------------
// Baseline cal: ROUGH_SCAN, then BASELINE_GRID once the bootstrap locks.
//
// Three prior spikes tried to make a *live* grid trustworthy pre-calibration:
// (1) binning on the raw magnetometer vector against a Fibonacci lattice
// (broke screen locality — see git history), (2) against a fixed body axis
// (restored locality but was never gravity-referenced, and any
// elevation/azimuth parameterization has an unavoidable pole singularity
// regardless of which axis it's measured from), and (3) a two-pass handoff
// (ROUGH_SCAN gathers raw spread, hands a rough hard-iron bias to the
// existing Mahony/AHRS pipeline, then COLLECT resumes the original grid) —
// see docs/baseline-cal-two-pass.md for the full diagnostic history. On
// hardware, (3) still failed: no correlation between physical orientation
// and the highlighted box. Filter lag was blamed; a 2026-11-05 replay found
// its min/max bias was also 15-25 uT off for most of a tumble.
//
// From 2026-07-25 baseline was ROUGH_SCAN for the whole session: per-axis
// bars, no spatial promise, real grading on the server. Since 2026-11-06
// (docs/baseline-live-grid-plan.md) a sphere fit over the stored samples
// (util/baseline_boot.h) replaces both failed ingredients: once it locks,
// baseline moves to BASELINE_GRID and bins each sample the way gap-fill
// does -- per sample, from mag + accel, no filter -- against the in-session
// bias. Upload and server grading are unchanged.
// ---------------------------------------------------------------------------

// BASELINE_GRID: baseline after the in-session bootstrap has locked (see
// util/baseline_boot.h). Same collection, now with gap-fill's grid.
enum class BinCalSubPhase : uint8_t { ROUGH_SCAN, COLLECT, GAP_FILL, BASELINE_GRID };
static BinCalSubPhase g_binCalSubPhase = BinCalSubPhase::COLLECT;

// Running min/max per axis — tracked during baseline ROUGH_SCAN, purely to
// render the per-axis coverage bars (magBinCalGetProgress's cov_x/y/z). Not
// soft-iron-aware and never applied as a calibration; the real bias/soft-iron
// fit (calibration-processor) only ever sees the raw stored samples.
static int16_t g_roughMin[3];
static int16_t g_roughMax[3];
static int     g_roughScanSampleCount = 0;

// Baseline only: the in-session bootstrap (util/baseline_boot.h). It reads
// the stored samples back through this adapter -- the stored, quantised accel,
// so a re-bin and the live classification of the same sample cannot differ,
// and the uploaded CSV replays to exactly what the unit showed.
class BinCalSampleSource : public baseline_boot::SampleSource {
public:
    int count() const override { return g_binSampleCount; }
    void get(int i, int16_t mag[3], float accel[3]) const override {
        const BinCalSample& s = g_binSamples[i];
        mag[0] = s.x;  mag[1] = s.y;  mag[2] = s.z;
        binCalSampleAccel(s, accel);
    }
};
static BinCalSampleSource      g_binSampleSource;
static baseline_boot::Session  g_boot;

// Baseline only: the last stored sample, for exact-duplicate rejection (the
// mag ODR is slower than the loop, so consecutive reads repeat).
static BinCalSample g_baselineLast{};
static bool         g_hasBaselineLast = false;

// Set by magBinCalFinishBaseline() when the diver presses FINISH, in any bin
// cal mode, or by magBinCalTick() when baseline's sample buffer fills first.
// Baseline has no bin/grid completion concept, so this is the only source of
// truth for magBinCalIsComplete() in that mode; gap-fill and mounted also
// complete on their own once every cell they need is filled.
static bool g_userDone = false;

// Set alongside g_userDone only on the buffer-full path, so the
// display can say *why* the session ended instead of just "Done".
static bool g_baselineMaxSamplesReached = false;

// GAP_FILL only: the calibration used to reconstruct the live orientation that
// picks each sample's cell. Set from magBinCalBegin(); see imu.h for why this
// must be the baseline-only cal and not the installed base-o-mount chain.
// Flag false = fall back to g_magCalibration (the installed chain).
static MagCalib g_binCalBinningCal{};
static bool     g_hasBinCalBinningCal = false;

bool magBinCalBegin(BinCalMode mode, const uint8_t* targets60,
                    const uint8_t (*rollTargets60x4)[MAG_CAL_ROLL_SECTORS], bool hasRollTargets,
                    const MagCalib* binningCal) {
    magBinCalEnd();  // clean up any previous run

    if (mode == BinCalMode::GAP_FILL && !targets60) {
        // Refuse rather than degrade. A gap-fill session with no target map
        // is an unguided baseline collection wearing a guided UI -- the diver
        // would trust a grid that means nothing. The caller puts a real
        // message on screen ("Sync targets first").
        Serial.println("[BIN_CAL] Gap-fill refused: no target map supplied");
        return false;
    }

    const bool isMounted = (mode == BinCalMode::MOUNTED);
    g_binCalMode      = mode;
    g_binCalBinCount  = isMounted ? MAG_CAL_MOUNTED_BINS : MAG_CAL_BASELINE_BINS;
    g_binCalSubPhase  = (mode == BinCalMode::MOUNTED)  ? BinCalSubPhase::COLLECT
                      : (mode == BinCalMode::GAP_FILL) ? BinCalSubPhase::GAP_FILL
                                                       : BinCalSubPhase::ROUGH_SCAN;
    g_binHasTargets   = false;
    memset(g_binTargets, 0, sizeof(g_binTargets));
    g_binHasRollTargets = false;
    memset(g_binRollTargets, 0, sizeof(g_binRollTargets));
    g_hasBinCalBinningCal = false;
    if (mode == BinCalMode::GAP_FILL && binningCal) {
        g_binCalBinningCal    = *binningCal;
        g_hasBinCalBinningCal = true;
    }
    if (mode == BinCalMode::GAP_FILL) {
        memcpy(g_binTargets, targets60, sizeof(g_binTargets));
        g_binHasTargets = true;
        if (rollTargets60x4 && hasRollTargets) {
            memcpy(g_binRollTargets, rollTargets60x4, sizeof(g_binRollTargets));
            g_binHasRollTargets = true;
        }
    }
    g_binSampleCount  = 0;
    memset(g_binCounts,     0, sizeof(g_binCounts));
    memset(g_binRollCounts, 0, sizeof(g_binRollCounts));
    g_lastRollSector = -1;
    memset(g_binHasSample,  0, sizeof(g_binHasSample));
    memset(g_binLastSample, 0, sizeof(g_binLastSample));
    g_mountedDwell.reset();
    g_mountedHasLastMag = false;

    g_roughMin[0] = g_roughMin[1] = g_roughMin[2] = INT16_MAX;
    g_roughMax[0] = g_roughMax[1] = g_roughMax[2] = INT16_MIN;
    g_roughScanSampleCount = 0;
    g_userDone = false;
    g_baselineMaxSamplesReached = false;
    g_boot.reset();
    g_hasBaselineLast = false;

    g_binSamples = (BinCalSample*)malloc(MAG_CAL_BIN_MAX_SAMPLES * sizeof(BinCalSample));
    if (!g_binSamples) {
        Serial.println("[BIN_CAL] ERROR: malloc failed for sample buffer");
        return false;
    }

    magFit2DReset();  // reset incremental fitter for fresh session
    g_binCalActive = true;

    const char* modeName = (mode == BinCalMode::MOUNTED)  ? "mounted"
                         : (mode == BinCalMode::GAP_FILL) ? "gap-fill" : "baseline";
    const char* phaseName = (g_binCalSubPhase == BinCalSubPhase::ROUGH_SCAN) ? "rough scan"
                          : (g_binCalSubPhase == BinCalSubPhase::GAP_FILL)   ? "gap fill"
                                                                             : "collect";
    if (mode == BinCalMode::GAP_FILL) {
        int remaining = 0, total = 0;
        magBinCalGapFillProgress(remaining, total);
        Serial.printf("[BIN_CAL] Started %s cal (%s), %d bins, %d targeted cells, max %d samples\n",
                      modeName, phaseName, g_binCalBinCount, total, MAG_CAL_BIN_MAX_SAMPLES);
        if (total == 0) {
            // Targets synced, but the server says nothing needs work. Still a
            // valid session (the diver may know better than a stale map), just
            // one worth being explicit about.
            Serial.println("[BIN_CAL] Note: target map flags no thin or empty cells");
        }
    } else {
        Serial.printf("[BIN_CAL] Started %s cal (%s), %d bins, max %d samples\n",
                      modeName, phaseName, g_binCalBinCount, MAG_CAL_BIN_MAX_SAMPLES);
    }
    return true;
}

// Copies the bootstrap's per-(cell, roll) counts into the arrays the progress
// packet, binRollSatisfied() and the roll widget already read, so the baseline
// grid is coloured by exactly the predicate gap-fill uses.
static void syncBaselineCounts() {
    for (int b = 0; b < MAG_CAL_BASELINE_BINS; b++) {
        int sum = 0;
        for (int k = 0; k < MAG_CAL_ROLL_SECTORS; k++) {
            const uint16_t c = g_boot.count(b, k);
            g_binRollCounts[b][k] = (uint8_t)(c > 255 ? 255 : c);
            sum += c;
        }
        g_binCounts[b] = (uint8_t)(sum > 255 ? 255 : sum);
    }
}

// Baseline, both sub-phases. Before the bootstrap locks this is the old
// ROUGH_SCAN: every non-duplicate sample stored, bars from min/max. Once it
// locks (util/baseline_boot.h) each sample is binned the way gap-fill bins,
// against the in-session bias, and a (cell, roll) at its ceiling stops
// accepting. The refit cadence, lock and re-bins all live in the Session.
static bool baselineTick(const Vec3i16& rawMagSensor, const Vec3f& accelCal, const Vec3f& gyroCal) {
    if (rawMagSensor.x < g_roughMin[0]) g_roughMin[0] = rawMagSensor.x;
    if (rawMagSensor.y < g_roughMin[1]) g_roughMin[1] = rawMagSensor.y;
    if (rawMagSensor.z < g_roughMin[2]) g_roughMin[2] = rawMagSensor.z;
    if (rawMagSensor.x > g_roughMax[0]) g_roughMax[0] = rawMagSensor.x;
    if (rawMagSensor.y > g_roughMax[1]) g_roughMax[1] = rawMagSensor.y;
    if (rawMagSensor.z > g_roughMax[2]) g_roughMax[2] = rawMagSensor.z;

    // Classify from the sample as it will be stored (quantised accel), so the
    // live cell and any later re-bin of this sample agree exactly.
    BinCalSample s = makeBinCalSample(rawMagSensor, accelCal, gyroCal, 0);
    const int16_t mag[3] = { s.x, s.y, s.z };
    float acc[3];
    binCalSampleAccel(s, acc);
    mag_orient::SampleOrient o;
    const bool binned = g_boot.classify(mag, acc, o);
    if (binned) {
        // Tracked every tick, accepted or not: the highlight and the roll
        // widget follow the unit, not just the samples kept.
        g_lastPitchDeg    = o.pitchDeg;
        g_lastHdgDeg      = o.headingDeg;
        g_lastRollDeg     = o.rollDeg;
        g_lastComputedBin = o.bin;
        g_lastRollSector  = o.rollSector;
    } else {
        g_lastComputedBin = -1;
        g_lastRollSector  = -1;
    }

    if (g_hasBaselineLast && g_baselineLast.x == s.x && g_baselineLast.y == s.y &&
        g_baselineLast.z == s.z) {
        return false;
    }
    if (g_binSampleCount >= MAG_CAL_BIN_MAX_SAMPLES) {
        // Buffer's full and the diver hasn't pressed BTN2 -- auto-finish
        // rather than silently discarding samples forever. Without this,
        // the sample count just stops climbing with no indication why.
        if (!g_userDone) {
            g_userDone                  = true;
            g_baselineMaxSamplesReached = true;
            Serial.println("[BIN_CAL] Sample buffer full -- auto-finishing baseline collection");
        }
        return false;
    }
    if (binned && !g_boot.accepts(o)) return false;

    s.dev_bin  = binned ? (int8_t)o.bin : (int8_t)-1;
    s.dev_roll = binned ? (int8_t)o.rollSector : (int8_t)-1;
    g_binSamples[g_binSampleCount++] = s;
    g_baselineLast    = s;
    g_hasBaselineLast = true;
    g_roughScanSampleCount++;
    magFit2DAdd(rawMagSensor);

    const float lsbPerUt = scaleReady(g_mag_lsb_per_uT) ? g_mag_lsb_per_uT : 68.42f;
    const uint32_t t0 = micros();
    const baseline_boot::Event ev = g_boot.onStored(g_binSampleSource, binned ? &o : nullptr, lsbPerUt);
    const uint32_t dt = micros() - t0;
    if (g_binSampleCount % MAG_CAL_BOOT_REFIT_EVERY == 0) {
        const baseline_boot::SphereFit& f = g_boot.lastFit();
        Serial.printf("[BIN_CAL] Refit at %d: bias (%.0f, %.0f, %.0f) r %.1f uT spread %.3f, %lu us\n",
                      g_binSampleCount, (double)f.bias[0], (double)f.bias[1], (double)f.bias[2],
                      (double)(f.radius / lsbPerUt), (double)f.spread, (unsigned long)dt);
    }
    if (ev == baseline_boot::Event::LOCKED) {
        g_binCalSubPhase = BinCalSubPhase::BASELINE_GRID;
        Serial.printf("[BIN_CAL] Bootstrap LOCKED at %d samples; grid on\n", g_boot.lockN());
    } else if (ev == baseline_boot::Event::REBIN) {
        Serial.printf("[BIN_CAL] Bootstrap moved past %.1f uT: re-binned all %d samples (re-bin #%d)\n",
                      (double)MAG_CAL_BOOT_REBIN_UT, g_binSampleCount, g_boot.rebins());
    }
    if (binned || ev != baseline_boot::Event::NONE) syncBaselineCounts();
    return true;
}

bool magBinCalTick(float pitch_deg, float heading_deg, const Vec3i16& rawMagSensor,
                    const Vec3f& accelCal, const Vec3f& gyroCal) {
    if (!g_binCalActive || !g_binSamples) return false;

    g_lastPitchDeg = pitch_deg;
    g_lastHdgDeg   = heading_deg;

    if (g_binCalSubPhase == BinCalSubPhase::ROUGH_SCAN ||
        g_binCalSubPhase == BinCalSubPhase::BASELINE_GRID) {
        return baselineTick(rawMagSensor, accelCal, gyroCal);
    }

    if (g_binCalSubPhase == BinCalSubPhase::GAP_FILL) {
        // Orientation is computed algebraically from THIS sample's mag+accel,
        // not from the AHRS pitch/heading arguments -- those come from the
        // Mahony filter, whose lag and hysteresis under rotation is what broke
        // every previous attempt at a live grid. Nothing here is filtered or
        // stateful, so the highlighted cell tracks the device exactly.
        //
        // AXIS CONVENTION (see util/mag_cal_orient.h -- getting this wrong is
        // worth up to 180 deg of heading error and would look exactly like the
        // old failures): the port wants logical-frame mag with a calibration
        // applied and calibrated accel in g. Never magNED.
        //
        // WHICH calibration matters just as much, and this was wrong until
        // 2026-09-17. It must be the frame the SERVER's target grid is
        // expressed in, which is the baseline-only fit: magBinCalDumpCSV()
        // stores RAW counts, so coverage.py bins them through its own fit of
        // the baseline collection and never sees a mounted correction. (The
        // comment that used to live here claimed this pair was "precisely what
        // DumpCSV writes and coverage.py reads" -- it is not, DumpCSV writes
        // raw.) Using the installed base-o-mount chain applies a correction for
        // scooter iron during an off-DPV pass: with this unit's mag_mount.json
        // that is up to 22 deg of heading error, ~29% of level headings binned
        // into the wrong cell, and a roll-dependent swing of +-6 to +-12 deg,
        // because a mounted soft-iron matrix is anisotropic (diag
        // 0.81/1.32/1.0 here) and rolling the unit turns the field through it.
        // The installed chain stays only as the fallback for a caller that
        // supplied nothing.
        const MagCalib& bc = g_hasBinCalBinningCal ? g_binCalBinningCal : g_magCalibration;
        const float xc = rawMagSensor.x - bc.bias.x;
        const float yc = rawMagSensor.y - bc.bias.y;
        const float zc = rawMagSensor.z - bc.bias.z;
        const float mxCal = bc.softIron[0][0]*xc + bc.softIron[0][1]*yc + bc.softIron[0][2]*zc;
        const float myCal = bc.softIron[1][0]*xc + bc.softIron[1][1]*yc + bc.softIron[1][2]*zc;
        const float mzCal = bc.softIron[2][0]*xc + bc.softIron[2][1]*yc + bc.softIron[2][2]*zc;

        // One orientation chain for every live grid: the baseline grid bins
        // through this same helper (util/baseline_boot.cpp).
        const mag_orient::SampleOrient so = mag_orient::orientSample(
            mxCal, myCal, mzCal, accelCal.x, accelCal.y, accelCal.z);
        const float algPitch = so.pitchDeg, algHdg = so.headingDeg, algRoll = so.rollDeg;
        const int gbin = so.bin;
        const int rollSector = so.rollSector;

        // Show the diver the orientation the *grid* is using, not the AHRS's.
        // If these disagree the grid is still right, and a readout that
        // contradicts the highlighted cell is how you lose trust in both.
        // Tracked every tick regardless of acceptance below, same as
        // g_lastComputedBin -- the widget's live outline follows the device,
        // not just accepted samples.
        g_lastPitchDeg    = algPitch;
        g_lastHdgDeg      = algHdg;
        g_lastRollDeg     = algRoll;
        g_lastComputedBin = gbin;
        g_lastRollSector  = rollSector;
        if (gbin < 0 || gbin >= g_binCalBinCount) return false;

        // Per-cell caps: generous where the diver was sent, token elsewhere.
        // This is the guard that keeps gap-fill from creating the next
        // over-weighted bin while closing an empty one. Targeted cells are
        // additionally capped *per roll sector* (asymmetric, upright gets
        // MAG_CAL_UPRIGHT_ROLL_WEIGHT times the others), and a sector the
        // *server* already considers ok/over from a prior accepted upload
        // stops accepting immediately regardless of this session's own count
        // -- see rollSectorSatisfied() -- so a diver isn't sent to
        // re-collect roll coverage they already have. Untargeted cells stay
        // a single flat token cap across all rolls; they're incidental
        // context, not something gap-fill is grading.
        if (binIsTargeted(gbin)) {
            if (rollSectorSatisfied(gbin, rollSector)) return false;
        } else {
            if (g_binCounts[gbin] >= MAG_CAL_GAPFILL_UNTARGETED_CAP) return false;
        }

        // Same exact-duplicate rejection as COLLECT: the mag ODR (~80 Hz) is
        // slower than the AHRS loop (100 Hz), so consecutive reads repeat.
        if (g_binHasSample[gbin]) {
            const BinCalSample& prev = g_binLastSample[gbin];
            if (prev.x == rawMagSensor.x && prev.y == rawMagSensor.y &&
                prev.z == rawMagSensor.z) {
                return false;
            }
        }

        if (g_binSampleCount >= MAG_CAL_BIN_MAX_SAMPLES) return false;

        BinCalSample s = makeBinCalSample(rawMagSensor, accelCal, gyroCal, 0);
        s.dev_bin  = (int8_t)gbin;
        s.dev_roll = (int8_t)rollSector;
        g_binSamples[g_binSampleCount++] = s;
        g_binLastSample[gbin] = s;
        g_binHasSample[gbin]  = true;
        g_binCounts[gbin]++;
        g_binRollCounts[gbin][rollSector]++;

        magFit2DAdd(rawMagSensor);
        return true;
    }

    // --- COLLECT (mounted): one dwell per cell ------------------------------
    // Nothing is recorded until the unit has sat still inside a row's attitude
    // window; see util/mounted_dwell.h for the rule and why it replaced "the
    // first 18 samples to land in the bin". Only the heading sector still
    // comes from the AHRS. Pitch and roll are accel-only, the same maths the
    // server's fit applies to these samples, so the two cannot disagree about
    // whether one is level.
    const bool magIsNew = !g_mountedHasLastMag ||
                          rawMagSensor.x != g_mountedLastMag.x ||
                          rawMagSensor.y != g_mountedLastMag.y ||
                          rawMagSensor.z != g_mountedLastMag.z;
    g_mountedLastMag    = rawMagSensor;
    g_mountedHasLastMag = true;

    const float gyroDps = sqrtf(gyroCal.x * gyroCal.x + gyroCal.y * gyroCal.y +
                                gyroCal.z * gyroCal.z) * 57.2957795f;
    const mounted_dwell::Action action = g_mountedDwell.tick(
        millis(), accelCal.x, accelCal.y, accelCal.z, gyroDps, heading_deg, magIsNew);

    g_lastPitchDeg    = g_mountedDwell.pitchDeg();
    g_lastRollDeg     = g_mountedDwell.rollDeg();
    g_lastComputedBin = g_mountedDwell.highlightCell();
    if (action == mounted_dwell::Action::NONE) return false;

    // A dwell's samples sit past g_binSampleCount until its last one arrives,
    // so an abandoned dwell costs nothing to discard: the next one overwrites
    // it. 36 cells x 18 is well inside the buffer, so this cannot run off the
    // end, but a full buffer must fail closed rather than write past it.
    const bool commit = (action == mounted_dwell::Action::COMMIT);
    const int  slot   = commit ? MAG_CAL_BIN_GREEN_THRESHOLD - 1 : g_mountedDwell.captured() - 1;
    if (g_binSampleCount + MAG_CAL_BIN_GREEN_THRESHOLD > MAG_CAL_BIN_MAX_SAMPLES) return false;
    g_binSamples[g_binSampleCount + slot] =
        makeBinCalSample(rawMagSensor, accelCal, gyroCal, (uint8_t)g_mountedDwell.dwellNumber());
    if (commit) {
        g_binSampleCount += MAG_CAL_BIN_GREEN_THRESHOLD;
        memcpy(g_binCounts, g_mountedDwell.cells(), mounted_dwell::kCells);
        Serial.printf("[BIN_CAL] Dwell %d captured: cell %d, pitch %+.1f roll %+.1f\n",
                      g_mountedDwell.dwellNumber(), g_lastComputedBin,
                      (double)g_lastPitchDeg, (double)g_lastRollDeg);
    }
    return true;
}

bool magBinCalIsActive() { return g_binCalActive; }

bool magBinCalBaselineGridLive() {
    return g_binCalActive && g_binCalSubPhase == BinCalSubPhase::BASELINE_GRID;
}

bool magBinCalFinishBaseline() {
    if (!g_binCalActive) return false;

    // Mounted: any time after the first cell. g_binSampleCount only ever
    // grows by a whole committed dwell (a dwell in progress sits past it), so
    // nonzero means at least one cell is filled, and the CSV holds only
    // finished dwells. Too few cells to fit is the server's call: it refuses
    // under its own floor, and the display shows that reason.
    if (binCalIsMounted()) {
        if (g_binSampleCount == 0) {
            Serial.println("[BIN_CAL] Finish ignored: no mounted cell filled yet");
            return false;
        }
        g_userDone = true;
        Serial.printf("[BIN_CAL] Mounted collection finished by diver: %d cells, "
                      "uploading for server-side grading\n",
                      g_binSampleCount / MAG_CAL_BIN_GREEN_THRESHOLD);
        return true;
    }

    // Gap-fill has a lower floor: it patches a handful of cells, so a
    // legitimately complete session is small. Both count every stored sample
    // (g_binSampleCount); baseline's ROUGH_SCAN-only counter would also do
    // before the live grid existed, but not after it locks.
    const bool isGapFill = (g_binCalMode == BinCalMode::GAP_FILL);
    const int  have = g_binSampleCount;
    const int  need = isGapFill ? MAG_CAL_GAPFILL_MIN_SAMPLES
                                : MAG_CAL_ROUGH_SCAN_MIN_SAMPLES;
    if (have < need) {
        Serial.printf("[BIN_CAL] Finish ignored: only %d samples (need %d)\n", have, need);
        return false;
    }

    g_userDone = true;
    Serial.printf("[BIN_CAL] %s collection finished by diver: %d samples, "
                  "uploading for server-side grading\n",
                  isGapFill ? "Gap-fill" : "Baseline", have);
    return true;
}

void magBinCalGapFillProgress(int& remainingOut, int& totalOut) {
    remainingOut = 0;
    totalOut = 0;
    if (!g_binCalActive || g_binCalMode != BinCalMode::GAP_FILL || !g_binHasTargets) return;

    for (int i = 0; i < g_binCalBinCount && i < 60; i++) {
        if (!binIsTargeted(i)) continue;
        totalOut++;
        if (!binRollSatisfied(i)) remainingOut++;
    }
}

bool magBinCalIsComplete() {
    if (!g_binCalActive) return false;

    if (g_binCalMode == BinCalMode::GAP_FILL) {
        // Unlike baseline, gap-fill CAN establish completion as a fact: the
        // diver is working a finite list of cells the server handed over, and
        // every one of them is either at its cap or not. The diver can still
        // stop early (magBinCalFinishBaseline) -- a cell may simply not be
        // reachable in the water.
        if (g_userDone) return true;
        int remaining = 0, total = 0;
        magBinCalGapFillProgress(remaining, total);
        // total == 0 means the target map flags nothing. That must not read as
        // "instantly complete" -- it would dump a near-empty CSV the moment
        // collection started. Leave it to the diver's explicit finish.
        return total > 0 && remaining == 0;
    }

    if (!binCalIsMounted()) {
        // Baseline has no bin/grid completion concept anymore -- it's a diver
        // decision (magBinCalFinishBaseline), not auto-detected coverage.
        return g_userDone;
    }

    // Mounted: the diver pressed FINISH, or the whole level row and enough of
    // each tilted row spread around the circle (mounted_dwell::rowComplete).
    return g_userDone || g_mountedDwell.complete();
}

// Fills the attitude-varying fields that CalProgressPacket and
// CalOrientPacket share. Both describe the same instant, and the display
// merges the fast packet's copies straight over the slow packet's, so the two
// must be filled identically -- a divergence here shows up on the device as
// the highlighted cell and the roll widget describing different cells.
// Templated rather than duplicated for exactly that reason; the field names
// are deliberately identical in both structs (see dpvlink.h).
//
// Roll widget: for whichever cell current_bin points at, the combined
// server-prior-upload + this-session status per roll sector
// (rollSectorSatisfied -- 0=ok/satisfied, either because the server already
// considered this sector ok/over from a prior accepted upload, or this
// session's own count cleared its cap; 1=some local samples but not yet
// satisfied; 2=none locally and not server-satisfied), plus the live roll
// sector for the widget's outline. `current_bin_roll_counts` stays
// this-session-only (the server doesn't send per-roll sample counts, only
// status), so a sector satisfied purely by prior server coverage shows status
// 0 with count 0 -- correct, not a display bug. Only meaningful in gap-fill;
// zeroed and sector -1 otherwise, matching current_bin's own "-1 if
// unmappable".
template <typename PktT>
static void fillLiveOrient(PktT& pkt) {
    pkt.current_bin   = (g_lastComputedBin >= 0 && g_lastComputedBin < g_binCalBinCount)
                        ? (int8_t)g_lastComputedBin : (int8_t)-1;
    pkt.cur_pitch_deg = g_lastPitchDeg;
    pkt.cur_hdg_deg   = g_lastHdgDeg;

    if (binCalIsMounted()) {
        pkt.cur_roll_deg  = g_lastRollDeg;
        pkt.motion        = g_mountedDwell.motion();
        pkt.motion_term   = (uint8_t)g_mountedDwell.motionTerm();
        pkt.dwell_pct     = g_mountedDwell.dwellPct();
        pkt.capture_state = (uint8_t)g_mountedDwell.state();
    } else {
        pkt.cur_roll_deg  = 0.0f;
        pkt.motion        = 0;
        pkt.motion_term   = 0;
        pkt.dwell_pct     = 0;
        pkt.capture_state = (uint8_t)CalDwellState::OUT_OF_WINDOW;
    }

    if ((g_binCalSubPhase == BinCalSubPhase::GAP_FILL ||
         g_binCalSubPhase == BinCalSubPhase::BASELINE_GRID) && pkt.current_bin >= 0) {
        const int bin = pkt.current_bin;
        for (int k = 0; k < MAG_CAL_ROLL_SECTORS; k++) {
            const uint8_t cnt = g_binRollCounts[bin][k];
            pkt.current_bin_roll_counts[k] = cnt;
            pkt.current_bin_roll_targeted[k] = rollSectorSatisfied(bin, k) ? 0 : (cnt > 0) ? 1 : 2;
        }
        pkt.current_roll_sector = (int8_t)g_lastRollSector;
    } else {
        memset(pkt.current_bin_roll_counts, 0, sizeof(pkt.current_bin_roll_counts));
        memset(pkt.current_bin_roll_targeted, 0, sizeof(pkt.current_bin_roll_targeted));
        pkt.current_roll_sector = -1;
    }
}

void magBinCalGetOrient(CalOrientPacket& pkt) {
    fillLiveOrient(pkt);
}

void magBinCalGetProgress(CalProgressPacket& pkt) {
    pkt.cal_type   = binCalIsMounted() ? (uint8_t)CalType::MOUNTED : (uint8_t)CalType::BASELINE;
    pkt.phase      = (g_binCalSubPhase == BinCalSubPhase::ROUGH_SCAN)    ? (uint8_t)CalPhase::ROUGH_SCAN
                   : (g_binCalSubPhase == BinCalSubPhase::GAP_FILL)      ? (uint8_t)CalPhase::GAP_FILL
                   : (g_binCalSubPhase == BinCalSubPhase::BASELINE_GRID) ? (uint8_t)CalPhase::BASELINE_GRID
                                                                         : (uint8_t)CalPhase::COLLECT;
    pkt.bins_total = (uint8_t)g_binCalBinCount;
    pkt.complete   = magBinCalIsComplete();
    pkt.sample_count = (uint16_t)g_binSampleCount;

    // In gap-fill, "green" counts *satisfied targets*, not cells that reached
    // the baseline green threshold. The diver's job is the target list, so
    // that's what the X/Y readout has to count -- against MAG_CAL_BIN_GREEN_
    // THRESHOLD, a session that finished every target would still read 0/60.
    const bool gapFill = (g_binCalSubPhase == BinCalSubPhase::GAP_FILL);
    // The baseline grid treats every cell as a target and judges it with the
    // same binRollSatisfied() gap-fill does (no server roll targets are loaded
    // in baseline, so that is this session's counts alone).
    const bool baselineGrid = (g_binCalSubPhase == BinCalSubPhase::BASELINE_GRID);
    uint8_t green = 0;
    for (int i = 0; i < g_binCalBinCount; i++) {
        uint8_t cnt = g_binCounts[i];
        pkt.bin_counts[i] = cnt;
        if (gapFill) {
            if (binIsTargeted(i) && binRollSatisfied(i)) green++;
        } else if (baselineGrid) {
            if (binRollSatisfied(i)) green++;
        } else if (cnt >= MAG_CAL_BIN_GREEN_THRESHOLD) {
            green++;
        }
    }
    // Mounted counts toward what the diver has to fill (kNeedTotal cells, all
    // 36 since 2026-11-09), and never reads full while a tilted row is still
    // bunched on one side. The display's denominator is
    // mounted_dwell::kNeedTotal.
    if (binCalIsMounted()) green = (uint8_t)mounted_dwell::progressCount(g_binCounts);
    // Zero-fill remaining slots (for baseline → 60, mounted → 36, rest = 0)
    for (int i = g_binCalBinCount; i < 60; i++) {
        pkt.bin_counts[i] = 0;
    }
    pkt.bins_green    = green;
    // bins_total stays the GRID size (60), not the target count: it sizes the
    // bin_counts array on the wire and the cell loop on the display, so
    // repurposing it as a denominator would truncate both. The display derives
    // the target count from `targets` itself, which it already has.
    if (gapFill) {
        pkt.has_targets = g_binHasTargets;
        memcpy(pkt.targets, g_binTargets, sizeof(pkt.targets));
        // Per-cell "finished" comes from binRollSatisfied() -- the SAME
        // predicate as bins_green above and magBinCalIsComplete() below.
        // The display used to derive cell colour from bin_counts instead,
        // which turned a cell green on 15 upright-only samples while this
        // predicate (correctly) still wanted the other three roll sectors.
        pkt.has_cell_satisfied = g_binHasTargets;
        for (int i = 0; i < 60; i++) {
            pkt.cell_satisfied[i] = (i < g_binCalBinCount) && binIsTargeted(i) && binRollSatisfied(i);
        }
    } else if (baselineGrid) {
        pkt.has_targets = false;
        memset(pkt.targets, 0, sizeof(pkt.targets));
        pkt.has_cell_satisfied = true;
        for (int i = 0; i < 60; i++) {
            pkt.cell_satisfied[i] = (i < g_binCalBinCount) && binRollSatisfied(i);
        }
    } else {
        pkt.has_targets = false;
        memset(pkt.targets, 0, sizeof(pkt.targets));
        pkt.has_cell_satisfied = false;
        memset(pkt.cell_satisfied, 0, sizeof(pkt.cell_satisfied));
    }
    pkt.max_samples_reached = g_baselineMaxSamplesReached;
    fillLiveOrient(pkt);

    if (g_binCalSubPhase == BinCalSubPhase::ROUGH_SCAN && g_roughScanSampleCount > 0) {
        // fmaxf(0, ...) guards the pre-first-sample state where max<min (sentinel
        // INT16_MAX/MIN) — negative-to-uint8_t conversion is UB, so clamp first.
        pkt.cov_x = (uint8_t)fmaxf(0.0f, fminf(100.0f, ((float)(g_roughMax[0] - g_roughMin[0]) / MAG_CAL_ROUGH_SCAN_EXPECTED_RANGE) * 100.0f));
        pkt.cov_y = (uint8_t)fmaxf(0.0f, fminf(100.0f, ((float)(g_roughMax[1] - g_roughMin[1]) / MAG_CAL_ROUGH_SCAN_EXPECTED_RANGE) * 100.0f));
        pkt.cov_z = (uint8_t)fmaxf(0.0f, fminf(100.0f, ((float)(g_roughMax[2] - g_roughMin[2]) / MAG_CAL_ROUGH_SCAN_EXPECTED_RANGE) * 100.0f));
    } else {
        pkt.cov_x = pkt.cov_y = pkt.cov_z = 0;
    }

    // Update incremental fit and populate quality fields.
    // magFit2DSolve() runs a 4×4 Gauss-Jordan solve on the accumulated sums —
    // cheap enough to call every time GetProgress is polled (~2 Hz).
    magFit2DSolve();
    pkt.fit_valid       = g_magFit.valid;
    pkt.fit_hdg_err_deg = g_magFit.hdg_err_deg;
    // Convert normalised-space delta to µT for a device-independent unit on display side.
    // FIT_NORM = 4096 counts; g_mag_lsb_per_uT ≈ 68.42 LSB/µT.
    pkt.fit_delta = (g_mag_lsb_per_uT > 0)
                  ? g_magFit.delta * FIT_NORM / g_mag_lsb_per_uT
                  : 0.0f;
}

void magBinCalDumpCSV(void* filePtr) {
    if (!g_binSamples || !filePtr) return;
    File& f = *reinterpret_cast<File*>(filePtr);
    // The three trailing columns were added 2026-10-11. Both server loaders
    // (callib/fit.py, callib/coverage.py) read the leading nine by position
    // and ignore the rest, so the order of the first nine is fixed.
    // dev_bin/dev_roll (2026-11-06): the cell the device showed for the
    // sample, -1 if none. Same trailing-column rule.
    f.println("mx,my,mz,ax,ay,az,gx,gy,gz,mag_temp_c,tcomp,dwell,dev_bin,dev_roll");
    for (int i = 0; i < g_binSampleCount; i++) {
        const BinCalSample& s = g_binSamples[i];
        char temp[12];
        if (s.temp_centi_c == BIN_CAL_NO_TEMP) snprintf(temp, sizeof(temp), "nan");
        else snprintf(temp, sizeof(temp), "%.2f", (double)s.temp_centi_c / 100.0);
        f.printf("%d,%d,%d,%.5f,%.5f,%.5f,%.5f,%.5f,%.5f,%s,%u,%u,%d,%d\n",
                 s.x, s.y, s.z,
                 (double)(s.ax / BIN_CAL_ACCEL_LSB_PER_G), (double)(s.ay / BIN_CAL_ACCEL_LSB_PER_G),
                 (double)(s.az / BIN_CAL_ACCEL_LSB_PER_G),
                 (double)(s.gx / BIN_CAL_GYRO_LSB_PER_RAD_S), (double)(s.gy / BIN_CAL_GYRO_LSB_PER_RAD_S),
                 (double)(s.gz / BIN_CAL_GYRO_LSB_PER_RAD_S),
                 temp, (unsigned)s.tcomp, (unsigned)s.dwell, (int)s.dev_bin, (int)s.dev_roll);
    }
    Serial.printf("[BIN_CAL] Wrote %d samples to CSV\n", g_binSampleCount);
}

// Frees only the sample buffer. Split out of magBinCalEnd() because the cloud
// upload sits between the CSV dump and the end of the cal, and holding the
// buffer (69,120 bytes when this was found, 51,840 now) across it starves the
// WiFi driver -- see the call site in nav_main.cpp.
void magBinCalFreeSamples() {
    if (g_binSamples) {
        free(g_binSamples);
        g_binSamples = nullptr;
        Serial.printf("[BIN_CAL] Freed sample buffer (%u bytes); heap_free=%u largest=%u\n",
                      (unsigned)(MAG_CAL_BIN_MAX_SAMPLES * sizeof(BinCalSample)),
                      (unsigned)ESP.getFreeHeap(),
                      (unsigned)heap_caps_get_largest_free_block(MALLOC_CAP_8BIT));
    }
}

void magBinCalEnd() {
    magBinCalFreeSamples();
    magFit2DReset();
    g_binCalActive    = false;
    g_binCalMode      = BinCalMode::BASELINE;
    g_hasBinCalBinningCal = false;
    g_binHasTargets   = false;
    memset(g_binTargets, 0, sizeof(g_binTargets));
    g_binHasRollTargets = false;
    memset(g_binRollTargets, 0, sizeof(g_binRollTargets));
    g_binCalSubPhase  = BinCalSubPhase::COLLECT;
    g_binSampleCount  = 0;
    g_binCalBinCount  = 0;
    g_roughScanSampleCount = 0;
    g_userDone = false;
    g_baselineMaxSamplesReached = false;
    g_boot.reset();
    g_hasBaselineLast = false;
    g_lastComputedBin = -1;
    g_lastPitchDeg    = 0.0f;
    g_lastHdgDeg      = 0.0f;
    g_lastRollDeg     = 0.0f;
    g_lastRollSector  = -1;
    memset(g_binCounts,     0, sizeof(g_binCounts));
    memset(g_binRollCounts, 0, sizeof(g_binRollCounts));
    memset(g_binHasSample,  0, sizeof(g_binHasSample));
    memset(g_binLastSample, 0, sizeof(g_binLastSample));
    g_mountedDwell.reset();
    g_mountedHasLastMag = false;
}

// ----------- Gyroscope Calibration -----------
// Calibrates gyroscope bias by sampling at rest
void calibrateGyroscope(Calib3& out, uint32_t duration_ms) {
  if (!gyro_inited) {
    Serial.println("[CAL] Error: Gyroscope not initialized");
    out.bias = {0, 0, 0};
    out.scale = {1, 1, 1};
    return;
  }

  Serial.println("[CAL] ========================================");
  Serial.println("[CAL] GYROSCOPE CALIBRATION");
  Serial.println("[CAL] ========================================");
  Serial.println("[CAL] Place device on stable, level surface");
  Serial.println("[CAL] Do NOT move or rotate the device");
  Serial.print("[CAL] Starting in 5 seconds...");
  delay(5000);
  Serial.println(" Go!");

  // Initialize accumulators
  double sumX = 0, sumY = 0, sumZ = 0;
  uint32_t sampleCount = 0;
  uint32_t startTime = millis();

  // Sample for specified duration
  while (millis() - startTime < duration_ms) {
    Vec3i16 reading;
    if (readGyroRaw(reading) == ImuStatus::Ok) {
      sumX += reading.x;
      sumY += reading.y;
      sumZ += reading.z;
      sampleCount++;
    }
    delay(10);  // ~100 Hz sampling
  }

  // Calculate average (bias)
  if (sampleCount > 0) {
    out.bias.x = (float)(sumX / (double)sampleCount);
    out.bias.y = (float)(sumY / (double)sampleCount);
    out.bias.z = (float)(sumZ / (double)sampleCount);
  } else {
    out.bias = {0, 0, 0};
  }

  // Scale is identity (no scaling calibration for gyro currently)
  out.scale = {1, 1, 1};

  g_gyroCalibration = out;

  Serial.println("[CAL] Gyroscope calibration complete!");
  Serial.print("[CAL] Samples collected: ");
  Serial.println(sampleCount);
  Serial.print("[CAL] Gyro bias (raw counts): X=");
  Serial.print(out.bias.x, 1);
  Serial.print(" Y=");
  Serial.print(out.bias.y, 1);
  Serial.print(" Z=");
  Serial.println(out.bias.z, 1);
  Serial.print("[CAL] Gyro bias (rad/s): X=");
  Serial.print((out.bias.x / g_gyro_lsb_per_dps) * 0.017453292519943295f, 6);
  Serial.print(" Y=");
  Serial.print((out.bias.y / g_gyro_lsb_per_dps) * 0.017453292519943295f, 6);
  Serial.print(" Z=");
  Serial.println((out.bias.z / g_gyro_lsb_per_dps) * 0.017453292519943295f, 6);
}

// ----------- Accelerometer Calibration -----------

// Labels match the 6 sample points calibrateAccelerometer() below takes,
// indexed the same way: 0/1 = ±X, 2/3 = ±Y, 4/5 = ±Z. Attitude phrase first
// (what it feels/looks like to hold), then which physical edge/side ends up
// pointing up (the actionable instruction), then the NED tag for reference.
const char* const kAccelOrientationNames[6] = {
  "Nose pointing straight up — Front edge UP (NED +X up)",
  "Nose pointing straight down — Front edge DOWN (NED -X up)",
  "Resting on its left side — RIGHT side UP (NED +Y up)",
  "Resting on its right side — LEFT side UP (NED -Y up)",
  "Upside down, level — BOTTOM side UP (NED +Z up)",
  "Straight and level, normal — TOP side UP (NED -Z up)"
};

int classifyAccelOrientation(const Vec3i16& accelRawLogical) {
  // A resting accelerometer reads ~+1g (g_accel_lsb_per_g counts) along
  // whichever physical axis currently points straight up, and ~-1g along
  // that axis when it points straight down. Require the dominant axis to
  // clearly exceed the others so a tilted/in-between orientation reports
  // "no match" instead of a misleading guess.
  float ax = (float)accelRawLogical.x;
  float ay = (float)accelRawLogical.y;
  float az = (float)accelRawLogical.z;
  float aax = fabsf(ax), aay = fabsf(ay), aaz = fabsf(az);
  float thresh = g_accel_lsb_per_g * 0.7f;

  if (aax > thresh && aax > aay && aax > aaz) return ax > 0 ? 0 : 1;
  if (aay > thresh && aay > aax && aay > aaz) return ay > 0 ? 2 : 3;
  if (aaz > thresh && aaz > aax && aaz > aay) return az > 0 ? 4 : 5;
  return -1;
}

// Calibrates accelerometer by sampling at 6 orientations (±X, ±Y, ±Z)
void calibrateAccelerometer(Calib3& out, uint32_t sample_duration_ms) {
  if (!accel_inited) {
    Serial.println("[CAL] Error: Accelerometer not initialized");
    out.bias = {0, 0, 0};
    out.scale = {1, 1, 1};
    return;
  }

  Serial.println("[CAL] ========================================");
  Serial.println("[CAL] ACCELEROMETER CALIBRATION");
  Serial.println("[CAL] ========================================");
  Serial.println("[CAL] You will be asked to orient the device in 6 directions.");
  Serial.println("[CAL] For each one: point the device that way, then press Enter to sample.");
  Serial.println("[CAL] (Not sure which way is which? Run the 'accel_orient' serial");
  Serial.println("[CAL]  command first to see how rotating the device changes the reading.)");
  delay(2000);

  // Arrays to store average readings for each orientation
  // Calibration measures LOGICAL (NED frame) axes after axis mapping
  // NED frame: +X=forward/north, +Y=right/east, +Z=down
  // Place device with each NED axis pointing UP (against gravity)
  Vec3f measurements[6] = {};

  // Calibrate each axis
  for (int i = 0; i < 6; i++) {
    Serial.println("[CAL] ----------------------------------------");
    Serial.print("[CAL] Orientation ");
    Serial.print(i + 1);
    Serial.print(" of 6: ");
    Serial.println(kAccelOrientationNames[i]);
    Serial.print("[CAL] Press Enter when ready...");
    while (!Serial.available()) { delay(10); }
    Serial.readStringUntil('\n');
    Serial.println(" Sampling!");

    // Sample for specified duration
    double sumX = 0, sumY = 0, sumZ = 0;
    uint32_t sampleCount = 0;
    uint32_t startTime = millis();

    while (millis() - startTime < sample_duration_ms) {
      Vec3i16 reading;
      if (readAccelRaw(reading) == ImuStatus::Ok) {
        sumX += reading.x;
        sumY += reading.y;
        sumZ += reading.z;
        sampleCount++;
      }
      delay(10);
    }

    // Store average
    if (sampleCount > 0) {
      measurements[i].x = (float)(sumX / (double)sampleCount);
      measurements[i].y = (float)(sumY / (double)sampleCount);
      measurements[i].z = (float)(sumZ / (double)sampleCount);
    }

    Serial.print("[CAL] Samples: ");
    Serial.print(sampleCount);
    Serial.print(" | Raw avg: X=");
    Serial.print(measurements[i].x, 0);
    Serial.print(" Y=");
    Serial.print(measurements[i].y, 0);
    Serial.print(" Z=");
    Serial.println(measurements[i].z, 0);
  }

  // Calculate bias and scale from the 6 measurements
  // Each axis should show +/-1g when pointing up/down
  // bias = (max + min) / 2 (in raw counts)
  // scale = g_accel_lsb_per_g / (max - bias) (dimensionless correction factor)
  // Expected range is ±1g = ±g_accel_lsb_per_g counts

  // The half-span between the +1g and -1g readings is the divisor for scale.
  // If an orientation collected no samples its entry is still {0,0,0} from the
  // zero-init above, so a single failed step makes the span zero and the
  // division yields inf -- which saveCalib3() then writes to flash as the text
  // "inf", atof() reads back on the next boot, and Mahony converts into a
  // permanently NaN quaternion (inf normalized is inf*0 == NaN). Refuse the
  // axis instead: identity scale is merely uncalibrated, inf is fatal.
  // Expected half-span is g_accel_lsb_per_g (1g); anything under a tenth of
  // that is a failed or skipped orientation, not a real measurement.
  const float minHalfSpan = (g_accel_lsb_per_g > 0.0f) ? g_accel_lsb_per_g * 0.1f : 1.0f;
  auto axisScale = [&](float vMax, float vMin, char axis) -> float {
    float halfSpan = (vMax - vMin) / 2.0f;
    if (!(halfSpan > minHalfSpan)) {   // negated form also rejects NaN
      Serial.printf("[CAL] ERROR: %c axis span is %.1f counts (need > %.1f) -- "
                    "orientation missed or sensor read failed. "
                    "Using scale 1.0 for %c; RERUN THIS CALIBRATION.\n",
                    axis, (double)(halfSpan * 2.0f), (double)(minHalfSpan * 2.0f), axis);
      return 1.0f;
    }
    return g_accel_lsb_per_g / halfSpan;  // Dimensionless
  };

  // X axis
  float xMax = max(measurements[0].x, measurements[1].x);
  float xMin = min(measurements[0].x, measurements[1].x);
  out.bias.x = (xMax + xMin) / 2.0f;
  out.scale.x = axisScale(xMax, xMin, 'X');

  // Y axis
  float yMax = max(measurements[2].y, measurements[3].y);
  float yMin = min(measurements[2].y, measurements[3].y);
  out.bias.y = (yMax + yMin) / 2.0f;
  out.scale.y = axisScale(yMax, yMin, 'Y');

  // Z axis
  float zMax = max(measurements[4].z, measurements[5].z);
  float zMin = min(measurements[4].z, measurements[5].z);
  out.bias.z = (zMax + zMin) / 2.0f;
  out.scale.z = axisScale(zMax, zMin, 'Z');

  g_accelCalibration = out;

  Serial.println("[CAL] ========================================");
  Serial.println("[CAL] ACCELEROMETER CALIBRATION COMPLETE");
  Serial.println("[CAL] ========================================");
  Serial.print("[CAL] Bias (raw counts): X=");
  Serial.print(out.bias.x, 1);
  Serial.print(" Y=");
  Serial.print(out.bias.y, 1);
  Serial.print(" Z=");
  Serial.println(out.bias.z, 1);
  Serial.print("[CAL] Bias (m/s²): X=");
  Serial.print(out.bias.x, 6);
  Serial.print(" Y=");
  Serial.print(out.bias.y, 6);
  Serial.print(" Z=");
  Serial.println(out.bias.z, 6);
  Serial.print("[CAL] Scale: X=");
  Serial.print(out.scale.x, 6);
  Serial.print(" Y=");
  Serial.print(out.scale.y, 6);
  Serial.print(" Z=");
  Serial.println(out.scale.z, 6);
}


// -------------- Init --------------
bool init(const ImuConfig& cfg, const AxisMap& accelGyroMap, const AxisMap& magMap) {
  g_cfg = cfg;
  g_accelGyroMap = accelGyroMap;
  g_magMap = magMap;

  Serial.println("Initializing IMU ...");

  // You can call each init separately too, but this is convenient.
  ImuStatus ag_return_val = initAccelGyro();
  if (ag_return_val != ImuStatus::Ok) {
    Serial.print("Error initializing IMU accel/gyro: ");
    Serial.println((int)ag_return_val);
    return false;
  }
  ImuStatus mag_return_val = initMag();
  if (mag_return_val != ImuStatus::Ok) {
    Serial.print("Error initializing IMU magnetometer: ");
    Serial.println((int)mag_return_val);
    return false;
  }
  
  //inited = true;
  return true;
}

ImuStatus initAccelGyro(TwoWire& wire) {
  gWire = &wire;

  // Initialize I2C bus with correct pins
  gWire->begin(SDA_PIN, SCL_PIN);
  delay(50);

  Serial.print("Scanning for LSM6DS3 at 0x6A or 0x6B...");
  if (!detectLsm6ds3Address()) {
    Serial.println(" FAILED");
    return ImuStatus::WhoAmIMismatch;
  }
  Serial.print(" Found at 0x");
  Serial.println(gLsmAddr, HEX);

  // Soft reset
  if (!write8(gLsmAddr, LSM6DS3_CTRL3_C, CTRL3_SW_RESET)) return ImuStatus::BusError;
  delay(50);

  // Enable register auto-increment + block data update
  // (Read-modify-write is safer than blasting a constant)
  uint8_t ctrl3 = 0;
  if (!read8(gLsmAddr, LSM6DS3_CTRL3_C, ctrl3)) return ImuStatus::BusError;
  ctrl3 |= (CTRL3_IF_INC | CTRL3_BDU);
  if (!write8(gLsmAddr, LSM6DS3_CTRL3_C, ctrl3)) return ImuStatus::BusError;

  // --- Set accel config (CTRL1_XL) ---
  // ODR_XL=104 Hz (0100), FS_XL=±4g (10), BW_XL=100 Hz (10)
  // => 0b0100_10_10 = 0x4A
  if (!write8(gLsmAddr, LSM6DS3_CTRL1_XL, 0x4A)) return ImuStatus::BusError;
  
  // Set accel sensitivity: ±4g range = 122 LSB/g (from datasheet)
  g_accel_lsb_per_g = 8192.0f;

  // --- Set gyro config (CTRL2_G) ---
  // ODR_G=104 Hz (0100), FS_G=±500 dps (01), FS_125=0
  // => 0b0100_01_00 = 0x44
  if (!write8(gLsmAddr, LSM6DS3_CTRL2_G, 0x44)) return ImuStatus::BusError;
  
  // Set gyro sensitivity: ±500 dps range = 65.5 LSB/dps (from datasheet)
  g_gyro_lsb_per_dps = 65.5f;

  accel_inited = true;
  gyro_inited = true;
  return ImuStatus::Ok;
}

ImuStatus initMag(TwoWire& wire) {
  // Optional: sanity check WHO_AM_I
  wire.begin(SDA_PIN, SCL_PIN);
  wire.beginTransmission(LIS3MDL_ADDR);
  wire.write(LIS3MDL_REG_WHO_AM_I);
  wire.endTransmission(false);
  wire.requestFrom((int)LIS3MDL_ADDR, 1);
  uint8_t who = wire.available() ? wire.read() : 0xFF;
  //Serial.print("LIS3MDL WHO_AM_I (expect 0x3D): 0x");
  //Serial.println(who, HEX);

  // This used to be advisory only: initMag() checked WHO_AM_I, ignored the
  // answer, ignored every magWrite() result, and returned Ok unconditionally.
  // A mag that never responded still counted as initialized, so the nav loop
  // never took its sensor-error path.
  if (who != 0x3D) {
    Serial.printf("[IMU] LIS3MDL WHO_AM_I = 0x%02X (expect 0x3D) -- mag absent or bus fault\n", who);
    mag_inited = false;
    return ImuStatus::WhoAmIMismatch;
  }

  // Basic configuration:
  // CTRL_REG1 = 0xF0 = 0b1111_0000: TEMP_EN=1, OM=11 (ultra-high-performance
  // on X/Y), DO=100 (10 Hz), FAST_ODR=0, ST=0.
  //
  // TEMP_EN was 0 until 2026-09-11 (the value was 0x70, and the comment here
  // claimed "~20 Hz" — DO=100 is 10 Hz; the 20 Hz encoding is DO=101). The die
  // temperature is enabled because the magnetometer's offset moves with
  // temperature and the only other thermometer on the unit (MS5837, in the
  // nose) lags it badly. Enabling it costs nothing: temperature conversion is
  // independent of the magnetic channels.
  bool cfgOk = true;
  cfgOk &= magWrite(LIS3MDL_REG_CTRL_REG1, 0xF0); // TEMP_EN, UHP XY, 10 Hz

  // CTRL_REG2: full-scale ±4 gauss (0x00) is fine
  cfgOk &= magWrite(LIS3MDL_REG_CTRL_REG2, 0x00);

  // CTRL_REG3: continuous-conversion mode (MD[1:0] = 00)
  cfgOk &= magWrite(LIS3MDL_REG_CTRL_REG3, 0x00);

  // CTRL_REG4: ultra-high-performance on Z
  cfgOk &= magWrite(LIS3MDL_REG_CTRL_REG4, 0x0C);

  // CTRL_REG5: enable BDU (block data update) — prevents reading partial
  // register updates mid-conversion, which causes byte tearing
  cfgOk &= magWrite(LIS3MDL_REG_CTRL_REG5, 0x40);

  delay(20); // give it a moment

  if (!cfgOk) {
    Serial.println("[IMU] LIS3MDL config write failed -- mag not initialized");
    mag_inited = false;
    return ImuStatus::BusError;
  }

  g_mag_lsb_per_uT = 6842.0f / 100.0f; // 6842 LSB/gauss = 6842/100 LSB/µT for ±4 gauss FS in UHP mode
  mag_inited = true;
  return ImuStatus::Ok;
}

// ----------- Raw reads (sensor frame, NO axis mapping) -----------
// These return data in the sensor's native coordinate frame for diagnostics
ImuStatus readAccelRaw_SensorFrame(Vec3i16& vecOut) {
  if (!accel_inited) return ImuStatus::NotInitialized;
  uint8_t b[6];
  if (!readN(gLsmAddr, LSM6DS3_OUTX_L_XL, b, 6)) return ImuStatus::BusError;

  vecOut.x = (int16_t)((uint16_t)b[1] << 8 | b[0]);
  vecOut.y = (int16_t)((uint16_t)b[3] << 8 | b[2]);
  vecOut.z = (int16_t)((uint16_t)b[5] << 8 | b[4]);

  return ImuStatus::Ok;
}

ImuStatus readGyroRaw_SensorFrame(Vec3i16& vecOut) {
  if (!gyro_inited) return ImuStatus::NotInitialized;
  uint8_t b[6];
  if (!readN(gLsmAddr, LSM6DS3_OUTX_L_G, b, 6)) return ImuStatus::BusError;

  vecOut.x = (int16_t)((uint16_t)b[1] << 8 | b[0]);
  vecOut.y = (int16_t)((uint16_t)b[3] << 8 | b[2]);
  vecOut.z = (int16_t)((uint16_t)b[5] << 8 | b[4]);

  return ImuStatus::Ok;
}

// Die temperature from the two TEMP_OUT bytes. 8 LSB/°C, 0 = 25 °C (AN4602 §6).
// Returns false for a value outside the LIS3MDL's -40..+85 °C operating range,
// which can only be a bus fault.
static bool decodeMagTemp(uint8_t lo, uint8_t hi, float& out) {
  const int16_t raw = (int16_t)(hi << 8 | lo);
  const float t = 25.0f + (float)raw / 8.0f;
  if (!(t >= -40.0f && t <= 85.0f)) return false;
  out = t;
  return true;
}

static int16_t clampToI16(float v) {
  if (v >  32767.0f) return  32767;
  if (v < -32768.0f) return -32768;
  return (int16_t)lroundf(v);
}

ImuStatus readMagRaw_SensorFrame(Vec3i16& vecOut) {
  if (!mag_inited) return ImuStatus::NotInitialized;
  uint8_t buffer[6];
  magRead(LIS3MDL_REG_OUT_X_L | 0x80, buffer, 6); // 0x80 for auto-increment

  // Little-endian: low byte first
  vecOut.x = (int16_t)(buffer[1] << 8 | buffer[0]);
  vecOut.y = (int16_t)(buffer[3] << 8 | buffer[2]);
  vecOut.z = (int16_t)(buffer[5] << 8 | buffer[4]);

  // Die temperature: its OWN 2-byte read, never part of the field burst. An
  // 8-byte burst 0x28-0x2F was tried and returned TEMP_OUT frozen at a garbage
  // value (55.88 °C in a 23 °C room, 2026-09-15), while the separate 2-byte
  // read (a32a491 firmware) tracked real temperature in every thermal log.
  // Rate-limited: temperature moves over seconds, and the loop reads the field
  // twice per pass at 100 Hz. A failed read keeps the previous value.
  static uint32_t lastTempReadMs = 0;
  const uint32_t nowMs = millis();
  if (!g_magTempSeen || nowMs - lastTempReadMs >= MAG_TEMP_READ_INTERVAL_MS) {
    lastTempReadMs = nowMs;
    uint8_t tb[2];
    float t;
    if (magRead(LIS3MDL_REG_TEMP_OUT_L | 0x80, tb, 2) == 2 && decodeMagTemp(tb[0], tb[1], t)) {
      g_magTemp_c   = t;
      g_magTempSeen = true;
    }
  }

  if (g_magTempCompOn && g_magTempSeen && scaleReady(g_mag_lsb_per_uT)) {
    const float k = (g_magTemp_c - g_magTempRef_c) * g_mag_lsb_per_uT;  // counts per (µT/°C)
    vecOut.x = clampToI16((float)vecOut.x - g_magTempCoeffSensor.x * k);
    vecOut.y = clampToI16((float)vecOut.y - g_magTempCoeffSensor.y * k);
    vecOut.z = clampToI16((float)vecOut.z - g_magTempCoeffSensor.z * k);
  }

  return ImuStatus::Ok;
}

// ----------- Raw reads (WITH axis mapping) -----------
ImuStatus readAccelRaw(Vec3i16& vecOut) {
  Vec3i16 sensorFrame;
  ImuStatus s = readAccelRaw_SensorFrame(sensorFrame);
  if (s != ImuStatus::Ok) return s;

  // Apply axis mapping to convert from sensor frame to logical frame (NED)
  vecOut = applyAxisMap(sensorFrame, g_accelGyroMap);
  return ImuStatus::Ok;
}

ImuStatus readGyroRaw(Vec3i16& vecOut) {
  Vec3i16 sensorFrame;
  ImuStatus s = readGyroRaw_SensorFrame(sensorFrame);
  if (s != ImuStatus::Ok) return s;

  // Apply axis mapping to convert from sensor frame to logical frame (NED)
  vecOut = applyAxisMap(sensorFrame, g_accelGyroMap);
  return ImuStatus::Ok;
}

ImuStatus readMagRaw(Vec3i16& vecOut) {
  Vec3i16 sensorFrame;
  ImuStatus s = readMagRaw_SensorFrame(sensorFrame);
  if (s != ImuStatus::Ok) return s;

  // Apply axis mapping to convert from sensor frame to logical frame (NED)
  vecOut = applyAxisMap(sensorFrame, g_magMap);
  return ImuStatus::Ok;
}

// ----------- Unit reads -----------
ImuStatus readAccel_g(Vec3f& out) {
  if (!scaleReady(g_accel_lsb_per_g)) return ImuStatus::NotInitialized;
  Vec3i16 raw;
  ImuStatus s = readAccelRaw(raw);
  if (s != ImuStatus::Ok) return s;

  Vec3f f = toFloat(raw);

  // Apply calibration in raw counts domain, then convert to g
  // Formula: ((raw - bias) * scale) / g_accel_lsb_per_g
  // Where bias is in counts, scale is dimensionless, result is in g
  out.x = ((f.x - g_accelCalibration.bias.x) * g_accelCalibration.scale.x) / g_accel_lsb_per_g;
  out.y = ((f.y - g_accelCalibration.bias.y) * g_accelCalibration.scale.y) / g_accel_lsb_per_g;
  out.z = ((f.z - g_accelCalibration.bias.z) * g_accelCalibration.scale.z) / g_accel_lsb_per_g;

  return ImuStatus::Ok;
}

// Read accelerometer with both raw (uncalibrated) and calibrated outputs
ImuStatus readAccel_g_raw_cal(Vec3f& rawOut, Vec3f& calOut) {
  if (!scaleReady(g_accel_lsb_per_g)) return ImuStatus::NotInitialized;
  Vec3i16 raw;
  ImuStatus s = readAccelRaw(raw);
  if (s != ImuStatus::Ok) return s;

  Vec3f f = toFloat(raw);

  // Raw (uncalibrated, just converted to g)
  rawOut = { f.x / g_accel_lsb_per_g, f.y / g_accel_lsb_per_g, f.z / g_accel_lsb_per_g };

  // Calibrated: ((raw - bias) * scale) / g_accel_lsb_per_g (result in g)
  calOut.x = ((f.x - g_accelCalibration.bias.x) * g_accelCalibration.scale.x) / g_accel_lsb_per_g;
  calOut.y = ((f.y - g_accelCalibration.bias.y) * g_accelCalibration.scale.y) / g_accel_lsb_per_g;
  calOut.z = ((f.z - g_accelCalibration.bias.z) * g_accelCalibration.scale.z) / g_accel_lsb_per_g;

  return ImuStatus::Ok;
}

ImuStatus readAccel_mps2(Vec3f& out) {
  Vec3f gVals;
  ImuStatus s = readAccel_g(gVals);
  if (s != ImuStatus::Ok) return s;

  const float GRAVITY = 9.81f;  // m/s²

  out = { gVals.x * GRAVITY, gVals.y * GRAVITY, gVals.z * GRAVITY };
  return ImuStatus::Ok;
}

ImuStatus readGyro_rad_s(Vec3f& out) {
  if (!scaleReady(g_gyro_lsb_per_dps)) return ImuStatus::NotInitialized;
  Vec3i16 raw;
  ImuStatus s = readGyroRaw(raw);
  if (s != ImuStatus::Ok) return s;

  Vec3f f = toFloat(raw);
  // Apply bias subtraction in raw counts, then convert to dps then rad/s
  float dps_x = (f.x - g_gyroCalibration.bias.x) / g_gyro_lsb_per_dps;
  float dps_y = (f.y - g_gyroCalibration.bias.y) / g_gyro_lsb_per_dps;
  float dps_z = (f.z - g_gyroCalibration.bias.z) / g_gyro_lsb_per_dps;

  out = { dpsToRad(dps_x), dpsToRad(dps_y), dpsToRad(dps_z) };
  return ImuStatus::Ok;
}

// Read gyroscope with both raw (uncalibrated) and calibrated outputs
ImuStatus readGyro_rad_s_raw_cal(Vec3f& rawOut, Vec3f& calOut) {
  if (!scaleReady(g_gyro_lsb_per_dps)) return ImuStatus::NotInitialized;
  Vec3i16 raw;
  ImuStatus s = readGyroRaw(raw);
  if (s != ImuStatus::Ok) return s;

  Vec3f f = toFloat(raw);
  float dps_x = f.x / g_gyro_lsb_per_dps;
  float dps_y = f.y / g_gyro_lsb_per_dps;
  float dps_z = f.z / g_gyro_lsb_per_dps;

  // Raw (uncalibrated, just converted to rad/s)
  rawOut = { dpsToRad(dps_x), dpsToRad(dps_y), dpsToRad(dps_z) };
  
  // Calibrated: apply bias subtraction
  float cal_dps_x = dps_x - (g_gyroCalibration.bias.x / g_gyro_lsb_per_dps);
  float cal_dps_y = dps_y - (g_gyroCalibration.bias.y / g_gyro_lsb_per_dps);
  float cal_dps_z = dps_z - (g_gyroCalibration.bias.z / g_gyro_lsb_per_dps);
  calOut = { dpsToRad(cal_dps_x), dpsToRad(cal_dps_y), dpsToRad(cal_dps_z) };

  return ImuStatus::Ok;
}

ImuStatus readMagTemp_c(float& out) {
  if (!mag_inited) return ImuStatus::NotInitialized;
  // The nav loop reads the field every pass, and that read refreshes the
  // temperature every MAG_TEMP_READ_INTERVAL_MS -- so this is normally free,
  // and is exactly the value the thermal compensation used.
  if (g_magTempSeen) {
    out = g_magTemp_c;
    return ImuStatus::Ok;
  }

  // Nothing captured yet (no field read so far): read the register directly.
  // Two's complement, little-endian. 8 LSB/degC, nominal zero at 25 degC. The
  // offset is not factory-trimmed, so treat the absolute value as indicative
  // and the CHANGE as the real measurement (see imu.h).
  uint8_t buffer[2];
  float t;
  if (magRead(LIS3MDL_REG_TEMP_OUT_L | 0x80, buffer, 2) != 2 ||
      !decodeMagTemp(buffer[0], buffer[1], t)) {
    return ImuStatus::BusError;
  }
  out = t;
  return ImuStatus::Ok;
}

void setMagTempCompensation(const Vec3f& coeffLogical_uT_per_c, float ref_c) {
  if (!isfinite(coeffLogical_uT_per_c.x) || !isfinite(coeffLogical_uT_per_c.y) ||
      !isfinite(coeffLogical_uT_per_c.z) || !isfinite(ref_c)) {
    clearMagTempCompensation();
    return;
  }
  // Logical = axis-mapped sensor: logical[i] = sign * sensor[idx]. Invert it,
  // so sensor[idx] = sign * logical[i]. Needs the mag map, which init() sets.
  const float logical[3] = {coeffLogical_uT_per_c.x, coeffLogical_uT_per_c.y,
                            coeffLogical_uT_per_c.z};
  const int8_t codes[3]  = {g_magMap.x_axis, g_magMap.y_axis, g_magMap.z_axis};
  float sensor[3] = {0.0f, 0.0f, 0.0f};
  for (int i = 0; i < 3; i++) {
    const int idx = (codes[i] < 0 ? -codes[i] : codes[i]) - 1;
    if (idx < 0 || idx > 2) { clearMagTempCompensation(); return; }
    sensor[idx] = (codes[i] < 0 ? -1.0f : 1.0f) * logical[i];
  }
  g_magTempCoeffSensor = {sensor[0], sensor[1], sensor[2]};
  g_magTempRef_c       = ref_c;
  g_magTempCompOn      = true;
}

void clearMagTempCompensation() {
  g_magTempCompOn      = false;
  g_magTempCoeffSensor = {0.0f, 0.0f, 0.0f};
}

bool magTempCompensationActive() {
  return g_magTempCompOn;
}

ImuStatus readMag_uT(Vec3f& out) {
  Vec3i16 raw;
  ImuStatus s = readMagRaw(raw);
  if (s != ImuStatus::Ok) return s;

  Vec3f f = toFloat(raw);
  out = { f.x / g_mag_lsb_per_uT, f.y / g_mag_lsb_per_uT, f.z / g_mag_lsb_per_uT };
  return ImuStatus::Ok;
}

// ----------- Calibration setters -----------
// Set the calibration data used by all read functions.
// Call these after loading from LittleFS or after running a calibrate function.
void setAccelCalibration(const Calib3& cal) {
  g_accelCalibration = cal;
}

void setGyroCalibration(const Calib3& cal) {
  g_gyroCalibration = cal;
}

void setMagCalibration(const MagCalib& cal) {
  g_magCalibration = cal;
}

void getMagCalibration(MagCalib& out) {
  out = g_magCalibration;
}

// Read magnetometer with both raw (uncalibrated) and calibrated outputs
// rawOut: raw sensor values converted to µT (no calibration applied)
// calOut: with environmental offset (hard-iron) + soft-iron correction applied
ImuStatus readMag_raw_cal(Vec3f& rawOut, Vec3f& calOut) {
  if (!scaleReady(g_mag_lsb_per_uT)) return ImuStatus::NotInitialized;
  Vec3i16 rawSensor;
  ImuStatus s = readMagRaw(rawSensor);
  if (s != ImuStatus::Ok) return s;

  // Convert raw to float in µT (uncalibrated)
  Vec3f rawFloat = toFloat(rawSensor);
  rawOut = { rawFloat.x / g_mag_lsb_per_uT, rawFloat.y / g_mag_lsb_per_uT, rawFloat.z / g_mag_lsb_per_uT };
  //rawOut = { rawFloat.x / g_mag_lsb_per_uT, rawFloat.y / g_mag_lsb_per_uT, rawFloat.z / g_mag_lsb_per_uT };

  // Apply hard-iron offset (bias subtraction)
  Vec3f hardIronCorrected = {
    rawFloat.x - g_magCalibration.bias.x,
    rawFloat.y - g_magCalibration.bias.y,
    rawFloat.z - g_magCalibration.bias.z
  };

  // Apply soft-iron correction (3x3 matrix multiplication)
  Vec3f corrected = {
    g_magCalibration.softIron[0][0] * hardIronCorrected.x +
    g_magCalibration.softIron[0][1] * hardIronCorrected.y +
    g_magCalibration.softIron[0][2] * hardIronCorrected.z,

    g_magCalibration.softIron[1][0] * hardIronCorrected.x +
    g_magCalibration.softIron[1][1] * hardIronCorrected.y +
    g_magCalibration.softIron[1][2] * hardIronCorrected.z,

    g_magCalibration.softIron[2][0] * hardIronCorrected.x +
    g_magCalibration.softIron[2][1] * hardIronCorrected.y +
    g_magCalibration.softIron[2][2] * hardIronCorrected.z
  };
  
  // Convert corrected magnetic field to µT
  calOut = { corrected.x / g_mag_lsb_per_uT, corrected.y / g_mag_lsb_per_uT, corrected.z / g_mag_lsb_per_uT };

  return ImuStatus::Ok;
}

// Read magnetometer with calibration applied (environmental offsets + soft-iron correction)
// Returns calibrated magnetic field as Vec3f
ImuStatus readMag(Vec3f& out) {
  if (!scaleReady(g_mag_lsb_per_uT)) return ImuStatus::NotInitialized;
  Vec3i16 raw;
  ImuStatus s = readMagRaw(raw);
  if (s != ImuStatus::Ok) return s;

  // Convert raw to float
  Vec3f rawFloat = toFloat(raw);

  // Apply hard-iron offset (bias subtraction)
  Vec3f hardIronCorrected = {
    rawFloat.x - g_magCalibration.bias.x,
    rawFloat.y - g_magCalibration.bias.y,
    rawFloat.z - g_magCalibration.bias.z
  };

  // Apply soft-iron correction (3x3 matrix multiplication)
  out = {
    g_magCalibration.softIron[0][0] * hardIronCorrected.x +
    g_magCalibration.softIron[0][1] * hardIronCorrected.y +
    g_magCalibration.softIron[0][2] * hardIronCorrected.z,

    g_magCalibration.softIron[1][0] * hardIronCorrected.x +
    g_magCalibration.softIron[1][1] * hardIronCorrected.y +
    g_magCalibration.softIron[1][2] * hardIronCorrected.z,

    g_magCalibration.softIron[2][0] * hardIronCorrected.x +
    g_magCalibration.softIron[2][1] * hardIronCorrected.y +
    g_magCalibration.softIron[2][2] * hardIronCorrected.z
  };

  return ImuStatus::Ok;
}

} // namespace imu
