djmcmath/dpv-nav/(commit log)

2026-01-17 Numerous changes; working towards first real build
    [partitions.csv]
2026-02-15 Fix Mahony AHRS filter: correct quaternion rotation, gravity ref, and mag frame
    Three bugs in the Mahony filter caused heading drift, pitch/roll instability,
    and mirrored heading:
    1. quatRotate used body-to-world (q*v*q') where world-to-body (q'*v*q) was
    needed for computing expected sensor directions. Added quatRotateWorldToBody.
    2. Gravity reference was {0,0,+1} but accelerometer reads {0,0,-1g} when level
    (specific force convention). Changed to {0,0,-1}.
    3. Magnetometer axis mapping inverts Y for atan2 heading display, but Mahony
    filter needs true NED body frame. Negate mag Y before passing to filter.
    Also: set magnetic declination to 14.88° (14°53'E), tune kp=1.0/ki=0.005,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
    [calib.cpp, imu.cpp, imu.h, lis3mdl.h, logging-integration-example.cpp, logging.cpp, logging.h]
2026-02-15 First version where AHRS heading actually tracks!
    [partitions.csv]
2026-03-04 Two-device architecture: nav device + display device with serial link
    Major restructuring from single-device to two-device system:
    - Split entry points: nav_main.cpp (sensors/AHRS/GPS/DR) and display_main.cpp (OLED/buttons)
    - Add dpvlink library for inter-device JSON packet protocol (NavPacket, DebugPacket, DisplayCmd)
    - Add GPS driver, flow sensor improvements, serial command interface
    - Add web server and WiFi manager for configuration
    - Consolidate and clean up documentation
    - Add PlatformIO build system (platformio.ini with nav/display environments)
    - Update .gitignore for PlatformIO and Claude Code artifacts
    - Add magnetometer calibration tools and sample data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
    [mag_samples.csv]
2026-03-06 GFXcanvas16 framebuffer display, menu system, GPS/WiFi dive mode
    Display: Replace direct SPI draw calls with offscreen GFXcanvas16
    framebuffer (24KB). All drawing targets canvas (pure RAM writes),
    flushed to SSD1351 via single bulk SPI transfer per frame. Eliminates
    SPI timing-related display blanking that required per-call delays.
    Added serial self-test commands for display diagnostics.
    Menu: Add hierarchical menu system (BTN1 cycles, BTN2 selects) with
    JSON-configurable structure. Supports nav actions (set home, mark),
    calibration triggers, input toggles (GPS, WiFi, logging), and display
    settings (debug mode, units, heading source).
    Nav: Add dive/surface op mode toggle — dive mode disa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
    [board_pins.h, config.h, display.cpp, display.h, display_main.cpp, gps.cpp, gps.h, menu.cpp]
2026-03-08 Waypoint navigation, level-based logging, live status bar indicators
    Add outbound waypoint support: web UI for saving/clearing lat/lon waypoints
    to LittleFS, NAV_OUTBOUND menu action loads waypoint and sets as target via
    new nav::setTargetLatLon(). Redesign status bar to show BATT/CAL/WiFi/GPS/P/S
    indicators with live state from NavPacket flags. Rewrite logging system with
    three-level cycling (OFF/LOW/HIGH), sequential file numbering, automatic
    cleanup of oldest logs when space is low, and schema-appropriate CSV headers.
    Wire up GPS pos/speed/WiFi toggle commands to actual state variables and
    broadcast enable flags in NavPacket so display menu labels stay in sync.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
    [display.cpp, display_main.cpp, logging.cpp, logging.h, menu.cpp, menu.h, nav_main.cpp, nav_model.cpp]
2026-03-10 Starting in on board design
    [display_board.kicad_pcb, display_board.kicad_sch]
2026-03-10 First draft of display PCB
    [display_board.kicad_pcb, display_board.kicad_sch]
2026-03-10 Updating board project
2026-03-10 updating pcb
    [display_board.kicad_pcb, display_board.kicad_sch]
2026-03-11 updating pcb again
2026-03-13 Working calibration efforts
2026-03-14 Running calibration work
2026-03-18 Tweaking board-pins
2026-03-19 First version of Nav PCB
    [display_board.kicad_pcb, nav_board.kicad_pcb, nav_board.kicad_sch]
2026-03-20 Added speed calibration (first effort)
2026-03-20 Complete speed calibration: fix race condition, VFS error, and update docs
    - Fix race condition where display phase reset to NONE after BTN2 confirm:
    removed backward-reset logic in processNavLine(); phase advances
    forward-only (WAITING→RUNNING→RESULT)
    - Fix ESP32 VFS error log on first run by guarding LittleFS.open() with
    LittleFS.exists() check in speed_cal.cpp
    - Update docs: full speed cal workflow in user-guide.md and
    calibration-guide.md; v1 feature bullet in overview.md; CLAUDE.md
    updated with speed_cal files and multi-phase UI description
    [display_main.cpp, speed_cal.cpp]
2026-03-20 First order of PCBs
    [display_board-B_Cu.gbr, display_board-B_Mask.gbr, display_board-B_Paste.gbr, display_board-B_Silkscreen.gbr, display_board-Edge_Cuts.gbr, display_board-F_Cu.gbr, display_board-F_Mask.gbr, display_board-F_Paste.gbr]
2026-04-10 Collection of display improvements
    [display_board.kicad_pcb, display_board.kicad_sch]
2026-04-16 Added improved wireless control - now it joins a known wireless station, which is helpful in the dive locker. Added two-button turn-on (and low power mode) Improved GPS performance with hot-start Red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
    [display_board-B_Cu.gbr, display_board-B_Mask.gbr, display_board-B_Paste.gbr, display_board-B_Silkscreen.gbr, display_board-Edge_Cuts.gbr, display_board-F_Cu.gbr, display_board-F_Mask.gbr, display_board-F_Paste.gbr]
2026-04-22 Rewrite calibration docs; update baseline cal result; clean up old tools data
    - Replaced calibration-guide.md and mag-calibration-workflow.md with a single
    authoritative guide covering the two-stage baseline+mounted workflow, expected
    Python output with good/acceptable/poor thresholds, and compass verification
    - Updated tools/README.md to reflect current two-mode script interface
    - Fixed all stale doc references (CLAUDE.md, firmware example)
    - Updated tools/mag_base.json with latest baseline calibration result
    - Removed old/superseded CSV and JSON calibration data from tools/
2026-04-27 Added 4-point heading calibration
    After mag cal, small residual heading errors (typically 2-8 degrees) remain. This adds a CAL > Hdg cal workflow where the user aligns the DPV to each cardinal (N/E/S/W) and presses BTN2; the nav device stores the 4 indicated headings and applies circular linear interpolation at runtime to reduce residual error.
    - src/util/hdg_cal.cpp/h: new module - load/save/apply/corrections
    - lib/dpvlink: added heading_raw_deg to NavPacket, SET_HDG_CAL command, serialization helpers
    - src/nav_main.cpp: applies hdg_cal correction to heading; loads /hdg_cal.json on boot; handles SET_HDG_CAL DisplayCmd
    - src/drivers/display.cpp/h: showHdgCalPrompt() and showHdgCalSummary()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
    [config.h, display.cpp, display.h, display_main.cpp, hdg_cal.cpp, hdg_cal.h, menu.cpp, menu.h]
2026-05-15 Correcting bug in Fourier fit Adding reload button to web page
    [display.cpp, nav_main.cpp, web_server.cpp]
2026-05-15 Fixing small bug in naming
    [nav_main.cpp]
2026-05-17 Fixed bug where the speed calibration wasn't being loaded at boot. Created scripts to adjust reconstruction data post dive
    [config.h, nav_main.cpp]
2026-06-04 Updating nav board, and also K-factor for speed cal
    [nav_board-B_Cu.gbr, nav_board-B_Mask.gbr, nav_board-B_Paste.gbr, nav_board-B_Silkscreen.gbr, nav_board-Edge_Cuts.gbr, nav_board-F_Cu.gbr, nav_board-F_Mask.gbr, nav_board-F_Paste.gbr]
2026-06-12 Adding a logo to the images folder. Updating python tool to correct for a calibration run, e.g. reciprocal legs between two known points. Adding GPS fix quality to LOW log level.
    [motor_cal.json]
2026-06-12 Fixing a merge correction to deconflict a variable that had been named differently between branchs.
    [logging.cpp]
2026-06-15 Updating docs for named waypoints, motor cal, and correct_track.py
2026-07-13 Rotating display to account for latest board build
2026-07-13 Guarding against a zero-length DR path in correct_track, refreshing mounted mag calibration
    Dividing by total_path to report closure error as a percentage blew up when a
    segment had no dead-reckoned movement; report "n/a, zero DR path" instead.
    Also refreshes mag_mount.json and the mounted/calibration sample CSVs from the
    latest run, and ignores spreadsheet scratch files (.ods) and editor lock files.
2026-07-14 Assemble multi-file dives and correct them safely across splices
    A dive is not a file. The unit gets power cycled on the boat, logging is
    started late or stopped early, and one dive routinely lands on disk as two
    or three files. These tools reassemble them.
    assemble_track.py (new): splits uploads into runs, puts each on wall-clock
    time from local_time, classifies them (good / unanchored / idle / trivial /
    unplaceable), groups survivors into dives, trims stationary GPS, and emits
    one CSV per dive carrying t_s and seg.
    correct_track.py:
    - Reads an optional t_s column. timestamp_ms is millis-since-boot and resets
    on every power cycle, so it cannot span files.
    - Never integrates DR across a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
2026-07-14 Add auto mode: pick the correction the data can actually support
    The correction mode is not a preference, it is decided by the anchor
    geometry -- because that geometry determines what can be identified at all.
    Each both-anchored segment supplies exactly 2 equations. The unknowns are
    speed factor k, heading offset theta, and (if the water moved) the two
    components of current:
    2 informative segments (4 eqns) -> k, theta, current [reciprocal]
    1 informative segment (2 eqns) -> k, theta, no current [joint]
    0 informative segments -> nothing identifiable [proportional]
    A segment only counts if its net displacement is a real fraction of the
    distance travelled. On an out-and-back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
2026-07-14 Move track assembly and correction to the Divemap repo
    assemble_track.py, correct_track.py and their tests now live in
    dive-map/track-processor/. They stopped being bench scripts and became the
    engine of a Divemap service -- the track-processor container runs exactly
    this code -- and keeping a second copy here would guarantee the two drift.
    A divergence between what the website computes and what you compute at the
    bench is a very hard bug to see.
    tools/README.md now points at the new home and documents how to run them
    against the logs in this directory. The firmware-side Python (magnetometer
    calibration, sensor tooling) is unaffected and stays.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
2026-07-17 Fix log-level desync between menu and main screen
    The display kept a local optimistic counter (gLogLevel) that it
    incremented on each button press, while the main-screen indicator read
    the authoritative level from NavPacket flags. The two drifted whenever
    the nav device booted with a level restored from NVS (menu always
    started at OFF) or when the nav rejected a change (e.g. logging not
    ready), leaving the menu suffix lying about the real state.
    Switch log level to the same authoritative-echo pattern already used by
    GPS Pos/Spd/WiFi: extract it from the incoming packet flags in
    updateNavState(), and make the button press fire-and-forget instead of
    mutating gLogLevel locally. The wire protoc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
    [menu.cpp]
2026-07-18 Harden mag/heading cal tooling against footguns; refresh cal data
    Tooling & docs (reusable):
    - fourier_fit.py: cap harmonic count by point count to prevent overfit
    on sparse sets, and warn when heading coverage has a gap >45deg
    - mag_calibration.py: warn loudly when --output name won't be read by
    firmware; fix upload instructions to /mag_base.json and /mag_mount.json
    - calibration-guide.md + CLAUDE.md: add heading-cal troubleshooting
    (TRUE/MAG check mismatch, mount-file naming, motor offset invisible to
    cal, coverage gaps); fix stale mounted-cal command
    Calibration data (from today's session):
    - refresh mag_base.json, mag_mount.json, hdg_fourier.json and the
    baseline/mounted/headi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
2026-07-24 Add cloud account-linking and magnetometer calibration UI
    Nav board: device-code auth flow (net/cloud_client), a bigger loop-task
    stack to stop a stack-overflow reboot mid-poll that was silently killing
    in-progress link attempts, and aligned auth/link timeouts against the
    backend's code TTL.
    Display board: link-account and calibration-grid screens, partial-redraw
    caching to stop full-screen flicker on the link-waiting screen, and a
    larger font for its instructions.
    [partitions_nav.csv]
2026-07-26 Retire live baseline coverage grid; collect honest, grade in the cloud
    Baseline calibration no longer tries to predict coverage completion
    on-device -- every attempt at that (AHRS bin grid, Fibonacci lattice,
    fixed body axis, two-pass Mahony handoff, per-axis bars, incremental
    fit gating) failed on real hardware or broke down analytically. Instead
    the collector now just samples honestly (sample count, rough axis
    bars, no completion claim) and logs 9-axis data (mag+accel+gyro, not
    just mag) so the fit that follows can reconstruct orientation
    retroactively. See divemap's baseline-cal-coverage-feedback-plan.md for
    the server side; docs/baseline-cal-two-pass.md keeps the on-device
    diagnostic his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
    [cloud_client.cpp, cloud_client.h, config.h, display.cpp, display.h, display_main.cpp, imu.cpp, imu.h]
2026-07-27 Add calibration install sync and archival backup
    Closes the gap where an accepted web calibration result never reached the
    physical unit unless the diver was live on it: net/cal_sync.cpp pulls
    accepted-but-not-installed baseline/mounted/hdg results down via new
    cloud_client calls, applies them the same way ACCEPT_CLOUD_CAL already does,
    and confirms the install server-side (with an NVS-backed retry if the
    confirm call itself fails). Also mirrors accel/gyro/speed calibration data
    to the cloud for the first time, purely as disaster-recovery backup -- no
    grading, no accept/reject, just insurance against the partition-loss
    incidents that already happened once for real.
    New "Calibration Cloud Sy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
    [cal_sync.cpp, cal_sync.h, cloud_client.cpp, cloud_client.h, nav_main.cpp, nav_main.h, web_server.cpp]
2026-08-11 Fix confusing first-run mag cal and accel cal orientation prompts
    - Boot: skip the blind 90s min/max mag sweep on a brand-new device
    (no mag_base/mount/legacy files at all). It produced a low-quality
    fit with no feedback; mag now stays uncalibrated (identity) until
    the diver runs CAL > Baseline (+ Mounted) from the menu.
    - Accel cal: reword the 6 orientation prompts as attitude-first plain
    language ("Nose pointing straight up") plus which edge ends up on
    top, instead of raw NED axis jargon.
    - Add an `accel_orient` serial command that prints the matching
    orientation as the device rotates, so a diver can learn the mapping
    before running the real calibration.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
    [imu.cpp, imu.h, nav_main.cpp, serial_commands.cpp]
2026-08-11 Route Fourier heading cal through the shared cloud wait/result UI
    The 12-point heading cal used to end on a local "done" screen with
    manual export/fit/upload instructions. It now hands off to the same
    gCloudCalPhase wait/result state machine baseline/mounted cal already
    use for their bin-grid completion, so the nav device uploads and fits
    the heading samples the same way. showCloudCalResult gains a calType
    parameter so it can label the result in degrees of max Fourier residual
    for heading cal instead of percent-of-radius for baseline/mounted,
    without growing a parallel wire field.
2026-08-23 Add depth sensor support (BlueRobotics Bar30 / MS5837-30BA)
    Adds an optional pressure/depth sensor on the nav board's J3 I2C header:
    a new MS5837 driver (src/drivers/ms5837.*) and a depth module
    (src/sensors/depth.*) that converts pressure to depth using a
    runtime-selectable salt/fresh water density (CONFIG > Water), zeroed
    against surface pressure a moment after boot.
    Depth also drives an automatic dive/surface mode trigger: crossing
    ~1 ft engages dive mode (GPS+WiFi off) immediately, while reverting to
    surface requires staying shallower than ~0.5 ft for 30s so wave chop
    doesn't flap the radios. The manual Op Mode toggle still works;
    setDiveMode() is now the single entry point for both.
    D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
    [config.h, depth.cpp, depth.h, display.cpp, display.h, display_main.cpp, i2c_bus.cpp, i2c_bus.h]
2026-08-23 Pin all three current Lets Encrypt roots for device-auth TLS
    divemap.diverdaniel.com's cert chain moved to Lets Encrypt's new
    Generation Y hierarchy (ISRG Root YE) after their 2026-05-13 ACME
    profile cutover, breaking the previously pinned ISRG Root X1-only
    CA and hanging account-link's beginAuthorize() call. Pin YE, X2,
    and X1 so BearSSL can terminate the chain walk at whichever root it
    reaches first, and document the OTA-update gap this exposed.
2026-08-23 Add unconditional boot self-test for IMU, GPS, and display link
    GPS init previously fired config commands and unconditionally returned
    true regardless of whether the module ever responded, so a dead GPS
    looked identical to a working one until someone noticed a missing fix.
    No display-link connectivity check existed at all -- the failure mode
    that cost hours of debugging earlier today (a bad solder joint on the
    nav board silently killed display->nav commands while nav->display
    looked completely normal) would not have been caught at boot.
    - gps::init() now waits up to 2.5s for a real checksum-valid NMEA
    sentence before returning true.
    - New boot-time round-trip check: nav pings the display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
    [display.cpp, display_main.cpp, gps.cpp, nav_main.cpp]
2026-08-23 Add diver-initiated dive-log upload panel to local web UI
    Replaces the earlier idea of auto-uploading on WiFi reconnect with an
    explicit "Upload Dive Logs" flow: checkboxes next to each /logs/*.csv
    file, upload only what's selected, download still available if the
    diver would rather keep a local copy. Reuses cloud::uploadBackup()'s
    existing device-auth/upload plumbing with kind="dive_log" instead of
    duplicating the HTTP logic.
    [cloud_client.h, web_server.cpp]
2026-08-27 Remove TLS CA pinning from cloud client; trust bearer token instead
    Pinned Let's Encrypt roots broke in production on 2026-08-22 when LE cut
    over to its new "Generation Y" hierarchy -- every pinned unit lost cloud
    connectivity until reflashed by hand. Rather than build a refreshable-CA
    scheme, switch every WiFiClientSecure to setInsecure(): traffic is still
    TLS-encrypted, just not chain-validated. The real security boundary was
    already the bearer token issued by device-auth and checked server-side
    against a DB-stored hash, independent of TLS validation, and the payloads
    here are dive calibration data, not anything sensitive enough to justify
    reflashing the fleet on every future CA rotation.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
    [cloud_client.cpp]
2026-08-27 Switch dev upload ports to macOS device paths; ignore host test binaries
    platformio.ini's upload/monitor ports were still the Windows COM-port
    values; point them at this machine's /dev/cu.usbserial-* paths instead.
    Also ignore the compiled harnesses under tools/orient_equiv/ and
    tools/dpvlink_test/ -- built on demand by their own runner scripts, never
    meant to be checked in.
2026-08-27 Add guided gap-fill roll-coverage axis; harden cloud cal round trip
    Roll coverage
    -------------
    The elevation x heading coverage grid is deliberately roll-invariant (that's
    what makes tilt compensation work), so a cell could read fully green while
    every sample came from the same roll about the tracked axis -- a real,
    previously invisible coverage gap, confirmed both from real hardware CSVs
    and a geometry simulation of "upright only" collection. Each cell now also
    grades roll diversity across 4 sectors (upright/right-side/upside-down/
    left-side), upright weighted higher than the others. src/util/mag_cal_orient
    is a new, dependency-free algebraic per-sample orientation module -- a
    verbatim por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
    [frame_fixture.csv, motor_cal.json]
2026-08-27 Add RAW heading mode for gap-fill collection
    The website's heading gap-fill form asks the diver to read the indicated
    heading off the unit. That used to require deleting /hdg_fourier.json,
    zeroing /motor_cal.json, reloading cal, and then restoring both by hand --
    and motor_cal.json has no backup/restore path at all (it is not in
    cal_sync.cpp's BACKUP_FILES), so the procedure was one forgotten copy away
    from losing it.
    None of that was ever necessary. heading_raw_deg is already on the wire as
    the pre-Fourier, pre-motor-offset *magnetic* heading (nav_main.cpp passes
    headingMagDeg), which is the exact value CAPTURE_HDG_POINT records as
    "indicated". It was simply never displayed -- only the cal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
2026-08-31 Ignore the device-auth bearer token written by cloud-link tooling
    tools/device_token.json is a live bearer token for the tern cloud, written
    by the device-auth link flow. It has no business in the repo.
2026-08-31 Stop the GPS replaying a pre-dive position as a fresh fix
    Adafruit_GPS holds its last parsed values indefinitely, and setEnabled(false)
    cuts power to the module without clearing them. So the first getFix() after
    surfacing returned the position from the *previous* surfacing, looking
    perfectly valid.
    GPS_FIX_STALE_MS was supposed to catch exactly this and could not, because
    fix_age_ms was stamped at read time rather than at parse time -- a retained
    position was therefore always "0 ms old".
    Three changes:
    - fix_age_ms is now stamped when a position sentence actually parses.
    - The disabled->enabled edge clears the parser's retained fix, quality,
    satellite count and HDOP.
    - Position is withh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
    [config.h, gps.cpp]
2026-08-31 Make the menu survivable with gloves on at depth
    Three defects here cost a dive in August 2026: the diver could not find
    Config > Log underwater and shut the unit down by hand to stop logging, and
    separately powered the unit off while trying to select Display.
    Do not let these regress -- they are load-bearing, not cosmetic.
    Never power off by accident:
    - OFF was root item 0, which made it both the item the menu opened on and
    the item Display wrapped onto -- two separate ways to shut down by
    pressing BTN2 one beat early. It now sits second-to-last, with the
    harmless "Close" behind it, so overshooting the end of the list lands on
    a no-op instead of on the one action a diver cannot w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
    [display_main.cpp, menu.cpp, menu.h]
2026-08-31 Warn which board uploadfs is safe on, and where menu.json lives
    Both environments share the one data/ directory, but only one is safe to
    overwrite. `pio run -e nav -t uploadfs` erases dive logs, mag_base.json,
    mag_mount.json, hdg_fourier.json, motor_cal.json, speed_cal.json,
    cal_targets.json and the cal archives; the docs recommended exactly that
    command. `-e display -t uploadfs` is the safe one -- that board's
    filesystem holds only /menu.json and nothing on it ever writes to LittleFS.
    Also records that menu.json is read by the display board, so it cannot be
    pushed over WiFi: the web UI's file upload lives on the nav board (net/ is
    in [env:nav] only, and the display env has no network stack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
2026-08-31 Document deriving the flow k-factor from a corrected dive
    A dive that Dive Map has corrected against known positions reports a speed
    factor s where true_speed = s x logged_speed. Since the flow sensor's
    k-factor is a divisor, k_new = k_old / s. Sign check worth doing every
    time: s < 1 means the unit read fast, so k goes up.
    The two ways to get this wrong, both written down:
    - k_old must be what the unit was actually running on that dive -- its NVS
    history via speed_cal::averageK(), not the seed file in
    "baseline cal jsons/", or the composition is wrong.
    - Use one joint least-squares solve over the legs you trust. Averaging
    per-leg s values (each has absorbed its own leg's heading err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
2026-08-31 Ignore dive-log CSVs captured under tools/logs
    Logs pulled off the device for analysis land in tools/logs and were showing
    up as untracked noise on every status check. They are captured data rather
    than source, and at ~2MB for a handful of dives they are not something to
    put in history, where they would be awkward to remove later.
    The existing `*.log` rule did not cover them -- the exports are .csv.
2026-09-04 Adding preliminary BOM to the repo
    [Tern DPV-Nav BOM.ods]
2026-09-08 Add "Delete Selected" bulk delete to file manager
    Deleting dive logs one row at a time after a cloud upload is tedious.
    Add a red "Delete Selected" button beside "Upload Selected to Cloud"
    that operates on the same checkbox selection.
    Confirmation lists every file by name (first 25, then a "... and N
    more" tail) along with the count, so there is no ambiguity about what
    is about to go. Deletes run serially against the existing
    /api/delete endpoint -- no firmware-side changes needed. Both bar
    buttons disable during the run, progress shows as "Deleting N of M",
    and the final line reports per-file failures by name rather than
    collapsing them into a single error.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
    [web_server.cpp]
2026-09-08 Upload dive logs automatically once the unit joins a network
    Replaces the manual "select logs, push the button" flow as the normal path.
    The diver's job post-dive is now: stop logging, enable WiFi, walk away --
    the unit associates with a known AP (a phone hotspot in the car) and sends
    every log it hasn't already sent. The tern.local buttons stay as the
    force/retry path.
    net/log_sync.cpp drives it, gated on an STA association, a linked account,
    and not being mid-calibration. It never uploads the log currently being
    written: half a file now and the finished file later are different bytes,
    which the server's content-hash dedupe cannot collapse, and the assembler
    would read as two overlapping r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
    [display.cpp, display.h, display_main.cpp, log_names.h, log_sync.cpp, log_sync.h, logging.cpp, logging.h]
2026-09-09 First commit of 3D model files required for dpv-nav
    [2in tube board holder Rev A.STL, ButtonCap.STL, Display Housing.STL, Flow Meter Tube Mount.STL, GoPro Button Sleeve.STL, GoPro Insert Display Mount.STL, GoPro Insert.STL, GoPro Lens Pocket Filler.STL]
2026-09-09 First commit of PCB files for NAV and DISPLAY boards
    [display_board-B_Cu.gbr, display_board-B_Mask.gbr, display_board-B_Paste.gbr, display_board-B_Silkscreen.gbr, display_board-Edge_Cuts.gbr, display_board-F_Cu.gbr, display_board-F_Mask.gbr, display_board-F_Paste.gbr]
2026-09-09 Include GPS fix quality, depth, and water temp in waypoint correction log entries
    [nav_main.cpp]
2026-09-13 Add MID log level and mag die temperature; delay log-file open; WiFi scan + hotspot support
    Five threads from the 2026-09-11 bench work on heading drift, plus the tooling
    that found it.
    Logging
    - New MID level between LOW and HIGH in the diver-facing cycle: LOW's columns
    plus mag_*_cal, pitch/roll and mag_temp_c at 1.5 s. HIGH costs ~850 KiB/hour
    against a 768 KiB partition, so it cannot cover a dive; MID runs ~2.2 hours
    and still carries everything a heading post-mortem needs. Its wire/NVS value
    is 3, appended rather than inserted, because the two boards are flashed
    separately and renumbering HIGH would silently change the meaning of a saved
    setting or an older display build. n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
    [config.h, display.cpp, display_main.cpp, imu.cpp, imu.h, lis3mdl.h, logging.cpp]
2026-09-13 Fit mounted mode through callib instead of a second copy
    calibration-processor/README.md says this script and that service must not
    compute different answers for the same CSV, and mounted mode had just
    broken that: the server now fits the correction from near-level samples
    only, while compute_mounted_correction() here went on fitting the
    procedure's deliberately tilted rings as if they were level.
    Porting the level fit down here would have closed today's gap and
    re-opened the same one tomorrow, so run_mounted() now calls the server's
    callib.fit.fit_mounted() directly. Drift in mounted mode is no longer
    possible rather than merely fixed. load_callib_fit() resolves the sibling
    checkout the wa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
2026-09-13 Add NAV > Current: a 60 s hold that measures the water
    The flow sensor reads speed through the water, not over the ground. That is
    right for navigation and it is why drifting reads zero -- but it also means the
    unit is blind to a current, and a current it cannot see is absorbed silently
    into position. On the 2026-09-12 Harpoon dive that cost 205 m over a deco hang
    with nothing on the screen to say so.
    There is no way to measure a current at depth by difference: no GPS, and usually
    no second known position. But hold station against it and the water still runs
    past the impeller, and that reading is the current itself.
    Menu item runs a 5 s pre-roll then a 60 s hold, writing one pos_src = 'C'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
    [display.cpp, display.h, display_main.cpp, menu.cpp, menu.h, nav_main.cpp]
2026-09-14 Point CLOUD_API_HOST at map.terndiving.com
    divemap.diverdaniel.com stays served by Caddy for units already in the
    field, but new builds (and the OTA manifest/image fetches) use the
    current name.
2026-09-16 Add OTA firmware updates for both boards, driven from tern.local
    Releases are published to the Dive Map server (tools/publish_firmware.sh:
    builds both boards, records size + sha256 in the manifest, uploads images
    before the manifest). Nav checks the manifest once it has internet, and
    tern.local's Firmware card lists every change since the older board's
    version with an Update button. The display hints at an available update
    on its boot status screen.
    An install updates the display first, then nav:
    - display.bin streams HTTPS -> Serial1 using a frozen framed protocol
    (lib/dpvlink/ota_link.h: CRC32 frames, stop-and-wait ACK/NAK, abort
    frame). Nothing is stored on nav. The display checks si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
2026-09-16 Compensate magnetometer offset drift with die temperature
    The LIS3MDL's zero-gauss offset moves with die temperature, and ST
    publish no coefficient for it. Measured on this unit over 2026-09-13/14
    heat tests, the drift is body-fixed: the same at all four cardinals, and
    the same heating as cooling. Left uncorrected it's up to ~2 degrees of
    heading per degree C.
    The correction is applied to the mag vector, not to heading, because
    the heading effect depends on the installed calibration's geometry.
    imu::readMagRaw_SensorFrame() re-reads TEMP_OUT as its own read every
    MAG_TEMP_READ_INTERVAL_MS and subtracts coeff * (T - ref) before the
    axis map and every calibration stage. Nav, logs, cal collect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
    [config.h, imu.cpp, imu.h, lis3mdl.cpp, lis3mdl.h, logging.cpp, logging.h]
2026-09-16 Make Config > WiFi actually switch the radio
    TOGGLE_WIFI used to flip gWifiEnabled only. The menu and status bar
    showed a radio state that wasn't real, and the change took effect a
    reboot later through the NVS restore. Now it calls wifi::stop(), or
    wifi::init() + web::init().
    Turning WiFi on blocks the nav loop inside wifi::init(): about 5 s on a
    good network, up to ~28 s worst case. The display covers that gap by
    showing "WiFi CONNECTING" in the menu row and treating the link as alive
    (menu::isWifiConnecting()), so NO LINK doesn't flash. Turning it on is
    refused in dive mode (red "WiFi unavailable / DIVE MODE"), where the
    radio can't reach anything and the attempt would only freeze heading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
    [display_main.cpp, menu.cpp, menu.h, nav_main.cpp]
2026-09-16 Raise auto dive-mode depth thresholds to 1.3 m / 0.6 m
    DEPTH_DIVE_TRIGGER_M 0.3 -> 1.3 m (~4 ft) and DEPTH_SURFACE_REVERT_M
    0.15 -> 0.6 m (~2 ft). The 30 s surface-revert dwell is unchanged.
    [config.h]
2026-09-16 Add assembly guide outline; README safety-note edit
2026-09-16 Compile the menu in; stop reading /menu.json from the display FS
    The display loaded /menu.json from LittleFS whenever it existed, and only
    used the firmware menu as a fallback. OTA and firmware flashes never touch
    the filesystem, so a file left by an old uploadfs silently hid every menu
    item added since -- NAV > Current was missing on a unit running firmware
    that had it.
    The override never bought anything: the display has no network, so the
    file still needed USB, and its action IDs are firmware enum values anyway.
    buildMenu() is now the only menu, the display deletes any leftover
    /menu.json at boot, and data/menu.json is gone. Docs updated to match,
    including cloud-calibration-plan.md's cla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
    [menu.cpp, menu.h]
2026-09-16 Current hold: save always, finish early, fix link overflow; 0.7.6
    NAV > Current's first real use found three problems.
    Link: nav serialized NavPacket into a 256-byte buffer. A normal packet
    with the depth sensor fitted is ~251 bytes; a current hold is ~303 and a
    running speed cal ~319. navPacketToBytes() returned 0 and nothing was
    sent, so the display froze and went NO LINK with no log line on either
    board. linkBuf is now 512 and an oversize packet logs an error.
    Saving: a hold is appended to /currents.csv on the nav FS whether or not
    logging is on (the 'C' log row is still written when it is). Rotates to
    /currents.old.csv at 64 KiB.
    Finish early: BTN1 mid-hold now sends FINISH_CURRENT_HO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
    [display.cpp, display.h, display_main.cpp, logging.cpp, logging.h, nav_main.cpp, version.h]
2026-09-18 Gap-fill: make the target cell steerable, and fix two frame/definition bugs
    Bench feedback on CAL > Fill gaps was that the highlighted cell jumped
    unpredictably and the only thing that worked was waving the unit around
    until sectors happened to fill. The orientation math was not at fault --
    simulated over the full sphere, reported heading equals commanded yaw to
    ~1e-14 and is exactly invariant to roll. Four separate problems:
    Steering feedback. CalProgressPacket is 319 bytes and so is capped at
    2 Hz, but a diver aiming at a cell is running a closed hand-eye loop, and
    each frame is one unfiltered instantaneous sample -- while the unit moves
    the highlight lands somewhere effectively random in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
    [display.cpp, display_main.cpp, imu.cpp, imu.h, nav_main.cpp]
2026-09-18 Actually power down the display on OFF; fix TFT_RST pin
    "OFF" put the ESP32 into deep sleep at ~10 uA and left the backlight
    drawing ~25 mA, so the backlight was essentially the entire power-off
    budget -- a unit sitting "off" in a gear bag flattened a 3000 mAh pack
    in under a week. The panel was blanked, which is why this read as
    "screen off but still glowing".
    The EyeSPI "Lite" (backlight enable) pad was never routed. It is now
    jumpered to A5/GPIO4, chosen because it is RTC-capable, LEDC-capable
    for future PWM dimming, and not a strapping pin.
    display::sleepForPowerOff() takes the ST7789 to DISPOFF + sleep-in and
    drives the backlight low, latching it with rtc_gpio_hold_en(). The latch
    mat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
    [board_pins.h, display.cpp, display.h, display_main.cpp]
2026-09-18 Fix cal uploads stalling at "http -3": free the sample buffer first
    A raw cal CSV upload would stream about four segments and then wedge until
    HTTPClient gave up with -3, while every small upload on the same link
    succeeded. A server-side packet capture showed the server ACKing everything
    within ~25 ms and the device retransmitting on RTO backoff anyway, so the
    ACKs were not getting back in.
    The cause is heap. magBinCalEnd() was the only thing that freed the 69,120
    byte sample buffer, and it ran *after* the cloud upload, so every upload ran
    with that buffer resident. The WiFi driver allocates its RX buffers from the
    same heap and silently drops inbound frames when it cannot get one. Split
    ma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
    [cloud_client.cpp, cloud_client.h, config.h, imu.cpp, imu.h, nav_main.cpp, version.h, web_server.cpp]
2026-09-18 Correct the battery gauge range for a single-cell LiPo
    BATT_MV_FULL was 4500 and BATT_MV_EMPTY 3300, which is neither the cell's
    real full charge nor its real cutoff: a full pack at 4.2 V read as ~75%, and
    the gauge hit 0% with usable charge left. Use 4200/3200.
    [config.h]
2026-09-18 Track tools/release-notes.md
    publish_firmware.sh takes this file as its second argument and turns every
    "- " line into an OTA release-note bullet. It was scratch until now; keeping
    it in the repo means the notes a build shipped with are recoverable from
    history. It gets rewritten every release, which is the point.
    Currently holds the 0.7.18 notes.
2026-09-18 Retire three stale claims in the baseline two-pass cal doc
    The doc still read as an unshipped design. All three of these were true when
    written and are not now:
    - "Not yet verified on hardware" -- the two-pass flow has been the normal
    baseline path on real hardware since August; the 2026-09-18 reference run
    scored 1.2% baseline and under 1 degree on-unit.
    - "Roll coverage is still not tracked anywhere" -- roll is now a tracked third
    coverage axis (roll sectors, the 4-triangle widget, binRollSatisfied() as the
    single finished-cell predicate, server-side coverage sync). What remains open
    is steering, not tracking: heading gain is tan(pitch), so cells beyond 60
    degrees of pitch are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
2026-09-21 Continuing to improve the assembly guide
2026-09-21 Utility to pull raw data from FS via USB, in event that wireless is down
2026-09-26 Ignore all CSVs under tools/ except the frame fixture; ignore *.bz2
2026-09-28 Consolidate display_board/nav_board KiCad files to latest local work
    This machine has the most recent hardware design work. Promote the
    Rev B design to canonical display_board.kicad_pro/.kicad_sch/.kicad_pcb,
    move its matching gerbers/drill files into manufacturing/, track the
    gopro-housing variant as a maintained alternate board, and drop the
    superseded Rev A files, stale fabrication/ output, and backup zips
    (archived locally under a gitignored _archive/ folder rather than
    deleted outright). Also brings nav_board's schematic/PCB/manufacturing
    files up to date.
    [display_board-B_Cu.gbr, display_board-B_Mask.gbr, display_board-B_Paste.gbr, display_board-B_Silkscreen.gbr, display_board-Edge_Cuts.gbr, display_board-F_Cu.gbr, display_board-F_Mask.gbr, display_board-F_Paste.gbr]
2026-09-30 OTA: SemVer pre-release tags mark internal/test builds
    A version like 0.8.0-dev.1 is a test build. It goes into the same
    manifest, but a unit only offers it when "Offer test builds" is ticked
    on tern.local (persisted in NVS as ota/prerelease), or when it already
    runs a test build. Versions compare by SemVer precedence, so the public
    0.8.0 outranks 0.8.0-dev.N and moves test units back onto it.
    Firmware 0.7.18 and older can't parse the suffix and skips those
    manifest entries, so units in the field never see test builds. The
    whole string is capped at 15 chars to fit the char[16] version buffers.
    publish_firmware.sh accepts the suffix and sorts the manifest by SemVer.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
    [ota.cpp, ota.h, version.h, web_server.cpp]
2026-09-30 Nav > Datum: set, navigate to, and retro-place a search datum
    Adds SET_DATUM, NAV_TO_DATUM and DATUM_WAS display commands. The datum
    is stored apart from the target (persisted in NVS). "Datum was..."
    shifts the in-dive frame so the datum sits at a chosen waypoint, and
    logs only aux 'M' rows. The MARK-row logger is factored out for reuse.
    Backlog gets the follow-ups (datum range on the nav screen, search
    patterns).
2026-09-30 Hardware docs: BOM update, digikey library .gitmodules, assembly guide notes
    Assembly guide gains printed-part, potting and leak-test notes; link pin
    comments name the board silkscreen labels.
    [Tern DPV-Nav BOM.ods]
2026-09-30 Datum > Set here also targets the datum; declination backlog item
    Setting the datum now makes it the navigation target in the same step, so
    the at-depth workflow is one menu trip: mark the line, then read range and
    bearing back to it while working reciprocals in your head. Fewer presses at
    depth is the design principle; menu time costs situational awareness.
    Also: backlog item for looking up magnetic declination from lat/lon instead
    of the compile-time constant, and the config.h comment corrected to Lake
    Washington (value unchanged, positive = East).
    [config.h, menu.cpp, menu.h, nav_main.cpp, nav_model.h]
2026-10-02 Rolling-log cleanup: prefer deleting non-dive logs over dive logs
    When space is tight, cleanupOldLogs() used to delete strictly oldest-first.
    Now it deletes GPS-only tracks with no recorded depth first, regardless of
    age, and only falls back to oldest-dive-log-first once those are exhausted.
    Bump to 0.7.19 and update release notes.
    [logging.cpp, logging.h, version.h]
2026-10-09 Add GPS carrier board KiCad project and display board Rev B PCB
    New QT Py ESP32-S2 + Adafruit Ultimate GPS carrier board design
    (schematic, PCB, footprints, BOM, assembly/placement previews) and
    the Rev B GoPro-housing PCB for the display board.
2026-10-09 Add MARKED ack and running avg error to heading Fourier cal prompt
    BTN2 gave no visible feedback until the next 4 Hz render tick happened
    to redraw the incremented step. Pressing it now shows an immediate
    MARKED screen (held ~450ms) with this point's error and the running
    average before advancing, same gap gBaselineFinishPending already
    closes for baseline cal. The live prompt screen also only redraws the
    HDG number and avg-error line when their rounded value actually
    changes, instead of a full fillScreen() every tick.
2026-10-11 Bench mounted cal: remove --legacy-fit, follow callib's still-level fit
    callib's mounted fit now uses only still, near-level samples and refuses a
    collection that cannot supply them. The bench script prints that breakdown
    and no longer carries its own all-samples fit.
    Calibration guide and backlog updated for the same change.
2026-10-11 Heading cal prompt: label the rows, fix degree and plus-minus glyphs
    The big TGT/HDG numbers looked shifted one digit left because their
    fourth character, meant to be a degree sign, rendered as a checkerboard
    block. The GFX classic font is CP437 and, with cp437() left off, bumps
    every code >= 176 by one, so the Latin-1 bytes 0xB0 (degree) and 0xB1
    (plus-minus) land on shade blocks. Use 0xF7 and 0xF0 instead, on every
    screen that prints them: heading cal prompt and MARKED ack, cloud cal
    result, gap-fill grid readout and the Fit line.
    Re-lay out the heading cal prompt while here:
    - TGT / HDG labels sit left of their numbers at size 3 instead of
    size 1 above them, with the numbers moved righ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
2026-10-11 Mounted cal dwell capture, binary diagnostic logs, idle-gated logging (0.7.21)
    Mounted calibration:
    - A cell now fills from one dwell: the unit must sit still inside the row's
    attitude window for 400 ms, then 18 samples are recorded. Sweeping through a
    cell records nothing. Logic in src/util/mounted_dwell, host-tested.
    - New mounted screen: attitude indicator (error from the row's target, 2x),
    motion bar that names its cause, hold bar, count out of the 24 cells needed.
    - Completion is the whole level row plus six spread cells per tilted row.
    - Cal CSV rows gain trailing mag_temp_c, tcomp and dwell columns; heading
    samples gain the first two. Sample buffer shrinks from 69 KB to 47.5 K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
2026-10-11 Add GPS fix indicator firmware for the gps_carrier board
2026-10-13 board_pins.h: fix Feather V2 pin mapping, split V1/V2 selection per device
    GPS UART, the display's inter-device link pins, SPI MOSI/MISO, and
    TFT_RST were hardcoded to Feather V1 GPIOs. GPIO16/17 (GPS RX/TX on V1)
    don't exist on V2 at all -- likely claimed internally by the V2
    module's PSRAM -- so wiring GPS there on a V2 nav board would risk
    contention, not just a bad pinout. NAV_FEATHER_V1/DISPLAY_FEATHER_V1
    replace the single FEATHER_V1 switch so nav and display can be on
    different board revisions independently. TFT_RST=22 for V2 confirmed
    against the physical display board's wiring.
2026-10-16 Heading cal result: one number, graded, with full-screen accept/reject
    The result screen showed two different "max errors". The headline was the
    server's RMS, because for hdg rms_pct holds the RMS, and the nav board
    forwarded it labelled "max err". The recommendation text below it quoted
    the real max.
    The nav board now forwards the backend's new max_err_deg instead. Since
    the same backend change, that is the leave-one-out worst case: the error
    to expect at a heading the fit didn't see, graded GOOD < 5, OK 5-8,
    POOR >= 8 degrees. The packet format is unchanged. An older backend that
    doesn't send the field shows "--".
    showHdgCalResult() gives hdg its own layout. One big number in the band
    co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
2026-10-20 Heading cal: level gate on BTN2, attitude recorded per point
    The Fourier heading correction is a function of heading only, so it
    can't tell an attitude change from a heading error. A point marked
    tilted is fitted as heading error at that heading. Nothing checked
    attitude.
    BTN2 now marks only once the unit is level within HDG_CAL_LEVEL_TOL_DEG
    (3 deg, pitch and roll, accel-only) and has been still for
    HDG_CAL_LEVEL_SETTLE_MS (1.5 s, which also lets the AHRS heading settle
    after the turn). util/level_gate.h runs on the nav board. Its state,
    hold % and pitch/roll ride in NavPacket only while a heading cal is
    collecting. The prompt gains the mounted cal's horizon (6x gain), a
    status line (NOT L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
2026-10-20 Nav-board status LED: GPS-fix-logged indicator, heartbeat at depth (0.7.22)
    The nav board's onboard NeoPixel answers one question before descent: is
    a good GPS fix in the log yet? Highest priority first: halted (fast
    magenta), heartbeat in dive mode or with GPS usage off, GPS fault (no
    NMEA), searching, poor, rejected by the confidence gate, accepted (green
    blink), and logged (solid green, once an accepted 'G' row is in the
    current file). The colours follow the GPS-housing indicator so one legend
    covers both. util/status_led.h is pure state logic, host-tested by
    tools/statusled_test/.
    The same change narrows the log's 'G' tag to gate-accepted fixes, so the
    LED can never call a fix good that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
2026-10-29 Upload binary MID/HIGH logs to Dive Map like CSV ones
    log_names::isLog() accepts both .csv and .bin, and log_sync, the tern.local
    upload button and the file listing's "uploaded" flag all use it. Dive Map's
    track processor decodes the binary records itself, which is how a MID dive's
    magnetometer data reaches the server. Dive Map must deploy before firmware
    that uploads .bin files.
2026-10-29 Flatten the menu, hide land-only items in dive mode, BTN2 = Mark at depth
    The at-depth actions (Select WP, Arrive WP, Mark, Current, Log) now sit on
    the root instead of behind Nav, saving a press each. Items carry a
    surfaceOnly flag driven by FLAG2_DIVE_MODE: Cal, OFF, and Setup's GPS /
    WiFi / Water / Link acct are hidden in dive mode rather than refused.
    Setup stays visible at depth for Op Mode alone, so a board without a depth
    sensor can always get back to SURF. If dive mode flips with the menu open,
    ensureVisible() moves the diver off anything that vanished; a resume point
    inside a hidden submenu is dropped.
    With the menu closed in dive mode, BTN2 alone is Mark (never when BTN1 is
    part o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
2026-10-29 Reset baseline motor_cal heading offset to 0
    The -3 deg motor-on offset is likely spurious (2026-10-24 dive: crab, not
    tilt), so the saved baseline no longer carries it.
2026-11-01 User guide: reorganize around calibration, dive routine, reference
    Calibration comes first, in install order (baseline, gap fill, mounted,
    heading, speed), followed by a start-to-finish dive routine (night before,
    beach, descent, during, surfacing) and then the menu/screen/config
    reference.
    Gap fill and mounted cal get their own sections describing the screens:
    the gap-fill target colors and roll-coverage box, and the mounted cal's
    artificial horizon, MOTION/HOLD bars and instruction messages. Screenshot
    placeholders for both.
    Also fixes the config table's depth trigger values (1.3 m / 0.6 m, per
    config.h) and adds the diver's baseline collection technique and
    track-correction notes.
    Co-A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
2026-11-03 Nav board: XT30 battery input, power switch, peripherals on 3V3
    Add an XT30 battery connector (more robust than the Feather's built-in
    JST-PH) and a power switch. Peripherals are now fed from the Feather's
    3V3 pin instead of directly from the battery; raw battery power goes
    only to the nav ESP32 and the display power output, which drives the
    display ESP32.
2026-11-03 BOM: XT30 battery connector pair and power switch placeholder
    Add the board-mount XT30U-F (J6), an XT30U male pigtail for the battery
    side, and a TBD power switch row for J7, matching the nav board power
    rework. The battery note now says to swap its JST-PH plug for the XT30
    pigtail. Also includes a relabel of the depth sensor options block.
2026-11-06 Docs: baseline two-pass was retired, not shipped; backlog the live grid
    baseline-cal-two-pass.md's Status, its first Risks bullet, and the backlog's
    Settled entry all said the two-pass flow was shipped and in routine use. The
    code says otherwise: baseline never leaves ROUGH_SCAN, BTN2 sends
    FINISH_BASELINE_COLLECTION, and the live grid lives in gap-fill. The
    2026-09-18 reference run used that flow.
    Adds a Tier 3 item for a live baseline grid. A 2026-11-05 replay of five
    real uploads found an in-session sphere fit locks at 50-75 samples, with
    85-90% of samples in the server's exact cell. The min/max bias the old
    handoff used was 15-25 uT off for most of a tumble. Marks the two
    rough-scan ite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
2026-11-06 Plan: live coverage grid during the baseline tumble
    An in-session sphere fit gives a bias to bin with, and gap-fill's
    per-sample binning and grid widget do the rest. Covers the lock gate
    and why the radius check is the one that matters, self-heal re-binning,
    the acceptance ceiling to tune before hardware, per-sample dev_bin/dev_roll
    CSV columns so a session scores itself against the server, the file-by-file
    changes, the implementation order, and the 2026-11-07 hardware test.
2026-11-06 Baseline live grid: in-session bootstrap module and host test
    src/util/baseline_boot.{h,cpp} is the pure-C++ core. It refits a
    hard-iron sphere over every stored sample every 25, locks when the fit
    passes the gate, then bins samples through mag_orient against the locked
    bias with a per-(cell, roll) ceiling. A post-lock bias move past 3 uT
    re-bins everything. Lock gate: N >= 50, radius within 10% of
    MAG_CAL_EXPECTED_FIELD_UT, direction spread >= 0.004, and bias stable
    to 2 uT.
    The spread gate was added after the host test caught a hole in the plan:
    a spin about a horizontal axis (rolling the tube while pointed north)
    makes a ring 0.92x the field. That passes the radius gate and locks
    ~20 uT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
2026-11-06 Baseline live grid (0.7.25-dev.1)
    Baseline now shows gap-fill's grid and roll widget a few seconds into
    the tumble. ROUGH_SCAN stores samples as before while baseline_boot
    refits a sphere every 25. Once the fit locks, baseline moves to the
    new BASELINE_GRID sub-phase. Each sample is binned through
    mag_orient::orientSample against the in-session bias, a (cell, roll)
    stops accepting at 2x gap-fill's finished threshold, and a 3 uT bias
    move re-bins everything. Upload and server grading are unchanged; BTN2
    still finishes.
    - imu.cpp: baselineTick() owns both baseline sub-phases. The live cell
    is classified from the stored, quantised accel, so a re-bin can't
    disagree with it. Counts are synce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
2026-11-07 0.7.25: baseline live grid verified on hardware
    The 2026-11-07 hardware test passed on 0.7.25-dev.1. The OTA installed
    cleanly, and baseline went from bars and "Finding north..." to the grid.
    Baseline plus gap-fill gave a really good baseline, mounted ran cleanly,
    and the 12-point heading cal finished within 1-2 deg at every point.
    Bumps FW_VERSION to 0.7.25. Removes the backlog item and the two
    rough-scan items it made moot (the bars are now only the seconds before
    lock), and records the outcome under Settled. The per-sample agreement
    check on the uploaded CSV wasn't run; the plan's Status says so.
2026-11-07 Baseline live grid: record the hardware agreement check
    On the 2026-11-07 baseline upload, the replay reproduces the unit's
    recorded cell on all 2160 rows (lock at 75, re-bins at 125 and 225).
    The diver saw the server's exact cell for 88% of samples and the
    adjacent one for 12%, none further. Gap-fill's recorded cells match the
    server's 99.8%. The session filled the sample buffer.
    Also records what the data does not show: at equal sample counts the
    session's gaps match the blind runs'. The final drop to 86 thin/empty
    cells came from collecting longer. One session, so re-check over more.
2026-11-09 Nav board Rev D: charging connector J5, re-route, fab outputs
    Adds J5 (1x02 2.54 mm header) for charging, re-routes the PCB, and
    regenerates the gerbers/drill files for the Rev D order. BOM updated
    to match.
2026-11-09 Depth mode: enter dive at 3 m, revert below 2 m for 15 s
    The old 1.3 m trigger kept dropping into dive mode during the surface
    swim (sensor rides 0.3-1.5 m in the wave-wash; 2026-11-08 log peaked
    at 1.48 m), then needed <0.6 m for 30 s to get GPS back. Enter at 3 m
    immediately; revert below 2 m for 15 s, so a 3-5 m safety stop stays
    in dive mode and the 1 m gap prevents flapping.
    OTA's "unit is underwater" gate keeps 0.6 m via a new
    DEPTH_OTA_UNDERWATER_M instead of borrowing the surface-revert depth.
    User guide updated to match.
2026-11-09 Cal screens: unified-flow plan and pixel mockups
    Plan for one calibration frame across Baseline (1), Fill gaps (1a),
    Mounted (2) and Heading (3): step strip header with a counter, one
    status line, two softkeys, hold BTN1 2 s to quit or reject. Includes
    mounted FINISH + 36-cell auto-finish, gap-fill map download right
    after a baseline accept, numbered Cal menu labels, and the bugs it
    fixes (mounted cal not claiming the buttons, size-1 accept/reject,
    gap-fill refusal shown as upload failed). Not implemented yet.
    tools/cal_screen_mock/ redraws the screens in JS with the GFX font
    (render.js writes png/ and the review page); the PNGs are meant for
    the user-guide walkthrough. Backlog: mounted til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
2026-11-09 Cal screens step 1: shared constants, 36-cell mounted, softkey gesture
    - config.h: MAG_CAL_BIN_MAX_SAMPLES (was imu.cpp's private
    BIN_CAL_MAX_SAMPLES) and LONG_PRESS_MS (was display_main's), since
    the display header counter and util/cal_keys.h need them.
    - MAG_CAL_SECTORS_MID 6 -> 12: mounted fills every cell until the
    tilted-row analysis says otherwise. The dwell tests are rewritten in
    terms of the constant and pass at 6, 8, 10 and 12.
    - util/cal_keys.h: hold BTN1 to discard, BTN2 to advance, and any press
    made with both buttons down does nothing, so the two-button reinit
    can't finish a cal on the way. Host test in tools/cal_keys_test/.
    - Plan doc: RESPONDED becomes its own pack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
2026-11-09 Cal screens step 2: nav QUIT_CAL and mounted FINISH
    - DisplayCmd::QUIT_CAL (47): ends a bin cal (endBinCal(), no CSV dump,
    no upload) or a heading cal (RAM samples dropped). endBinCal() is the
    completion block's tail, now shared, so a quit baseline reloads the
    installed cal instead of leaving heading on the identity cal.
    - FINISH_BASELINE_COLLECTION now finishes mounted too (cal_mode 6), once
    one cell is filled; magBinCalIsComplete() honours it. The user-done
    flag is g_userDone, no longer baseline-only.
    Nothing on the display sends QUIT or a mounted FINISH yet (steps 3-4).
2026-11-09 Cal screens step 3: the frame, the endings, hold-to-REJECT
    display.cpp gets the unified cal frame: a header with the 1/1a/2/3 step
    strip and a counter, a work area claimed by signature, one status line,
    and two softkeys (blank/dim/normal/go/hold, the hold filling red column
    by column). Each band caches what it last drew, so a screen can call it
    every render and nothing repaints unless it changed; the endings used to
    fillScreen() at 4 Hz.
    Moved into the frame: Uploading, No WiFi, Failed (now TRANSPORT /
    REJECTED / REFUSED, so a gap-fill refusal reads "Can't start" instead of
    "Upload failed"), the result (heading's own layout folded in, no server
    recommendation text, GOOD/OK/POOR), gap-fill's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
2026-11-09 Cal screens step 4: collecting screens in the frame, QUIT and FINISH
    All four steps' collecting screens move into the cal frame:
    - 1 Baseline: bars (samples/2160 counter, "Tumble the unit randomly"),
    then the 5 x 12 grid with 24 px rows, 1 px gutters and a 2 px current
    cell; "Auto-finish at 2160" over the last 10%.
    - 1a Fill gaps: the same grid; counter is targets finished, readout
    "N cells left".
    - 2 Mounted: 3 x 12 grid with 20 px rows and every empty cell red, the
    horizon at 80 px, the motion cause inside its bar; counter of 36.
    - 3 Heading: TARGET big, INDICATED HDG smaller and gray under "Align to
    external compass", the level gate's verdict in the status line and a
    MARK key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
2026-11-09 Cal screens step 6a: menu labels match the step strip
    Cal menu reads "Baseline (1)", "Fill gaps (1a)", "Mounted (2)",
    "Heading (3)", then "Speed cal". MENU_LABEL_LEN 12 -> 14 for "Fill gaps
    (1a)"; the size-3 item row holds 16. The grid readout gets fixed widths
    so the orientation text can't blank the roll widget.
2026-11-09 Cal screen mock: match the build (readout x, Finishing, Installed mounted, Can't start, Not installed)
2026-11-09 Cal screens step 6b: docs, plan status, 0.7.26-dev.1
    - user-guide.md and calibration-guide.md: the new menu labels, the frame
    and its two keys (BTN2 keeps going, hold BTN1 to quit/reject), the
    counters, 36-cell Mounted with FINISH, TARGET vs INDICATED HDG, and
    the gap-fill map arriving with the baseline accept (Check for updates
    only when it didn't).
    - CLAUDE.md: calibration system, heading result, menu tree, invariant 4,
    DisplayCmd next free 48, key display functions, cal_keys test.
    - backlog.md: OFFLINE item half done; tilted-row item and walkthrough
    updated.
    - Plan: built, where the build differs, bench test owed.
    - version.h 0.7.26-dev.1 for an OTA test build.
    Co-Authored-By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
2026-11-09 Docs: reorganize for a stranger opening the repo cold
    The README had grown into a manual: project framing, WiFi provisioning, cloud
    pairing, the full calibration walkthrough and the dive routine all in one file,
    while docs/ held a 36-line overview stub and a 552-line assembly skeleton nobody
    could build from. A stranger had no entry point and no way to tell what was
    written from what was merely outlined.
    Four reader-facing volumes now, in the order someone actually uses them, indexed
    by docs/README.md:
    0. overview.md what it is, how DR works, the honest accuracy
    number, the four modules and why it's split
    1. manufacturing-guide.md variant choic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
2026-11-10 Docs: split the calibration guide into diver and engineering halves
    calibration-guide.md had grown into two documents sharing a file: the
    procedure a diver follows, and the reference an engineer needs. They have
    different readers, and the diver-facing half was buried.
    - docs/user-calibration-guide.md (new): why each step exists, the order and
    what invalidates what, the per-step procedure and screens, and what a good
    result looks like.
    - docs/dev-calibration-guide.md: file formats, boot sequence, gate constants,
    fitting tools, serial diagnostics, the k derivation, decision records.
    - user-guide.md keeps boot, display, buttons and the dive workflow, and points
    at the calibration guide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
2026-11-10 Depth sensor: count failed MS5837 reads, pace conversions at 2 Hz
    Two independent defects in the Bar30 driver, found while working out why
    water_temp_c read a flat 14.2 C through a 35 m descent on 2026-11-08 (it
    was neither of these -- see docs/backlog.md Tier 2 -- but both are real).
    readAdc24()'s return value was ignored in both WAIT_D1 and WAIT_D2. A read
    that fails leaves `out` untouched, so the driver recompensated the previous
    raw values and set gNewSample as if they were a fresh sample. There was no
    error counter and nothing on tern.local, which makes a sensor that has
    quietly stopped answering indistinguishable from a working one: it reads out
    as plausible frozen depth and temperatu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
